McuMirror/CERES/Administratif/GPC New 2[1].docx

MDI

Systems GPC NEW 15/09/13

Fonctions complémentaires à celles de la GPC200

- Paramétrage cartes machines: modalitées à préciser.
- Historique utilisation machines:

. N° /date / heure /mn

. Paiement: billets / pièces avec valeurs et pièces rendues

. Durée stockage : 31 jours ou nombre d’opérations

. voir sortie sur clé USB

- Monnayeur MDB :

. Paramétrage nombre de tubes max 7/8

. paramétrage de la valeur du tube

. réglage niveaux Haut / Bas de chaque tube

. voir alarme si niveaux tubes trop bas

- Lecteur de billets : Gogès, Smiley ou autre en MDB

. voir possibilité de limiter son utilisation : pour simplifier, autorisé ou non suivant machine, par l’exploitant. Au départ toute machine accepte par défaut de précision.

- Lecteur de cartes bancaires. Voir avec Symotronic Ingénico par exemple

. utilisation à réfléchir, peut être comme billets,

- Promotion : voir possibilité de 2 plages par jour affectables par machine Jour/Heure/ mn.
- Cartes privatives : badges de proximité voir avec Symotronic pour ne pas faire double développement avec le matériel existant.
- Langues : prévoir 3 langues simultanées avec choix de la langue désirée par le client
- Possibilité de paiement gratuit par l’exploitant : code, carte…
- Liaison Internet :

. pour l’exploitant, clavier virtuel et affichage identique à la centrale, voir quelques petits plus.

. réception des alarmes évoquée : tubes..

. possibilité de mettre Hors Service une machine.

. possibilité de rendre gratuite une machine pour régler un problème éventuel sur site d’un client.

Ensemble des fonctions existantes dans la notice GPC200 toujours vraies : stockage, cumuls...

Comment prévoit-on sans carte : l’entrée en paramétrage, la lecture des différents cumuls..

Peut être pour ne pas avoir un paramétrage de base trop difficile envisager des niveaux : le basic durée, prix…. Et ensuite CB, Promo…
