McuMirror/CERES/Docs/latex/union____attribute____.tex

\hypertarget{union____attribute____}{}\section{\+\_\+\+\_\+attribute\+\_\+\+\_\+ Union Reference}
\label{union____attribute____}\index{\+\_\+\+\_\+attribute\+\_\+\+\_\+@{\+\_\+\+\_\+attribute\+\_\+\+\_\+}}
\subsection*{Public Member Functions}
\begin{DoxyCompactItemize}
\item 
struct \hyperlink{union____attribute_____a8f8d4ac67446d3661ab1327f89a92c94}{\+\_\+\+\_\+attribute\+\_\+\+\_\+} ((packed))
\end{DoxyCompactItemize}
\subsection*{Public Attributes}
\begin{DoxyCompactItemize}
\item 
\hypertarget{union____attribute_____a7d1a9d5019bf07a82e967a72a4434870}{}B\+Y\+T\+E {\bfseries by\+Buffer\+Operation} \mbox{[}32\mbox{]}\label{union____attribute_____a7d1a9d5019bf07a82e967a72a4434870}

\end{DoxyCompactItemize}

\subsection{Constructor \& Destructor Documentation}
\hypertarget{union____attribute_____a8f8d4ac67446d3661ab1327f89a92c94}{}\index{\+\_\+\+\_\+attribute\+\_\+\+\_\+@{\+\_\+\+\_\+attribute\+\_\+\+\_\+}!\+\_\+\+\_\+attribute\+\_\+\+\_\+@{\+\_\+\+\_\+attribute\+\_\+\+\_\+}}
\index{\+\_\+\+\_\+attribute\+\_\+\+\_\+@{\+\_\+\+\_\+attribute\+\_\+\+\_\+}!\+\_\+\+\_\+attribute\+\_\+\+\_\+@{\+\_\+\+\_\+attribute\+\_\+\+\_\+}}
\subsubsection[{\+\_\+\+\_\+attribute\+\_\+\+\_\+}]{\setlength{\rightskip}{0pt plus 5cm}struct \+\_\+\+\_\+attribute\+\_\+\+\_\+\+::\+\_\+\+\_\+attribute\+\_\+\+\_\+ (
\begin{DoxyParamCaption}
\item[{(packed)}]{}
\end{DoxyParamCaption}
)\hspace{0.3cm}{\ttfamily [inline]}}\label{union____attribute_____a8f8d4ac67446d3661ab1327f89a92c94}
$<$ Date de l\textquotesingle{}opération.

$<$ Heure de l\textquotesingle{}opération.

$<$ Montant de l\textquotesingle{}opération.

$<$ Type d\textquotesingle{}opération effectuée.

$<$ Résultat de l\textquotesingle{}opération.

$<$ Numéro de la machine le cas échéant.

$<$ Numéro de clé le cas échéant. 

The documentation for this union was generated from the following file\+:\begin{DoxyCompactItemize}
\item 
D\+:/\+Projets/\+C\+E\+R\+E\+S/\+S\+W/\+Main\+Board.\+X/parametres.\+h\end{DoxyCompactItemize}
