McuMirror/CERES/Docs/latex/union_a_u_d_i_t_d_a_t_a.tex

\hypertarget{union_a_u_d_i_t_d_a_t_a}{}\section{A\+U\+D\+I\+T\+D\+A\+T\+A Union Reference}
\label{union_a_u_d_i_t_d_a_t_a}\index{A\+U\+D\+I\+T\+D\+A\+T\+A@{A\+U\+D\+I\+T\+D\+A\+T\+A}}
\subsection*{Public Attributes}
\begin{DoxyCompactItemize}
\item 
\hypertarget{union_a_u_d_i_t_d_a_t_a_ab5ab25661d435cecd5e3a6e7414f93d1}{}s\+A\+U\+D\+I\+T\+D\+A\+T\+A {\bfseries data}\label{union_a_u_d_i_t_d_a_t_a_ab5ab25661d435cecd5e3a6e7414f93d1}

\item 
\hypertarget{union_a_u_d_i_t_d_a_t_a_a126a5fb5ddaa78b34c80a7d303919d82}{}B\+Y\+T\+E {\bfseries by\+Audit\+Data} \mbox{[}256\mbox{]}\label{union_a_u_d_i_t_d_a_t_a_a126a5fb5ddaa78b34c80a7d303919d82}

\end{DoxyCompactItemize}

The documentation for this union was generated from the following file\+:\begin{DoxyCompactItemize}
\item 
D\+:/\+Projets/\+C\+E\+R\+E\+S/\+S\+W/\+Main\+Board.\+X/parametres.\+h\end{DoxyCompactItemize}
