McuMirror/CERES/Docs/latex/union_s_m_a_c_h_i_n_e___c_o_n_f_i_g.tex

\hypertarget{union_s_m_a_c_h_i_n_e___c_o_n_f_i_g}{}\section{S\+M\+A\+C\+H\+I\+N\+E\+\_\+\+C\+O\+N\+F\+I\+G Union Reference}
\label{union_s_m_a_c_h_i_n_e___c_o_n_f_i_g}\index{S\+M\+A\+C\+H\+I\+N\+E\+\_\+\+C\+O\+N\+F\+I\+G@{S\+M\+A\+C\+H\+I\+N\+E\+\_\+\+C\+O\+N\+F\+I\+G}}

Structure contenant les paramètres à sauvegarder d\textquotesingle{}une machine.  

{\ttfamily \#include $<$parametres.\+h$>$}

\subsection*{Public Member Functions}
\begin{DoxyCompactItemize}
\item 
struct \hyperlink{union_s_m_a_c_h_i_n_e___c_o_n_f_i_g_a06ac0ca171ccde05f310fd6395bec0f1}{\+\_\+\+\_\+attribute\+\_\+\+\_\+} ((packed))
\end{DoxyCompactItemize}
\subsection*{Public Attributes}
\begin{DoxyCompactItemize}
\item 
\hypertarget{union_s_m_a_c_h_i_n_e___c_o_n_f_i_g_afcd3ebaa7aa3bf1a27064988e553c16c}{}B\+Y\+T\+E {\bfseries s\+Machine\+\_\+config\+\_\+buffer} \mbox{[}64\mbox{]}\label{union_s_m_a_c_h_i_n_e___c_o_n_f_i_g_afcd3ebaa7aa3bf1a27064988e553c16c}

\end{DoxyCompactItemize}

\subsection{Detailed Description}
Structure contenant les paramètres à sauvegarder d\textquotesingle{}une machine. 

\subsection{Member Function Documentation}
\hypertarget{union_s_m_a_c_h_i_n_e___c_o_n_f_i_g_a06ac0ca171ccde05f310fd6395bec0f1}{}\index{S\+M\+A\+C\+H\+I\+N\+E\+\_\+\+C\+O\+N\+F\+I\+G@{S\+M\+A\+C\+H\+I\+N\+E\+\_\+\+C\+O\+N\+F\+I\+G}!\+\_\+\+\_\+attribute\+\_\+\+\_\+@{\+\_\+\+\_\+attribute\+\_\+\+\_\+}}
\index{\+\_\+\+\_\+attribute\+\_\+\+\_\+@{\+\_\+\+\_\+attribute\+\_\+\+\_\+}!S\+M\+A\+C\+H\+I\+N\+E\+\_\+\+C\+O\+N\+F\+I\+G@{S\+M\+A\+C\+H\+I\+N\+E\+\_\+\+C\+O\+N\+F\+I\+G}}
\subsubsection[{\+\_\+\+\_\+attribute\+\_\+\+\_\+}]{\setlength{\rightskip}{0pt plus 5cm}struct S\+M\+A\+C\+H\+I\+N\+E\+\_\+\+C\+O\+N\+F\+I\+G\+::\+\_\+\+\_\+attribute\+\_\+\+\_\+ (
\begin{DoxyParamCaption}
\item[{(packed)}]{}
\end{DoxyParamCaption}
)\hspace{0.3cm}{\ttfamily [inline]}}\label{union_s_m_a_c_h_i_n_e___c_o_n_f_i_g_a06ac0ca171ccde05f310fd6395bec0f1}
$<$ Adresse du satellite qui correspond aussi au numéro de la machine pilotée par ce satellite.

$<$ Prix du service en espèce.

$<$ Prix du service payé avec le système cashless.

$<$ Prix du service en heures creuses.

$<$ prix du service payé avec le système cashless en heure creuse.

$<$ Durée de l\textquotesingle{}impulsion pour activé la machine en ms.

$<$ Durée de la suroccupation en ms.

Temps à afficher pour le client sans décompte.

$<$ Heure de début de sélection autorisé.

$<$ Heure de fin de sélection autorisé.

$<$ Heure de début de l\textquotesingle{}Happy Hour.

$<$ Heure de fin de l\textquotesingle{}Happy Hour.

$<$ Autorise ou non le cumul du temps d\textquotesingle{}activation

Affiche le temps restant. 

The documentation for this union was generated from the following file\+:\begin{DoxyCompactItemize}
\item 
D\+:/\+Projets/\+C\+E\+R\+E\+S/\+S\+W/\+Main\+Board.\+X/parametres.\+h\end{DoxyCompactItemize}
