McuMirror/CERES/Docs/latex/union_u_o_p_e_r_a_t_i_o_n.tex

\hypertarget{union_u_o_p_e_r_a_t_i_o_n}{}\section{U\+O\+P\+E\+R\+A\+T\+I\+O\+N Union Reference}
\label{union_u_o_p_e_r_a_t_i_o_n}\index{U\+O\+P\+E\+R\+A\+T\+I\+O\+N@{U\+O\+P\+E\+R\+A\+T\+I\+O\+N}}

Structure contenant le détail d\textquotesingle{}une opération.  

{\ttfamily \#include $<$parametres.\+h$>$}

\subsection{Detailed Description}
Structure contenant le détail d\textquotesingle{}une opération. 

The documentation for this union was generated from the following file\+:\begin{DoxyCompactItemize}
\item 
D\+:/\+Projets/\+C\+E\+R\+E\+S/\+S\+W/\+Main\+Board.\+X/parametres.\+h\end{DoxyCompactItemize}
