McuMirror/CERES/HW/IO_Board/brochage.png

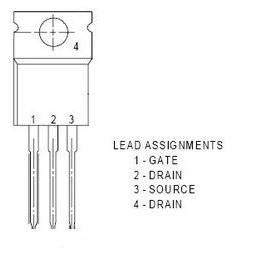
HW/IO_Board/brochage.png
