McuMirror/CERES/HW/IO_Board/V6/ProjectOutputs/IO BOARD CERES V6.xls

Sheet: BOM Report
 |  |  |  |  |  | 51
Bill of Materials |  |  | Bill of Materials For PCB Document [IO BOARD CERES V6.PcbDoc]
Source Data From: |  | IO BOARD CERES V6.PcbDoc
Project: |  | IO BOARD CERES-V6.PrjPcb
Variant: |  | None
Creation Date: | 07/06/2018 | 11:33:46
Print Date: | 2018-06-07 | 13:43:59
Footprint | Comment | LibRef | Designator | Description | Quantity | PA unitaire | Nombre | Total pièce | A commander | Fournisseur | Code fournisseur
C1210 | 150nF | Cap | C1 | Capacitor | 1 | 0.4450 € | 51 | 22.70 € | Y | TME | C1210V154KCRACTU
C0805 | 10uF | Cap 0805 1uF | C2 | Capacitor | 1 | 0.0715 € | 51 | 3.65 € | N
C0805 | 100nF | Cap 0805 100nF | C4, C5, C8, C9 | Capacitor | 4 | 0.0013 € | 204 | 0.27 € | N
KEMET_4 | 10uF | Cap Pol 10uF | C6 | Polarized Capacitor | 1 | 0.0431 € | 51 | 2.20 € | N
KEMET_63 | 100uF | Cap Pol 100uF | C7 | Polarized Capacitor | 1 | 0.0232 € | 51 | 1.18 € | N
C0805 | 1nF | Cap 0805 1nF | C10 | Capacitor | 1 | 0.0040 € | 51 | 0.20 € | N
SMA | BZG03C12 | DZ | D1 |  | 1 | 0.1135 € | 51 | 5.79 € | N
SOT23 | BAT54S | BAT54S | D2, D6, D11 | Schottky Barrier Double Diode | 3 | 0.0128 € | 153 | 1.96 € | N
0603-LEDR | HSMH-C190 | HSMH-C190 | D5, D7, D9, D10 | Surface Mount Chip LED, Red | 4 | 0.0406 € | 204 | 8.28 €
0603-LEDV | HSMG-C190 | HSMG-C190 | D8 | Surface Mount Chip GREEN | 1 | 0.0308 € | 51 | 1.57 €
RELAIG5L | RELAY NAISJS | RELAY NAISJS | K1, K2 | Relais | 2 | 1.4700 € | 102 | 149.94 €
CO7P508-90 | Header 7 | Header 7 | P1 | Header, 7-Pin | 1 | 0.1713 € | 51 | 8.74 € | Y | TME | NTBG-5-KW-7P-G
CO8P508 - 90° | Header 8 | Header 8 | P2 | Header, 8-Pin | 1 | 0.1893 € | 51 | 9.65 € | Y | TME | TBG-5-KW-8P-GN
M20_1X2 | CLR | Header 2 | P5 | Header, 2-Pin | 1 | 0.0645 € | 51 | 3.29 € | Y | FARNELL | 1895211
M20_1X2 | EIA-485 TERMINAISON | Header 2 | P8 | Header, 2-Pin | 1 | 0.0645 € | 51 | 3.29 € | Y | FARNELL | 1895211
RJ45_8-5406721-1 | RJ45 | Header 8 | P10, P11 | Header, 8-Pin | 2 | 0.7700 € | 102 | 78.54 € | Y | TME | 540672-1
SOT23 | 2N7002 | 2N7002 | Q1, Q2 | N-channel Enhancement Mode Field-effect Transistor | 2 | 0.0604 € | 102 | 6.16 € | N
1206 - 2010 | 1.5K 1/2W | Resistor 0805 470 | R1 | Resistor | 1 | 0.0400 € | 51 | 2.04 € | y | TME | HP06-1K55%
R0805 | 1K | Res2, Resistor 0805 1K | R2, R7, R18, R22, R23 | Resistor | 5 | 0.0010 € | 255 | 0.26 €
R0805 | 56K | Resistor 0805 56K | R3, R5, R8, R9, R10, R11, R21 | Resistor | 7 | 0.0100 € | 357 | 3.57 €
R0805 | 220 | Resistor 0805 220 | R12, R13 | Resistor | 2 | 0.0100 € | 102 | 1.02 €
R0805 | 270 | Resistor 0805 1K | R14 | Resistor | 1 | 0.0100 € | 51 | 0.51 €
R0805 | 1M | Resistor 0805 1M | R15, R19 | Resistor | 2 | 0.0100 € | 102 | 1.02 €
R0805 | 56 | Resistor 0805 56 | R16, R17 | Resistor | 2 | 0.0100 € | 102 | 1.02 €
R0805 | 120 | Resistor 0805 120 | R20 | Resistor | 1 | 0.0100 € | 51 | 0.51 €
R1206 | 1M | Resistor 0805 470 | R24 | Resistor | 1 | 0.0400 € | 51 | 2.04 € | Y | TME | HP06-1M5% (https://www.tme.eu/fr/details/hp06-1m5%25/resistances-smd-1206/royal-ohm/hp06w2j0105t5e/)
OPTO-4PIN | HCPL-181 | Optoisolator1 | U1 | 4-Pin Phototransistor Optocoupler | 1 | 0.3000 € | 51 | 15.30 € | Y | TME | HCPL-181-00DE
SOIC8 | ACS712 | ACS712 | U2 | HALL EFFECT CURRENT SENSOR | 1 | 2.7200 € | 51 | 138.72 € | Y | TME | ACS712ELCTR-05B
SO-14 | PIC16F1824 | PIC16(L)F1824 | U3 | 14 Pin Flash Microcontrollers with XLP Technology | 1 | 1.1500 € | 51 | 58.65 € | Y | TME | PIC16F1824-I/SL
SOT223 | LM1117DT-5.0 | LM1117DT-5.0 | U4 | 800mA Low-Dropout Linear Regulator, 3-pin TO-252 | 1 | 0.7800 € | 51 | 39.78 € | Y | TME | LM1117MP-5,0/NOPB
SOIC8 | ADM4851ARZ | MAX485ESA | U5 | Low-Power, Slew-Rate-Limited RS-485/RS-422 Transceiver | 1 | 1.8200 € | 51 | 92.82 € | Y | TME | adm485
PCB |  |  |  |  | 1 | 4.0000 € | 51 | 204.00 €
MO IDEE |  |  |  |  | 1 | 20.0000 € | 51 | 1020.00 €
MO RASOFTWARE |  |  |  |  | 1 | 10.0000 € | 51 | 510.00 €
 |  |  |  |  | 58 |  |  | 2398.66 €
Approved |  | Notes |  |  |  |  |  | 3597.99 €
 |  |  |  |  |  |  |  | 71.96 €

Sheet: Project Information
Project Full Path | D:\Projets\CERES\HW\IO_Board\V6\IO BOARD CERES-V6.PrjPcb
Project Filename | IO BOARD CERES-V6.PrjPcb
Variant Name | None
Data-Source Filename | IO BOARD CERES V6.PcbDoc
Data-Source Full Path | D:\Projets\CERES\HW\IO_Board\V6\IO BOARD CERES V6.PcbDoc
Title | Bill of Materials For PCB Document [IO BOARD CERES V6.PcbDoc]
Total Quantity | 61
Report Time | 11:33:46
Report Date | 07/06/2018
Report Date & Tine | 07/06/2018 11:33:46
Output Name | Bill of Materials
Output Type | BOM_PartType
Output Generator Name | BOM
Output Generator Description | Bill of Materials
