McuMirror/CERES/Docs/TODO.docx

Test backlight

RS485

MDB

USB

INTERNET

SPI

KEYBOARD

AFFICHEUR

Graphique
