McuMirror/CERES/HW/Main Board/MAIN BOARD CERES.pdf

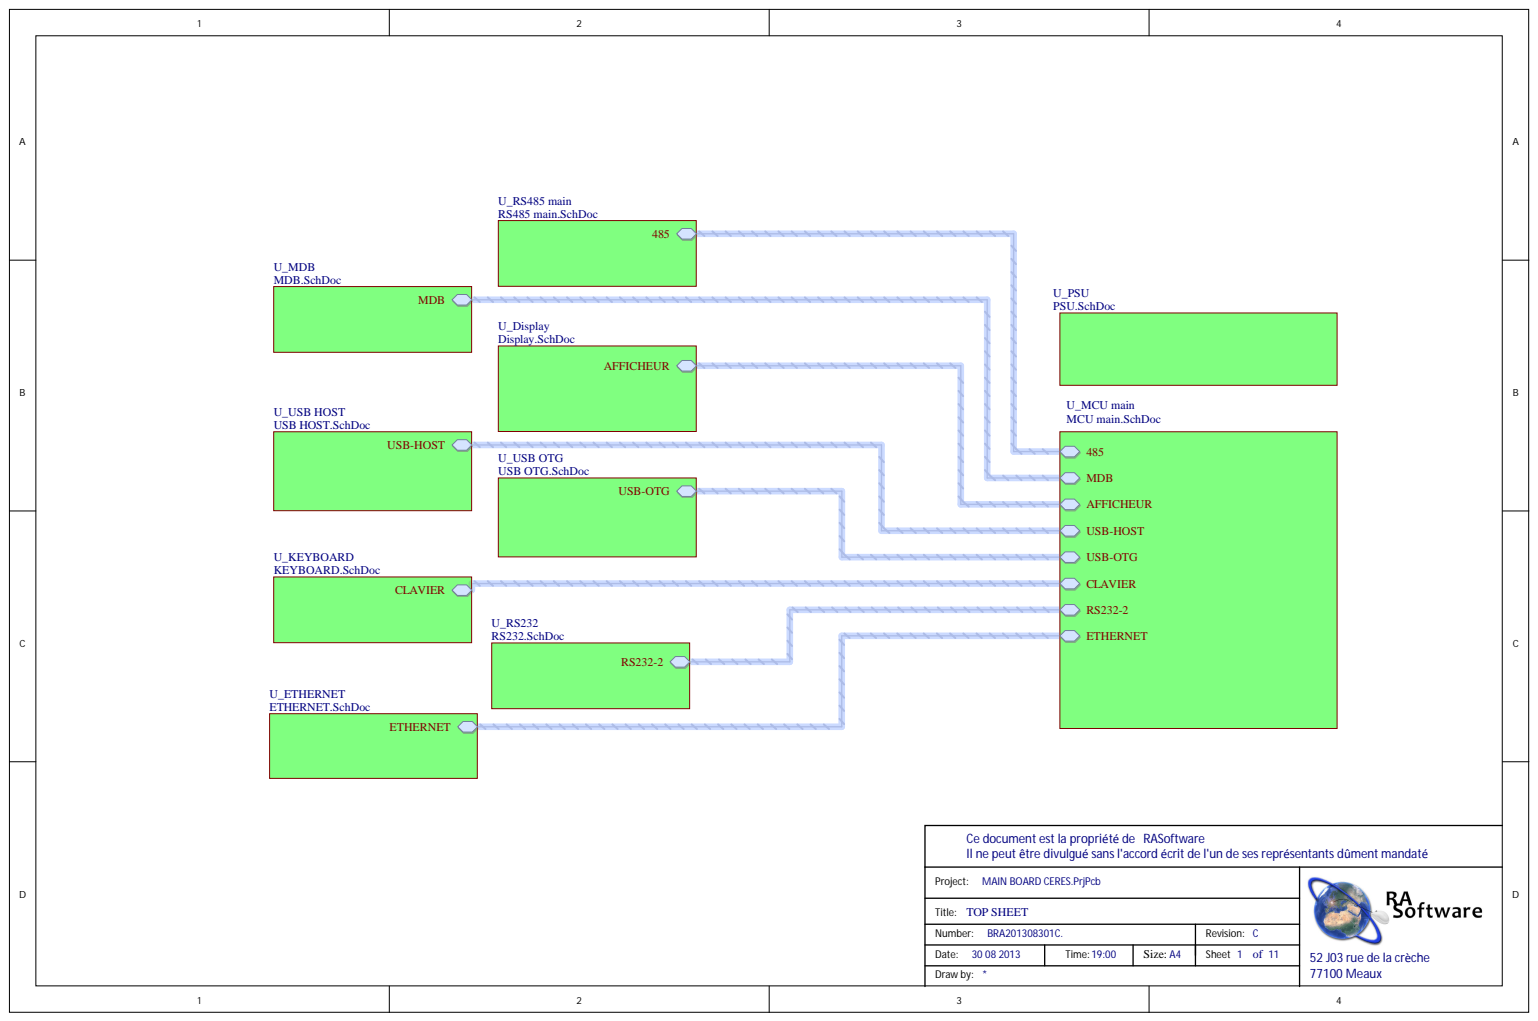
[picture p18: page 1]

Ce document est la propriété de RASoftware
Il ne peut être divulgué sans l'accord écrit de l'un de ses représentants dûment mandaté

Number: BRA201308301C. | Revision: C
Date: 30 08 2013 | Time: 19:00 | Size: A4 | Sheet 1 of 11

52 J03 rue de la crèche
77100 Meaux

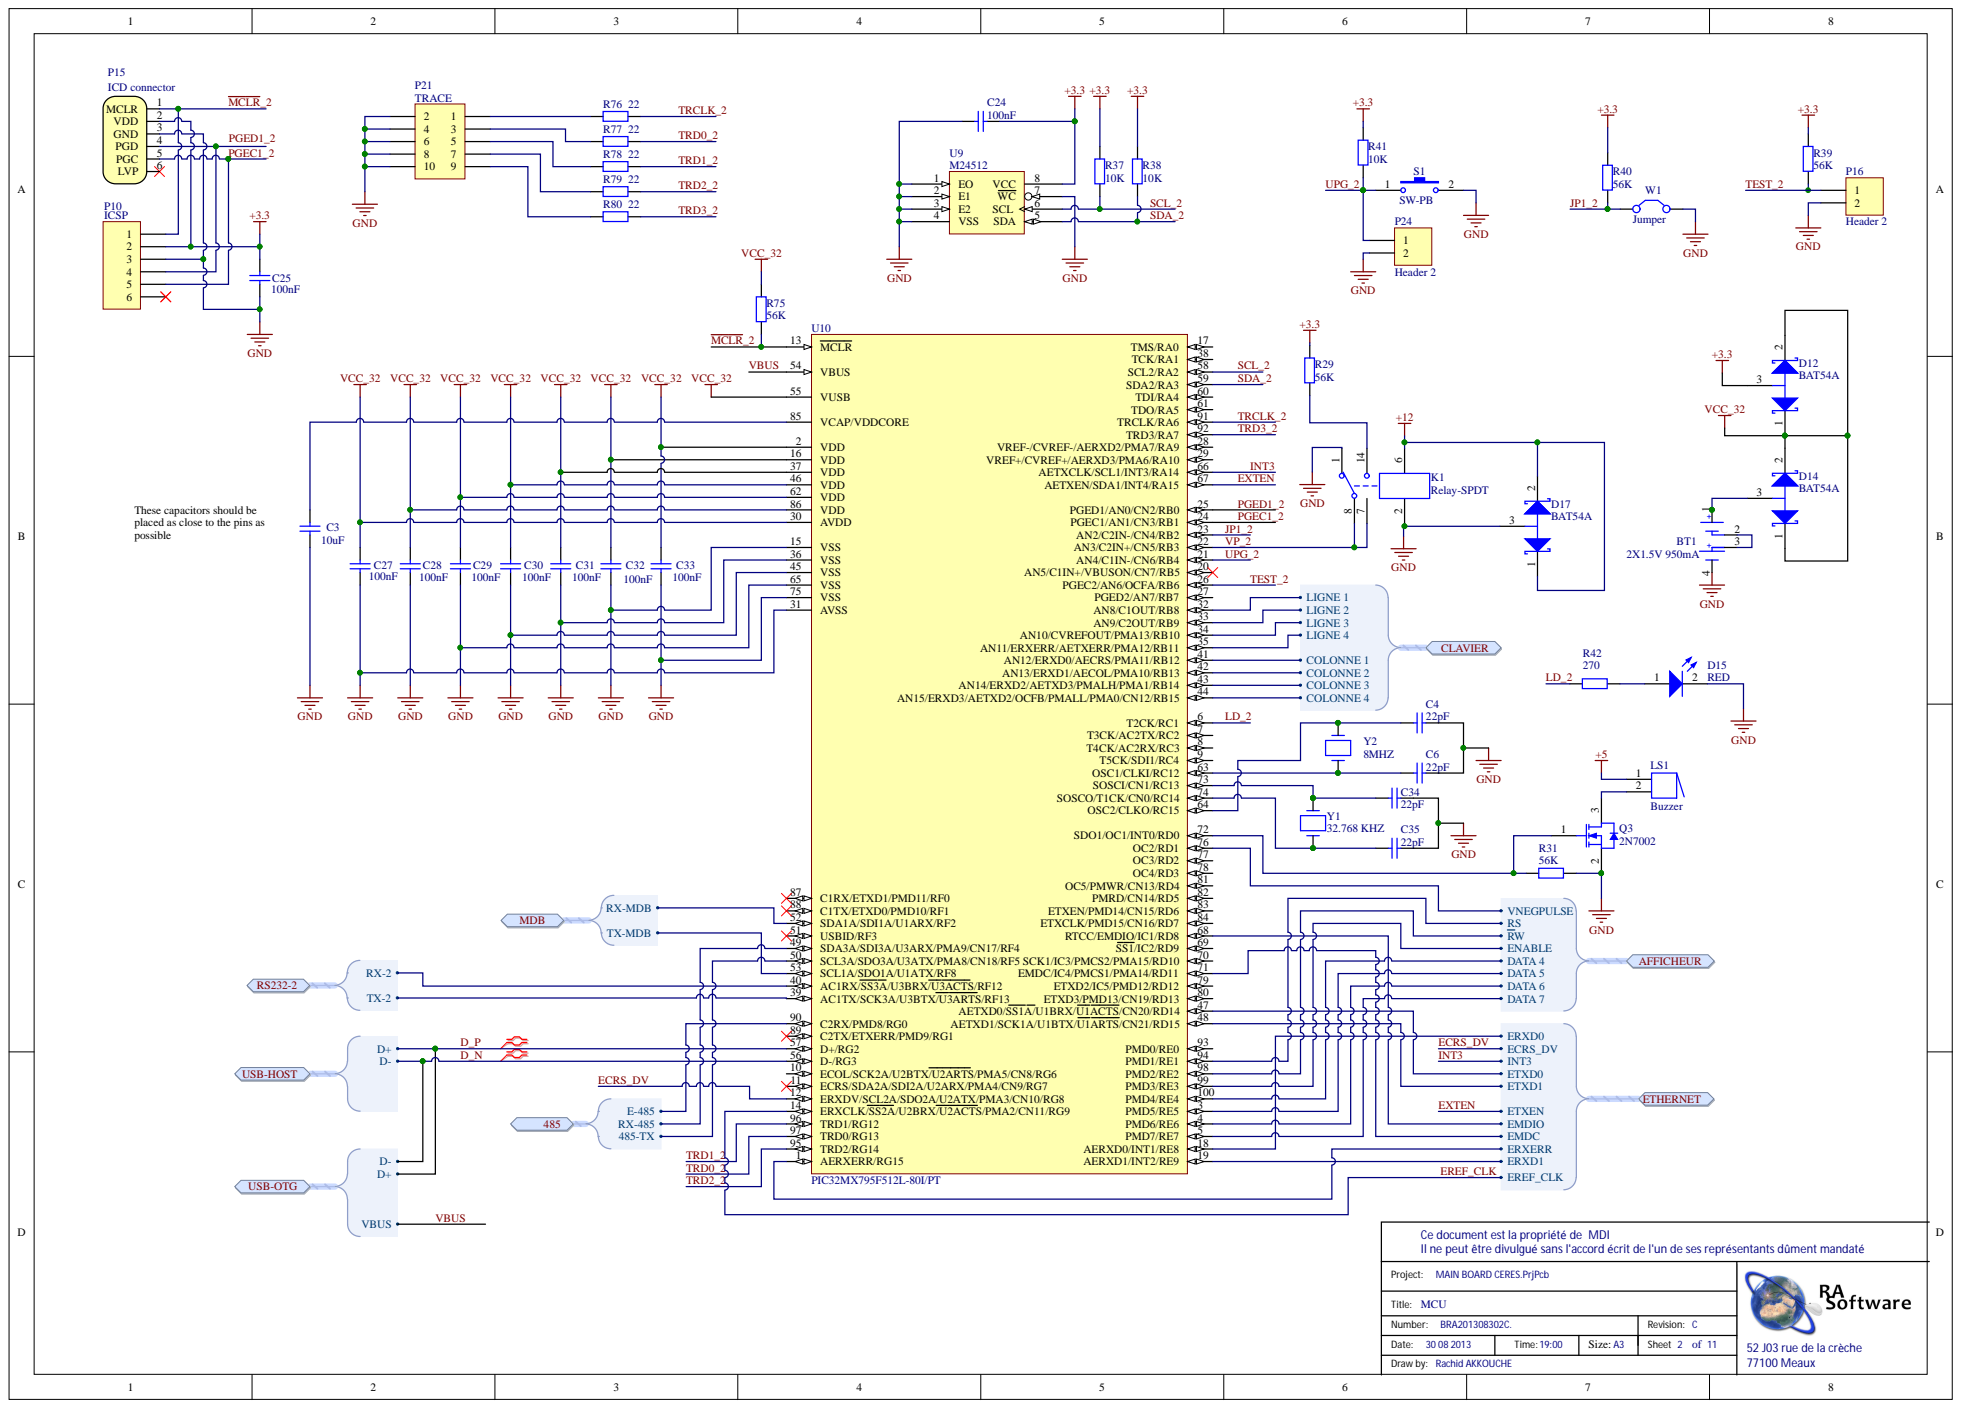
[picture p19: page 2]

VDD 37
VDD 46 | EXTEN

VDD 86 | GND

These capacitors should be
placed as close to the pins as
possible

VSS 15 | | JP1_2

VSS 36 | UPG_2 TEST_2

C33 | VSS 45
100nF | VSS 65

VSS 75
AVSS 31

USBID/RF3 51

SCL3A/SDO3A/U3ATX/PMA8/CN18/RF5 50
SCL1A/SDO1A/U1ATX/RF8 53

AC1TX/SCK3A/U3BTX/U3ARTS/RF13 39

C2TX/ETXERR/PMD9/RG1 89
D+/RG2 57 | | | | | ECRS_DV

D_N | D-/RG3 56 | | | | | INT3

ECRS_DV | | | | ECOL/SCK2A/U2BTX/U2ARTS/PMA5/CN8/RG6 10

ERXDV/SCL2A/SDO2A/U2ATX/PMA3/CN10/RG8 12 | | | | EXTEN

TRD1/RG12 96
TRD0/RG13 97
TRD2/RG14 95

TRD1_2 | AERXERR/RG15 1
TRD0_2 | | EREF_CLK
TRD2_2

Ce document est la propriété de MDI
Il ne peut être divulgué sans l'accord écrit de l'un de ses représentants dûment mandaté

Project: MAIN BOARD CERES.PrjPcb

Number: BRA201308302C. | Revision: C
Date: 30 08 2013 | Time: 19:00 | Size: A3 | Sheet 2 of 11

52 J03 rue de la crèche

Draw by: Rachid AKKOUCHE

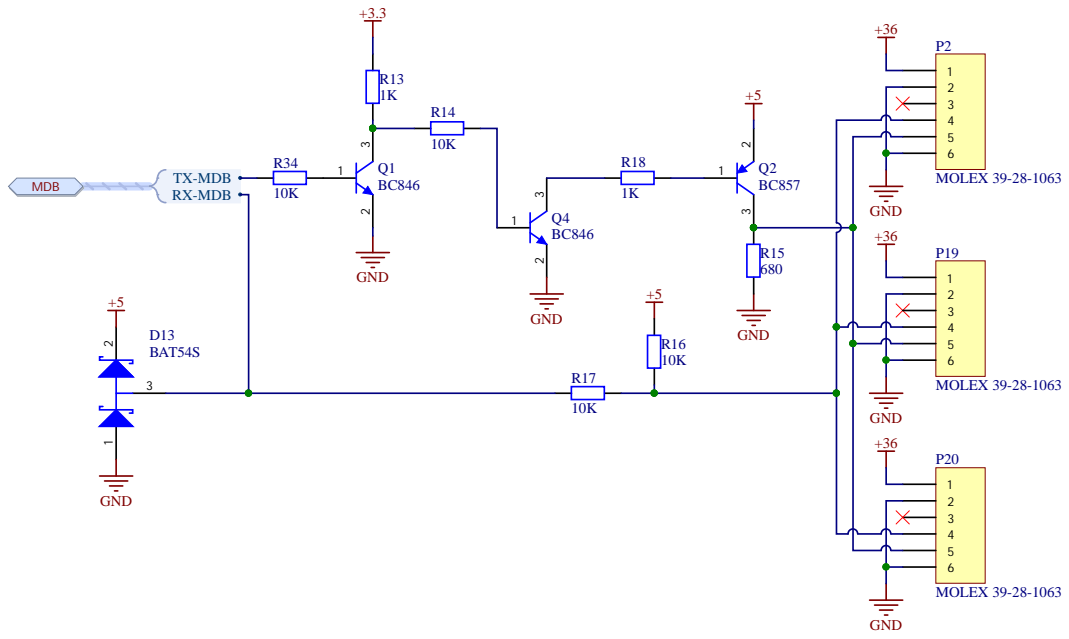
[picture p20: page 3]

Ce document est la propri
Il ne peut

écrit de l'un de ses représen

Number: BRA201308303C. | Revision: C
Date: 30 08 2013 | Time: 19:00 | Size: A4 | Sheet 3 of 11

52 J03 rue de la crèche

Draw by: Rachid AK

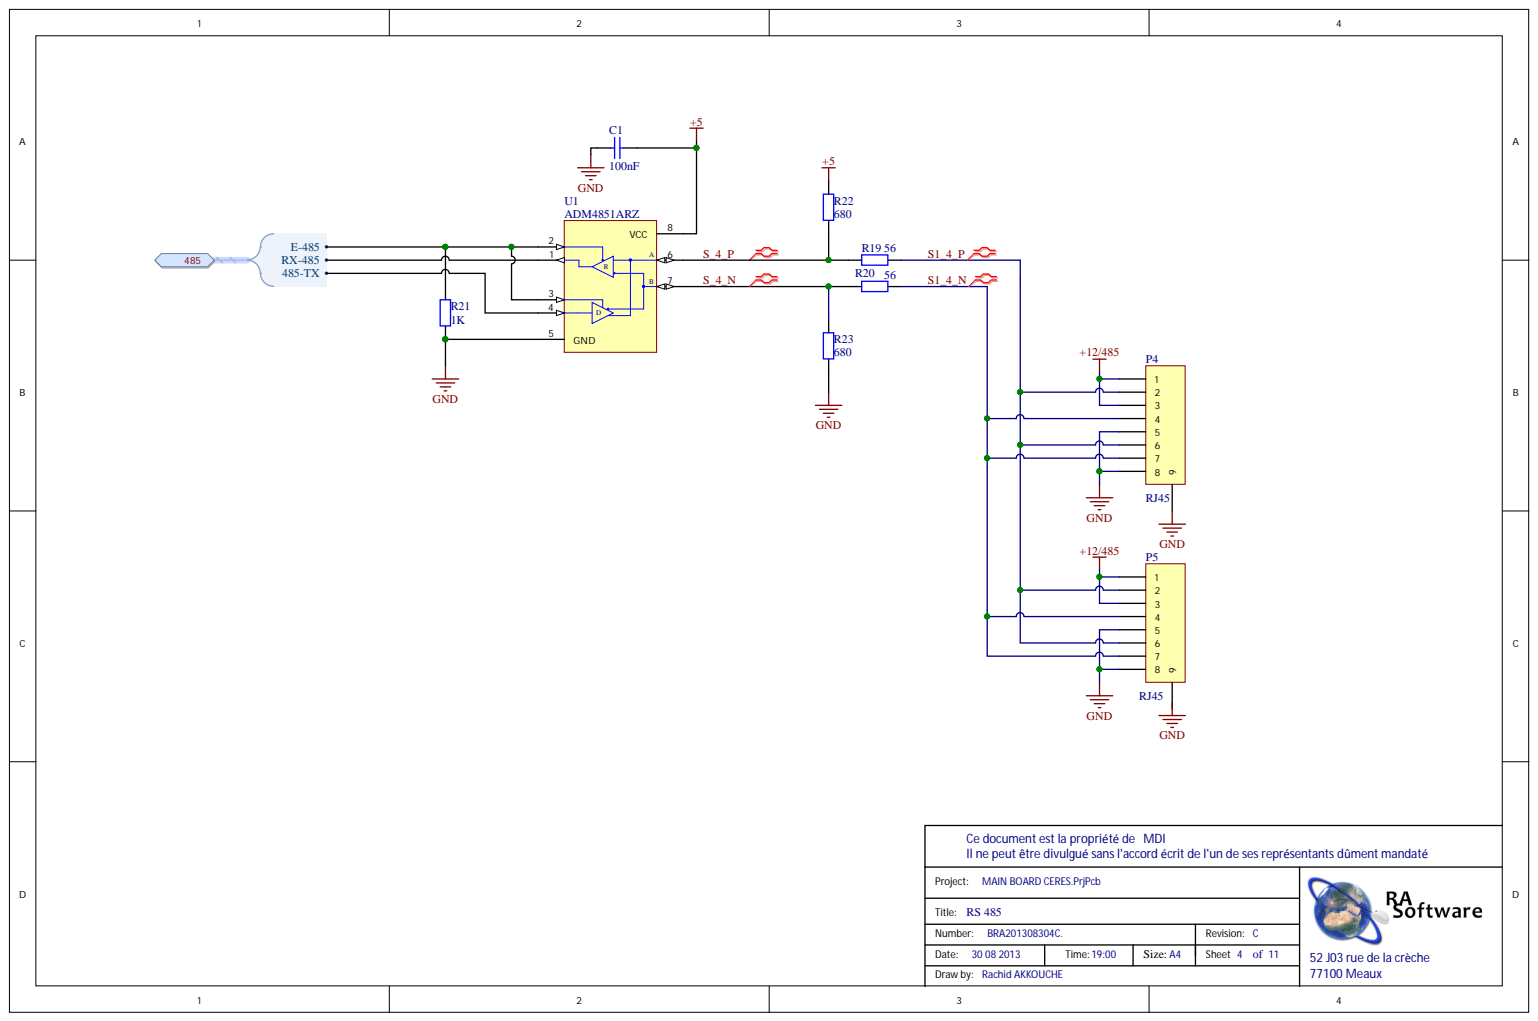
[picture p21: page 4]

Ce document est la propri
Il ne peut

écrit de l'un de ses représen

Number: BRA201308304C. | Revision: C
Date: 30 08 2013 | Time: 19:00 | Size: A4 | Sheet 4 of 11

52 J03 rue de la crèche

Draw by: Rachid AK

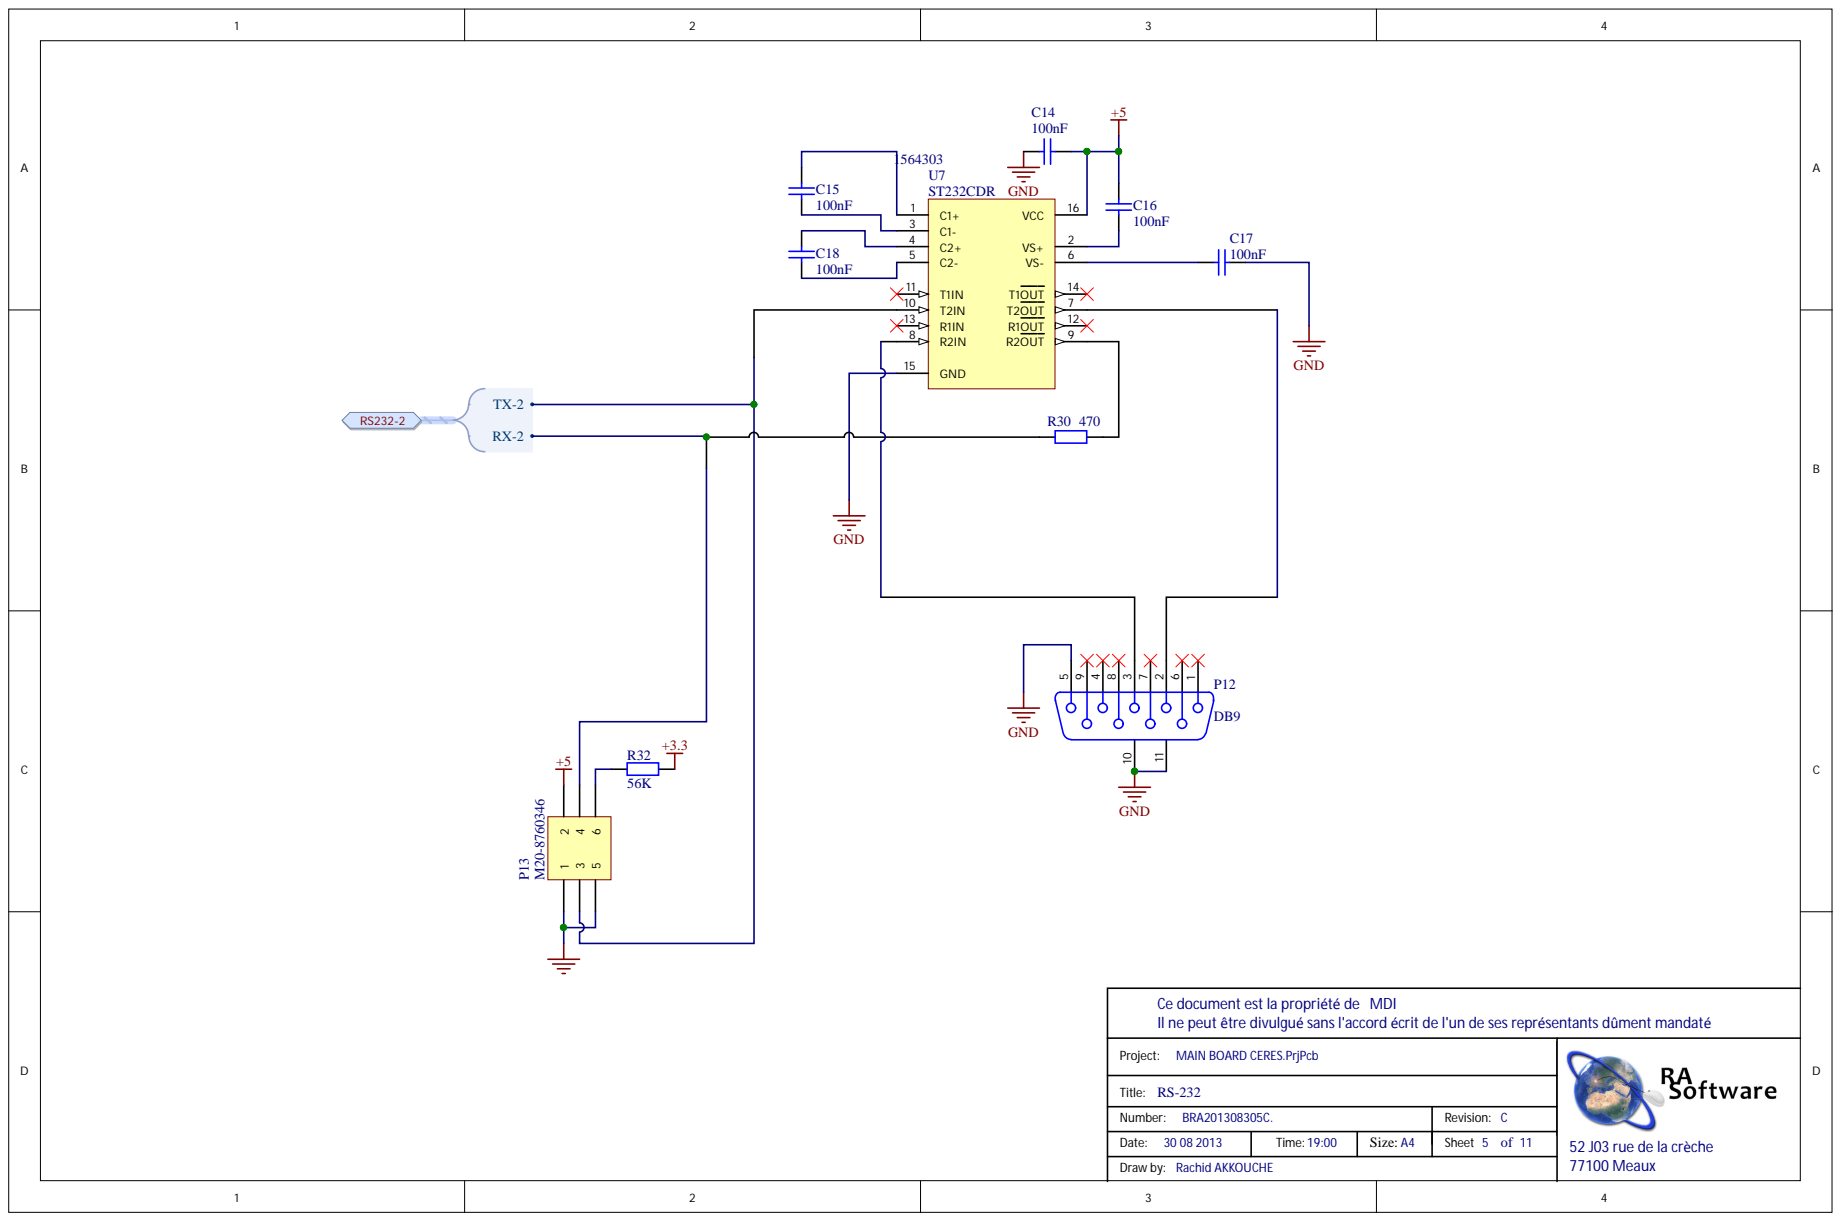
[picture p22: page 5]
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

Number: BRA201308305C. | Revision: C
Date: 30 08 2013 | Time: 19:00 | Size: A4 | Sheet 5 of 11

52 J03 rue de la crèche

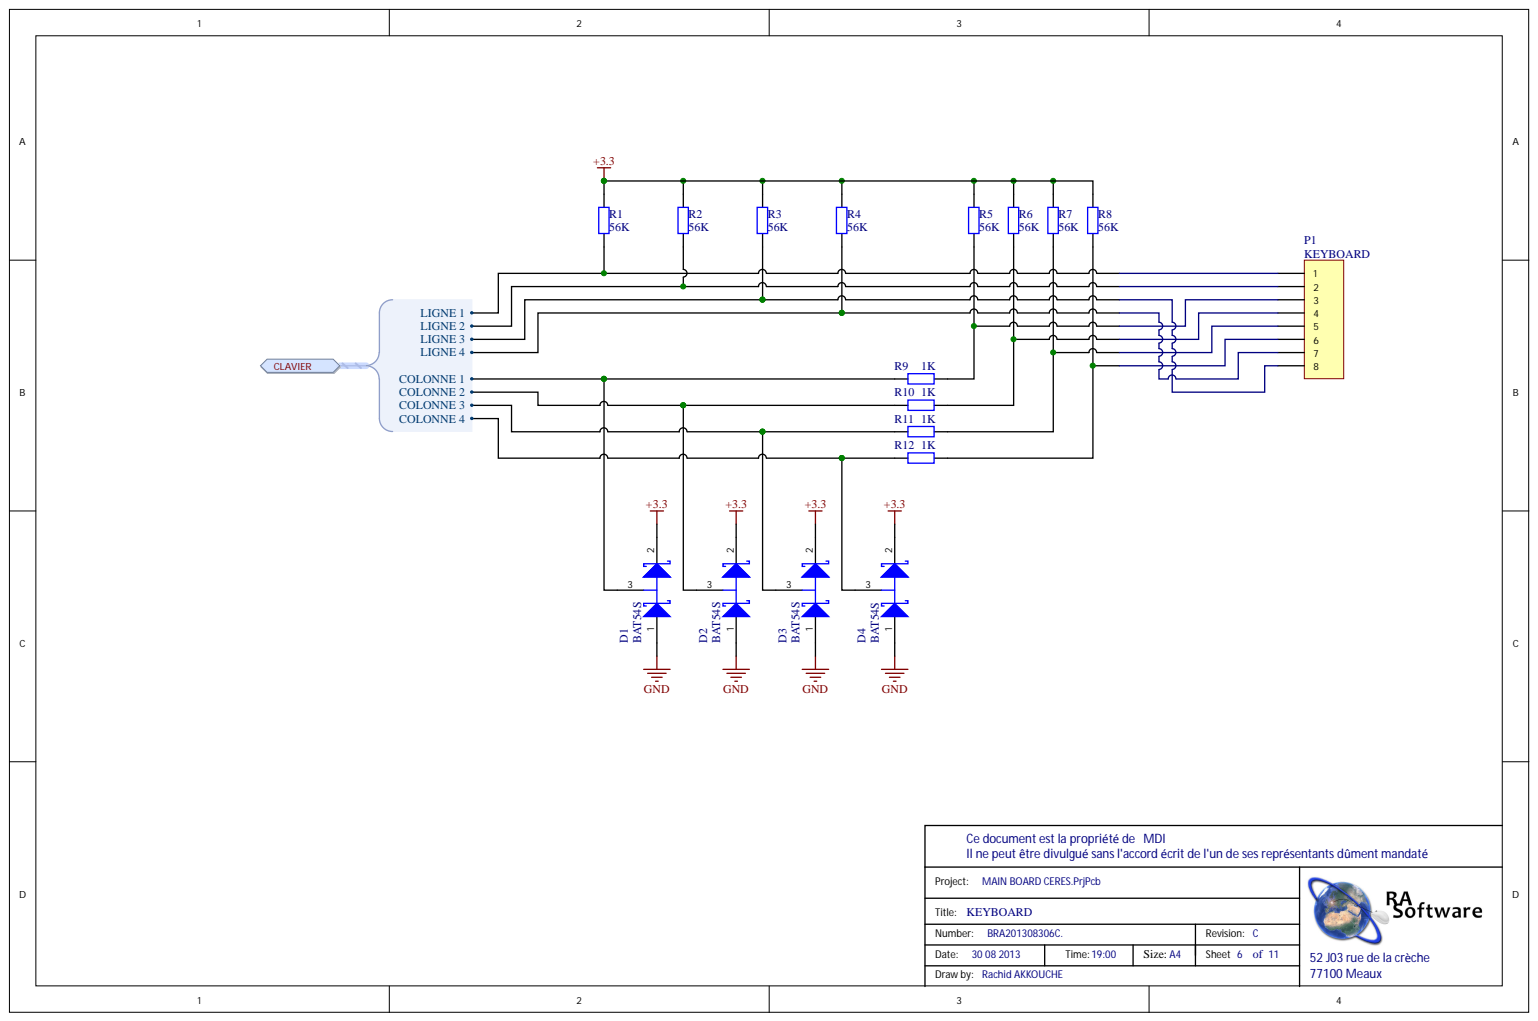
[picture p23: page 6]
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

Number: BRA201308306C. | Revision: C
Date: 30 08 2013 | Time: 19:00 | Size: A4 | Sheet 6 of 11

52 J03 rue de la crèche

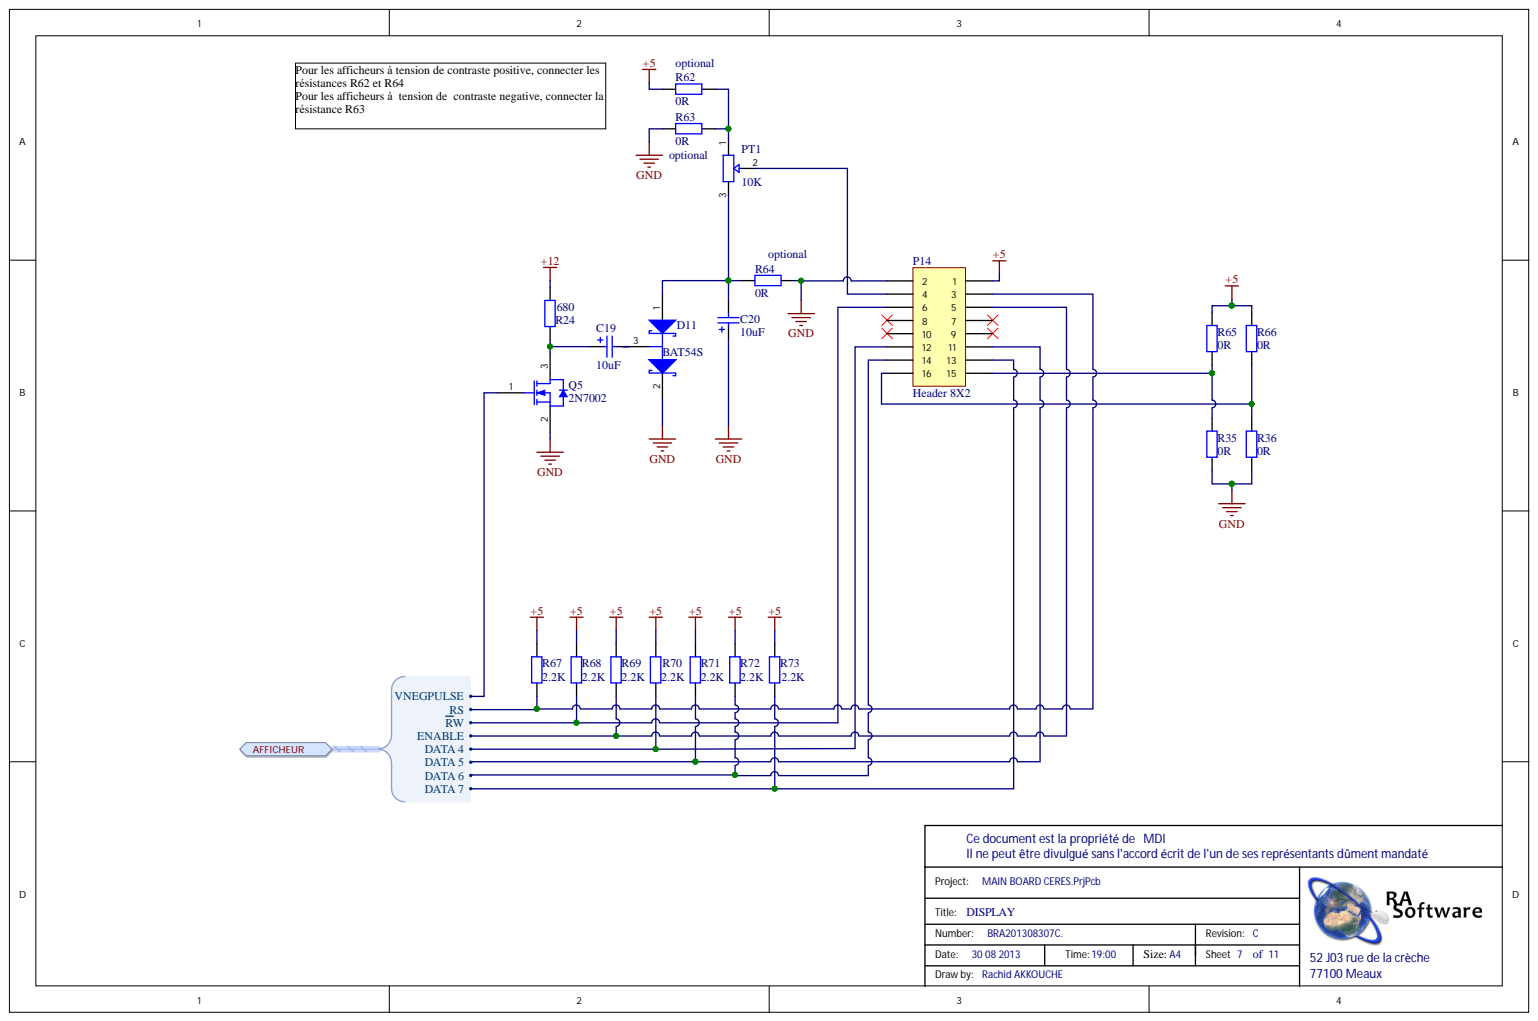
[picture p24: page 7]

Pour les afficheurs à tension de contraste positive, connecter les
résistances R62 et R64
Pour les afficheurs à tension de contraste negative, connecter la
résistance R63

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

Number: BRA201308307C. | Revision: C
Date: 30 08 2013 | Time: 19:00 | Size: A4 | Sheet 7 of 11

52 J03 rue de la crèche

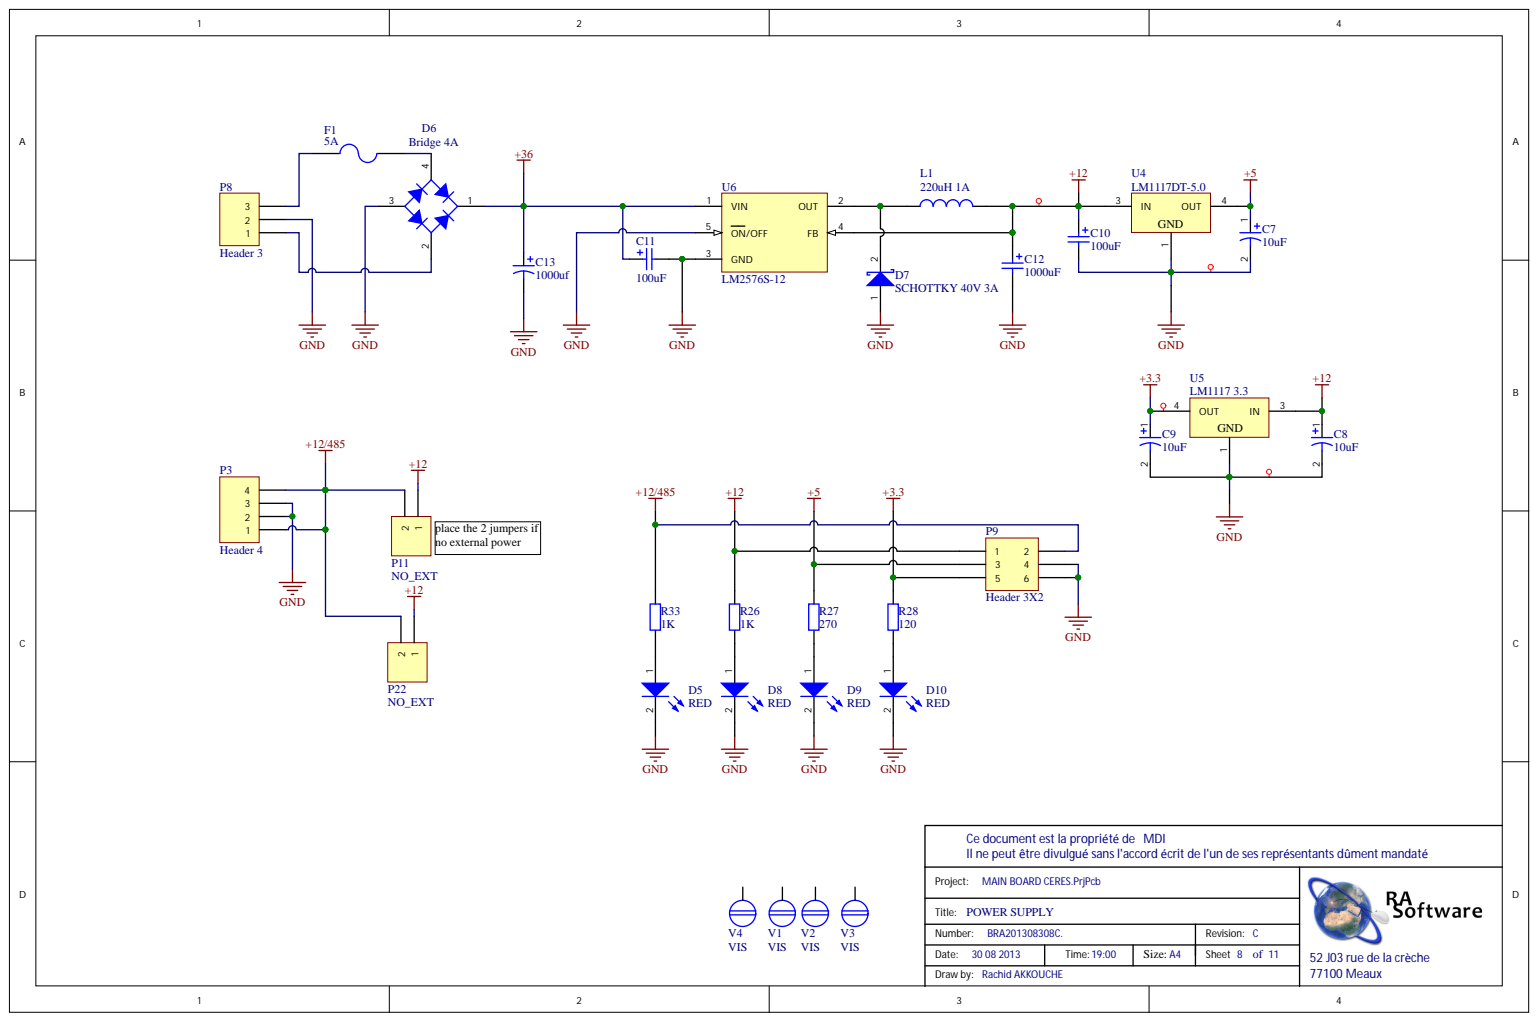
[picture p25: page 8]

place the 2 jumpers if
no external power

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

Number: BRA201308308C. | Revision: C
Date: 30 08 2013 | Time: 19:00 | Size: A4 | Sheet 8 of 11

52 J03 rue de la crèche

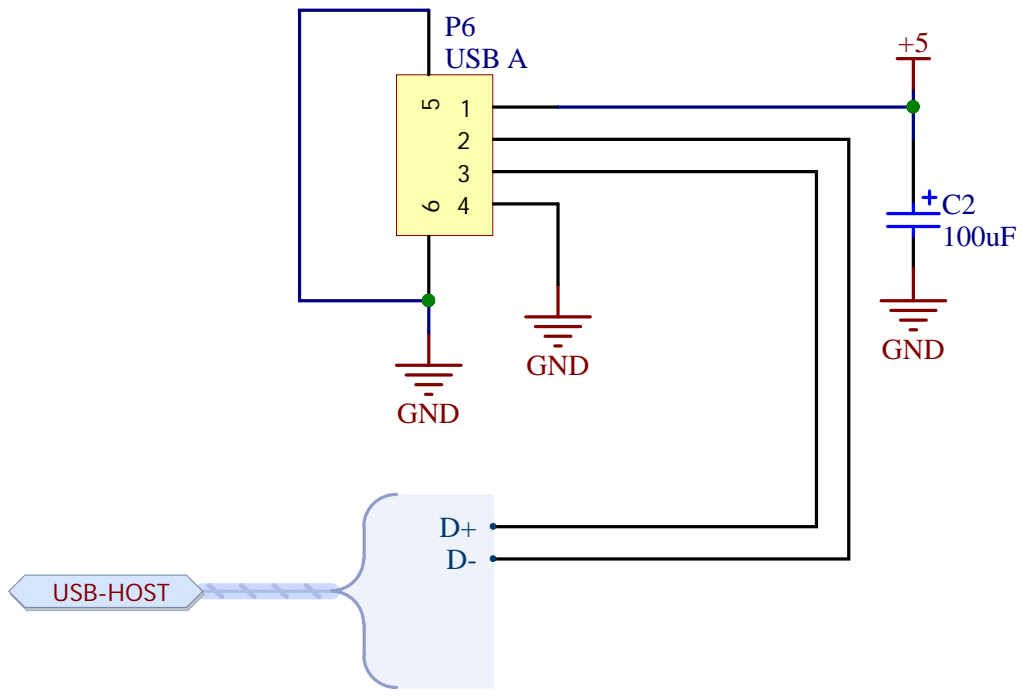
[picture p26: page 9]
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

Number: BRA201308309C. | Revision: C
Date: 30 08 2013 | Time: 19:00 | Size: A4 | Sheet 9 of 11

52 J03 rue de la crèche

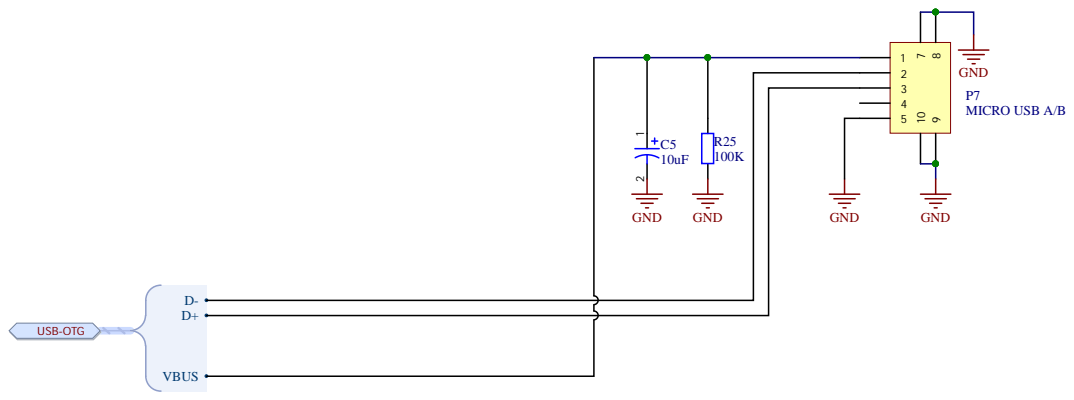
[picture p27: page 10]

Ce document est la propri
Il ne peut

écrit de l'un de ses représen

Number: BRA2013083010C. | Revision: C
Date: 30 08 2013 | Time: 19:30 | Size: A4 | Sheet 10 of 11

52 J03 rue de la crèche

Draw by: Rachid AK

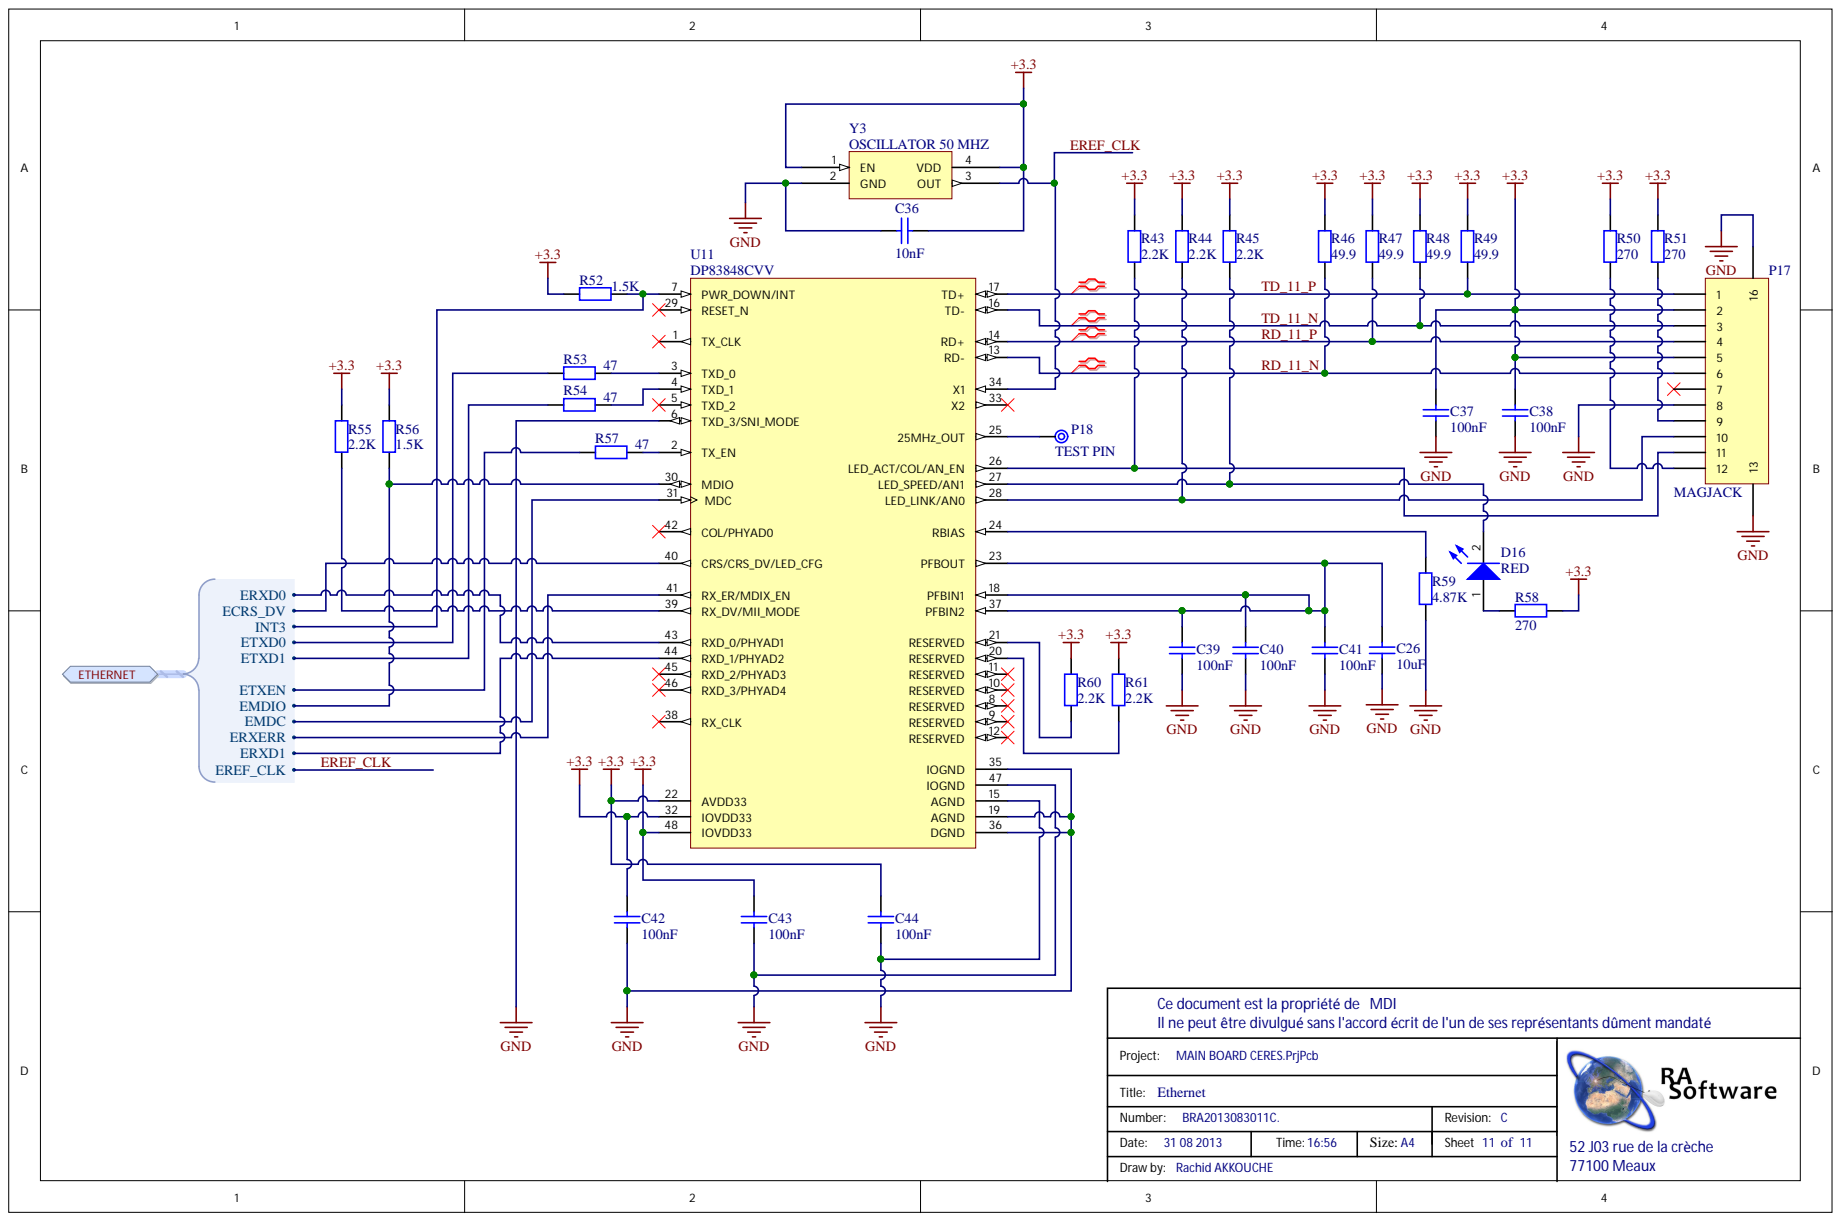
[picture p28: page 11]

TXD_0 3 | | | RD_11_N
TXD_1 4 | P18 TEST PIN
TXD_2 5
TXD_3/SNI_MODE 6

MDIO 30 MDC 31

COL/PHYAD0 42

RX_DV/MII_MODE 39 RX_ER/MDIX_EN 41

RXD_0/PHYAD1 43

IOVDD33 32

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

Number: BRA2013083011C. | Revision: C
Date: 31 08 2013 | Time: 16:56 | Size: A4 | Sheet 11 of 11

52 J03 rue de la crèche

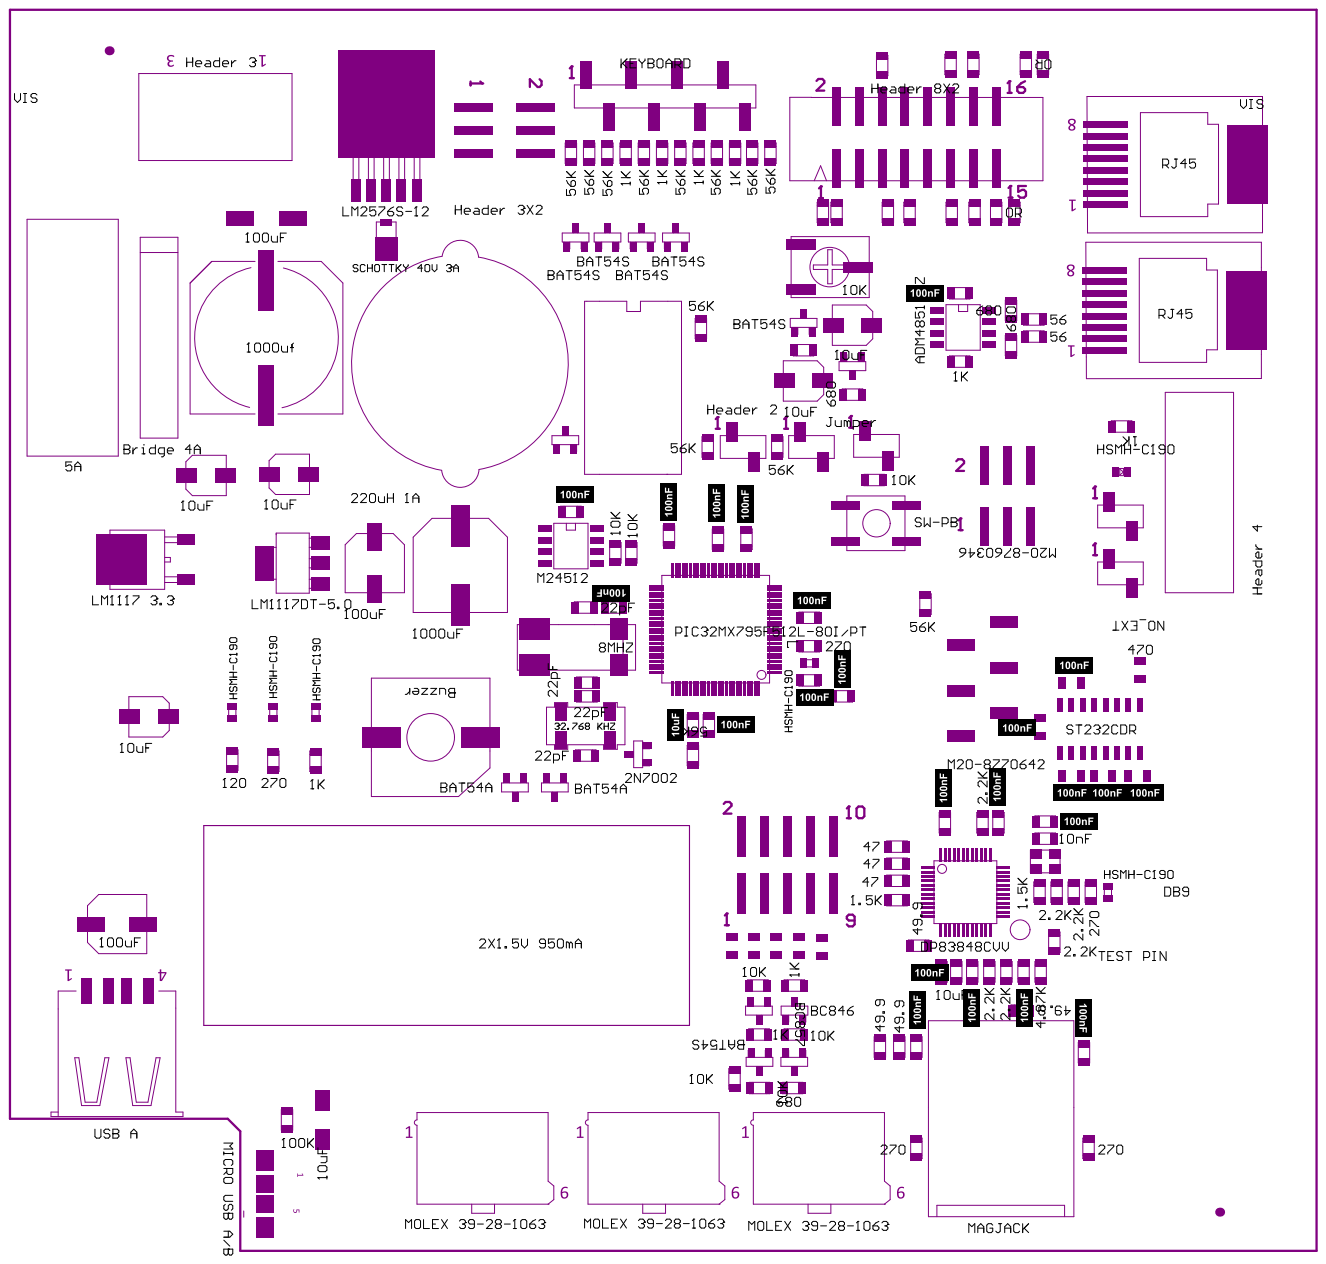
[picture p29: page 12]
