McuMirror/CERES/HW_V1b/Main Board/MAIN BOARD CERES.PDF

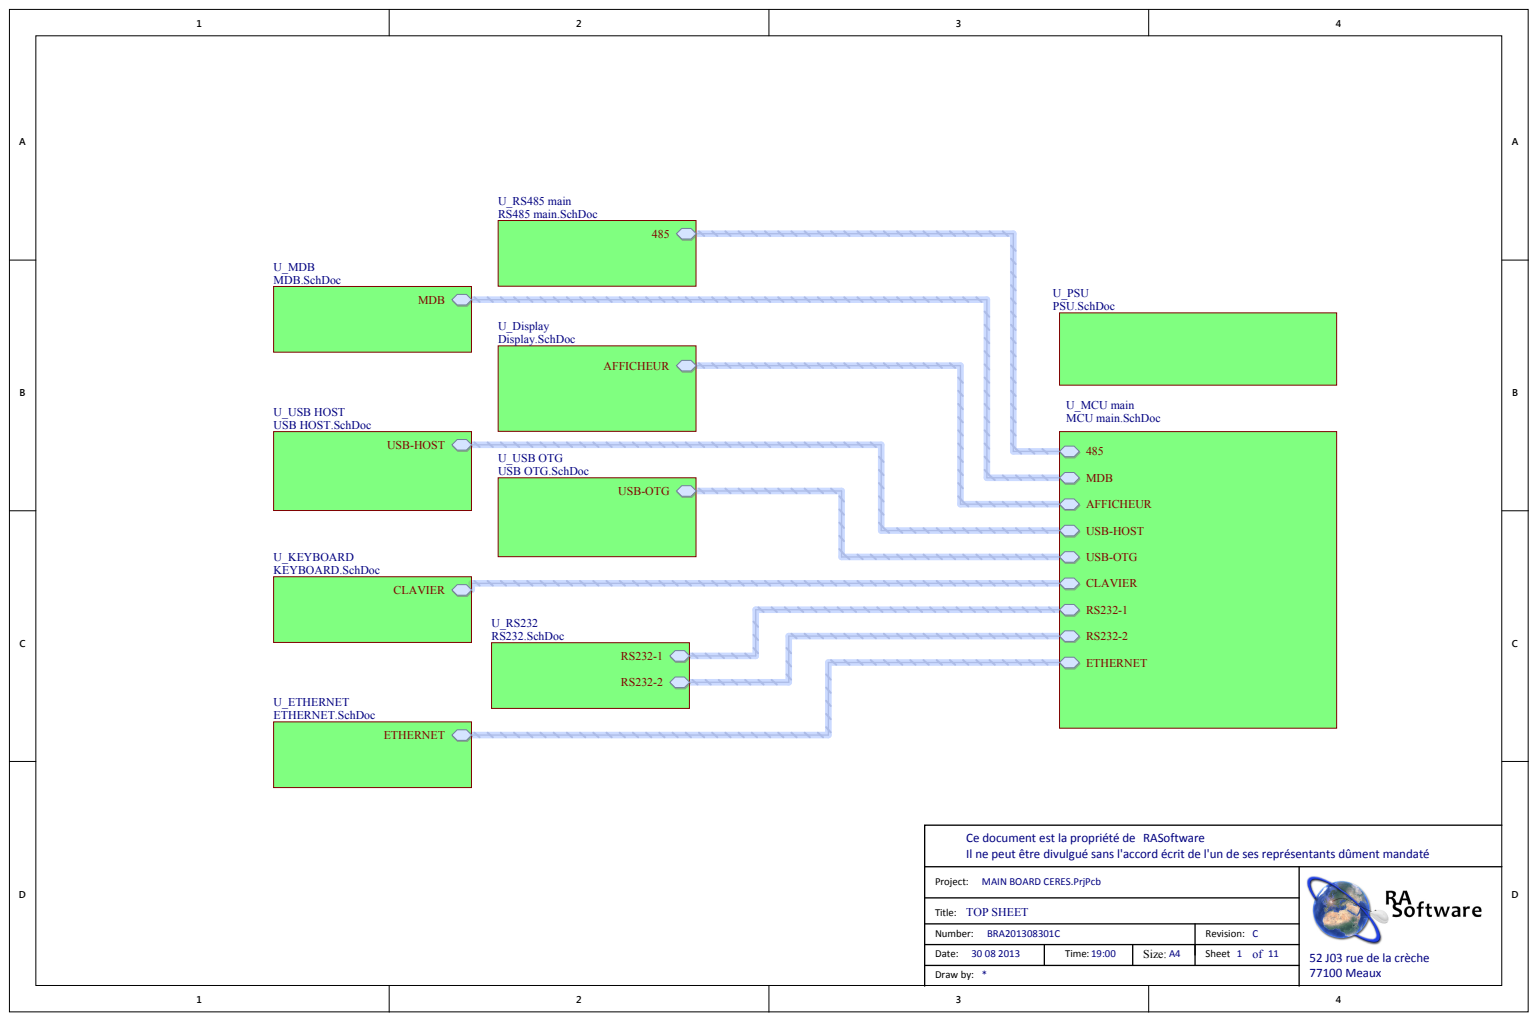
[picture p30: page 1]

Ce document est la propriété de RASoftware
Il ne peut être divulgué sans l'accord écrit de l'un de ses représentants dûment mandaté

Number: BRA201308301C | Revision: C
Date: 30 08 2013 | Time: 19:00 | Size: A4 | Sheet 1 of 11

52 J03 rue de la crèche
77100 Meaux

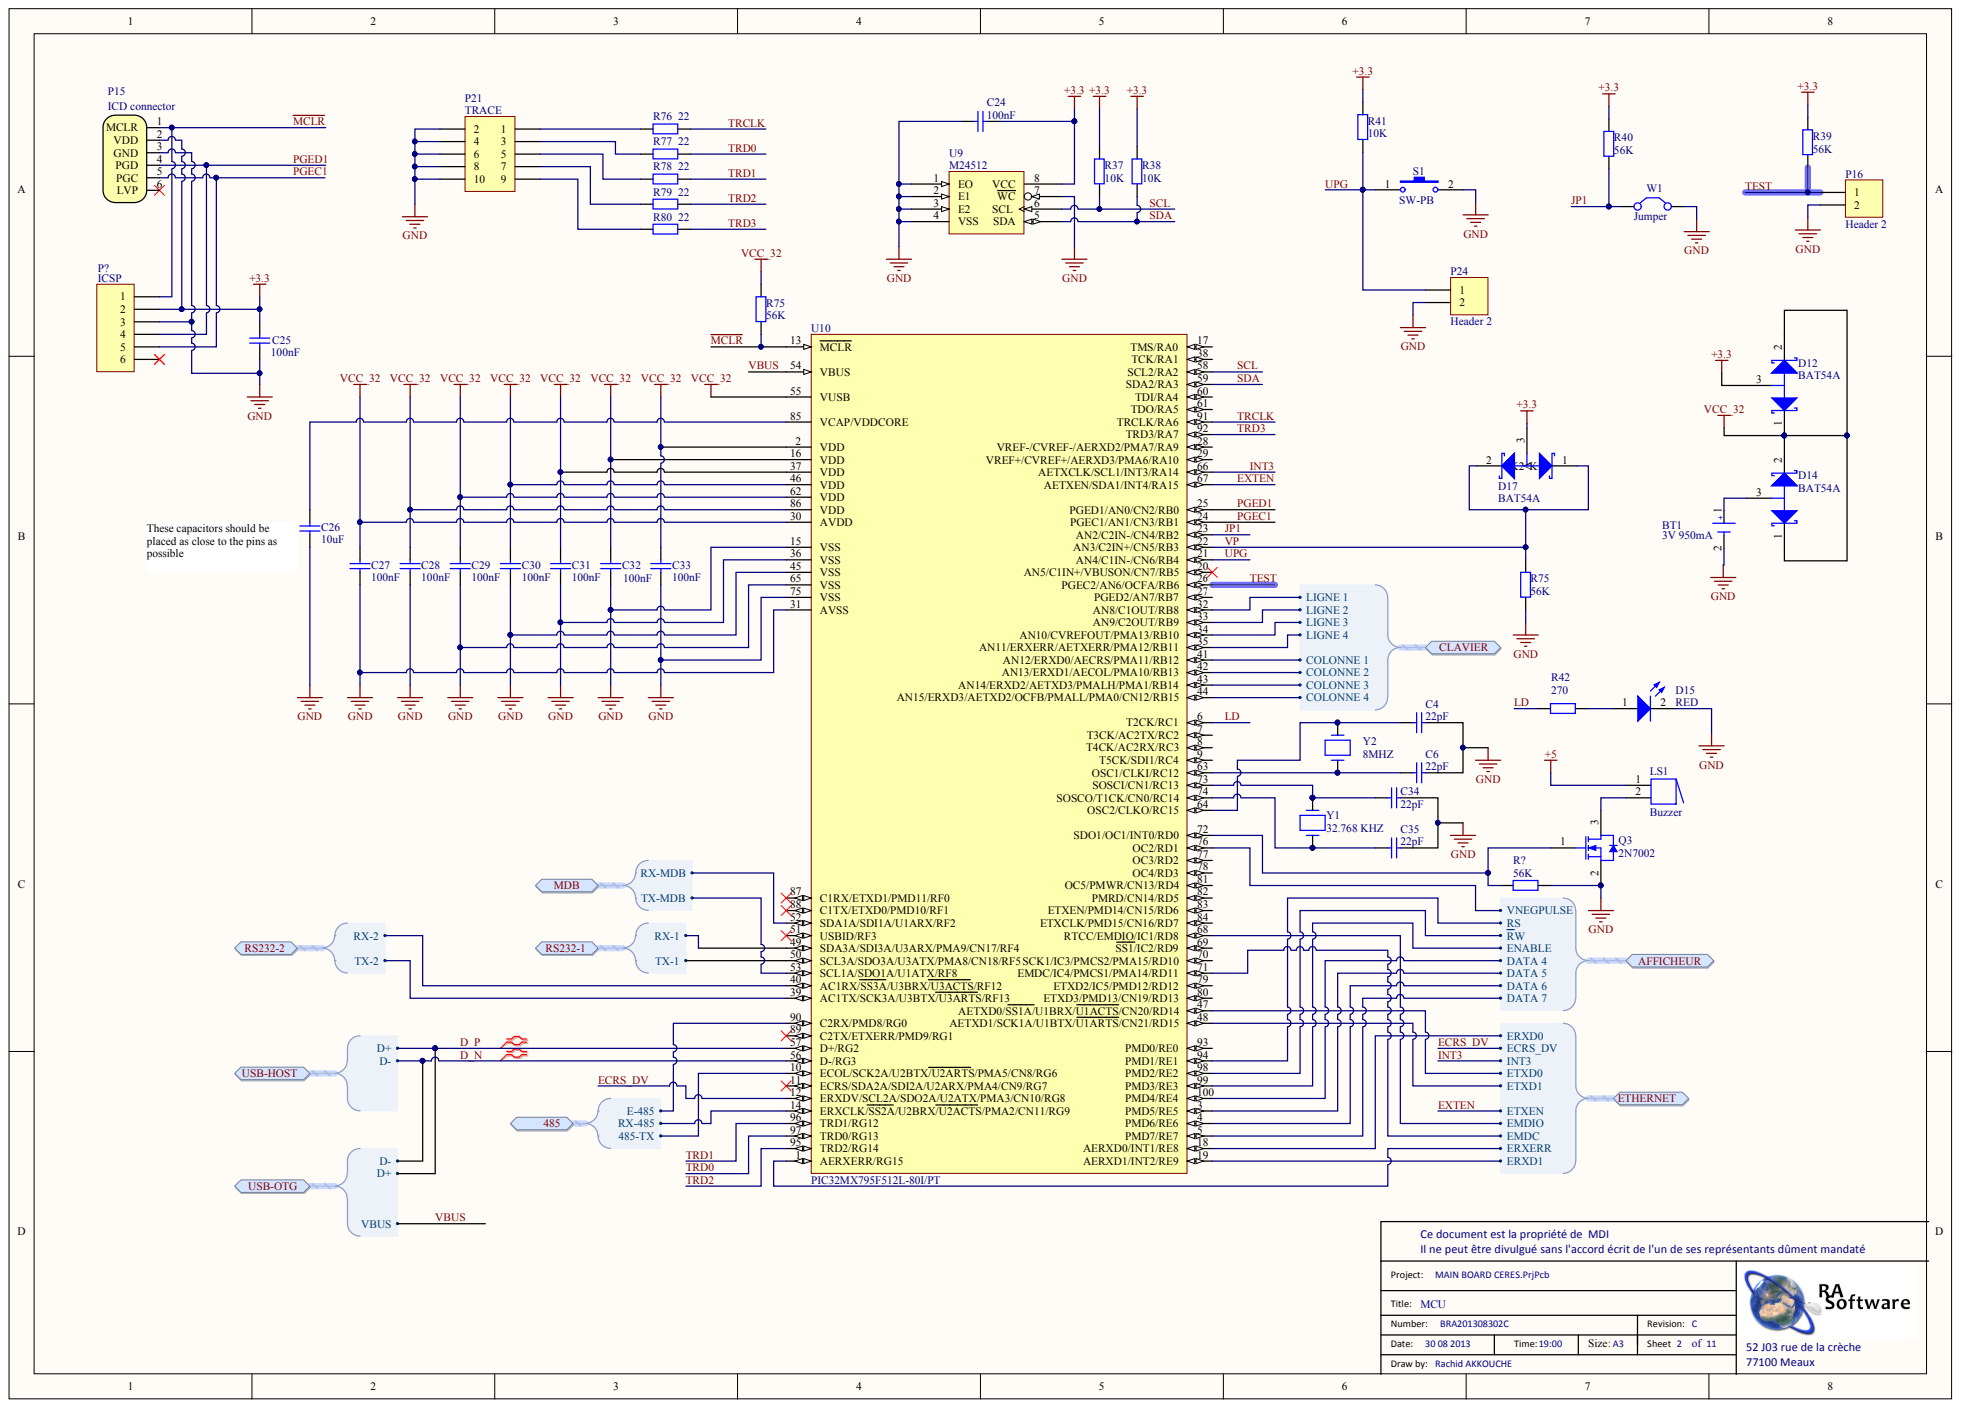
[picture p31: page 2]

D14 BAT54A

These capacitors should be
placed as close to the pins as
pos

VSS 36 | UPG

C33 | VSS 45
100nF | VSS 65

VSS 75

COLONNE 4 LIGNE 1 LIGNE 2 LIGNE 3 LIGNE 4

TX-1 | SDA3A/SDI3A/U3ARX/PMA9/CN17/RF4 49

USBID/RF3 51

SCL1A/SDO1A/U1ATX/RF8 53

D_N | | INT 3

D+/RG2 57 | ECRS_DV

TRD1 TRD0 TRD2 | | AERXERR/RG15 AERXD1/INT2/RE

ent est la propri
être divulgu

écrit de l'un de ses repr

roject: MAIN BOARD CE

Number : B RA201308302C | Revision: C
Date: 30 08 2013 | Time: 19:00 | Size: A3 | Sheet 2 of 11

52 J03 rue de la cr

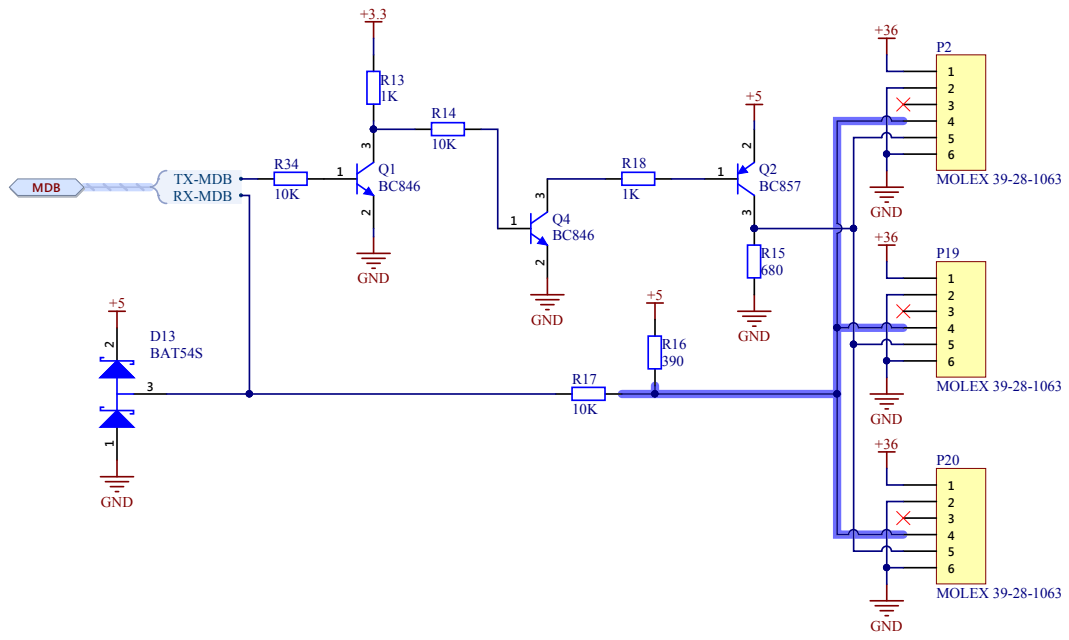
[picture p32: page 3]

Ce document est la propri
Il ne peut

écrit de l'un de ses repr

Number: BRA201308303C | Revision: C
Date: 30 08 2013 | Time: 19:00 | Size: A4 | Sheet 3 of 11

52 J03 rue de la cr

Draw by: Rachid AK

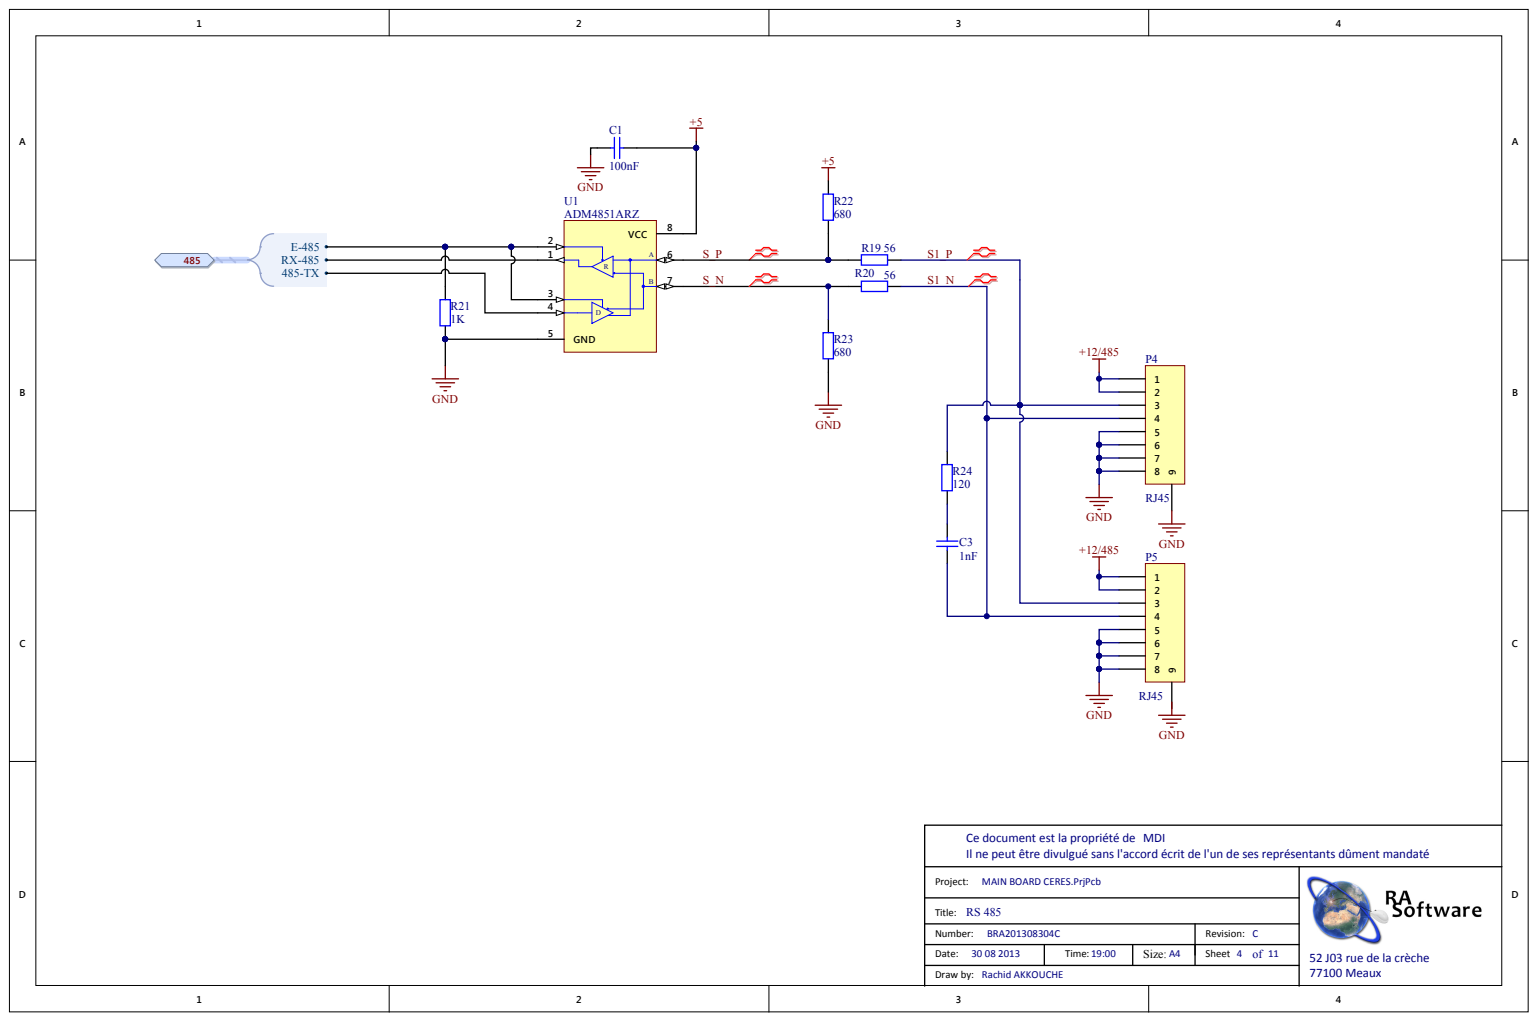
[picture p33: page 4]

Ce document est la propri
Il ne peut

écrit de l'un de ses repr

Number: BRA201308304C | Revision: C
Date: 30 08 2013 | Time: 19:00 | Size: A4 | Sheet 4 of 11

52 J03 rue de la cr

Draw by: Rachid AK

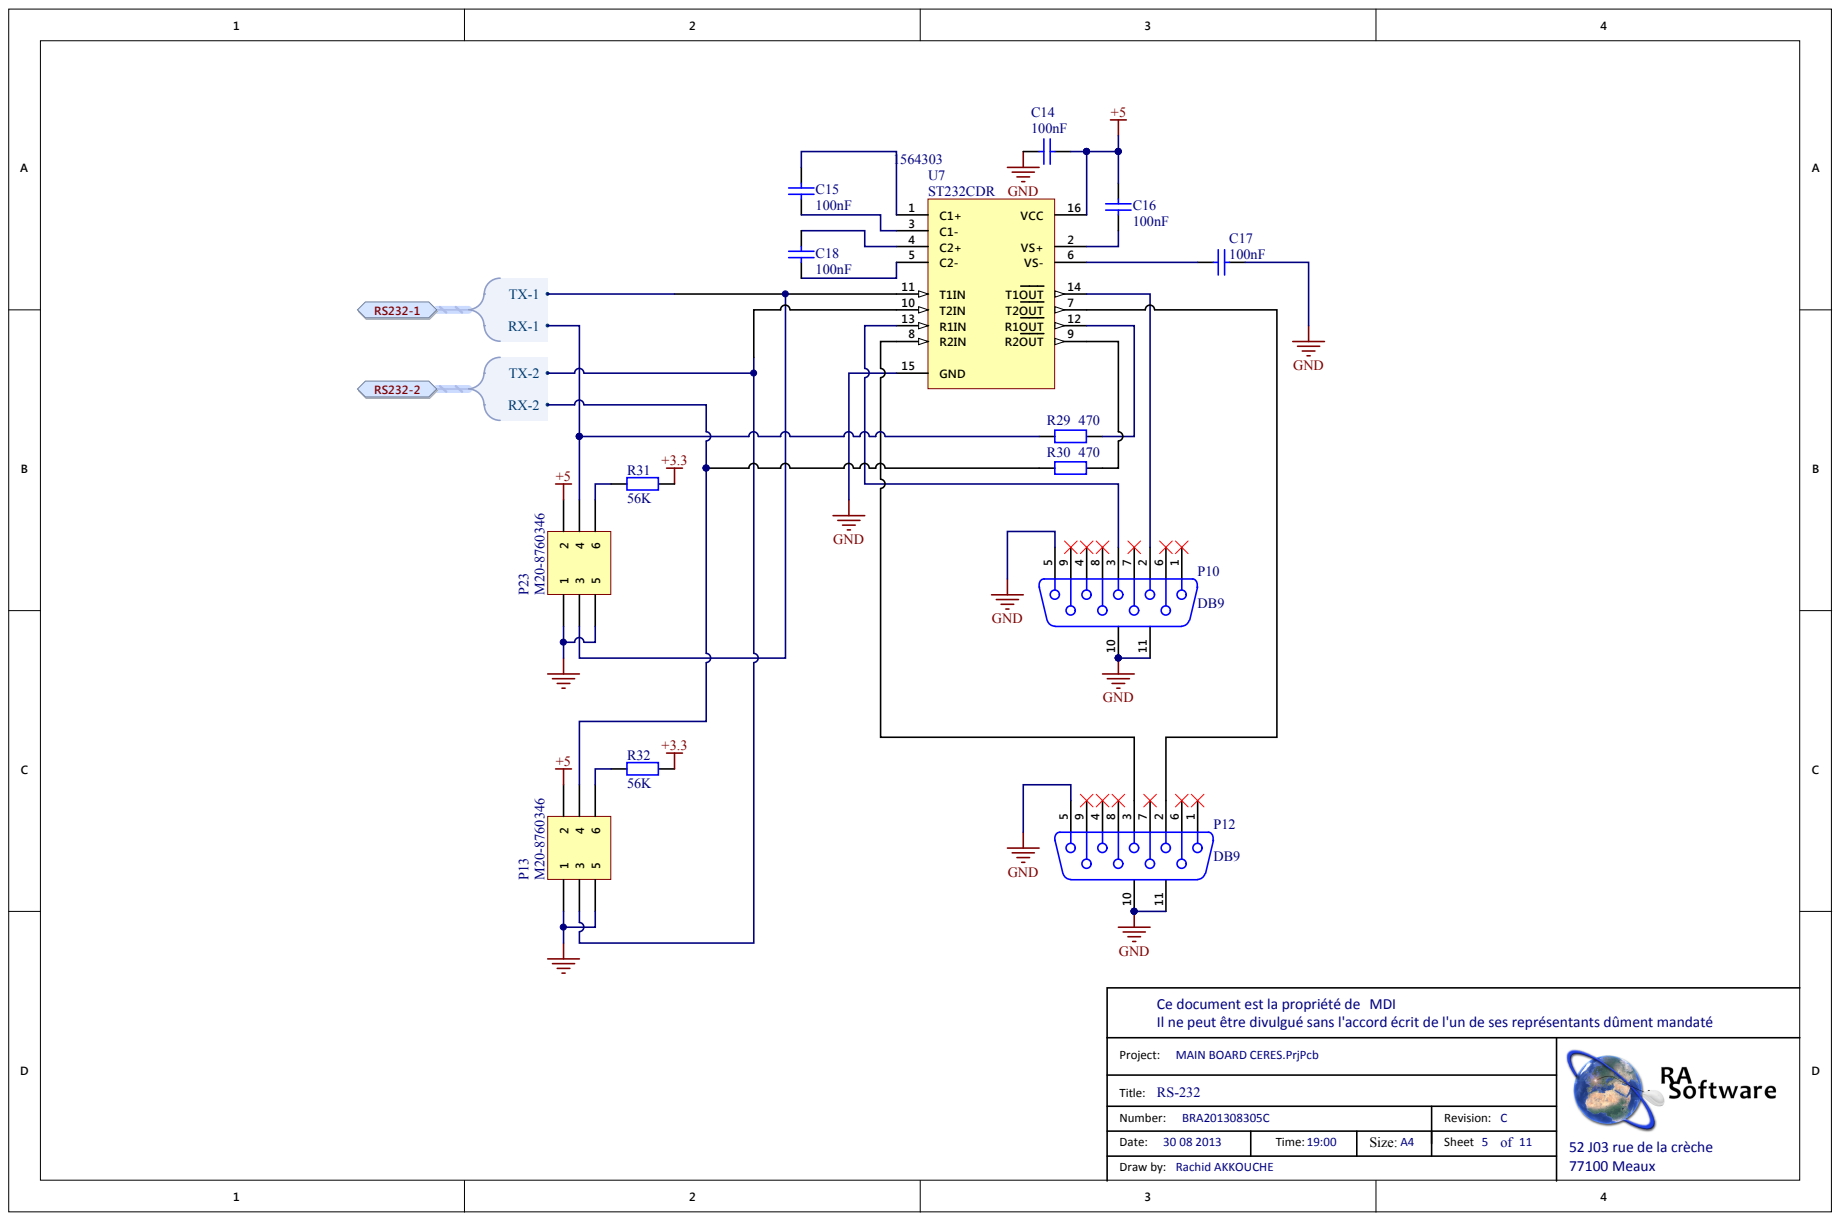
[picture p34: page 5]

1 0 | 7
1 3 | 1 2

Ce document est la propri
Il ne peut

écrit de l'un de ses repr

Number: BRA201308305C | Revision: C
Date: 30 08 2013 | Time: 19:00 | Size: A4 | Sheet 5 of 11

52 J03 rue de la cr

Draw by: Rachid AK

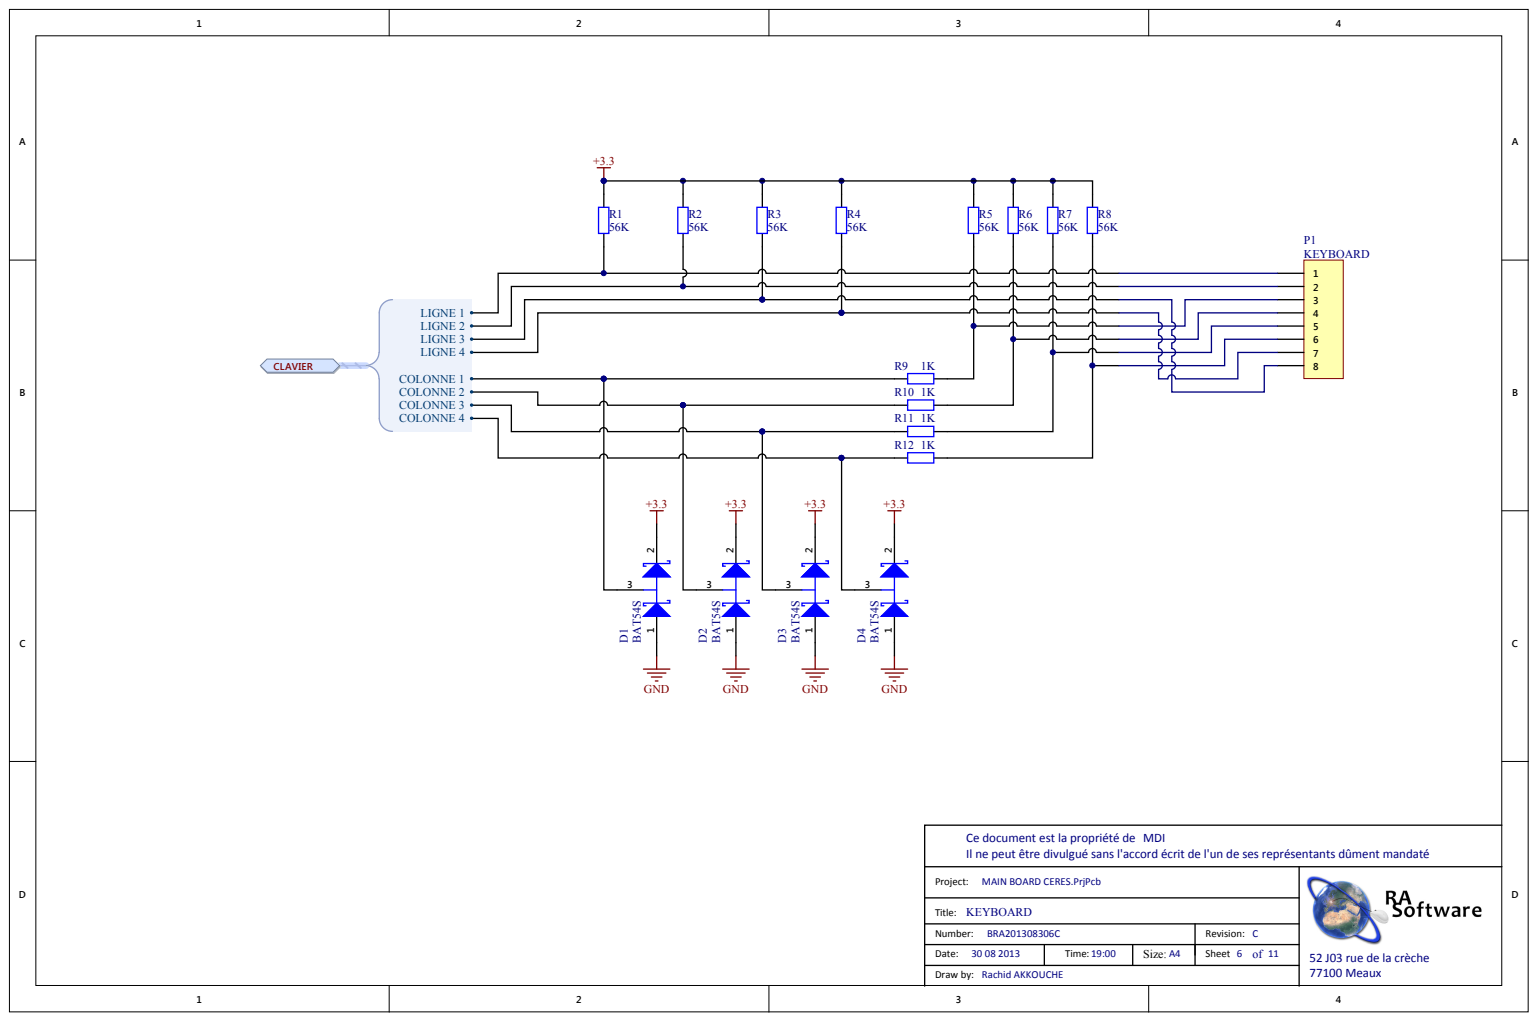
[picture p35: page 6]

Ce document est la propriété de MDI
Il ne peut être divulgué sans l'accord écrit de l'un de ses représentants dûment mandaté

Number: BRA201308306C | Revision: C
Date: 30 08 2013 | Time: 19:00 | Size: A4 | Sheet 6 of 11

52 J03 rue de la crèche

Draw by: Rachid AKKOUCHE

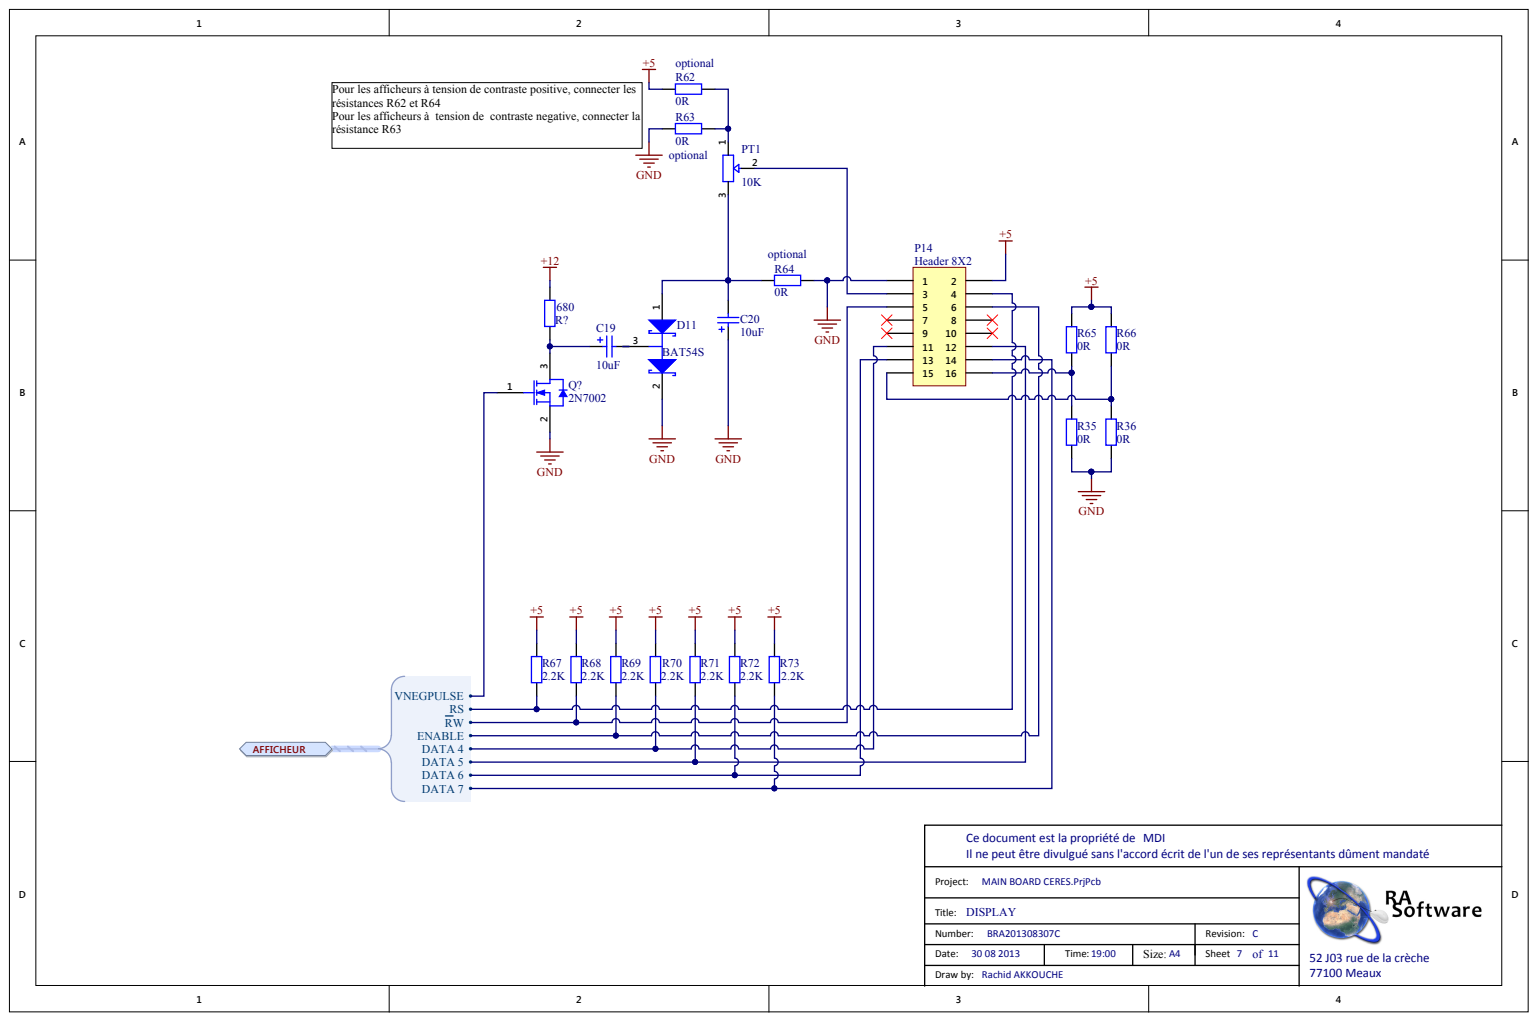
[picture p36: page 7]

Pour les afficheurs à tension de contraste positive, connecter les
résistances R62 et R64
Pour les afficheurs à tension de contraste negative, connecter la
résistance R63

GND

BAT54S | | 13 14

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

Number: BRA201308307C | Revision: C
Date: 30 08 2013 | Time: 19:00 | Size: A4 | Sheet 7 of 11

52 J03 rue de la crèche

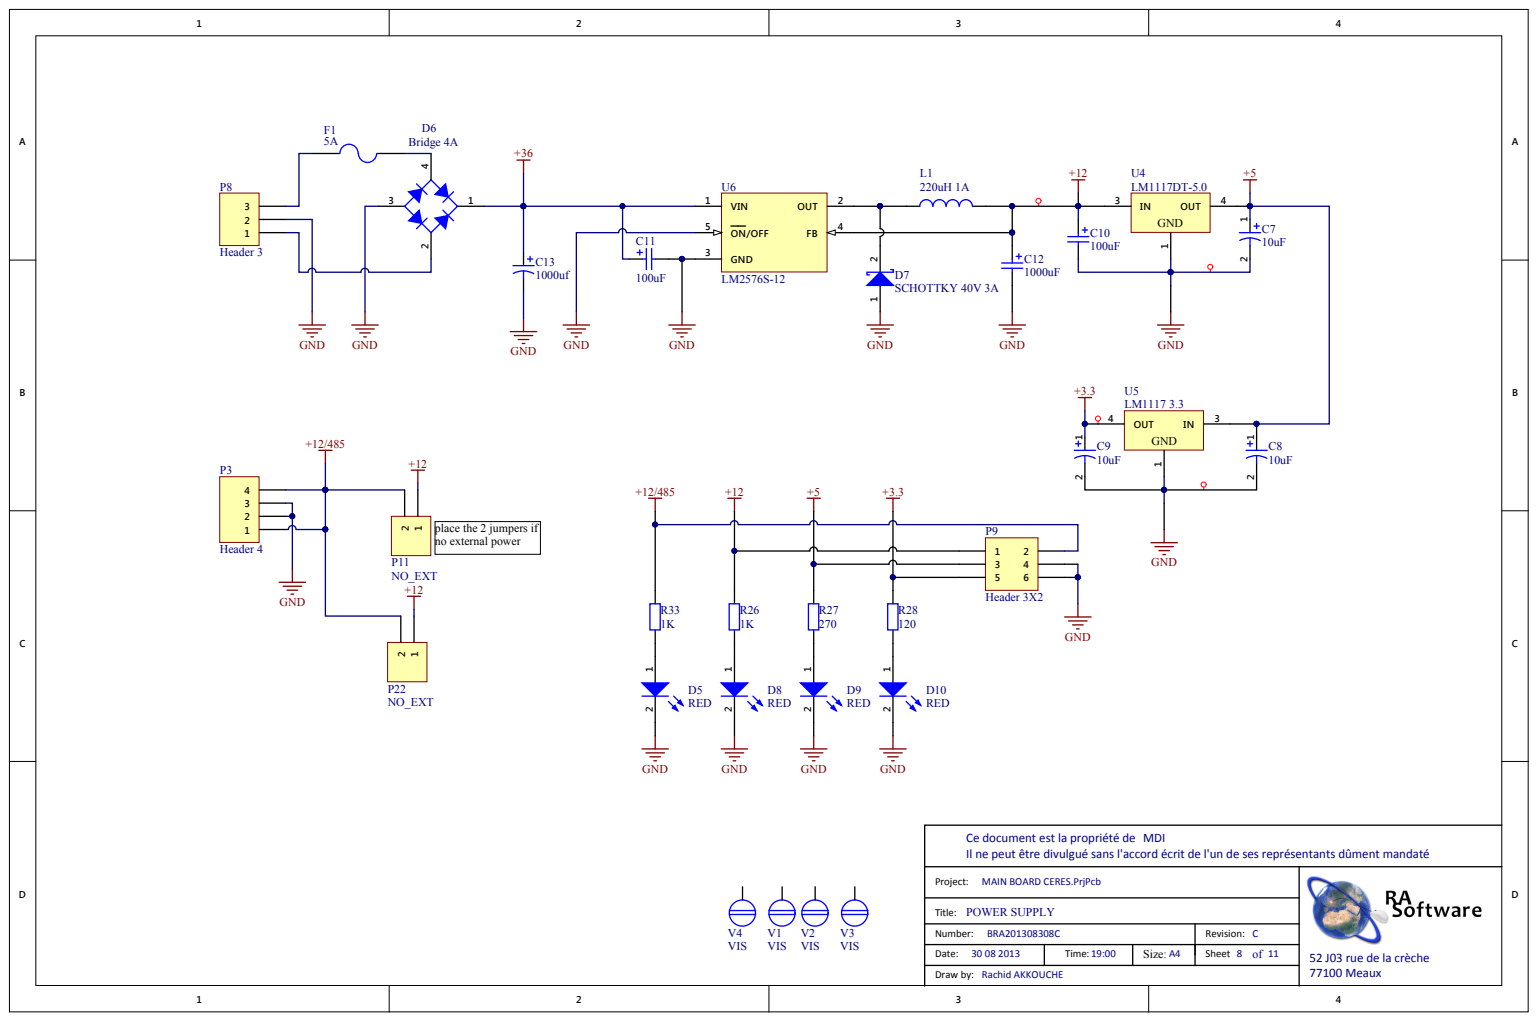
[picture p37: page 8]

place the 2 jumpers if
no external power

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

Number: BRA201308308C | Revision: C
Date: 30 08 2013 | Time: 19:00 | Size: A4 | Sheet 8 of 11

52 J03 rue de la crèche

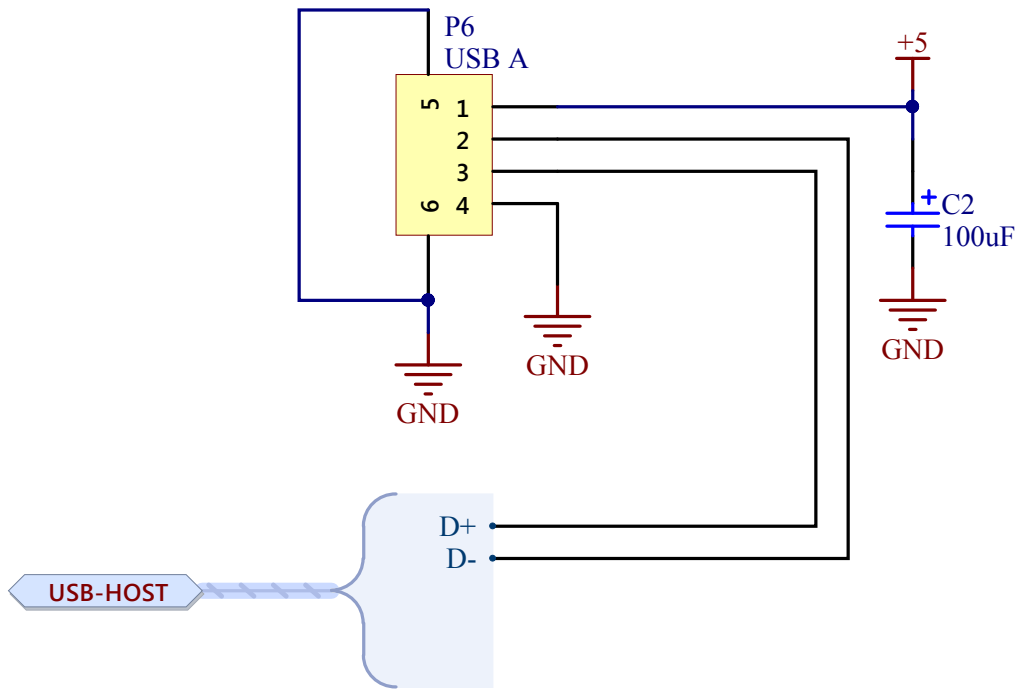
[picture p38: page 9]
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

Number: BRA201308309C | Revision: C
Date: 30 08 2013 | Time: 19:00 | Size: A4 | Sheet 9 of 11

52 J03 rue de la crèche

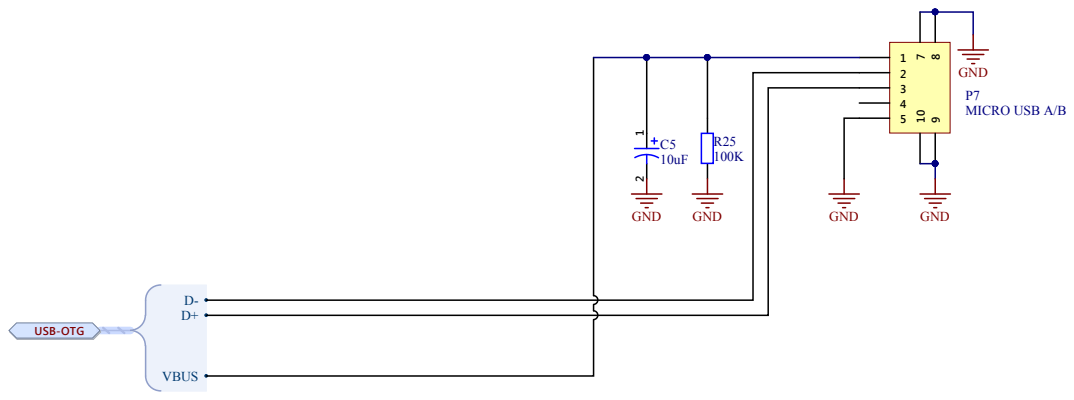
[picture p39: page 10]

Ce document est la propri
Il ne peut

écrit de l'un de ses repr

Number: BRA2013083010C | Revision: C
Date: 30 08 2013 | Time: 19:30 | Size: A4 | Sheet 10 of 11

52 J03 rue de la cr

Draw by: Rachid AK

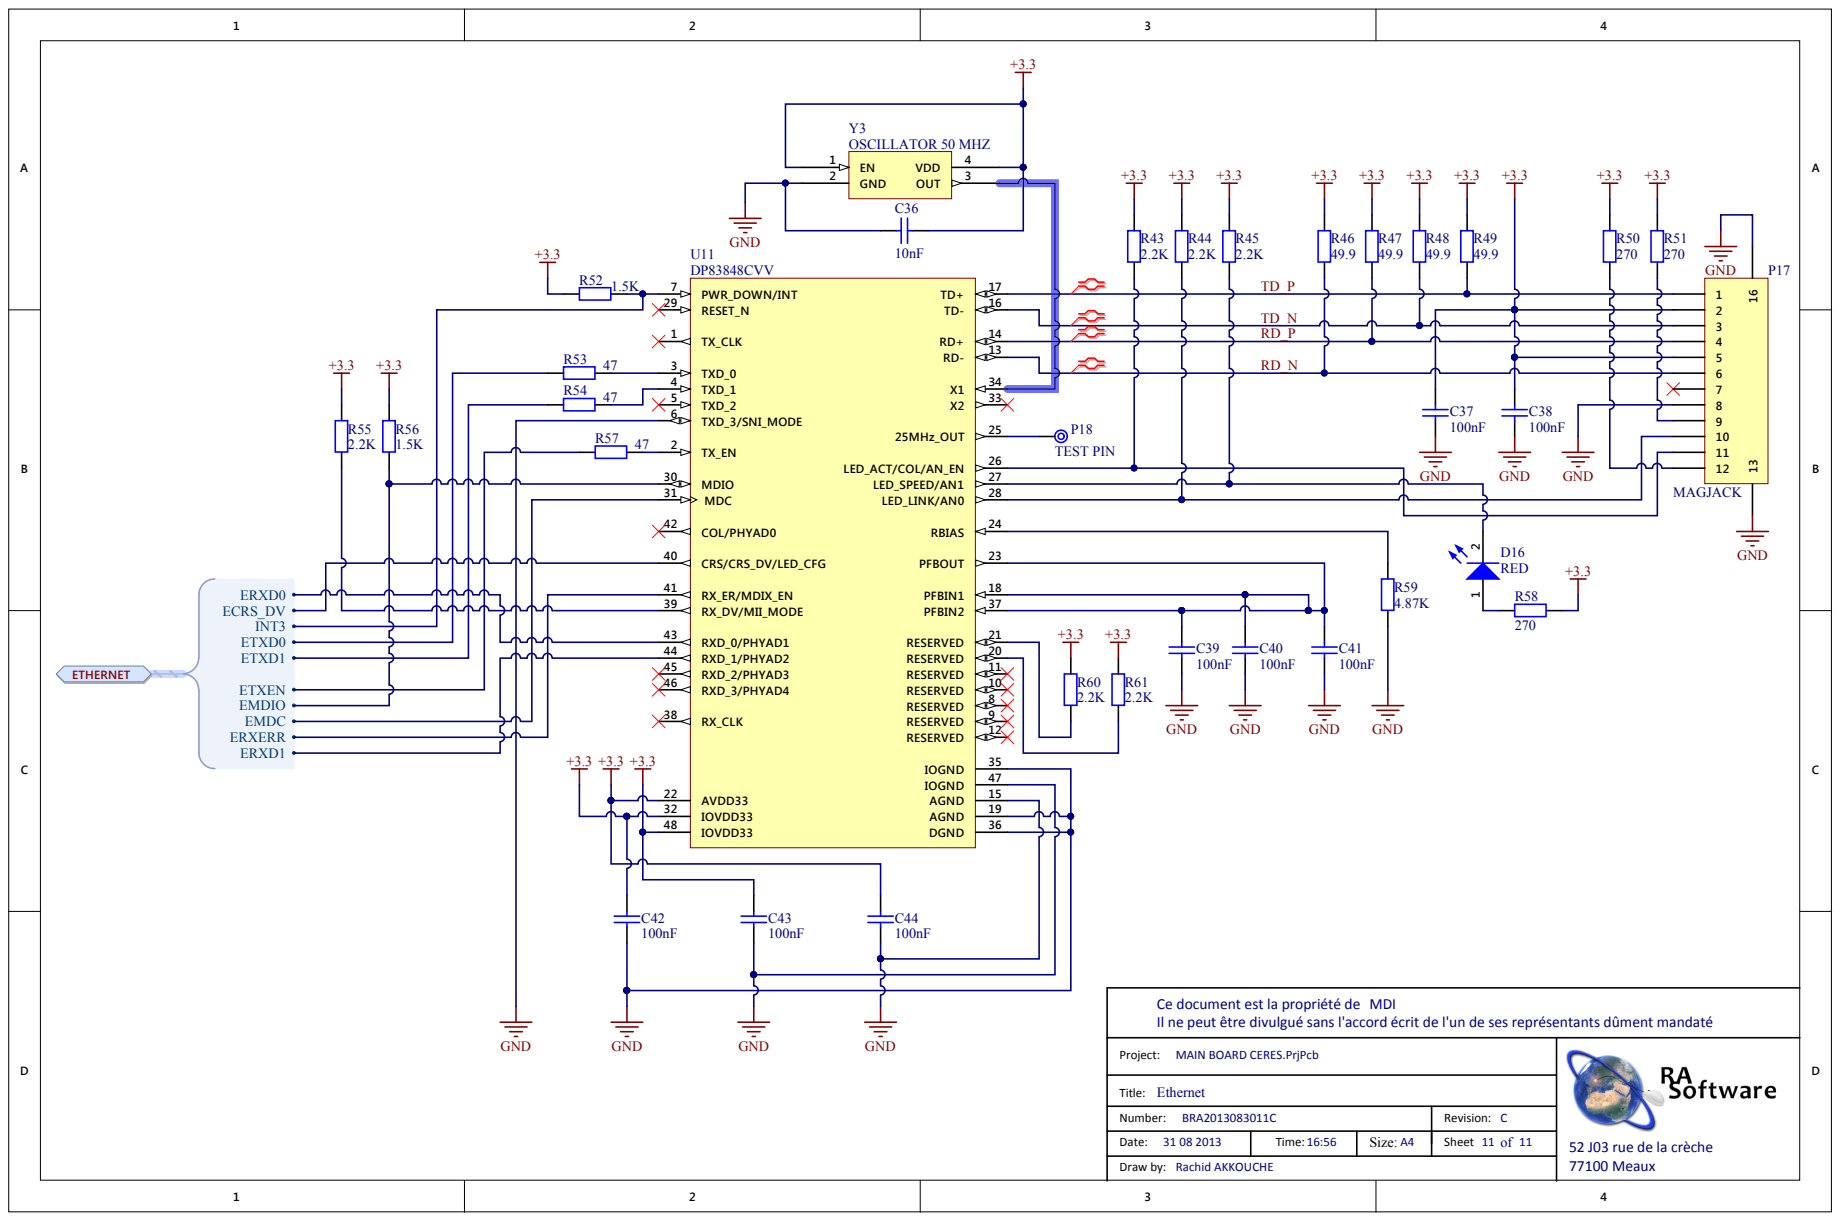
[picture p40: page 11]

TXD_0 3 | | | RD_N
TXD_1 4 | P18 TEST PIN
TXD_2 5
TXD_3/SNI_MODE 6

MDIO 30 MDC 31

COL/PHYAD0 42

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

Number: BRA2013083011C | Revision: C
Date: 31 08 2013 | Time: 16:56 | Size: A4 | Sheet 11 of 11

52 J03 rue de la crèche
