McuMirror/CERES/(list of files, drawings)

Other design files:
HW/IO_Board/Charge.SchDoc
HW/IO_Board/Ex.PrjPCB
HW/IO_Board/IO BOARD CERES V2.PcbDoc
HW/IO_Board/IO BOARD CERES V3.PcbDoc
HW/IO_Board/IO BOARD CERES V4.PcbDoc
HW/IO_Board/IO BOARD CERES V5.PcbDoc
HW/IO_Board/IO BOARD CERES-V2.PrjPcb
HW/IO_Board/IO BOARD CERES-V3.PrjPcb
HW/IO_Board/IO BOARD CERES-V4.PrjPcb
HW/IO_Board/IO BOARD CERES-V5.PrjPcb
HW/IO_Board/IO BOARD CERES.PcbDoc
HW/IO_Board/IO.SchDoc
HW/IO_Board/IOacs712.SchDoc
HW/IO_Board/MCU IO.SchDoc
HW/IO_Board/Old Versions/Charge.SchDoc
HW/IO_Board/Old Versions/Ex.PrjPCB
HW/IO_Board/Old Versions/IO BOARD CERES V2.PcbDoc
HW/IO_Board/Old Versions/IO BOARD CERES V3.PcbDoc
HW/IO_Board/Old Versions/IO BOARD CERES V4.PcbDoc
HW/IO_Board/Old Versions/IO BOARD CERES V5.PcbDoc
HW/IO_Board/Old Versions/IO BOARD CERES-V2.PrjPcb
HW/IO_Board/Old Versions/IO BOARD CERES-V3.PrjPcb
HW/IO_Board/Old Versions/IO BOARD CERES-V4.PrjPcb
HW/IO_Board/Old Versions/IO BOARD CERES-V5.PrjPcb
HW/IO_Board/Old Versions/IO BOARD CERES.PcbDoc
HW/IO_Board/Old Versions/IO.SchDoc
HW/IO_Board/Old Versions/MCU IO.SchDoc
HW/IO_Board/Old Versions/PERMANENT.SchDoc
HW/IO_Board/Old Versions/Pulse.SchDoc
HW/IO_Board/Old Versions/RS485 IO.SchDoc
HW/IO_Board/Old Versions/SATELLITE_2.SchDoc
HW/IO_Board/Old Versions/Sheet1.SchDoc
HW/IO_Board/Old Versions/TEST_BENCH.SchDoc
HW/IO_Board/Old Versions/TEST_BENCH_2.SchDoc
HW/IO_Board/Old Versions/TOPSHEET.SchDoc
HW/IO_Board/Old Versions/WIRE CONVERTER.SchDoc
HW/IO_Board/PERMANENT.SchDoc
HW/IO_Board/Pulse.SchDoc
HW/IO_Board/RS485 IO.SchDoc
HW/IO_Board/SATELLITE_2.SchDoc
HW/IO_Board/Sheet1.SchDoc
HW/IO_Board/TEST_BENCH.SchDoc
HW/IO_Board/TEST_BENCH_2.SchDoc
HW/IO_Board/TOPSHEET.SchDoc
HW/IO_Board/V5/IO BOARD CERES-V5.PrjPcb
HW/IO_Board/V5/IO.schdoc
HW/IO_Board/V5/MCU IO.SchDoc
HW/IO_Board/V5/RS485 IO.SchDoc
HW/IO_Board/V5/TOPSHEET.SchDoc
HW/IO_Board/V6/IO BOARD CERES-V6.PrjPcb
HW/IO_Board/V6/IO.SchDoc
HW/IO_Board/V6/MCU IO.SchDoc
HW/IO_Board/V6/RS485 IO.SchDoc
HW/IO_Board/V6/TOPSHEET.SchDoc
HW/IO_Board/V6A/IO BOARD CERES-V6.PrjPcb
HW/IO_Board/V6A/IO.SchDoc
HW/IO_Board/V6A/MCU IO.SchDoc
HW/IO_Board/V6A/RS485 IO.SchDoc
HW/IO_Board/V6A/TOPSHEET.SchDoc
HW/IO_Board/WIRE CONVERTER.SchDoc
HW/Main Board/Display.SchDoc
HW/Main Board/ETHERNET.SchDoc
HW/Main Board/KEYBOARD.SchDoc
HW/Main Board/LAN8720A.SchDoc
HW/Main Board/MAIN BOARD CERES.PrjPcb
HW/Main Board/MAIN BOARD CERES.SCHLIB
HW/Main Board/MCU main.SchDoc
HW/Main Board/MCU main_2.SchDoc
HW/Main Board/MDB.SchDoc
HW/Main Board/OldETHERNET.SchDoc
HW/Main Board/PHY_DP83848C.SchDoc
HW/Main Board/PHY_LAN8720A.SchDoc
HW/Main Board/PSU.SchDoc
HW/Main Board/PSU_2.SchDoc
HW/Main Board/PSU_D.SchDoc
HW/Main Board/RS232.SchDoc
HW/Main Board/RS485 main.SchDoc
HW/Main Board/Sheet1.SchDoc
HW/Main Board/TOPSHEET.SchDoc
HW/Main Board/USB HOST.SchDoc
HW/Main Board/USB OTG.SchDoc
HW/Main Board/USB.SchDoc
HW_V1b/IO_Board/IO BOARD CERES V2.PcbDoc
HW_V1b/IO_Board/IO BOARD CERES-V2.PrjPcb
HW_V1b/IO_Board/IO BOARD CERES-V3.PrjPcb
HW_V1b/IO_Board/IO BOARD CERES.PcbDoc
HW_V1b/IO_Board/IO.SchDoc
HW_V1b/IO_Board/MCU IO.SchDoc
HW_V1b/IO_Board/PERMANENT.SchDoc
HW_V1b/IO_Board/Pulse.SchDoc
HW_V1b/IO_Board/RS485 IO.SchDoc
HW_V1b/IO_Board/Sheet1.SchDoc
HW_V1b/IO_Board/TOPSHEET.SchDoc
HW_V1b/Main Board/Display.SchDoc
HW_V1b/Main Board/ETHERNET.SchDoc
HW_V1b/Main Board/KEYBOARD.SchDoc
HW_V1b/Main Board/MAIN BOARD CERES.PrjPcb
HW_V1b/Main Board/MAIN BOARD CERES.SCHLIB
HW_V1b/Main Board/MCU main.SchDoc
HW_V1b/Main Board/MDB.SchDoc
HW_V1b/Main Board/PSU.SchDoc
HW_V1b/Main Board/RS232.SchDoc
HW_V1b/Main Board/RS485 main.SchDoc
HW_V1b/Main Board/TOPSHEET.SchDoc
HW_V1b/Main Board/USB HOST.SchDoc
HW_V1b/Main Board/USB OTG.SchDoc
HW_V1b/Main Board/USB.SchDoc
