McuMirror/CERES/SW/MainBoard.X/main.c

/**
 * \file main.c
 * \author Rachid AKKOUCHE
 * \date 30 Novembre 2013, 12:07
 */

#include "main.h"

/*Gestion des interruptions****************************************************/

void __ISR(_CHANGE_NOTICE_VECTOR/*, IPL7AUTO*/) ISRChangeNotice_Handler(void)
{
    if(!PORTReadBits(VP) || !PORTReadBits(W1))
    {
        DelayMs(350);
        isToBeOFF = TRUE;
    }
    else
    {
        SoftReset();
    }
    mCNClearIntFlag();
}

/******************************************************************************/

void __ISR(_RTCC_VECTOR/*, ipl3AUTO*/) ISRRtcc(void)
{
    BaseType_t xHigherPriorityTaskWoken = pdFALSE;
    INTClearFlag(INT_RTCC);
    xSemaphoreGiveFromISR(semaphoreDST, &xHigherPriorityTaskWoken);
}
/******************************************************************************/

/*Routines locales ************************************************************/

/*********************************************************************
 * Function:        void InitAppConfig(void)
 *
 * PreCondition:    MPFSInit() is already called.
 *
 * Input:           None
 *
 * Output:          Write/Read non-volatile config variables.
 *
 * Side Effects:    None
 *
 * Overview:        None
 *
 * Note:            None
 ********************************************************************/
// MAC Address Serialization using a MPLAB PM3 Programmer and
// Serialized Quick Turn Programming (SQTP).
// The advantage of using SQTP for programming the MAC Address is it
// allows you to auto-increment the MAC address without recompiling
// the code for each unit.  To use SQTP, the MAC address must be fixed
// at a specific location in program memory.  Uncomment these two pragmas
// that locate the MAC address at 0x1FFF0.  Syntax below is for MPLAB C
// Compiler for PIC18 MCUs. Syntax will vary for other compilers.
//#pragma romdata MACROM=0x1FFF0
static ROM BYTE SerializedMACAddress[6] = {MY_DEFAULT_MAC_BYTE1, MY_DEFAULT_MAC_BYTE2,
                                           MY_DEFAULT_MAC_BYTE3, MY_DEFAULT_MAC_BYTE4,
                                           MY_DEFAULT_MAC_BYTE5, MY_DEFAULT_MAC_BYTE6};
//#pragma romdata

static void InitAppConfig(void)
{
#if defined(EEPROM_CS_TRIS) || defined(SPIFLASH_CS_TRIS)
    unsigned char vNeedToSaveDefaults = 0;
#endif
    while(TRUE)
    {
        // Start out zeroing all AppConfig bytes to ensure all fields are
        // deterministic for checksum generation
        memset((void*)&AppConfig, 0x00, sizeof(AppConfig));

        AppConfig.Flags.bIsDHCPEnabled = TRUE;
        AppConfig.Flags.bInConfigMode = TRUE;
        memcpypgm2ram((void*)&AppConfig.MyMACAddr, (ROM void*)SerializedMACAddress, sizeof(AppConfig.MyMACAddr));

        AppConfig.MyIPAddr.Val = MY_DEFAULT_IP_ADDR_BYTE1 | MY_DEFAULT_IP_ADDR_BYTE2 << 8ul | MY_DEFAULT_IP_ADDR_BYTE3 << 16ul | MY_DEFAULT_IP_ADDR_BYTE4 << 24ul;
        AppConfig.DefaultIPAddr.Val = AppConfig.MyIPAddr.Val;
        AppConfig.MyMask.Val = MY_DEFAULT_MASK_BYTE1 | MY_DEFAULT_MASK_BYTE2 << 8ul | MY_DEFAULT_MASK_BYTE3 << 16ul | MY_DEFAULT_MASK_BYTE4 << 24ul;
        AppConfig.DefaultMask.Val = AppConfig.MyMask.Val;
        AppConfig.MyGateway.Val = MY_DEFAULT_GATE_BYTE1 | MY_DEFAULT_GATE_BYTE2 << 8ul | MY_DEFAULT_GATE_BYTE3 << 16ul | MY_DEFAULT_GATE_BYTE4 << 24ul;
        AppConfig.PrimaryDNSServer.Val = MY_DEFAULT_PRIMARY_DNS_BYTE1 | MY_DEFAULT_PRIMARY_DNS_BYTE2 << 8ul | MY_DEFAULT_PRIMARY_DNS_BYTE3 << 16ul | MY_DEFAULT_PRIMARY_DNS_BYTE4 << 24ul;
        AppConfig.SecondaryDNSServer.Val = MY_DEFAULT_SECONDARY_DNS_BYTE1 | MY_DEFAULT_SECONDARY_DNS_BYTE2 << 8ul | MY_DEFAULT_SECONDARY_DNS_BYTE3 << 16ul | MY_DEFAULT_SECONDARY_DNS_BYTE4 << 24ul;

        // Load the default NetBIOS Host Name
        memcpypgm2ram(AppConfig.NetBIOSName, (ROM void*)MY_DEFAULT_HOST_NAME, 16);
        FormatNetBIOSName(AppConfig.NetBIOSName);

        // Compute the checksum of the AppConfig defaults as loaded from ROM
        wOriginalAppConfigChecksum = CalcIPChecksum((BYTE*) & AppConfig, sizeof(AppConfig));
        break;
    }
}

/******************************************************************************/

/*Programme principal *********************************************************/

int main(void)
{
    BYTE byIndex;

    /*Desactive le port JTAG*/
    mJTAGPortEnable(DEBUG_JTAGPORT_OFF);
    /*Configure le pic en  fonction de la fréquence*/
    SYSTEMConfigPerformance(configCPU_CLOCK_HZ);
    /*Active le systéme en mode interruption multiple*/
    INTEnableSystemMultiVectoredInt();

    /*Debut programme principal*/
    DisableWDT();
    InitI2CE2promL(I2C2, configPERIPHERAL_CLOCK_HZ);
    vInitialization();

    //Effacement de l'eeprom si nécessaire.
    if(!PORTReadBits(ResetEEprom))
    {
        //Reset l'eeprom
        vEraseEEprom();
    }

    //--------------
    //TODO A supprimer dans la version release.
    //  - Test du delay
    //    PORTSetBits(IOPORT_B, BIT_2);
    //    Delay10us(10);
    //    PORTSetPinsDigitalOut(IOPORT_B, BIT_2);
    //    while(TRUE)
    //    {
    //        PORTToggleBits(IOPORT_B, BIT_2);
    //        DelayMs(50);
    //    }

    vGetParametersAudits();
    /**************************************************************************/

    if(
       //Version 1.2.6
       xTaskCreate(vTaskBeatingHearth, "WTD", STACKHEARTBEATING, NULL, 3, hHeartBeating) &&
       //-----------------
       xTaskCreate(vTaskCheckDST, "DST", STACKDST, NULL, 1, hDST) &&
       xTaskCreate(vTaskPollMDB, "MDBCL", STACKMDB, NULL, 3, hMDB) &&
       xTaskCreate(vTaskCheckKeyBoard, "KEYBOARD", STACKKBD, NULL, 3, hKeyBoard) &&
       xTaskCreate(vTaskTreatKey, "KEYHIT", STACKTREATKEY, NULL, 3, hTreatKey) &&
       xTaskCreate(vTaskCheckUSB, "USB HOST", STACKUSB, NULL, 2, hUSB) &&
       xTaskCreate(vTaskDisplayTime, "DSP_TIME", STACKDSPTIME, NULL, 2, hTimeDisplay) &&
       xTaskCreate(vTaskFlipDisplay, "FLIP", STACKFLIP, NULL, 3, hFlip) &&
       xTaskCreate(vTaskTest, "TEST", STACKTEST, NULL, 1, hTest) &&
       xTaskCreate(vTaskDoChange, "CHANGE", STACKCHANGE, NULL, 3, hChange))
    {
        semaphoreDST = xSemaphoreCreateBinary();
        semaphoreTest = xSemaphoreCreateBinary();
        semaphoreChange = xSemaphoreCreateBinary();
        semaphoreMDB = xSemaphoreCreateMutex();
        queueKeyHit = xQueueCreate(1, sizeof(BYTE));

#ifdef __L_DEBUG
        vQueueAddToRegistry(semaphoreMDB, "SEMDB");
        vQueueAddToRegistry(semaphoreTest, "SETST");
        vQueueAddToRegistry(queueKeyHit, "QKEY");
#endif
        hTimerTOKBD = xTimerCreate("KEY_TO", (centralParameters.byKBDTO + 1) * SECONDE, pdFALSE,
                                   NULL, vTOKBD);
        hTimerTOOverpay = xTimerCreate("OVERPAY", (centralParameters.byOverPayTO + 1) * SECONDE,
                                       pdFALSE, NULL, vTOOverPay);
        hTimerTOCumul = xTimerCreate("CUMUL", (centralParameters.byCumulTO + 1) * SECONDE,
                                     pdFALSE, NULL, vTOCumul);
        hTimerKBDRepeat = xTimerCreate("RPT_KBD", lRepeatKBD + 1, pdFALSE, NULL, vTimerRepeat);
        hTimerFlip = xTimerCreate("FLIP", PREDELAYFLIP, pdFALSE, NULL, vTimerFlip);
        hTimerTOBuzzer = xTimerCreate("BUZZER", TOBUZZER, pdFALSE, NULL, vTOBuzzer);

        for(byIndex = 0; byIndex < MAXMACHINES; byIndex++)
        {
            ClrWdt();
            modules[byIndex].timerActivationMachine = xTimerCreate("PULSE", modules[byIndex].config.lPulseInMS,
                                                                   pdFALSE, &byIndex, vTimerMachineEndPulse);
#ifndef __L_DEBUG
            if((modules[byIndex].config.byNumero > 9) && (modules[byIndex].config.byNumero < 99) &&
               (wGetSatelliteFWVersion(modules[byIndex].config.byNumero) < 120))
            {
                boModifyMachineRelayState(modules[byIndex].config.byNumero, RELAY_OFF);
            }
#endif
        }

        IEC1bits.AD1IE = FALSE;
        IEC1CLR = 0X0002;

        xSemaphoreGive(semaphoreMDB);
        vSetHisto(0, 0, INITIALISATION, 0, SUCCESSFUL);
#ifndef __L_DEBUG
        EnableWDT();
#endif
        vTaskStartScheduler();
        for(;;);
    }
    return 0;
}

/******************************************************************************/

/*********************************************************************
 * Function:        void DisplayLine(BYTE *byData)
 *
 * PreCondition:    None
 *
 * Input:           byData pointeur sur la ligne à afficher
 *
 * Output:          None
 *
 * Side Effects:    None
 *
 * Overview:        None
 *
 * Note:            None
 ********************************************************************/
void DisplayLine(BYTE *byData)
{
    BYTE byIndex = 0;
    do
    {
        while(LCD_IsBusy());
        PORTSetBits(LCD_RS);
        LCDSetValue(byData[byIndex]);
    }while(byData[++byIndex]);
}
/******************************************************************************/

/*********************************************************************
 * Function:        void vInitalization(void)
 *
 * PreCondition:    None
 *
 * Input:           None
 *
 * Output:          None
 *
 * Side Effects:    None
 *
 * Overview:        None
 *
 * Note:            None
 ********************************************************************/
void vInitialization(void)
{
    wEcran = SCREENBEGINMAINTENANCE;
    lRepeatKBD = REPEATDELAYKBDBYDEFAULT;
    boFlip = boCancel = isFileCreditPresent = isTOCumul =
        boChangeAutorized = isTO_KBDEnable = boDisplayRemaining = isTO_KBDEnable =
        boToEscrow = boDisplayRemaining = boFromHTTP = isChangeInProgress =
        isToBeOFF = isFillingInProgress = FALSE;
    memset(byBuffer, 0, sizeof(byBuffer));
    memset(byCreditFileName, 0, sizeof(byCreditFileName));
    wTORequest = byPosNum = lOldAmountUSBDispo = lAmountToPay =
        lOldAmountInCashDispo = lAmountUSBDispo = lAmountInCashDispo = wPrice = 0;
    byDecimalPos = DECIMALPOSBYDEFAULT;
    byBillNumber = byIndexSelectedMachine = 0XFF;
    wCurrencyDivider = 100;
    memset(kbdButton, 0XFF, sizeof(kbdButton));

    vInit_IO();

    setbuf(stdout, NULL);
    LCDInit(2);
    //Affiche l'écran de présentation. Le scheduler n'est pas encore arrivé
    sprintf(byBuffer, "%s %s", byTexte[MDIVERSION], Version);

    DisplayLine(byBuffer);
    while(LCD_IsBusy());
    LCDSetValue(LCD_SET_DDRAM_ADDR | 0x40);
    sprintf(byBuffer, "%s *%02X%02X%02X%02X%02X%02X*", byTexte[CENTRALE],
            0XFC, EMAC1SA2 / 256, EMAC1SA1 % 256, EMAC1SA1 / 256,
            EMAC1SA0 % 256, EMAC1SA0 / 256);
    DisplayLine(byBuffer);


    InitRS485(RS485, configPERIPHERAL_CLOCK_HZ, 9600, UART_DATA_SIZE_8_BITS,
              UART_PARITY_NONE, UART_STOP_BITS_1, IOPORT_G, BIT_0);
    OpenUART(RS232_2, configPERIPHERAL_CLOCK_HZ, 9600, UART_DATA_SIZE_8_BITS,
             UART_PARITY_NONE, UART_STOP_BITS_1);
    InitMDB(MDBPORT);
    lAmountCL = lAmountBV = lAmountCG = lAmountInCashDispo = 0;
    //Annule toutes les authorisations.
    boLocalAccountantEnable = isHttpAccountantEnable = FALSE;
    RtccInit();
    while(RtccGetClkStat() != RTCC_CLK_ON);
    RtccGetTimeDate(&Now, &Today);

    //0.9.2a 2014 10 14 17:21
    //Vérification de la cohérence de la date.
    if(((Today.mday & 0x0F) > 9) || (((Today.mday >> 4) & 0xF) > 3) ||
       ((Today.mon & 0x0F) > 9) || (((Today.mon >> 4) & 0xF) > 1) ||
       ((Today.year & 0x0F) > 9) || (((Today.year >> 4) & 0xF) > 9) || (Today.wday > 6) ||
       ((Now.sec & 0x0F) > 9) || (((Now.sec >> 9) & 0xF) > 5) ||
       ((Now.min & 0x0F) > 9) || (((Now.min >> 4) & 0xF) > 5) ||
       ((Now.hour & 0x0F) > 9) || (((Now.hour >> 4) & 0xF) > 2))
    {
        Today.l = 0x15010100;
        Now.l = 0x00000100;
        RtccSetTimeDate(Now.l, Today.l);
    }
    /**********************/
    while(!RtccGetAlarmEnable())
    {
        RtccAlarmEnable();
    }
    RTCALRMbits.AMASK = 0b1001;
    INTSetVectorPriority(INT_RTCC_VECTOR, INT_PRIORITY_LEVEL_3); //Set the RTCC priority in the INT controller
    INTSetVectorSubPriority(INT_RTCC_VECTOR, INT_SUB_PRIORITY_LEVEL_1); //Set the RTCC sub-priority in the INT controller
    INTClearFlag(INT_RTCC);
    INTEnable(INT_RTCC, INT_ENABLED); //Enable the RTCC event interrupts in the INT controller.

    srand((Now.l = RtccGetTime()));

}
/******************************************************************************/

/*********************************************************************
 * Function:        void vInit_IO(void)
 *
 * PreCondition:    None
 *
 * Input:           None
 *
 * Output:          None
 *
 * Side Effects:    None
 *
 * Overview:        None
 *
 * Note:            None
 ********************************************************************/
void vInit_IO(void)
{
    AD1CON1CLR = 0XFFFFFFF;
    AD1PCFGSET = 0XFFFFFFF;

    CM1CONbits.ON = FALSE;
    CM2CONbits.ON = FALSE;

    //Led
    PORTSetPinsDigitalOut(RED);
    LEDON(RED);

    //Bouton de test
    PORTSetBits(ONBOARDBUTTON);
    PORTSetBits(W1);
    PORTSetBits(VP);
    PORTSetPinsDigitalIn(ONBOARDBUTTON);
    PORTSetPinsDigitalIn(W1);
    PORTSetPinsDigitalIn(VP);

    //Jumper d'initialisation de l'eeprom.
    PORTSetBits(ResetEEprom);
    PORTSetPinsDigitalIn(ResetEEprom);

    vEnableCN();

    //Buzzer
    PORTSetPinsDigitalOut(BUZZER);
    PORTClearBits(BUZZER);

    //Clavier
    PORTSetBits(ROWPORT, LIGNES | COLONNES); //Positionne le port du clavier à l'etat haut.
    PORTSetPinsDigitalIn(COLUMNPORT, COLONNES); //Positionne les colonnes en entrées.
    PORTSetPinsDigitalOut(ROWPORT, LIGNES); //Positionne les lignes en sorties.

    //Reset du port MDB
    PORTSetPinsDigitalOut(MDBLINE);
    PORTClearBits(MDBLINE);
    DelayMs(500);
}
/******************************************************************************/

/*********************************************************************
 * Function:        void vScreenHistorique(const BYTE byKeyHit)
 *
 * PreCondition:    None
 *
 * Input:           None
 *
 * Output:          None
 *
 * Side Effects:    None
 *
 * Overview:        None
 *
 * Note:            None
 ********************************************************************/
void vScreenHistorique(const BYTE byKeyHit)
{
    UOPERATION histoData;
    memset(byBuffer, 0, sizeof(byBuffer));
    //Si c'est la touche étoile, retour à l'ecran de maintenance.
    if(byKeyHit == STAR)
    {
        wEcran = SCREENMAINMAINTENANCE;
    }
    else
    {
        if(sender == MAINMAINTENANCE)
        {
            //Récupèration de l'adresse actuelle de l'historique
            wE2OperationPosRead = wE2OperationPos;
            sender = HISTORIQUEMENU;
        }
        else
        {
            switch(byKeyHit)
            {
                case KEYFORWARD:
                {
                    wE2OperationPosRead -= sizeof(UOPERATION);
                    if(wE2OperationPosRead < ADDRESS_HISTO)
                    {
                        wE2OperationPosRead = (0xFFFF - sizeof(histoData) + 1);
                        I2CE2promLReadBuffer(wE2OperationPosRead, &histoData, sizeof(UOPERATION));
                        if((histoData.Operation & 0XFF) == NONEOP)
                        {
                            wE2OperationPosRead = wE2OperationPos;
                        }
                    }
                }
                    break;
                case KEYNEXT:
                {
                    wE2OperationPosRead += sizeof(UOPERATION);
                    if(wE2OperationPosRead > wE2OperationPos)
                    {
                        wE2OperationPosRead = ADDRESS_HISTO;
                    }
                }
                    break;
                default:
                {
                    break;
                }
            }
        }
        I2CE2promLReadBuffer(wE2OperationPosRead, &histoData, sizeof(UOPERATION));
        sprintf(byBuffer, "%02X-%02X-%02X %02X:%02X:%02X %s", histoData.date.mday,
                histoData.date.mon, histoData.date.year, histoData.time.hour,
                histoData.time.min, histoData.time.sec, byTexte[UNKNOW_OP + histoData.Operation]);
        switch(histoData.Operation)
        {
            case LANCEMENT:
            {
                sprintf(&byBuffer[strlen(byBuffer)], " %u  %.*f\7", histoData.byMachine, byDecimalPos, (double)histoData.lAmount / wCurrencyDivider);
            }
                break;
            case INCG:
            case INBV:
            case OUCG:
            case OVERPAYOP:
            case FILLINGOP:
            {
                sprintf(&byBuffer[strlen(byBuffer)], " %.*f\7", byDecimalPos, (double)histoData.lAmount / wCurrencyDivider);
            }
                break;
            case PAYCASHLESS:
            case REVALUECASHLESS:
            case KEYPRESENT:
            case USBPAY:
            {
                sprintf(&byBuffer[strlen(byBuffer)], " %u  %.*f\7", histoData.lKeyNumber, byDecimalPos, (double)histoData.lAmount / wCurrencyDivider);
            }
                break;
            case USBKEYINSERTED:
            {
                if(histoData.lAmount)
                {
                    sprintf(&byBuffer[strlen(byBuffer)], " %u  %.*f\7", histoData.lKeyNumber, byDecimalPos, (double)histoData.lAmount / wCurrencyDivider);
                }
            }
                break;
            default:
            {
                break;
            }
        }
    }
    //Le buffer sera passé en paramètre à la fonction vMenuMaintenance.
    ptrParameterMenu = byBuffer;
}
/******************************************************************************/

/*********************************************************************
 * Function:        void vConfirmSatelliteRemove(const BYTE byKey)
 *
 * PreCondition:    None
 *
 * Input:           None
 *
 * Output:          None
 *
 * Side Effects:    None
 *
 * Overview:        None
 *
 * Note:            None
 ********************************************************************/
void vConfirmSatelliteRemove(const BYTE byKey)
{
    switch(byKey)
    {
        case STAR:
        {
            wEcran = SCREENSATELLITE;
            break;
        }
        case SHARP:
        {
            if(sender == REMOVESATELLITE)
            {
                LCDClear();
                memset(bySatBuffer, 0, sizeof(bySatBuffer));
                if(!boModifyMachineNumber(modules[byIndexSelectedMachine].config.byNumero, 0XFF))
                {
                    vDisplayLCD("%s %u %s", byTexte[SATELLITE],
                                modules[byIndexSelectedMachine].config.byNumero, byTexte[NONEXISTENT]);
                    DelayMs(centralParameters.lDelayDisplay);
                    LCDGotoXY(1, 2);
                }
                vDisplayLCD(byTexte[REMOVED], modules[byIndexSelectedMachine].config.byNumero);
                memset(&modules[byIndexSelectedMachine], 0XFF, sizeof(SMACHINE_CONFIG));
                I2CE2promLWriteBuffer(ADDRESS_MACHINES_PARAMETERS + (byIndexSelectedMachine * sizeof(SMACHINE_CONFIG)),
                                      &modules[byIndexSelectedMachine], sizeof(SMACHINE_CONFIG));
                wEcran = SCREENSATELLITE;
                ptrParameterMenu = NULL;
                boReturnMaintenance = TRUE;
                byPosNum = 0;
                DelayMs(centralParameters.lDelayDisplay);
            }
            else
            {
                wEcran = SCREENSATELLITEAUTO;
            }
            break;
        }
        default:
        {
            break;
        }
    }
}
/******************************************************************************/

/*********************************************************************
 * Function:        void vTaskCheckKeyBoard(void *pvParameter)
 *
 * PreCondition:    None
 *
 * Input:           None
 *
 * Output:          None
 *
 * Side Effects:    None
 *
 * Overview:        None
 *
 * Note:            None
 ********************************************************************/
void vTaskCheckKeyBoard(void *pvParameter)
{
    BYTE byKey = 0;
    //DelayMs(1000);
    vResetSelectMachine();
    TickType_t LastWakeTime = xTaskGetTickCount();
    for(;;)
    {
        if(isToBeOFF)
        {
            vSleepMCU();
        }

        if((byKey = byGetKey()) && !((byKey == 11) && !byPosNum && (UsageMode == MODEUSER) && isKBDEnable))
        {
            xQueueSendToBack(queueKeyHit, &byKey, 0);
        }
        if(!PORTReadBits(ONBOARDBUTTON))
        {
            DelayMs(30);
            if(!PORTReadBits(ONBOARDBUTTON))
            {
                while(!PORTReadBits(ONBOARDBUTTON));
                if(UsageMode != MODEUSER)
                {
                    //vReset();
                    vReturnFromTest();
                }
                else
                {
                    vSetHisto(0, 0, TEST_START, 0, SUCCESSFUL);
                    isAuditEnable = isConfigEnable = isHistoEnable = isRAZEnable = isRefillingEnable = TRUE;
                    xSemaphoreGive(semaphoreTest);
                }
            }
            isTO_KBDEnable = TRUE;
            xTimerStart(hTimerTOKBD, 10);
        }
        vTaskDelayUntil(&LastWakeTime, DELAY_CHK_KBD);
    }
}
/******************************************************************************/

/*********************************************************************
 * Function:        void vTaskTreatKey(void *pvParameter)
 *
 * PreCondition:    None
 *
 * Input:           None
 *
 * Output:          None
 *
 * Side Effects:    None
 *
 * Overview:        None
 *
 * Note:            None
 ********************************************************************/
void vTaskTreatKey(void *pvParameter)
{
    BYTE byKeyHit;

    for(;;)
    {
        xQueueReceive(queueKeyHit, &byKeyHit, portMAX_DELAY);
        vStartBuzzer(centralParameters.boBuzzer, TOBUZZER);
        isTO_KBDEnable = TRUE;
        isTOCumul = FALSE;
        xTimerStart(hTimerTOKBD, 1000);
        xTimerStop(hTimerTOCumul, 1000);
        if(byKeyHit == 11)
        {
            byKeyHit = 0;
        }
        if(UsageMode == MODEMAINTENANCE)
            // <editor-fold defaultstate="collapsed" desc="MODEMAINTENANCE">
        {
            switch(wEcran)
            {
                case SCREENBEGINMAINTENANCE:
                {
                    switch(byKeyHit)
                    {
                        case STAR:
                        {
                            //vReset();
                            vReturnFromTest();
                            break;
                        }
                        case SHARP:
                        {
                            //wEcran = SCREENMAINMAINTENANCE;
                            wEcran = SCREENREQUESTPW;
                            dwValue = 0;
                            boReturnMaintenance = TRUE;
                            ptrParameterMenu = &dwValue;
                            break;
                        }
                        default:
                        {
                            break;
                        }
                    }
                    break;
                }
                case SCREENMAINMAINTENANCE:
                {
                    vScreenMainMaintenance(byKeyHit);
                    break;
                }
                case SCREENCONFIGURATION:
                {
                    vScreenConfiguration(byKeyHit);
                    break;
                }
                case SCREENPERIPHERIQUE:
                {
                    vConfigDevices(byKeyHit);
                    break;
                }
                case SCREENBILLVALIDATOR:
                case SCREENCHANGEGIVER:
                {
                    vScreenCashDevice(byKeyHit);
                    break;
                }
                case SCREENCASHLESS:
                {
                    vScreenCashLess(byKeyHit);
                    break;
                }
                case SCREENSATELLITE:
                {
                    vScreenSatellite(byKeyHit);
                    break;
                }
                case SCREENNOMODULE:
                {
                    wEcran = SCREENSATELLITE;
                    boReturnMaintenance = TRUE;
                    ptrParameterMenu = NULL;
                    break;
                }
                case SCREENDATETIME:
                {
                    vScreenDateTime(byKeyHit);
                    break;
                }
                case SCREENMODIFNUMMACHINE:
                {
                    sender = MODIFMACHINES;
                    vSelectMachine(byKeyHit);
                    break;
                }
                case SCREENNUMMACHINE:
                {
                    sender = MANUALMACHINE;
                    vSelectMachine(byKeyHit);
                    break;
                }
                case SCREENREFMACHINE:
                {
                    sender = REFMACHINE;
                    vSelectMachine(byKeyHit);
                    break;
                }
                case SCREENSATELLITEREMOVE:
                {
                    sender = REMOVESATELLITE;
                    vSelectMachine(byKeyHit);
                    break;
                }
                case SCREENPRICECASH:
                case SCREENPRICECASHLESS:
                case SCREENPRICECASH_HH:
                case SCREENPRICECASHLESS_HH:
                case SCREENEXACTCHANGE:
                {
                    vSetPrice(byKeyHit);
                    break;
                }
                case SCREENPULSE:
                case SCREENOVERBUSY:
                case SCREENTO_KBD:
                case SCREENTOCUMUL:
                case SCREENTO_OVERPAY:
                case SCREENMESSAGEDELAY:
                case SCREENTIMETODSP:
                case SCREENBUSYLEVEL:
                case SCREENPWLOCALTECH:
                case SCREENPWLOCALCOMPTA:
                case SCREENPWHTTPTECH:
                case SCREENPWHTTPCOMPTA:
                case SCREENREQUESTPW:
                {
                    vSetDelay(byKeyHit);
                    break;
                }
                case SCREENBEGIN:
                case SCREENEND:
                case SCREENBEGINHH:
                case SCREENENDHH:
                {
                    vSetTime(byKeyHit);
                    break;
                }
                case SCREENDSPTIMEREMAINING:
                {
                    vScreenDspTimeRemaining(byKeyHit);
                    break;
                }
                case SCREENCUMUL:
                {
                    vScreenCumul(byKeyHit);
                    break;
                }
                case SCREENPOWER:
                {
                    vScreenPower(byKeyHit);
                    break;
                }
                case SCREENBILLACCEPTED:
                {
                    vScreenBillAccepted(byKeyHit);
                    break;
                }
                case SCREENSATELLITEREMOVECONFIRM:
                {
                    vConfirmSatelliteRemove(byKeyHit);
                    break;
                }
                case SCREENBUZZER:
                {
                    switch(byKeyHit)
                    {
                        case STAR:
                        {
                            wEcran = SCREENCONFIGURATION;
                            break;
                        }
                        case KEYNO:
                        case KEYYES:
                        {
                            vDisplayEnableChoice(byTexte[SOUND], (centralParameters.boBuzzer = (BOOL)byKeyHit));
                            DelayMs(centralParameters.lDelayDisplay);
                        }
                            /* fall through */
                        case SHARP:
                        {
                            wEcran = SCREENESCROW;
                            break;
                        }
                        default:
                        {
                            break;
                        }
                    }
                    break;
                }
                case SCREENESCROW:
                {
                    switch(byKeyHit)
                    {
                        case STAR:
                        {
                            wEcran = SCREENBUZZER;
                            break;
                        }
                        case KEYNO:
                        case KEYYES:
                        {
                            vDisplayEnableChoice(byTexte[ESCROWBILL], (centralParameters.boEscrow = (BOOL)byKeyHit));
                            DelayMs(centralParameters.lDelayDisplay);
                        }
                            /* fall through */
                        case SHARP:
                        {
                            wEcran = SCREENEXACTCHANGE;
                            dwValue = wPrice = centralParameters.wAmountExactChange;
                            ptrParameterMenu = &dwValue;
                            boReturnMaintenance = TRUE;
                            byPosNum = 0;
                            break;
                        }
                        default:
                        {
                            break;
                        }
                    }
                    break;
                }
                case SCREENAUDIT:
                {
                    switch(byKeyHit)
                    {
                        case STAR:
                        {
                            wEcran = SCREENMAINMAINTENANCE;
                            break;
                        }
                        case KEYTEMPORAIRE:
                        case KEYPERMANENT:
                        {
                            eAudit = byKeyHit;
                            wEcran++;
                            dwValue = (eAudit == TEMPORARY) ? auditData.data.dwVendCash : auditDataPermanent.data.dwVendCash;
                            ptrParameterMenu = &dwValue;
                            boReturnMaintenance = TRUE;
                            break;
                        }
                        default:
                        {
                            break;
                        }
                    }
                    break;
                }
                case SCREENVENDCASH:
                case SCREENVENDCASHLESS:
                case SCREENREVALUECAHSLESS:
                case SCREENOVERPAY:
                case SCREENAUDITREFILLING:
                case SCREENVENDUSB:
                {
                    switch(byKeyHit)
                    {
                        case STAR:
                        {
                            switch(wEcran)
                            {
                                case SCREENVENDCASHLESS:
                                {
                                    dwValue = (eAudit == TEMPORARY) ? auditData.data.dwVendCash : auditDataPermanent.data.dwVendCash;
                                    break;
                                }
                                case SCREENREVALUECAHSLESS:
                                {
                                    dwValue = (eAudit == TEMPORARY) ? auditData.data.dwVendCL : auditDataPermanent.data.dwVendCL;
                                    break;
                                }
                                case SCREENOVERPAY:
                                {
                                    dwValue = (eAudit == TEMPORARY) ? auditData.data.dwRefilling : auditDataPermanent.data.dwRevalueCL;
                                    break;
                                }
                                case SCREENAUDITREFILLING:
                                {
                                    dwValue = (eAudit == TEMPORARY) ? auditData.data.dwVendUSB : auditDataPermanent.data.dwOverPay;
                                    break;
                                }
                                case SCREENVENDUSB:
                                {
                                    dwValue = (eAudit == TEMPORARY) ? auditData.data.dwRevalueCL : auditDataPermanent.data.dwRefilling;
                                    break;
                                }
                                default:
                                {
                                    break;
                                }
                            }
                            wEcran--;
                            break;
                        }
                        case SHARP:
                        {
                            switch(wEcran)
                            {
                                case SCREENVENDCASH:
                                {
                                    dwValue = (eAudit == TEMPORARY) ? auditData.data.dwVendCL : auditDataPermanent.data.dwVendCL;
                                    break;
                                }
                                case SCREENVENDCASHLESS:
                                {
                                    dwValue = (eAudit == TEMPORARY) ? auditData.data.dwRevalueCL : auditDataPermanent.data.dwRevalueCL;
                                    break;
                                }
                                case SCREENREVALUECAHSLESS:
                                {
                                    dwValue = (eAudit == TEMPORARY) ? auditData.data.dwOverPay : auditDataPermanent.data.dwOverPay;
                                    break;
                                }
                                case SCREENOVERPAY:
                                {
                                    dwValue = (eAudit == TEMPORARY) ? auditData.data.dwRefilling : auditDataPermanent.data.dwRefilling;
                                    break;
                                }
                                case SCREENAUDITREFILLING:
                                {
                                    dwValue = (eAudit == TEMPORARY) ? auditData.data.dwVendUSB : auditDataPermanent.data.dwVendUSB;
                                    break;
                                }
                                case SCREENVENDUSB:
                                {
                                    byIndexSelectedMachine = 0X0;
                                    dwValue = 0;
                                    break;
                                }
                                default:
                                {
                                    break;
                                }
                            }
                            wEcran++;
                            ptrParameterMenu = &dwValue;
                            boReturnMaintenance = TRUE;
                            break;
                        }
                        default:
                        {
                            break;
                        }
                    }
                    break;
                }
                case SCREENMACHINES:
                {
                    switch(byKeyHit)
                    {
                        case STAR:
                        {
                            while((--byIndexSelectedMachine < MAXMACHINES) && (modules[byIndexSelectedMachine].config.byNumero > 100));
                            if(byIndexSelectedMachine >= MAXMACHINES)
                            {
                                wEcran--;
                                dwValue = (eAudit == TEMPORARY) ? auditData.data.dwOverPay : auditDataPermanent.data.dwOverPay;
                            }
                            break;
                        }
                        case SHARP:
                        {
                            byIndexSelectedMachine++;
                            break;
                        }
                        default:
                        {
                            break;
                        }
                    }
                    boReturnMaintenance = TRUE;
                    break;
                }
                case SCREENINCG:
                case SCREENOUTCG:
                case SCREENINBV:
                {
                    switch(byKeyHit)
                    {
                        case STAR:
                        {
                            if(byCashPos)
                            {
                                byCashPos--;
                            }
                            else
                            {
                                wEcran--;
                                //Récupère l'index de la dernière machine.
                                byIndexSelectedMachine = MAXMACHINES;
                                while((--byIndexSelectedMachine < MAXMACHINES) && modules[byIndexSelectedMachine].config.byNumero > 99);
                                //Récupère l'index du dernier canal utile du rendeur.
                                byCashPos = MAXCASHCHANNELS;
                                while(--byCashPos && ((changeGiverConfig.byCoinValue[byCashPos] == 0XFF) ||
                                                      (changeGiverConfig.byCoinValue[byCashPos] == 0x00)));
                                if(byIndexSelectedMachine == 0XFF)
                                {
                                    wEcran--;
                                    dwValue = (eAudit == TEMPORARY) ? auditData.data.dwOverPay : auditDataPermanent.data.dwOverPay;
                                }
                            }
                            break;
                        }
                        case SHARP:
                        {
                            ((wEcran == SCREENINBV) && (eAudit == PERMANENT) && byCashPos >= MAXNUMBERCHANNELSBV) ?
                                wEcran = SCREENMAINMAINTENANCE :
                                byCashPos < MAXCASHCHANNELS ? byCashPos++ : wEcran++;
                            break;
                        }
                        default:
                        {
                            break;
                        }
                    }
                    boReturnMaintenance = TRUE;
                    break;
                }
                case SCREENRAZAUDIT:
                {
                    switch(byKeyHit)
                    {
                        case SHARP:
                        {
                            boRAZAudit();
                        }
                            /* fall trough */
                        case STAR:
                        {
                            wEcran = SCREENAUDIT;
                            break;
                        }
                        default:
                        {
                            break;
                        }
                    }
                    break;
                }
                case SCREENHISTORIQUE:
                {
                    vScreenHistorique(byKeyHit);
                    break;
                }
                case SCREENFILLING:
                {
                    if(byKeyHit == STAR)
                    {
                        //Sauvegarde des audits.
                        auditData.data.dwRefilling += lAmountCG;
                        auditDataPermanent.data.dwRefilling += lAmountCG;
                        I2CE2promLWriteBuffer(ADDRESS_DWREFILLING, &auditData.data.dwRefilling, sizeof(auditData.data.dwRefilling));
                        I2CE2promLWriteBuffer(ADDRESS_DWREFILLING_PERMANENT, &auditDataPermanent.data.dwRefilling, sizeof(auditDataPermanent.data.dwRefilling));
                        //Sauvegarde de l'historique.
                        vSetHisto(0, 0, FILLINGOP, lAmountCG, SUCCESSFUL);
                        isFillingInProgress = FALSE;
                        //Provoquera le retour à l'écran du menu principal.
                        wEcran = SCREENMAINMAINTENANCE;
                        boEnableChanger(FALSE, &centralParameters.coinType);
                        DelayMs(10);
                    }
                    break;
                }
                default:
                {
                    break;
                }
            }
        }// </editor-fold>
        else
        {
            vSelectMachine(byKeyHit);
        }
        byKeyHit = 0;
        if(boReturnMaintenance)
        {
            vMaintenanceMenu(ptrParameterMenu);
        }
    }
}
/******************************************************************************/

/*********************************************************************
 * Function:        void vTaskPollMDB(void *pvParameter)
 *
 * PreCondition:    None
 *
 * Input:           None
 *
 * Output:          None
 *
 * Side Effects:    None
 *
 * Overview:        None
 *
 * Note:            None
 ********************************************************************/

void vTaskPollMDB(void *pvParameter)
{
    DWORD wAmountSubstract = 0;
    BYTE byMDBCLBuffer[32] = {0};
    BYTE byMDBBVBuffer[32] = {0};
    BYTE byIndex = 0, byLen = 0;
    byBeforeRetryBV = byBeforeRetryCG = byBeforeRetryCL = 0;
    boVendRequested = FALSE;
#ifndef __L_DEBUG
    DelayMs(1000);
#endif
    vEnableCashDevice(FALSE, 0XFF);
    TickType_t LastWakeTime = xTaskGetTickCount();
    for(;;)
    {

        xSemaphoreTake(semaphoreMDB, 15000);
                if(!boCashLessReseted)
                {
                    if(!byBeforeRetryCL--)
                    {
                        DelayMs(500);
                        byBeforeRetryCL = MDBRETRY + 2; //ajoute 2 pour provoquer 1 décalage.
                        boCashLessReseted = boMDBReset(centralParameters.byCLAddress);
                    }
                }
                else
                {
                    if((byLen = byMDBPoll(centralParameters.byCLAddress, byMDBCLBuffer)) > 1)
                    {
                        byIndex = 0;
                        while(byIndex < (byLen - 1))
                        {
                            switch(byMDBCLBuffer[byIndex])
                            {
                                case RSP_JUST_RESET: //00 Si le cashless un reset vient d'être effectuée,
                                {
                                    byIndex++;
                                    boCashLessReseted = boMDBSetupCLConfig(centralParameters.byCLAddress,
                                                                           &vmcConfig); //Configuration de la VMC
        
                                    break;
                                }
                                case RSP_READER_CONFIG_DATA: //01 Réponse à la configuration de la VMC
                                {
                                    byIndex += 8;
                                    memmove(&readerConfig, &byMDBCLBuffer[1], sizeof(READERConfig)); //Récupération de la configuration du cashless.
                                    wCurrencyDivider = wDecimalDivider(byDecimalPos = readerConfig.deviceConfig.byDecimalPlace);
                                    boCashLessReseted = FALSE;
                                    wmcMaxMinPrices.wMax = 0XFFFF;
                                    wmcMaxMinPrices.wMin = 0X0000;
                                    if(boMDBSetupMaxMinPrice(centralParameters.byCLAddress, &wmcMaxMinPrices))
                                    {
                                        boCashLessReseted = boMDBCLEnable(centralParameters.byCLAddress); //Fixe les prix maximum et minimum et active le lecteur.
                                    }
                                    break;
                                }
                                case RSP_DISPLAY_REQUEST: //02 Demande d'affichage. Non traité par ce software
                                {
                                    byIndex += (byLen - 1);
                                    break;
                                }
                                case RSP_BEGIN_SESSION: //03 Début d'une transaction, une sélection peut-être effectuée.
                                {
                                    byIndex += 10;
                                    boKeyPresent = TRUE; //Indique que la clé est présent sur le support.
                                    boChangeAutorized = FALSE;
                                    boRevalueRequested = FALSE;
                                    lAmountCL = byMDBCLBuffer[1] * 256 + byMDBCLBuffer[2]; //Calcul du montant de la clé sur le support
                                    dwMediaID = byMDBCLBuffer[3] * 0x1000000 +
                                        byMDBCLBuffer[4] * 0x10000 +
                                        byMDBCLBuffer[5] * 0x100 +
                                        byMDBCLBuffer[6]; //Calcul de l'identifiant unique de la clé
                                    boCashLessReseted = boMDBLimitRevalueRequest(centralParameters.byCLAddress); //Demande la limite de rechargement.
                                    //Le reste des opérations s'effectue lors de la réponse à la requête de limit.
                                    break;
                                }
                                case RSP_SESSION_CANCEL_REQUEST: //04 Demande de fin de transaction
                                {
                                    byIndex++;
                                    lAmountCL = 0;
                                    boKeyPresent = FALSE;
                                    boCashLessReseted = boMDBSessionComplete(centralParameters.byCLAddress);
                                    break;
                                }
                                case RSP_VEND_APPROVED: //05 Vente acceptée
                                {
                                    byIndex += 3;
                                    wAmountSubstract = byMDBCLBuffer[1]*256 + byMDBCLBuffer[2];
                                    lAmountToDisplay = (lAmountCL -= wAmountSubstract);
                                    if(boMDBVendSuccess(centralParameters.byCLAddress))
                                    {
                                        DelayMs(centralParameters.lDelayDisplay);
                                        vLaunchMachine(byNumMachine);
                                        auditData.data.dwVendCL += wAmountSubstract;
                                        auditDataPermanent.data.dwVendCL += wAmountSubstract;
                                        I2CE2promLWriteBuffer(ADDRESS_DWCASHLESSVEND, &auditData.data.dwVendCL, sizeof(auditData.data.dwVendCL));
                                        I2CE2promLWriteBuffer(ADDRESS_DWCASHLESSVEND_PERMANENT,
                                                              &auditDataPermanent.data.dwVendCL,
                                                              sizeof(auditDataPermanent.data.dwVendCL));
                                        //Enregistrement de la vente effectuée avec la clé dans l'historique.
                                        vSetHisto(dwMediaID, 0, PAYCASHLESS, wAmountSubstract, SUCCESSFUL);
                                        if((byIndexSelectedMachine >= MAXMACHINES))// || !modules[byIndexSelectedMachine].config.boCumulEnable)
                                        {
                                            vResetSelectMachine();
                                        }
                                    }
                                    boVendRequested = FALSE;
                                    break;
                                }
                                case RSP_VEND_DENIED: //06 Vente refusée
                                {
                                    byIndex++;
                                    LCDClear();
                                    vDisplayLCD("%s", byTexte[SALEFAILURE]);
                                    vSetHisto(dwMediaID, 0, PAYCASHLESS, 0, FAIL);
                                    DelayMs(centralParameters.lDelayDisplay);
                                    vResetSelectMachine();
                                    boVendRequested = FALSE;
                                    break;
                                }
                                case RSP_END_SESSION://07 Fin de transaction
                                {
                                    byIndex++;
                                    boKeyPresent = FALSE;
                                    vEnableCashDevice(FALSE, 0XFF);
                                    lAmountCL = 0;
                                    wKeyAmountMax = 0;
                                    vResetSelectMachine();
                                    break;
                                }
                                case RSP_CANCELLED: //08 Vente annulée
                                {
                                    byIndex++;
                                    break;
                                }
                                case RSP_PERIPHERAL_ID: //09 Identification du périphérique
                                {
                                    byIndex += sizeof(PeripheralID);
                                    memmove(&peripheralID, byMDBCLBuffer, sizeof(PeripheralID));
                                    break;
                                }
                                case RSP_MALFUNCTION_ERROR: //10 Disfonctionnement
                                {
                                    byIndex += 2;
                                    boCashLessReseted = FALSE;
                                    break;
                                }
                                case RSP_CMD_OUT_OF_SEQUENCE: //11
                                {
                                    byIndex += 2;
                                    boCashLessReseted = FALSE;
                                    break;
                                }
                                case RSP_BUSY: //12 lecteur occupé
                                {
                                    break;
                                }
                                case RSP_REVALUE_APPROVED: //13 Rechargement accepté
                                {
                                    byIndex++;
                                    boRevalueRequested = FALSE;
                                    byLCDAddressCounter = getLCDAddress();
                                    vDisplayAmount(lAmountToDisplay = (lAmountCL += lAmountInCashDispo), byTexte[INKEY], TRUE);
                                    auditData.data.dwRevalueCL += lAmountInCashDispo;
                                    I2CE2promLWriteBuffer(ADDRESS_DWCASHLESSREVALUE, &auditData.data.dwRevalueCL, sizeof(auditData.data.dwRevalueCL));
                                    auditDataPermanent.data.dwRevalueCL += lAmountInCashDispo;
                                    I2CE2promLWriteBuffer(ADDRESS_DWCASHLESSREVALUE_PERMANENT,
                                                          &auditDataPermanent.data.dwRevalueCL,
                                                          sizeof(auditDataPermanent.data.dwRevalueCL));
                                    //Enregistrement du rechargement de la clé dans l'historique.
                                    vSetHisto(dwMediaID, 0, REVALUECASHLESS, lAmountToDisplay, SUCCESSFUL);
                                    lAmountInCashDispo = lAmountCG = lAmountBV = 0;
                                    //Respositonnenment du curseur.
                                    setLCDAddressCounter(byLCDAddressCounter);
                                    LCD_CURSOR_ON();
                                    break;
                                }
                                case RSP_REVALUE_DENIED://14 Rechargement refusé
                                {
                                    byIndex++;
                                    boRevalueRequested = FALSE;
                                    vSetHisto(dwMediaID, 0, REVALUECASHLESS, lAmountInCashDispo, FAIL);
                                    break;
                                }
                                case RSP_REVALUE_LIMIT_AMOUNT://15 Recharge maximum
                                {
                                    byIndex += 3;
                                    wKeyAmountMax = byMDBCLBuffer[1] * 256 + byMDBCLBuffer[2]; //Calcul du montant maximal pouvant être enregistré dans la clé.
                                    vSetHisto(dwMediaID, 0, KEYPRESENT, lAmountCL, SUCCESSFUL);
                                    boMediaCLFull = vIsMediaFull();
                                    if(byNumMachine < 10)
                                    {
                                        vResetSelectMachine();
                                    }
                                    break;
                                }
                                default:
                                {
                                    byIndex++;
                                    break;
                                }
                            }
                        }
                        //REV 1.2.3
                        byIndex = 0;
                    }
                    boCashLessReseted = ((byLen > 0) && (byLen < 32));
                }
        
        DelayMs(10);
        if(!boChangerReseted)
        {
            if(!byBeforeRetryCG--)
            {
                byBeforeRetryCG = MDBRETRY;
                boChangerReseted = boMDBReset(CGADDRESS);
            }
        }
        else
        {
            if((byLen = byMDBPoll(CGADDRESS, byMDBCGBuffer)))
            {
                for(byIndex = 0; byIndex < byLen - 1; byIndex++)
                {
                    if(byMDBCGBuffer[byIndex] & 0b01000000)
                    {
                        if(!(byMDBCGBuffer[byIndex] & 0b00100000))
                        {
                            lAmountCG += changeGiverConfig.byCoinValue[byMDBCGBuffer[byIndex] & 0x0F] *
                                changeGiverConfig.deviceConfig.byScaleFactor;
                            //Vérifie si le mode remplissage est en cours.
                            if(wEcran == SCREENFILLING)
                            {
                                //Récupère l'index du canal de la pièce acceptée.
                                byCashPos = byMDBCGBuffer[byIndex] & 0x0F;
                                //Et le transfert comme paramètre au menu de remplissage.
                                vMaintenanceMenu(&byCashPos);
                            }
                            else
                            {
                                lAmountInCashDispo += changeGiverConfig.byCoinValue[byMDBCGBuffer[byIndex] & 0x0F] *
                                    changeGiverConfig.deviceConfig.byScaleFactor;
                                boFlip = FALSE;
                                if(!boKeyPresent)
                                {
                                    LCDClearLine(2);
                                }
                            }
                            ++auditData.data.wNumberChannelCGIn[byMDBCGBuffer[byIndex] & 0x0F];
                            I2CE2promLWriteBuffer(ADDRESS_WNUMBERCHANNELGCIN + (sizeof(WORD) * (byMDBCGBuffer[byIndex] & 0x0F)),
                                                  &auditData.data.wNumberChannelCGIn[byMDBCGBuffer[byIndex] & 0x0F], sizeof(WORD));
                            ++auditDataPermanent.data.wNumberChannelCGIn[byMDBCGBuffer[byIndex] & 0x0F];
                            I2CE2promLWriteBuffer(ADDRESS_WNUMBERCHANNELGCIN_PERMANENT + (sizeof(WORD) * (byMDBCGBuffer[byIndex] & 0x0F)),
                                                  &auditDataPermanent.data.wNumberChannelCGIn[byMDBCGBuffer[byIndex] & 0x0F],
                                                  sizeof(WORD));
                            //Enregistrement de la pièce enregistrée dans l'historique.
                            vSetHisto(0, 0, INCG, changeGiverConfig.byCoinValue[byMDBCGBuffer[byIndex] & 0x0F] *
                                      changeGiverConfig.deviceConfig.byScaleFactor, SUCCESSFUL);
                            boChangeAutorized = TRUE;
                        }
                        else
                        {
                            vSetHisto(0, 0, REFUSED, changeGiverConfig.byCoinValue[byMDBCGBuffer[byIndex] & 0x0F] *
                                      changeGiverConfig.deviceConfig.byScaleFactor, FAIL);
                        }
                        byIndex++;
                    }
                    else
                    {
                        switch(byMDBCGBuffer[byIndex])
                        {
                            case ESCROW_REQUEST:
                            {
                                boToEscrow = TRUE;
                                break;
                            }
                            case CHANGERPAYOUTBUS:
                            {
                                break;
                            }
                            case CHANGERNOCREDIT:
                            {
                                break;
                            }
                            case CHANGETUBESENSORHS:
                            {
                                break;
                            }
                            case CHANGERDOUBLECOINS:
                            {
                                break;
                            }
                            case CHANGERUNPLUGGED:
                            {
                                break;
                            }
                            case CHANGERTUBEJAM:
                            {
                                break;
                            }
                            case CHANGERROMERROR:
                            {
                                break;
                            }
                            case CHANGERROUTEERROR:
                            {
                                break;
                            }
                            case CHANGERBUSY:
                            {
                                break;
                            }
                            case JUST_RESET_CG:
                            {
                                boChangerReseted = FALSE;
                                if(boMDBSetupConfig(CGADDRESS, &changeGiverConfig, sizeof(ChangeGiverConfig)))
                                {
                                    if(changeGiverConfig.deviceConfig.byLevel > 2)
                                    {
                                        memset(&changerId, 0, sizeof(changerId));
                                        boChangerReseted = boGetMDBChangerID(&changerId) && boEnableFeature();
                                    }
                                    if(boGetMDBTubeStatus(&tubeStatus))
                                    {
                                        boChangerReseted = boEnableChanger(FALSE, &centralParameters.coinType);
                                        wCurrencyDivider = wDecimalDivider(byDecimalPos = changeGiverConfig.deviceConfig.byDecimalPlace);
                                    }
                                }
                                break;
                            }
                            case COINJAM:
                            {
                                break;
                            }
                            case COINREMOVAL:
                            {
                                break;
                            }
                            default:
                            {
                                break;
                            }
                        }
                    }
                }
                //Rev 1.2.3
                byIndex = 0;
            }
            boChangerReseted = ((byLen > 0) && (byLen < 32));
        }

        DelayMs(10);
        if(!boBillValidatorReseted)
        {
            if(!byBeforeRetryBV--)
            {
                byBeforeRetryBV = MDBRETRY + 1; //Ajout 1 pour provoquer un décalage
                boBillValidatorReseted = boMDBReset(BVADDRESS);
            }
        }
        else
        {
            if((byLen = byMDBPoll(BVADDRESS, byMDBBVBuffer)))
            {
                for(byIndex = 0; byIndex < byLen - 1; byIndex++)
                {
                    if(byMDBBVBuffer[byIndex] & 0b10000000)
                    {
                        if(!(byMDBBVBuffer[byIndex] & 0b01100000))
                        {
                            isTO_KBDEnable = TRUE;
                            xTimerStart(hTimerTOKBD, 10);
                            byBillNumber = byMDBBVBuffer[byIndex] & 0X0F;
                            lAmountBV += billValidatorConfig.byBillValue[byBillNumber] *
                                billValidatorConfig.wScaleFactor;
                            lAmountInCashDispo += billValidatorConfig.byBillValue[byBillNumber] *
                                billValidatorConfig.wScaleFactor;
                            boFlip = FALSE;
                            LCDClear();
                            ++auditData.data.wNumberChannelBV[byBillNumber];
                            I2CE2promLWriteBuffer(ADDRESS_WNUMBERCHANNELBV + (sizeof(WORD) * byBillNumber),
                                                  &auditData.data.wNumberChannelBV[byBillNumber], sizeof(WORD));
                            ++auditDataPermanent.data.wNumberChannelBV[byBillNumber];
                            I2CE2promLWriteBuffer(ADDRESS_WNUMBERCHANNELBV_PERMANENT + (sizeof(WORD) * byBillNumber),
                                                  &auditDataPermanent.data.wNumberChannelBV[byBillNumber], sizeof(WORD));
                            //Enregitrement du billet inséré dans l'historique.
                            vSetHisto(0, 0, INBV, billValidatorConfig.byBillValue[byBillNumber] *
                                      billValidatorConfig.wScaleFactor, SUCCESSFUL);
                            if(!centralParameters.boEscrow)
                            {
                                byBillNumber = 0XFF;
                            }
                            boChangeAutorized = TRUE;
                        }
                        byIndex++;
                    }
                    else
                    {
                        switch(byMDBBVBuffer[byIndex])
                        {
                            case JUST_RESET_BV:
                            {
                                if((boBillValidatorReseted = boMDBSetupConfig(BVADDRESS, &billValidatorConfig,
                                                                              sizeof(BillValidatorConfig))))
                                {
                                    billValidatorConfig.wScaleFactor = WORD_SWAP(billValidatorConfig.wScaleFactor);
                                    wCurrencyDivider = wDecimalDivider(byDecimalPos = billValidatorConfig.byDecimalPlace);
                                    boBillValidatorReseted = boGetMDBStackerStatus(byStacker);
                                }
                                break;
                            }
                            default:
                            {
                                break;
                            }
                        }
                    }
                }
                byIndex = 0;
            }
            boBillValidatorReseted = ((byLen > 0) && (byLen < 32));
        }
        DelayMs(10);
        xSemaphoreGive(semaphoreMDB);
        if(boToEscrow)
        {
            vEscrowRequested();
        }
        if(!byIndex) //Avant de tester le montant s'assure que toute la longueur du message retourner par un périphérique est traiter.
        {
            vCheckCashAmount();
        }
        vTaskDelayUntil(&LastWakeTime, MDBPOLLINMS);
    }
}
/******************************************************************************/

/*********************************************************************
 * Function:        void vTaskBeatingHeath(void *pvParameter)
 *
 * PreCondition:    None
 *
 * Input:           None
 *
 * Output:          None
 *
 * Side Effects:    None
 *
 * Overview:        None
 *
 * Note:            None
 ********************************************************************/
void vTaskBeatingHearth(void *pvParameter)
{
    TickType_t LastWakeTime = xTaskGetTickCount();
    for(;;)
    {
        ClearWDT();
        if(UsageMode == MODEUSER)
        {
            LEDTOGGLE(RED);
        }
        vTaskDelayUntil(&LastWakeTime, PULSE_RTOS);
    }
}
/******************************************************************************/

/*********************************************************************
 * Function:        void vTaskCheckUSB(void *pvParameter)
 *
 * PreCondition:    None
 *
 * Input:           None
 *
 * Output:          None
 *
 * Side Effects:    None
 *
 * Overview:        None
 *
 * Note:            None
 ********************************************************************/
void vTaskCheckUSB(void *pvParameter)
{
    TickInit();
    MPFSInit();
    InitAppConfig();
    StackInit();
    portTickType xLastWakeTime = xTaskGetTickCount();
    for(;;)
    {
        USBTasks();
        vProcessUSB();
        StackTask();
        StackApplications();
        vTaskDelayUntil(&xLastWakeTime, CHECKUSB);
    }
}
/******************************************************************************/

/*********************************************************************
 * Function:        void vTaskDisplayTime(void *pvParameter)
 *
 * PreCondition:    None
 *
 * Input:           None
 *
 * Output:          None
 *
 * Side Effects:    None
 *
 * Overview:        None
 *
 * Note:            None
 ********************************************************************/
void vTaskDisplayTime(void *pvParameter)
{
    TickType_t LastWakeTime = xTaskGetTickCount();
    for(;;)
    {
        if(boDisplayTime)
        {
            Now.l = RtccGetTime();
            if((byIndexSelectedMachine < MAXMACHINES) && modules[byIndexSelectedMachine].config.boDisplayedTimeRemaining &&
               modules[byIndexSelectedMachine].config.boCumulEnable)
            {
                if((lTimeRemaining = (modules[byIndexSelectedMachine].lEndActivation - lConvertTimetoMS(&Now))) < 0)
                {
                    lTimeRemaining = 0;
                }
                LCDGotoXY(30, 1);
                lTimeRemaining ? vDisplayTimeInfo(lTimeRemaining) : vDisplayLCD("%s", "   ");
            }
            else
            {

                LCDGotoXY(36, 1);
                vDisplayLCD("%02X%c%02X", Now.hour, (Now.sec % 2) ? ':' : ' ', Now.min);
                //                LCD_CURSOR_ON();
            }
            setLCDAddressCounter(byLCDAddressCounter);
        }
        vTaskDelayUntil(&LastWakeTime, DISPLAYTIMEDELAY);
    }
}
/******************************************************************************/

/*********************************************************************
 * Function:        void vTaskFlipDisplay(void *pvParameter)
 *
 * PreCondition:    None
 *
 * Input:           None
 *
 * Output:          None
 *
 * Side Effects:    None
 *
 * Overview:        None
 *
 * Note:            None
 ********************************************************************/
void vTaskFlipDisplay(void *pvParameter)
{
    BYTE byIndex;
    BYTE byX, byY;
    TickType_t LastWakeTime = xTaskGetTickCount();
    for(;;)
    {
        if(boFlip)
        {
            vTaskSuspendAll();
            LastWakeTime = xTaskGetTickCount();
            for(byIndex = 0; byIndex < LCDNUMCHAR; byIndex++)
            {
                setLCDAddressCounter(byIndex);
                byX = getLCDC();
                setLCDAddressCounter(byIndex + 0x40);
                byY = getLCDC();
                if(byX != byY)
                {
                    setLCDAddressCounter(byIndex);
                    vDisplayLCD("%c", byY);
                    setLCDAddressCounter(byIndex + 0x40);
                    vDisplayLCD("%c", byX);
                }
            }
            xTaskResumeAll();
        }
        vTaskDelayUntil(&LastWakeTime, DELAY_FLIP);
    }
}
/******************************************************************************/

/*********************************************************************
 * Function:        void vTaskChange(void *pvParameter)
 *
 * PreCondition:    None
 *
 * Input:           None
 *
 * Output:          None
 *
 * Side Effects:    None
 *
 * Overview:        None
 *
 * Note:            None
 ********************************************************************/
void vTaskDoChange(void *pvParameter)
{
    //    TickType_t LastWakeTime = xTaskGetTickCount();
    //    long lInitialAmount, lAmount;
    //    BYTE byIndex;
    //    BYTE byToBeDispensed;
    //    BYTE byLenAnswer;
    //
    //    BOOL boDispensed;
    //    for(;;)
    //    {
    //        xSemaphoreTake(semaphoreChange, portMAX_DELAY);
    //        xSemaphoreTake(semaphoreMDB, 5000);
    //        LCD_CURSOR_OFF(); //Pas de curseur.
    //        //Obtient le nombre d'unité de base en fonction du scale factor du changer.
    //        //Sauvegarde le nombre d'unité de base pour vérifier si le nombre d'unité de base distribué estt égale au nombre à distribuer.
    //        //        lInitialAmount = lAmount = lAmountInCashDispo / (boChangerReseted ? changeGiverConfig.deviceConfig.byScaleFactor : 1);
    //        lAmount = 0;
    //        if(boChangeAutorized && lAmountInCashDispo && boGetMDBTubeStatus(&tubeStatus)) //Vérifie si il y a un montant à distribuer.
    //        {
    //            boDispensed = TRUE;
    //            boChangeAutorized = FALSE;
    //            isChangeInProgress = TRUE;
    //            //Traitement pour un rendeur de niveau MDB 2
    //
    //            //Efface la ligne 1.
    //            LCDClearLine(1);
    //            //Affiche rendu en cours.
    //            vDisplayLCD("%s", byTexte[RETURN]);
    //            //Envoie la commande de distribution d'un nombre d'unité de base en mode MDB 3.
    //
    //            byIndex = MAXNUMBERCHANNELSCG;
    //            while(lAmountInCashDispo && --byIndex)
    //            {
    //                do
    //                {
    //                    if(changeGiverConfig.byCoinValue[byIndex] && (changeGiverConfig.byCoinValue[byIndex] < 255) &&
    //                       tubeStatus.byLevel[byIndex])
    //                    {
    //                        if((byToBeDispensed = (lAmountInCashDispo / changeGiverConfig.byCoinValue[byIndex])))
    //                        {
    //                            if(byToBeDispensed > 15)
    //                            {
    //                                byToBeDispensed = 15;
    //                            }
    //                            if(byToBeDispensed > tubeStatus.byLevel[byIndex])
    //                            {
    //                                byToBeDispensed = tubeStatus.byLevel[byIndex];
    //                            }
    //                            if(byToBeDispensed && (boDispenseMDBChanger(byIndex, byToBeDispensed)))
    //                            {
    //                                tubeStatus.byLevel[byIndex] -= byToBeDispensed;
    //                                lAmount += (byToBeDispensed * changeGiverConfig.byCoinValue[byIndex]);
    //                                lAmountInCashDispo -= (byToBeDispensed * changeGiverConfig.byCoinValue[byIndex]);
    //                                auditData.data.wNumberChannelCGOut[byIndex] += byToBeDispensed;
    //                                auditDataPermanent.data.wNumberChannelCGOut[byIndex] += byToBeDispensed;
    //                                I2CE2promLWriteBuffer(ADDRESS_WNUMBERCHANNELGCOUT + (sizeof(WORD) * byIndex),
    //                                                      &auditData.data.wNumberChannelCGOut[byIndex],
    //                                                      sizeof(WORD));
    //                                I2CE2promLWriteBuffer(ADDRESS_WNUMBERCHANNELGCOUT_PERMANENT + (sizeof(WORD) * byIndex),
    //                                                      &auditDataPermanent.data.wNumberChannelCGOut[byIndex],
    //                                                      sizeof(WORD));
    //                            }
    //                            if(lAmount)
    //                            {
    //                                LCDClear();
    //                                vDisplayAmount(lAmount, byTexte[RETURNED], TRUE);
    //                            }
    //                        }
    //                    }
    //                    else
    //                    {
    //                        byToBeDispensed = 0;
    //                    }
    //                }while(byToBeDispensed = 0);
    //            }
    //            if(lAmount)
    //            {
    //                do
    //                {
    //                    memset(&byMDBCGBuffer, 0xFF, sizeof(byMDBCGBuffer));
    //                    DelayMs(100);
    //                }while(!byMDBPoll(CGADDRESS, byMDBCGBuffer) ||
    //                       (byMDBCGBuffer[0] == CHANGERPAYOUTBUS));
    //            }
    //        }
    //        vDisplayAmount(lAmount, byTexte[RETURNED], TRUE);
    //        vSetHisto(0, 0, OUCG, lAmount, lAmountInCashDispo ? FAIL : SUCCESSFUL);
    //        //DelayMs(centralParameters.lDelayDisplay);
    //
    //        if(lAmountInCashDispo)
    //        {
    //            xTimerStart(hTimerTOOverpay, 1000);
    //        }
    //        isChangeInProgress = FALSE;
    //        xSemaphoreGive(semaphoreMDB);
    //        if(boFromHTTP)
    //        {
    //
    //            boChangeAutorized = FALSE;
    //            boFromHTTP = FALSE;
    //            DelayMs(centralParameters.lDelayDisplay);
    //            vResetSelectMachine();
    //        }
    //        //    vTaskDelayUntil(&LastWakeTime, DELAYCHECKCHANGE);
    //    }

    //TickType_t LastWakeTime = xTaskGetTickCount();
    long lInitialAmount, lAmount;
    BYTE byIndex, byToBeDispensed;
    BOOL boDispensed;
    for(;;)
    {
        xSemaphoreTake(semaphoreChange, portMAX_DELAY);
        xSemaphoreTake(semaphoreMDB, 1000);
        LCD_CURSOR_OFF(); //Pas de curseur.
        //Obtient le nombre d'unité de base en fonction du scale factor du changer.
        //Sauvegarde le nombre d'unité de base pour vérifier si le nombre d'unité de base distribué estt égale au nombre à distribuer.
        lInitialAmount = lAmount = lAmountInCashDispo / (boChangerReseted ? changeGiverConfig.deviceConfig.byScaleFactor : 1);

        if(boChangeAutorized && lAmount) //Vérifie si il y a un montant à distribuer.
        {
            boDispensed = TRUE;
            boChangeAutorized = FALSE;
            isChangeInProgress = TRUE;
            //Traitement pour un rendeur de niveau MDB 2
            if(changeGiverConfig.deviceConfig.byLevel > 2)
            {
                //Efface la ligne 1.
                LCDClearLine(1);
                //Affiche rendu en cours.
                vDisplayLCD("%s", byTexte[RETURN]);
                //Envoie la commande de distribution d'un nombre d'unité de base en mode MDB 3.

                while(lAmount && boDispensed)
                {
                    byToBeDispensed = (lAmount > 250) ? 250 : lAmount;
                    boDispensed = FALSE;
                    if(boAlternatePayout(byToBeDispensed))
                    {
                        //Création d'un tableau qui contiendra le nombre de pièces de chaque type distribué.
                        do
                        {
                            //S'asure que les autres opérations MDB sont terminées.
                            DelayMs(MDBPOLLINMS);
                            ClearWDT();
                        }while(!boPayoutStatus(byCoinsBuffer));

                        for(byIndex = 0; byIndex < MAXNUMBERCHANNELSCG; byIndex++)
                        {
                            if((changeGiverConfig.byCoinValue[byIndex] < 0xFF) && byCoinsBuffer[byIndex])
                            {
                                auditData.data.wNumberChannelCGOut[byIndex] += byCoinsBuffer[byIndex];
                                I2CE2promLWriteBuffer(ADDRESS_WNUMBERCHANNELGCOUT + (sizeof(WORD) * byIndex),
                                                      &auditData.data.wNumberChannelCGOut[byIndex],
                                                      sizeof(WORD));
                                auditDataPermanent.data.wNumberChannelCGOut[byIndex] += byCoinsBuffer[byIndex];
                                I2CE2promLWriteBuffer(ADDRESS_WNUMBERCHANNELGCOUT_PERMANENT + (sizeof(WORD) * byIndex),
                                                      &auditDataPermanent.data.wNumberChannelCGOut[byIndex],
                                                      sizeof(WORD));
                                lAmount -= (byCoinsBuffer[byIndex] * changeGiverConfig.byCoinValue[byIndex]);
                                if((byCoinsBuffer[byIndex] * changeGiverConfig.byCoinValue[byIndex]) > 0)
                                {
                                    boDispensed = TRUE;
                                }
                            }
                        }
                    }
                   // DelayMs(500);
                }
            }
            if(lAmountInCashDispo)
            {
                lAmountInCashDispo -= (lInitialAmount - lAmount) * changeGiverConfig.deviceConfig.byScaleFactor;
            }
            //Par sécurité.
            if(lAmountInCashDispo < 0)
            {
                lAmountInCashDispo = 0;
            }
            vDisplayAmount(lInitialAmount - lAmount, byTexte[RETURNED], TRUE);
            vSetHisto(0, 0, OUCG, lInitialAmount - lAmount, lAmountInCashDispo ? FAIL : SUCCESSFUL);
            //DelayMs(centralParameters.lDelayDisplay);
        }
        if(lAmountInCashDispo)
        {
            xTimerStart(hTimerTOOverpay, 1000);
        }
        xSemaphoreGive(semaphoreMDB);
        isChangeInProgress = FALSE;
        if(boFromHTTP)
        {
            boChangeAutorized = FALSE;
            boFromHTTP = FALSE;
            DelayMs(centralParameters.lDelayDisplay);
            vResetSelectMachine();
        }
        //        vTaskDelayUntil(&LastWakeTime, DELAYCHECKCHANGE);    
    }
}
/******************************************************************************/

/*********************************************************************
 * Function:        void vTaskTest(void *pvParameter)
 *
 * PreCondition:    None
 *
 * Input:           None
 *
 * Output:          None
 *
 * Side Effects:    None
 *
 * Overview:        None
 *
 * Note:            None
 ********************************************************************/
void vTaskTest(void *pvParameter)
{
    for(;;)
    {
        xSemaphoreTake(semaphoreTest, portMAX_DELAY);
        boDisplayTime = FALSE;
        boFlip = FALSE;
        LEDON(RED);
        LCD_CURSOR_OFF();
        DelayMs(200);
        LCDClear();
        vDisplayLCD("%s: ", byTexte[TEST_START_OP]);
        sprintf(byBuffer, "%s %s", byTexte[EXIT], byTexte[CONTINUE]);
        vDisplayLCD("%20s", byBuffer);
        UsageMode = MODEMAINTENANCE;
    }
}
/******************************************************************************/

/*********************************************************************
 * Function:        void vTaskCheckDST(void *pvParameter)
 *
 * PreCondition:    None
 *
 * Input:           None
 *
 * Output:          None
 *
 * Side Effects:    None
 *
 * Overview:        None
 *
 * Note:            None
 ********************************************************************/
void vTaskCheckDST(void *pvParameter)
{
    rtccDate date;
    for(;;)
    {
        xSemaphoreTake(semaphoreDST, portMAX_DELAY);
        Today.l = RtccGetDate();
        Now.l = RtccGetTime();
        if(Today.mon == 0x10)
        {
            Now.hour--;
            date = getDSTDate(((Today.year >> 4) * 10) + (Today.year & 0X0F) + 2001, SUMMER);
        }
        else
        {

            Now.hour++;
            date = getDSTDate(((Today.year >> 4) * 10) + (Today.year & 0X0F) + 2001, WINTER);
        }
        RtccSetTime(Now.l);
        RtccSetAlarmTimeDate(0x02000000, date.l);
    }
}
/******************************************************************************/

/*********************************************************************
 * Function:        void vDisplayAmount(DWORD dwAmount, const char *byText, const BOOL boDelay)
 *
 * PreCondition:    None
 *
 * Input:           None
 *
 * Output:          None
 *
 * Side Effects:    None
 *
 * Overview:        None
 *
 * Note:            None
 ********************************************************************/
void vDisplayAmount(DWORD dwAmount, const char *byText, const BOOL boDelay)
{
    boFlip = FALSE;
    boDisplayTime = FALSE;
    LCD_CURSOR_OFF();

    sprintf(byBuffer, "%s %.*f\7", byText, byDecimalPos, (double)dwAmount / wCurrencyDivider);
    vTaskSuspendAll();
    ((lAmountInCashDispo || boKeyPresent || thumbDriveAttached) && (byNumMachine < 10) &&
     (strcmp(byText, byTexte[RETURNED]) != 0)) ? LCDGotoXY(23, 1) : LCDClearLine(1);
    vDisplayLCD("%*s", boKeyPresent || thumbDriveAttached ? -17 : -20, byBuffer);
    if(strcmp(byText, byTexte[RETURNED]) && !boKeyPresent && !thumbDriveAttached &&
       !lAmountInCashDispo && !modules[byIndexSelectedMachine].config.boCumulEnable &&
       !modules[byIndexSelectedMachine].config.boDisplayedTimeRemaining &&
       !modules[byIndexSelectedMachine].config.lTimeToDisplay)
    {
        boDisplayTime = FALSE;
        LCDGotoXY(22, 1);
        vDisplayLCD("%19s", byTexte[CANCEL]);
    }
    if(boKeyPresent)
    {
        LCDClearLine(2);
        boMediaCLFull ? vWarning(byTexte[MAXI]) : vDisplayLCD("%s%9lu", byTexte[MEDIA_ID], dwMediaID); //Affiche l'identiant de la clé.
    }
    xTaskResumeAll();
    if(!boKeyPresent && !modules[byIndexSelectedMachine].config.lTimeToDisplay && boDelay)
    {

        DelayMs(centralParameters.lDelayDisplay);
    }
}
/******************************************************************************/

/*********************************************************************
 * Function:        void vTimerMachineEndPulse(const TimerHandle_t pxTimer)
 *
 * PreCondition:    None
 *
 * Input:           None
 *
 * Output:          None
 *
 * Side Effects:    None
 *
 * Overview:        None
 *
 * Note:            None
 ********************************************************************/
void vTimerMachineEndPulse(const TimerHandle_t pxTimer)
{
    BYTE byIndex;
    BYTE byLoop = 3;
    for(byIndex = 0; byIndex < MAXMACHINES; byIndex++)
    {
        if(modules[byIndex].timerActivationMachine == pxTimer)
        {
            modules[byIndex].lEndActivation = 0;
            do
            {
                boModifyMachineRelayState(modules[byIndex].config.byNumero, RELAY_OFF);
                DelayMs(10);
            }while(--byLoop && (getMachineRelayState(modules[byIndex].config.byNumero) == RELAY_ON));
            vSetHisto(0, modules[byIndex].config.byNumero, PULSE_END, 0, SUCCESSFUL);
            break;
        }
    }
}

/******************************************************************************/

void vMaintenanceMenu(void *vParameter)
{
    rtccTime time;
    BYTE byIndex;
    LCDClear();
    LCD_CURSOR_OFF();

    boFlip = FALSE;
    xTimerStop(hTimerFlip, 1000);
    switch(wEcran)
    {
        case SCREENSATELLITEREMOVECONFIRM:
        {
            vDisplayLCD("%s", byTexte[CONFIRM]);
            LCDGotoXY(20, 1);
            vDisplayLCD("%s %s", byTexte[NO], byTexte[YES]);
            break;
        }
        case SCREENMAINMAINTENANCE:
        {
            vDisplayLCD("%-20s%-20s", isConfigEnable ? byTexte[CONFIGURATION] : "", isAuditEnable && boLocalAccountantEnable ? byTexte[AUDIT] : "");
            LCDGotoXY(1, 2);
            vDisplayLCD("%s %s%s %s", isHistoEnable ? byTexte[HISTORIQUE] : "", isRefillingEnable ? "(4)" : "", isRefillingEnable ? byTexte[FILLING] : "", byTexte[EXIT]);
            break;
        }
        case SCREENCONFIGURATION:
        {
            vDisplayLCD("%s %s", byTexte[PARAMETERS], byTexte[DEVICES]);
            LCDGotoXY(1, 2);
            vDisplayLCD("%s %s %s", byTexte[SATELLITE], byTexte[DATETIME], byTexte[EXIT]);
            break;
        }
        case SCREENPERIPHERIQUE:
        {
            byCashPos = 0;
            vDisplayLCD("%-20s%-20s%-20s%-20s", boChangerReseted ? byTexte[CHANGEGIVER] : "",
                        boBillValidatorReseted ? byTexte[BILLVALIDATOR] : "",
                        byTexte[CASHLESS], byTexte[EXIT]);
            break;
        }
        case SCREENCHANGEGIVER:
        {
            vDisplayCashEnable(*(BYTE*)vParameter, (BOOL)(centralParameters.coinType.wCoinEnable & (1 << *(BYTE*)vParameter)));
            break;
        }
        case SCREENBILLVALIDATOR:
        {
            vDisplayCashEnable(*(BYTE*)vParameter, (BOOL)(centralParameters.billType.wBillEnable & (1 << *(BYTE*)vParameter)));
            break;
        }
        case SCREENCASHLESS:
        {
            vDisplayLCD("(%u)%s%X%c  ", 1, byTexte[ADDRESSMDB], CASHLESS1,
                        centralParameters.byCLAddress == CASHLESS1 ? 127 : 32);
            vDisplayLCD("(%u)%s%X%c", 2, byTexte[ADDRESSMDB], CASHLESS2,
                        centralParameters.byCLAddress == CASHLESS2 ? 127 : 32);
            LCDGotoXY(1, 2);
            vDisplayLCD("%-20s", byTexte[EXIT]);
            break;
        }
        case SCREENSATELLITE:
        {
            vDisplayLCD("%-20s%-20s", byTexte[NEWMACHINEMANUAL], byTexte[MODIFICATIONMACHINE]);
            LCDGotoXY(1, 2);
            vDisplayLCD("%s %s %s", byTexte[REMOVEMACHINE], byTexte[RETRAITAUTO],
                        byTexte[EXIT]);
            break;
        }
        case SCREENDATETIME:
        {
            RtccGetTimeDate(&Now, &Today);
            byPosNum = 0;
            vDisplayLCD("%s %02X:%02X:%02X %s %02X-%02X-%u%02X", byTexte[HEURE],
                        Now.hour, Now.min, Now.sec, byTexte[DATE], Today.mday,
                        Today.mon, 20, Today.year);
            LCDGotoXY(strlen(byTexte[HEURE]) + 2, 1);
            break;
        }
        case SCREENSATELLITEAUTO:
        {
            BYTE byNumResetMachine = 0XFF;
            LCDClear();
            vDisplayLCD("%s", byTexte[SEARCH]);
            for(byIndexSelectedMachine = 0; byIndexSelectedMachine < MAXMACHINES; byIndexSelectedMachine++)
            {
                if(modules[byIndexSelectedMachine].config.byNumero != byNumResetMachine)
                {
                    if(boSimplePoll(modules[byIndexSelectedMachine].config.byNumero))
                    {
                        LCDClearLine(1);
                        if(!boModifyMachineNumber(modules[byIndexSelectedMachine].config.byNumero, byNumResetMachine))
                        {
                            vDisplayLCD("%s %u %s", byTexte[SATELLITE],
                                        modules[byIndexSelectedMachine].config.byNumero, byTexte[MACHINEMISSING]);
                            DelayMs(centralParameters.lDelayDisplay);
                        }
                        vDisplayLCD(byTexte[REMOVED], modules[byIndexSelectedMachine].config.byNumero);
                        DelayMs(centralParameters.lDelayDisplay);
                    }
                    LCDClearLine(1);
                    vDisplayLCD("%s", byTexte[SEARCH]);
                }
                memset(&modules[byIndexSelectedMachine], 0XFF, sizeof(SMACHINE_CONFIG));
                I2CE2promLWriteBuffer(ADDRESS_MACHINES_PARAMETERS + (byIndexSelectedMachine * sizeof(SMACHINE_CONFIG)),
                                      &modules[byIndexSelectedMachine], sizeof(SMACHINE_CONFIG));
            }
            LCDClear();
            for(byIndex = 99; byIndex > 9; byIndex--)
            {
                //Contrôle tous les satellites possibles et confirme la reinitialisation
                LCDGotoXY(1, 1);
                vDisplayLCD("%s %s %u", byTexte[CHECK], byTexte[SATELLITE2], byIndex);
                if(boModifyMachineNumber(byIndex, byNumResetMachine))
                {
                    LCDGotoXY(1, 2);
                    vDisplayLCD(byTexte[MACHINEREMOVED], byIndex);
                }
                isTO_KBDEnable = TRUE;
                xTimerStart(hTimerTOKBD, 10);
            }
            wEcran = SCREENSATELLITE;
            vScreenLeave();
            break;
        }
        case SCREENREFMACHINE:
        {
            vDisplayLCD("%40s", byTexte[PASS]);
            LCDHome();
            vDisplayLCD("%s ", byTexte[REFERENCE]);
            byPosNum = 0;
            break;
        }
        case SCREENSATELLITEREMOVE:
        case SCREENSATELLITEMANUAL:
        case SCREENSATELLTIEMODIF:
        {
            vDisplayLCD("%s ", byTexte[NUMERO]);
            if(wEcran == SCREENSATELLITEMANUAL)
            {
                LCDClear();
                vDisplayLCD("%s", byTexte[SEARCH]);
                if(boSimplePoll(0XFF))
                {
                    byNumMachine = 9; //Initialise la recherche de la première machine libre.
                    do
                    {
                        byIndexSelectedMachine = byMachineExist(++byNumMachine);
                    }while((byIndexSelectedMachine < MAXMACHINES) && (byNumMachine < 100));
                    LCDClear();
                    if(byNumMachine == 100)
                    {
                        vDisplayLCD("%s", byTexte[TOOMANYMACHINE]);
                        wEcran = SCREENSATELLITE;
                    }
                    else
                    {
                        vDisplayLCD("%s ", byTexte[NUMERO]);
                        byLCDAddressCounter = getLCDAddress();
                        vDisplayLCD("%u", byNumMachine);
                        setLCDAddressCounter(byLCDAddressCounter);
                    }
                }
                else
                {
                    wEcran = SCREENNOMODULE;
                    vScreenLeave();
                }
            }
            if(wEcran != SCREENSATELLITEREMOVE && wEcran != SCREENNOMODULE)
            {
                wEcran = (wEcran == SCREENSATELLITEMANUAL) ? SCREENNUMMACHINE : SCREENMODIFNUMMACHINE;
            }
            byPosNum = 0;
            break;
        }
        case SCREENPRICECASHLESS:
        case SCREENPRICECASH:
        case SCREENPRICECASH_HH:
        case SCREENPRICECASHLESS_HH:
        case SCREENEXACTCHANGE:
        {
            byPosNum = 0;
            switch(wEcran)
            {
                case SCREENPRICECASH:
                {
                    vDisplayLCD("%s ", byTexte[PRICECASH]);
                    break;
                }
                case SCREENPRICECASHLESS:
                {
                    vDisplayLCD("%s ", byTexte[PRICECASHLESS]);
                    break;
                }
                case SCREENPRICECASH_HH:
                {
                    vDisplayLCD("%s ", byTexte[PRICECASH_HH]);
                    break;
                }
                case SCREENPRICECASHLESS_HH:
                {
                    vDisplayLCD("%s ", byTexte[PRICECASHLESS_HH]);
                    break;
                }
                case SCREENEXACTCHANGE:
                {
                    vDisplayLCD("%s ", byTexte[EXACTCHANGEAMOUNT]);
                    break;
                }
                default:
                {
                    break;
                }
            }
            byLCDAddressCounter = getLCDAddress();
            vDisplayLCD("%05.*f\7", byDecimalPos, (double)*(WORD*)vParameter / wCurrencyDivider);
            setLCDAddressCounter(byLCDAddressCounter);
            break;
        }
        case SCREENREQUESTPW:
        case SCREENPULSE:
        case SCREENOVERBUSY:
        case SCREENTO_KBD:
        case SCREENTOCUMUL:
        case SCREENTO_OVERPAY:
        case SCREENMESSAGEDELAY:
        case SCREENTIMETODSP:
        case SCREENBUSYLEVEL:
        case SCREENPWLOCALTECH:
        case SCREENPWLOCALCOMPTA:
        case SCREENPWHTTPTECH:
        case SCREENPWHTTPCOMPTA:
        {
            byPosNum = 0;
            switch(wEcran)
            {
                case SCREENPWLOCALTECH:
                {
                    vDisplayLCD("%s", byTexte[PWLOCALTECH]);
                    break;
                }
                case SCREENPWLOCALCOMPTA:
                {
                    vDisplayLCD("%s", byTexte[PWLOCALCOMPTA]);
                    break;
                }
                case SCREENPWHTTPTECH:
                {
                    vDisplayLCD("%s", byTexte[PWHTTPTECH]);
                    break;
                }
                case SCREENPWHTTPCOMPTA:
                {
                    vDisplayLCD("%s", byTexte[PWHTPPCOMPTA]);
                    break;
                }
                case SCREENPULSE:
                {
                    vDisplayLCD("%s ", byTexte[PULSEDELAY]);
                    break;
                }
                case SCREENOVERBUSY:
                {
                    vDisplayLCD("%s ", byTexte[OVERBUSY]);
                    break;
                }
                case SCREENTO_KBD:
                {
                    vDisplayLCD("%s %s ", byTexte[KBDTO], byTexte[INSECONDES]);
                    break;
                }
                case SCREENTOCUMUL:
                {
                    vDisplayLCD("%s %s ", byTexte[CUMULTO], byTexte[INSECONDES]);
                    break;
                }
                case SCREENTO_OVERPAY:
                {
                    vDisplayLCD("%s %s ", byTexte[OVERPAYTO], byTexte[INSECONDES]);
                    break;
                }
                case SCREENMESSAGEDELAY:
                {
                    vDisplayLCD("%s ", byTexte[MESSAGETO]);
                    break;
                }
                case SCREENTIMETODSP:
                {
                    vDisplayLCD("%s ", byTexte[TIMETODISPLAY]);
                    break;
                }
                case SCREENBUSYLEVEL:
                {
                    vDisplayLCD("%s", byTexte[BUSYSENSIBILITY]);
                    break;
                }
                case SCREENREQUESTPW:
                {
                    vDisplayLCD(("%s", byTexte[REQUESTPW]));
                    break;
                }
                default:
                {
                    break;
                }
            }
            byLCDAddressCounter = getLCDAddress();
            vDisplayLCD("%-10lu", *(DWORD*)vParameter);
            setLCDAddressCounter(byLCDAddressCounter);
            break;
        }
        case SCREENBEGIN:
        case SCREENEND:
        case SCREENBEGINHH:
        case SCREENENDHH:
        {
            byPosNum = 0;
            time = *(rtccTime*)vParameter;
            switch(wEcran)
            {
                case SCREENBEGIN:
                {
                    vDisplayLCD("%s ", byTexte[TIMESTART]);
                    break;
                }
                case SCREENEND:
                {
                    vDisplayLCD("%s ", byTexte[TIMEEND]);
                    break;
                }
                case SCREENBEGINHH:
                {
                    vDisplayLCD("%s ", byTexte[HHSTART]);
                    break;
                }
                case SCREENENDHH:
                {
                    vDisplayLCD("%s ", byTexte[HHEND]);
                    break;
                }
                default:
                {
                    break;
                }
            }
            byHour = time.hour;
            byMin = time.min;
            byLCDAddressCounter = getLCDAddress();
            vDisplayLCD("%02Xh%02X", byHour, byMin);
            setLCDAddressCounter(byLCDAddressCounter);
            byPosNum = 0;
            break;
        }
        case SCREENDSPTIMEREMAINING:
        case SCREENCUMUL:
        case SCREENPOWER:
        case SCREENBILLACCEPTED:
        {
            switch(wEcran)
            {
                case SCREENDSPTIMEREMAINING:
                {
                    vDisplayLCD("%s%8s%c", byTexte[DSPTIMEREMAINING], byTexte[DISABLE], !*(BYTE*)vParameter ? 127 : 32);
                    break;
                }
                case SCREENCUMUL:
                {
                    vDisplayLCD("%s%8s%c", byTexte[CUMUL], byTexte[DISABLE], !*(BYTE*)vParameter ? 127 : 32);
                    break;
                }
                case SCREENPOWER:
                {
                    vDisplayLCD("%s%8s%c", byTexte[MAINPOWER], byTexte[DISABLE], !*(BYTE*)vParameter ? 127 : 32);
                    break;
                }
                case SCREENBILLACCEPTED:
                {
                    vDisplayLCD("%s%8s%c", byTexte[BILLACCEPTED], byTexte[DISABLE], !*(BYTE*)vParameter ? 127 : 32);
                    break;
                }
                default:
                {
                    break;
                }
            }
            vDisplayLCD("%8s%c", byTexte[ENABLE], *(BYTE*)vParameter ? 127 : 32);
            LCDGotoXY(1, 2);
            vDisplayLCD("(*)%-17s(#)%-17s", byTexte[BACK], byTexte[(wEcran == SCREENPOWER) ? SAVE : NEXT]);
            break;
        }
        case SCREENBUZZER:
        {
            vDisplayEnableChoice(byTexte[SOUND], centralParameters.boBuzzer);
            break;
        }
        case SCREENESCROW:
        {
            vDisplayEnableChoice(byTexte[ESCROWBILL], centralParameters.boEscrow);
            break;
        }
        case SCREENAUDIT:
        {
            vDisplayLCD("%-20s%-20s", byTexte[TEMPORARYTEXT], byTexte[PERMANENTTEXT]);
            LCDGotoXY(1, 2);
            vDisplayLCD("%s", byTexte[EXIT]);
            break;
        }
        case SCREENVENDCASH:
        case SCREENVENDCASHLESS:
        case SCREENREVALUECAHSLESS:
        case SCREENOVERPAY:
        case SCREENAUDITREFILLING:
        case SCREENVENDUSB:
        {
            vDisplayLCD("%c - ", eAudit == PERMANENT ? 'P' : 'T');
            switch(wEcran)
            {
                case SCREENVENDCASH:
                {
                    byIndex = CASHTEXT;
                    break;
                }
                case SCREENVENDCASHLESS:
                {
                    byIndex = CASHLESSTEXT;
                    break;
                }
                case SCREENREVALUECAHSLESS:
                {
                    byIndex = REVALUECASHLESSTEXT;
                    break;
                }
                case SCREENOVERPAY:
                {
                    byIndex = OVERPAYTEXTE;
                    break;
                }
                case SCREENAUDITREFILLING:
                {
                    byIndex = FILLING;
                    break;
                }
                case SCREENVENDUSB:
                {
                    byIndex = VENDUSBTEXT;
                    break;
                }
                default:
                {
                    break;
                }
            }
            vDisplayLCD("%s: %.*f\7", byTexte[byIndex], byDecimalPos, (double)(*(DWORD*)vParameter) / wCurrencyDivider);
            LCDGotoXY(1, 2);
            vDisplayLCD("(*)%-17s(#)%-17s", byTexte[BACK], byTexte[NEXT]);
            break;
        }
        case SCREENMACHINES:
        case SCREENINCG:
        case SCREENOUTCG:
        case SCREENINBV:
        {
            if((byIndexSelectedMachine > MAXMACHINES) && (wEcran == SCREENMACHINES))
            {
                wEcran = SCREENAUDITREFILLING;
                byIndexSelectedMachine = 0;
                xQueueSendToBack(queueKeyHit, &byIndex, 0);
            }
            else
            {
                vDisplayLCD("%c - ", eAudit == PERMANENT ? 'P' : 'T');
                switch(wEcran)
                {
                    case SCREENMACHINES:
                    {
                        while((byIndexSelectedMachine < MAXMACHINES) && (modules[byIndexSelectedMachine].config.byNumero > 100))
                        {
                            byIndexSelectedMachine++;
                        }
                        if(byIndexSelectedMachine < MAXMACHINES)
                        {
                            vDisplayLCD("%s %u: %u", byTexte[SERVICE], modules[byIndexSelectedMachine].config.byNumero,
                                        (eAudit == TEMPORARY) ? auditData.data.wNumberServices[byIndexSelectedMachine] :
                                        auditDataPermanent.data.wNumberServices[byIndexSelectedMachine]);
                        }
                        break;
                    }
                    case SCREENINCG:
                    case SCREENOUTCG:
                    {
                        while((byCashPos < MAXNUMBERCHANNELSCG) && ((changeGiverConfig.byCoinValue[byCashPos] == 0XFF) ||
                                                                    (changeGiverConfig.byCoinValue[byCashPos] == 0X00)))
                        {
                            byCashPos++;
                        }
                        if(byCashPos < MAXNUMBERCHANNELSCG)
                        {
                            if(wEcran == SCREENINCG)
                            {
                                vDisplayLCD(byTexte[COININ], byDecimalPos,
                                            (double)(changeGiverConfig.byCoinValue[byCashPos] * changeGiverConfig.deviceConfig.byScaleFactor) /
                                            wCurrencyDivider, (eAudit == TEMPORARY) ? auditData.data.wNumberChannelCGIn[byCashPos] :
                                            auditDataPermanent.data.wNumberChannelCGIn[byCashPos]);
                            }
                            else
                            {
                                vDisplayLCD(byTexte[COINOUT], byDecimalPos,
                                            (double)(changeGiverConfig.byCoinValue[byCashPos] * changeGiverConfig.deviceConfig.byScaleFactor) /
                                            wCurrencyDivider, (eAudit == TEMPORARY) ? auditData.data.wNumberChannelCGOut[byCashPos] :
                                            auditDataPermanent.data.wNumberChannelCGOut[byCashPos]);
                            }
                        }
                        break;
                    }
                    case SCREENINBV:
                    {
                        while((byCashPos < MAXNUMBERCHANNELSBV) && ((billValidatorConfig.byBillValue[byCashPos] == 0XFF) ||
                                                                    (billValidatorConfig.byBillValue[byCashPos] == 0X00)))
                        {
                            byCashPos++;
                        }
                        if(byCashPos < MAXNUMBERCHANNELSBV)
                        {
                            vDisplayLCD(byTexte[BILLIN], byDecimalPos,
                                        (double)(billValidatorConfig.byBillValue[byCashPos] * billValidatorConfig.wScaleFactor) /
                                        wCurrencyDivider, (eAudit == TEMPORARY) ? auditData.data.wNumberChannelBV[byCashPos] :
                                        auditDataPermanent.data.wNumberChannelBV[byCashPos]);
                        }
                        break;
                    }
                    case SCREENCUMUL:
                    {
                        vDisplayLCD("%s%8s%c", byTexte[(wEcran == SCREENBILLACCEPTED) ? CUMUL : DSPTIMEREMAINING], byTexte[DISABLE], !*(BYTE*)vParameter ? 127 : 32);
                        vDisplayLCD("%8s%c", byTexte[ENABLE], *(BYTE*)vParameter ? 127 : 32);
                        LCDGotoXY(1, 2);
                        vDisplayLCD("(*)%-17s(#)%-17s", byTexte[BACK], byTexte[NEXT]);
                        break;
                    }

                    default:
                    {
                        break;
                    }
                }
            }
            if((byCashPos < MAXCASHCHANNELS) && (byIndexSelectedMachine < MAXMACHINES))
            {
                LCDGotoXY(1, 2);
                vDisplayLCD("(*)%-17s(#)%-17s", byTexte[BACK], byTexte[NEXT]);
            }
            else
            {
                byCashPos = 0;
                byIndexSelectedMachine = 0;
                ((!isRAZEnable || (eAudit == PERMANENT)) && (wEcran == SCREENINBV)) ? wEcran = SCREENAUDIT : wEcran++;
                byIndex = 0XFF;
                xQueueSendToBack(queueKeyHit, &byIndex, 0);
            }
            break;
        }
        case SCREENRAZAUDIT:
        {
            vDisplayLCD("%s %s %s", byTexte[RAZAUDIT], byTexte[NO], byTexte[YES]);
            break;
        }
        case SCREENHISTORIQUE:
        {
            vDisplayLCD("%s", (BYTE*)vParameter);
            LCDGotoXY(1, 2);
            vDisplayLCD("(0)%s  (1)%s  %s", byTexte[BACK], byTexte[NEXT], byTexte[EXIT]);
            byIndex = 0XFF; //Empêche le délai pour l'affichage;
            break;
        }
        case SCREENFILLING:
        {
            xTimerStart(hTimerTOKBD, 1000);
            isFillingInProgress = TRUE;
            if(*(BYTE*)vParameter == 0XFF)
            {
                lAmountCG = 0;
                boEnableChanger(TRUE, &centralParameters.coinType);
                DelayMs(10);
            }
            vDisplayLCD("%s %.*f\7 %s %.*f\7", byTexte[COIN], byDecimalPos, *(BYTE*)vParameter > 0X0F ? 0 :
                        (double)(changeGiverConfig.byCoinValue[*(BYTE*)vParameter] * changeGiverConfig.deviceConfig.byScaleFactor) / wCurrencyDivider,
                        byTexte[TOTAL], byDecimalPos, (double)lAmountCG / wCurrencyDivider);
            LCDGotoXY(1, 2);
            vDisplayLCD("%s %s", byTexte[INSERTCOIN], byTexte[EXIT]);
            break;
        }

    }

    LCD_CURSOR_SET(wEcran == SCREENDATETIME ||
                   wEcran == SCREENPRICECASH ||
                   wEcran == SCREENPRICECASHLESS ||
                   wEcran == SCREENPRICECASH_HH ||
                   wEcran == SCREENNUMMACHINE ||
                   wEcran == SCREENPRICECASHLESS_HH ||
                   wEcran == SCREENEXACTCHANGE ||
                   wEcran == SCREENPULSE ||
                   wEcran == SCREENOVERBUSY ||
                   wEcran == SCREENTO_KBD ||
                   wEcran == SCREENTOCUMUL ||
                   wEcran == SCREENTO_OVERPAY ||
                   wEcran == SCREENMESSAGEDELAY ||
                   wEcran == SCREENBEGIN ||
                   wEcran == SCREENEND ||
                   wEcran == SCREENBEGINHH ||
                   wEcran == SCREENENDHH ||
                   wEcran == SCREENMODIFNUMMACHINE ||
                   wEcran == SCREENSATELLITEREMOVE ||
                   wEcran == SCREENREFMACHINE ||
                   wEcran == SCREENTIMETODSP ||
                   wEcran == SCREENBUSYLEVEL ||
                   wEcran == SCREENPWLOCALTECH ||
                   wEcran == SCREENPWLOCALCOMPTA ||
                   wEcran == SCREENPWHTTPTECH ||
                   wEcran == SCREENPWHTTPCOMPTA ||
                   wEcran == SCREENREQUESTPW);

    if(!(wEcran == SCREENSATELLITEREMOVE ||
         wEcran == SCREENDATETIME ||
         wEcran == SCREENSATELLITEAUTO ||
         wEcran == SCREENNUMMACHINE ||
         wEcran == SCREENMODIFNUMMACHINE ||
         wEcran == SCREENREFMACHINE ||
         wEcran == SCREENPRICECASHLESS ||
         wEcran == SCREENPRICECASH_HH ||
         wEcran == SCREENPRICECASHLESS_HH ||
         wEcran == SCREENEXACTCHANGE ||
         wEcran == SCREENPULSE ||
         wEcran == SCREENDSPTIMEREMAINING ||
         wEcran == SCREENOVERBUSY ||
         wEcran == SCREENTO_KBD ||
         wEcran == SCREENTOCUMUL ||
         wEcran == SCREENTO_OVERPAY ||
         wEcran == SCREENMESSAGEDELAY ||
         wEcran == SCREENBEGIN ||
         wEcran == SCREENEND ||
         wEcran == SCREENBEGINHH ||
         wEcran == SCREENENDHH ||
         wEcran == SCREENSATELLITEREMOVECONFIRM ||
         wEcran == SCREENRAZAUDIT ||
         wEcran == SCREENPRICECASH ||
         wEcran == SCREENTIMETODSP ||
         wEcran == SCREENBUSYLEVEL ||
         wEcran == SCREENPWLOCALTECH ||
         wEcran == SCREENPWLOCALCOMPTA ||
         wEcran == SCREENPWHTTPTECH ||
         wEcran == SCREENPWHTTPCOMPTA ||
         wEcran == SCREENREQUESTPW))
    {

        xTimerStart(hTimerFlip, 1000);
    }
}

/******************************************************************************/

void vDisplayEnableChoice(const char *byTexteToDisplay, const BOOL boEnable)
{

    LCDClear();
    vDisplayLCD("%s %s%c %s%c", byTexteToDisplay, byTexte[DISABLE], boEnable ? 32 : 127, byTexte[ENABLE], boEnable ? 127 : 32);
    LCDGotoXY(1, 2);
    vDisplayLCD("(*)%-17s(#)%-17s", byTexte[BACK], byTexte[NEXT]);
}

/******************************************************************************/

void vReset(void)
{
    SoftReset();
    EnableWDT();
    INTDisableInterrupts();

    while(TRUE);
}

/******************************************************************************/

void vGetParametersAudits(void)
{
    BYTE byIndex;

    I2CE2promLReadBuffer(ADDRESS_CENTRAL_PARAMETERS, &centralParameters, sizeof(centralParameters));

    if(centralParameters.byTemoin != 0X55)
    {
        centralParameters.byTemoin = 0X55;
        memset(&auditData, 0X00, sizeof(AUDITDATA));
        memset(&auditDataPermanent, 0x00, sizeof(AUDITDATA));
        if(I2CE2promLWriteBuffer(ADDRESS_DEBUT_AUDIT, &auditData, 128))
        {
            I2CE2promLWriteBuffer(ADDRESS_DEBUT_AUDIT + 128, &auditData.byAuditData[128], 128);
        }
        if(I2CE2promLWriteBuffer(ADDRESS_DEBUT_AUDIT_PERMANENT, &auditDataPermanent, 128))
        {
            I2CE2promLWriteBuffer(ADDRESS_DEBUT_AUDIT_PERMANENT + 128, &auditDataPermanent.byAuditData[128], 128);
        }

        centralParameters.boBuzzer = TRUE;
        centralParameters.boEscrow = FALSE;
        centralParameters.byCLAddress = 0X10;
        memset(&centralParameters.coinType, 0XFF, sizeof(centralParameters.coinType));
        memset(&centralParameters.billType, 0XFF, sizeof(centralParameters.billType));
        centralParameters.byKBDTO = KBDTOBYDEFAUT;
        centralParameters.byOverPayTO = OVERPAYTODEFAUT;
        centralParameters.byCumulTO = DEFAULTTOCUMUL;
        centralParameters.lDelayDisplay = DELAYDISPLAYDEFAULT;
        centralParameters.wAmountExactChange = DEFAUTAMOUNTEXACTCHANGE;
        centralParameters.passWords.localTechnician = 16383;
        centralParameters.passWords.localAccountant = 32767;
        centralParameters.passWords.httpTechnician = 16383;
        centralParameters.passWords.httpAccountant = 32767;
        I2CE2promLWriteBuffer(ADDRESS_CENTRAL_PARAMETERS, &centralParameters, sizeof(centralParameters));
        I2CE2promLReadBuffer(ADDRESS_CENTRAL_PARAMETERS, &centralParameters, sizeof(centralParameters));
    }
    if(centralParameters.byCumulTO == 0)
    {
        centralParameters.byCumulTO = DEFAULTTOCUMUL;
        I2CE2promLWriteBuffer(ADDRESS_CENTRAL_PARAMETERS, &centralParameters, sizeof(centralParameters));
    }
    //I2CE2promLReadBuffer(ADDRESS_DWCASHLESSVEND, &auditData.data.dwVendCL, 4);
    if(I2CE2promLReadBuffer(ADDRESS_DEBUT_AUDIT, auditData.byAuditData, 128))
    {
        I2CE2promLReadBuffer(ADDRESS_DEBUT_AUDIT + 128, &auditData.byAuditData[128], 128);
    }
    if(I2CE2promLReadBuffer(ADDRESS_DEBUT_AUDIT_PERMANENT, auditDataPermanent.byAuditData, 128))
    {
        I2CE2promLReadBuffer(ADDRESS_DEBUT_AUDIT_PERMANENT + 128, &auditDataPermanent.byAuditData[128], 128);
    }
    I2CE2promLReadBuffer(ADDRESS_HISTOEE_POINTER, &wE2OperationPos, sizeof(wE2OperationPos));
    for(byIndex = 0; byIndex < MAXMACHINES; byIndex++)
    {

        ClrWdt();
        I2CE2promLReadBuffer(ADDRESS_MACHINES_PARAMETERS + (byIndex * sizeof(SMACHINE_CONFIG)),
                             &modules[byIndex].config, sizeof(SMACHINE_CONFIG));
    }
}

/******************************************************************************/

void vTOCumul(TimerHandle_t pxTimer)
{

    isTOCumul = FALSE;
    vTOReached();
}

/******************************************************************************/

void vTOKBD(TimerHandle_t pxTimer)
{
    isTO_KBDEnable = FALSE;
    if(UsageMode == MODEMAINTENANCE)
    {

        vReturnFromTest();
    }
    vTOReached();
}

/******************************************************************************/

void vTOReached(void)
{
    if(!isTO_KBDEnable && !isTOCumul) //Vérifie qu'un autre timer n'est pas en cours.
    {
        xSemaphoreTake(semaphoreMDB, 5000);
        vEnableCashDevice(FALSE, 0XFF);
        xSemaphoreGive(semaphoreMDB);
        byIndexSelectedMachine = 0XFF;
        byNumMachine = 0;
        vResetSelectMachine();
    }
}

/******************************************************************************/

void vTimerFlip(TimerHandle_t pxTimer)
{

    boFlip = TRUE;
}

/******************************************************************************/

void vTOBuzzer()
{

    BUZZER_OFF();
}

/******************************************************************************/

/*********************************************************************
 * Function:        BYTE byCheckMachine(const BYTE byNumber)
 *
 * PreCondition:    None
 *
 * Input:           byNumber Numéro de la machine à vérifier.
 *
 * Output:          None
 *
 * Return:	    0 si la machine est disponible, sinon l'index du message à
 *		    afficher sur l'état du module.
 *
 * Side Effects:    None
 *
 * Overview:        Lit l'heure actuelle de la centrale
 *		    Vérifie si un satellite a le numéro de machine passé en
 *		    paramètre et si l'heure de sélection est autorisée.
 *		    Si non le résultat du test sera 0XFF et le numéro
 *		    du message retourné sera le résultat du test.
 *		    Si le résultat du test précédent est 0, on continue.
 *		    On habilite les système de paiement.
 *		    On accorde un délai à l'affichage du numéro de machine.
 *		    Et ensuite on affiche le prix demandé.
 *		    Le cas écheant on affiche le temps à cumuler.
 *
 * Note:            None
 ********************************************************************/
BYTE byCheckMachine(const BYTE byNumber)
{
    BYTE byResult = 0;
    Now.l = RtccGetTime();
    byResult = isMachineAvailable(&Now, byNumber);

    if(!byResult)
    {
        xSemaphoreTake(semaphoreMDB, 5000);
        vEnableCashDevice(TRUE, byIndexSelectedMachine);
        xSemaphoreGive(semaphoreMDB);
        if(sender != USER)
        {
            DelayMs(centralParameters.lDelayDisplay);
        }
        sprintf(byBuffer, "%s %u: ", byTexte[NUMMACHINE], byNumber); //, boKeyPresent ? byTexte[AMOUNT] : "");
        vDisplayAmount((lAmountToPay = lGetAmountToPay(byNumber)), byBuffer, TRUE);

        if(modules[byIndexSelectedMachine].config.boDisplayedTimeRemaining)
        {
            vDisplayLCD("%c", '+');
            vDisplayTimeInfo(modules[byIndexSelectedMachine].config.lPulseInMS);
            boDisplayTime = modules[byIndexSelectedMachine].config.boDisplayedTimeRemaining &&
                modules[byIndexSelectedMachine].config.boCumulEnable;
        }
        else
        {
            if(modules[byIndexSelectedMachine].config.lTimeToDisplay)
            {
                LCDGotoXY(25, 1);
                vDisplayTimeInfo(modules[byIndexSelectedMachine].config.lTimeToDisplay * 1000);
            }
        }
        lOldAmountInCashDispo = LONG_MAX;
    }
    else
    {

        byNumMachine = 0;
    }
    return byResult;
}

/******************************************************************************/

void vSetHisto(const DWORD dwNumMedia, const BYTE byNumMachine, const EHISTOOP histoOperation,
               const WORD wAmount, const ERESULT result)
{
    UOPERATION histoData;
    histoData.Operation = histoOperation & 0XFF;
    histoData.lKeyNumber = dwNumMedia;
    histoData.date.l = RtccGetDate();
    histoData.time.l = RtccGetTime();
    histoData.byMachine = byNumMachine;
    histoData.lAmount = wAmount;
    histoData.result = result & 0xFF;
    //Definit la nouvelle adresse à partir de laquelle va commencer le nouvel enregistrement.
    wE2OperationPos += sizeof(UOPERATION);
    //Vérifie que la capacité de l'eeprom n'est pas dépassée, si c'est le cas
    //effectue la rotation en fixant l'adresse au début de la sauvegarde de l'historique.
    if(wE2OperationPos < ADDRESS_HISTO)
    {

        wE2OperationPos = ADDRESS_HISTO;
    }
    //Enregistre l'opération dans l'historique.
    I2CE2promLWriteBuffer(ADDRESS_HISTOEE_POINTER, &wE2OperationPos, sizeof(wE2OperationPos));
    //Enregistre l'adresse actuelle de l'historique dans l'eeprom en cas d'extinction de la centrale.
    I2CE2promLWriteBuffer(wE2OperationPos, &histoData, sizeof(UOPERATION));
}

/******************************************************************************/

void vResetSelectMachine(void)
{
    byPosNum = 0;
    isKBDEnable = TRUE;
    DelayMs(100);
    if(isFillingInProgress && (lAmountCG > 0))
    {
        isFillingInProgress = FALSE;
        vSetHisto(0, 0, FILLINGOP, lAmountCG, SUCCESSFUL);
    };
    if(!isChangeInProgress)
    {
        byNumMachine = 0;
        isTO_KBDEnable = FALSE;
        byIndexSelectedMachine = 0xFF;
        lAmountToPay = 0;
        xTimerStop(hTimerTOKBD, 1000);
        xTimerStop(hTimerFlip, 1000);
        //DelayMs(50);
        LCDClear();
        vDisplayLCD("%s ", byTexte[SELECTION_MACHINE]);
        byLCDAddressCounter = getLCDAddress();
        if(boKeyPresent || isFileCreditPresent)
        {
            vDisplayAmount(boKeyPresent ? lAmountCL : lAmountUSBDispo, byTexte[boKeyPresent ? INKEY : CREDITINUSB], TRUE);
        }
        else
        {
            if(lAmountInCashDispo)
            {
                boDisplayTime = FALSE;
                if(centralParameters.byOverPayTO)
                {
                    xTimerStart(hTimerTOOverpay, 1000);
                    vDisplayAmount(lAmountInCashDispo, byTexte[DISPO], TRUE);
                }
                else
                {

                    vTOOverPay(NULL);
                }
            }
        }
        setLCDAddressCounter(byLCDAddressCounter);
        LCD_CURSOR_SET(!boFromHTTP);
        boCancel = boFlip = FALSE;
        boDisplayTime = (!boKeyPresent && !thumbDriveAttached && !lAmountInCashDispo);
    }
    //DisableWDT();
}

/******************************************************************************/
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
