McuMirror/CERES/SW/MainBoard.X/main.h

/**
 * \file main.h
 * \author Rachid AKKOUCHE
 */

/*Change history
 *  Rev 0.9.0a      2014 04 23
 *                  Première release fonctionnelle.
 *  Rev 0.9.1a      2014 09 22
 *                  USB
 *  Rev 0.9.2a      2014 09 25
 *                  1 - Affichage du numéro de machine à l'affichage du prix.
 *                  2 - Correction du bug concernant le blocage au cours de l'achat avec clé.
 *                  3 - Correction d'un bug d'affichage lors du retour d'une machine indisponible en présence d'une clé.
 *                  4 - Correction textes
 *                  5 - Le délai pour le trop perçu est forcé au minimum à 1 seconde pour éviter une division  par 0.
 *                  6 - Modification de l'audit en fichier.
 *                  7 - Modification du système USB pour gérer plusieurs centrales sur une clé.
 *                  8 - Amélioration de l'historique et création de l'audit en fichier.
 *                  9 - Rendu entre chaque sélection pour les machines cumulables.
 *                  10 - Vérification de la cohérence de la date.
 * Rev 0.9.3a       2014 12 05
 *                  1 - Modification de la présentation du temps sur pour le cumul et l'affichage du temps restant.
 * Rev 0.9.4a       2014 12 10
 *                  1 - Modification sur le temps de retour en mode.
 *                  2 - Modification du retour en mode utilisateur pour diminuer le temps de retour.
 *                  3 - Modification de l'historique. (Pour internet)
 *                  4 - Reset des machines en routes à la mise en route de la centrale.
 * Rev 0.9.5a       2014 12 14
 *                  1 - Correction du bug sur le retour de test.
 * Rev 0.9.6a       2014 12 15
 *                  1 - Modification de l'affichage lors du cumul des pièces.
 *                  2 - Correction du rendu lors du cumul.
 * Rev 0.9.7a       2014 12 16
 *                  1 - Suppression du curseur lors de la sélection par internet.
 *                  2 - Correction des valeurs par défaut pour les nouvelles machines.
 *                  3 - Suppression  du basculement d'écran lors de l'affichage "Sélection machine" au retour de test.
 *                  4 - Correction des valeurs par défaut des nouvelles machines.
 *                  5 - Correction Flip sortie de test.
 *                  6 - Correction du rendu pour les rendeurs MARS
 *                  7 - Modification de l'interruption du time out des réceptions séries dans le fichiers UARTLIB
 *                  8 - Ajout de l'affichage du temps accordé sur les machines sans cumul.
 * Rev 0.9.8a       2014 12 21
 *                  1 - Remise en place du buzzer.
 *                  2 - Modification des timing d'affichage.
 * Rev 0.9.9a       2015 03 20
 *                  1 - Modification internet
 * Rev 1.0.0b       2015 04 01
 *                  Première version complète beta release
 * Rev 1.0.1b       2015 04 12
 *                  Retrait du cumul sur les achats par clés et télé-activation. Usage impossible.
 * Rev 1.0.2RC      Version release candidate
 *                  2015 04 27
 *                  Modification de la gestion de l'afficheur.
 *                  Ajout de la fonction rendu par internet.
 * Rev 1.0.3RC      2015 05 17
 *                  Correction bug affichage trop perçu.
 *                  Correction bug modification du T.O. du trop perçu par internet.
 * Rev 1.0.4RC      2015 06 20
 *                  Correction d'un bug sur le rendu supérieur à 2,55 Euro
 *                  Correction d'un bug sur la saisie des montants sur les pages internet
 *                  Correction d'une régression sur le TO du clavier.
 * Rev 1.1.0RC      2015 06 10
 *                  Correction de l'overflow des timers.
 *                  Nouvelle extension des timers
 *                  Gestion de la détection de la consommation par ADC
 *                  Pilotage d'un relais d'alimentation principale de l'alimentation. Ce relais peut être utilisée à
 *                  d'autre fin.
 *                  Gestion de la détection de vide de produit.
 *                  Détail du motif d'indisponibilité du satellite.
 *                  Correction d'un bug sur le timing d'activation des machines par ethernet.
 * Rev 1.1.1RC      2015 06 23
 *                  Extension du tas du display flip.
 * Rev 1.1.2        2015 07 05
 *                  Correction du problème de watchdog
 * Rev 1.1.3        2015 08 21
 *                  Correction sur le délai du délai de cumul qui est fixé à 30 secondes si égale à 0.
 *                  Les timers freertos ne peuvent plus être fixé à zéro.
 * Rev 1.2.0        2015 08 22
 *                  Augmentation du TO du watchdog.
 *                  Mise en place des passwords pour accéder aux paramétrages et audits par la centrale.
 *                  Mise en place des passwords pour accéder aux paramétrages et audits par internet.
 *                  Suppression des canaux non utilisés dans l'audit par internet.
 *                  Extension du nombre de ligne du tableau de l'historique sur internet.
 *                  Mise en place d'un paramètre permettant l'utilisation ou non des billets pour chaque machine.  
 *                  Correction de l'enregistrement de l'historique à l'activation de la machine.
 *                  Correction du texte de fin activation.                
 * Rev 1.2.1        2015 10 10
 *                  Modification texte dans l'affichage de l'historique internet.
 * Rev 1.2.2        2015 10 14
 *                  Modification des fusibles du watchdog dans le programme principale et dans le  bootloader.
 * Rev 1.2.3        2015 10 25
 *                  Correction d'un bug sur la validation des moyens de paiement lors de l'initialisation des satellites.
 *                  Correction d'un bug sur le poll MDB
 * Rev 1.2.4        2015 10 28
 *                  Augmentation de la taille du tas des tâches.
 *                  Désactivation de EnableWDT.
 *                  Augmentation du délai de time out pour les fonctions JavaScript.(javascripts.js)
 * Rev 1.2.5        2015 10 29
 *                  Modification des délais internet.                  
 *                  Suppression des paramétres par défaut dans les appels newAjaxCommand.
 *                  Suppression des setTimeOut pour les commandes Ajax.
 *                  Correction d'un bug sur la liste des machines dans le paramétrage par internet.
 * Rev 1.2.6        2015 11 05
 *                  Correction d'un bug de saisie des nombres sans les paramètres.
 *                  Affichage de nombre négatif sur le rendu dans l'historique internet.
 *                  Modification de la priorité du battement de la led.
 *                  Synchronisation de la fonction newAjaxCommand de l'historique sur internet pour éviter les décalages.
 *                  Sur l'historique les entrées avec un mot de passe erroné sont indiquées.
 *                  Modification des priorités des tâches pour éviter les problèmes de trop perçu.
 * Rev 1.2.7        2015 11 11
 *                  Modification de la synchronisation des requêtes Ajax pour les historiques et pour l'usage des machines.
 *                  Temps minimum d'overbusy fixé à 100ms
 *                  Rendu du montant introduit en cas de non activation de la machine.
 *                  Correction de l'affichage après le time out du trop perçu.
 *                  Correction de l'affichage sur la saisie des machines en présence de trop perçu.
 *                  Correction d'un bug sur les time out en seconde lors de la modification des paramètres de la centrale par internet.
 * Rev 1.2.8        2015 11 25
 *                  Correction d'une régression qui double l'enregistrement dans l'historique de l'activation des machines.
 *                  Ajout du motif de la non-sélection dans l'historique sur internet.
 *                  Ajout du motif de la non-activation dans l'historique sur internet.
 *                  Ajout de fonctions pour vérification de l'activation des machines.
 * Rev 1.2.9        2015 12 07
 *                  Icone sur les urls.
 *                  Initialisation de la longueur de la saisie de la machine à chaque initialisation de la selection.
 *                  4 essais pour la réponse d'un module.
 *                  Modification du traitement du cumul. 
 *                  Modification de l'affichage des horaires sur les paramètres machines dû à un bug de chrome mobile.      
 * Rev 1.2.10       2015 12 20
 *                  Ajustement du tarif par internet.       
 *                  Ajout du montant à payer de la selection dans l'historique.
 *                  Supression message time out newCommandAjax.
 *                  Correction regression sur les historiques internet.
 *                  Enregistrement du remplissage en cas d'interruption de Time out
 * Rev 1.2.11       2015 12 21
 *                  Modification de l'enregistrement du fichier historique.
 *                  Correction du bug de remplissage.
 * Rev 1.2.11b      2016 01 02
 *                  Inversion des paramètres par défaut du TO cumul et TO keyboard.
 * Rev 1.2.11c      2016 02 22
 *                  Changement du timing de démarrage et du delai entre les phases de rendu.
 * Rev 1.2.12       2016 03 03
 *                  Correction du bug sur la saisie des numéros de machines.
 *                  Ajout du texte concernant l'absence du secteur sur le satellite
 *                  dans les historiques.
 * Rev 1.2.13       2016 03 13
 *                  Modification du mode de distribution, plus rapide et moins de pièces.
 *                  Correction de l'annulation
 *                  Suppression des portMax_delay
 * Rev 1.2.14       2016 04 08
 *                  Remise en place de la distribution lente.
 */
/*****************************************************************************/

#ifndef MAIN_H
#define	MAIN_H

#ifdef __L_DEBUG
static const char Version[] = "Rev 1.2.15";
#else
static const char Version[] = "Rev 1.2.15";
#endif

#define Rev114

#include <plib.h>
#include <stddef.h>
#include <GenericTypeDefs.h>
#include <limits.h>
//#include "FreeRTOSConfig.h"
#include <FreeRtos.h>
#include <task.h>
#include <queue.h>
#include <semphr.h>
#include "RAdefine.h"
#include "MDB.h"
#include "mdb_bv.h"
#include "mdb_cg.h"
#include "commun.h"
#include "mdb_cl.h"
#include "textes.h"
#include "parametres.h"
#include "lcd4u.h"
#include "I2CE2PROML.h"
#include "UARTLib.h"
#include "HexKeyboard.h"
#include "satellites.h"
#include "datetime.h"
#include "USB/usb.h"
#include "USB/usb_host_msd.h"
#include "USB/usb_host_msd_scsi.h"
#include "MDD File System/FSIO.h"
#include "TCPIP Stack/TCPIP.h"
#include "TCPIP Stack/Delay.h"
#include "global.h"
#include "code.h"
#include "exception.h"
#include "password.h"

/******************************************************************************/

//#ifdef __L_DEBUG

// PIC32MX795F512L Configuration Bit Settings

// DEVCFG3
// USERID = No Setting
#pragma config FSRSSEL = PRIORITY_7     // SRS Select (SRS Priority 7)
#pragma config FMIIEN = OFF             // Ethernet RMII/MII Enable (MII Enabled)
#pragma config FETHIO = OFF             // Ethernet I/O Pin Select (Default Ethernet I/O)
#pragma config FCANIO = OFF             // CAN I/O Pin Select (Default CAN I/O)
#pragma config FUSBIDIO = ON            // USB USID Selection (Controlled by the USB Module)
#pragma config FVBUSONIO = ON           // USB VBUS ON Selection (Controlled by USB Module)

// DEVCFG2
#pragma config FPLLIDIV = DIV_2         // PLL Input Divider (2x Divider)
#pragma config FPLLMUL = MUL_20         // PLL Multiplier (20x Multiplier)
#pragma config UPLLIDIV = DIV_2         // USB PLL Input Divider (1x Divider)
#pragma config UPLLEN = ON              // USB PLL Enable (Enabled)
#pragma config FPLLODIV = DIV_1         // System PLL Output Clock Divider (PLL Divide by 1)

// DEVCFG1
#pragma config FNOSC = PRIPLL           // Oscillator Selection Bits (Primary Osc w/PLL (XT+,HS+,EC+PLL))
#pragma config FSOSCEN = ON             // Secondary Oscillator Enable (Enabled)
#pragma config IESO = ON                // Internal/External Switch Over (Enabled)
#pragma config POSCMOD = XT             // Primary Oscillator Configuration (HS osc mode)
#pragma config OSCIOFNC = OFF           // CLKO Output Signal Active on the OSCO Pin (Enabled)
#pragma config FPBDIV = DIV_1           // Peripheral Clock Divisor (Pb_Clk is Sys_Clk/1)
#pragma config FCKSM = CSECME           // Clock Switching and Monitor Selection (Clock Switch Enable, FSCM Enabled)
#pragma config WDTPS = PS262144          // Watchdog Timer Postscaler (1:1)

//Version 1.2.2
#pragma config FWDTEN = ON             // Watchdog Timer Disable (WDT Disabled (SWDTEN Bit Controls))
//-------------

// DEVCFG0
#pragma config DEBUG = OFF              // Background Debugger Enable (Debugger is disabled)
#pragma config ICESEL = ICS_PGx1        // ICE/ICD Comm Channel Select (ICE EMUC2/EMUD2 pins shared with PGC2/PGD2)
#pragma config PWP = OFF                // Program Flash Write Protect (Disable)
#pragma config BWP = OFF                // Boot Flash Write Protect bit (Protection Disabled)
#pragma config CP = OFF                 // Code Protect (Protection Disabled)

/******************************************************************************/

//#endif

/*Define***********************************************************************/

/**
 * \def DELAYRESET
 * \brief delai pour la prise en compte du clavier et MDB
 */
#define DELAYRESET 500

/**
 * \def POLLRS485
 * \brief Intervalle entre le début de chaque vérification d'un satellite
 */
#define POLLRS485 (150 * MILLISEC)

/**
 * \def PULSE_RTOS
 * \brief Intervalle entre chaque inversion de la led.
 * Ce battement indique le fonctionnement du RTOS en mode utilisateur.
 */
#define PULSE_RTOS (1000 * MILLISEC)

/**
 * \def DELAY_CHK_KBD
 * \brief délai entre chaque vérification du clavier
 */
#define DELAY_CHK_KBD (10 * MILLISEC)

/**
 * \def DISPLAYTIMEDELAY
 * \brief Delai entre chaque rafraichissement de l'heure affichée.
 */
#define DISPLAYTIMEDELAY (500 * MILLISEC)

/**
 * \def PREDELAYFLIP
 * \brief Délai avant que le flip ne soit opérationnel.
 */
#define PREDELAYFLIP (1000 * MILLISEC)

/**
 * \def TOBUZZER
 * \brief Délai de buzzer
 */
#define TOBUZZER (250 * MILLISEC)

/**
 * \def CHECKUSB
 * \brief Delai entre chaque vérification d'une présence de clé USB.
 */
#define CHECKUSB (100 * MILLISEC)

/**
 * \def BUZZER
 * \brief Port du buzzer
 */
#define BUZZER IOPORT_D, BIT_0

/**
 * \def ONBOARDBUTTON
 * \brief port du bouton sur la carte mère.
 */
#define ONBOARDBUTTON IOPORT_B, BIT_4

/**
 * \def VP
 * \brief IO utilisé pour la vérification de la présence de tension.
 */
#define VP IOPORT_B, BIT_3

/**
 * \def ResetEEprom
 * \brief IO utilisé pour la remise à zéro des données dans l'eeprom.
 */
#define ResetEEprom IOPORT_B, BIT_6

/**
 * \def W1
 * \brief IO general purpose.
 */
#define W1 IOPORT_B, BIT_2

/**
 * \def RED
 * \brief port de la led rouge.
 */
#define RED IOPORT_C, BIT_1

/**
 * \def DEFAULTDELAYBUSY
 * \brief Delay d'occupation par défaut.
 */
#define DEFAULTDELAYBUSY 6000ul

/**
 * \def DELAYOVERBUSYDEFAULT
 * \brief Temps par défaut de la suroccupation d'un satellite.
 */
#define DELAYOVERBUSYDEFAULT 90000

/**
 * \def MDBLINE
 * \brief Port utilisé par la transmission MDB
 */
#define MDBLINE IOPORT_F, BIT_8 | BIT_2

/**
 * \def RS232_2
 * \brief port série 2
 */
#define RS232_2 UART5

/**
 * \def RS485
 * \brief port 485
 */
#define RS485 UART2

/**
 * \def MDBPORT
 * \brief port série MDB
 */
#define MDBPORT UART1

/**
 * \def LEDON(COLOR)
 *\brief Allume la led dont la couleur est définie en paramètre.
 */
#define LEDON(COLOR) PORTSetBits(COLOR)

/**
 * \def LEDOFF(COLOR)
 *\brief Eteint la led dont la couleur est définie en paramètre.
 */
#define LEDOFF(COLOR) PORTClearBits(COLOR)

/**
 * \def LEDTOGGLE(COLOR)
 *\brief Inverse l'état de la led dont la couleur est définie en paramètre.
 */
#define LEDTOGGLE(COLOR) PORTToggleBits(COLOR)

/**
 * \def BUZZER_ON()
 * \brief Active le buzzer.
 */
#define BUZZER_ON() PORTSetBits(BUZZER)

/**
 * \def BUZZER_OFF()
 * \brief Desactive le buzzer.
 */
#define BUZZER_OFF() PORTClearBits(BUZZER)

/**
 * \def BUZZER_SOUND(x)
 * \brief Active ou desactive le buzzer en fonction de\b x
 */
#define BUZZER_SOUND(x) (x ? BUZZER_ON() : BUZZER_OFF())

/**
 * \def DECIMALPOS
 * \brief Position de la décimale dans un nombre flottant.
 */
#define DECIMALPOSBYDEFAULT 2

/**
 * \def KEYNAME
 * \brief Nom de volume de la clé USB
 * si le nom de volume de la clé est différent, celle-ci ne sera pas reconnue.
 */
#define KEYNAME "MDI"

/**
 * \def AUDITFILENAME
 * \brief Nom du fichier permettant ou non l'accès aux audits.
 */
#define AUDITFILENAME "AE"

/**
 * \def PARAMETREFILENAME
 * \brief Nom du fichier contenant l'autorisation d'entrée dans le menu audit.
 */
#define PARAMETREFILENAME "PA"

/**
 * \def RAZFILENAME
 * \brief Nom du fichier contenant l'autorisation d'entrée dans le menu audit.
 */
#define RAZFILENAME "RZ"

/**
 * \def REFILLINGFILENAME
 * \brief Nom du fichier contenant l'autorisation d'entrée dans le menu audit.
 */
#define REFILLINGFILENAME "RF"

/**
 * \def HISTOFILENAME
 * \brief Nom du fichier contenant l'autorisation d'entrée dans le menu audit.
 */
#define HISTOFILENAME "HE"

/**
 * \def REINICODEFILENAME
 * \brief Prefixe du nom du fichier contenant l'autorisation d'entrée dans le menu audit.
 */
#define REINICODEFILENAME "IN"

/**
 * \def CREDITFILENAME
 * \brief Prefixe du nom du fichier contenant les crédits de la clé USB.
 */
#define CREDITFILENAME "CR"

/**
 * \def SAVEAUDITENABLEFILENAME
 * \brief nom du fichier contenant l'autorisation d'effectuer une sauvegarde du fichier des audits.
 */
#define SAVEAUDITENABLEFILENAME "AF"

/**
 * \def SAVEHISTOENABLEFILENAME
 * \brief nom du fichier contenant l'autorisation d'effectuer une sauvegarde du fichier des audits.
 */
#define SAVEHISTOENABLEFILENAME "HF"

#define STACKHEARTBEATING 255
#define STACKDST 255
#define STACKMDB 2048
#define STACKKBD 2048
#define STACKTREATKEY 2048
#define STACKUSB 1024
#define STACKDSPTIME 512
#define STACKFLIP 2048
#define STACKTEST 511
#define STACKCHANGE 2048

/**Enumération*****************************************************************/

/**
 * \enum ESENDER
 * \brief Enumeration des origines de l'utilisation d'une requête.
 */
typedef enum
{
    USER, /*!< La requête est effectuée en mode user.*/
    MANUALMACHINE, /*!< La requête est effectuée en parametrage manuel d'une nouvelle machine.*/
    MODIFMACHINES, /*!< La requête est effectuée en modification d'une machine.*/
    REFMACHINE, /*! La requête est effectuée pour obtenir la machine de référente.*/
    REMOVESATELLITE, /*! La requête est effectuée pour supprimer une machine.*/
    REMOVEALLSATTELITE, /*!< La requête est effectuée pour supprimer toutes les machines.*/
    MAINMAINTENANCE, /*!< La requête est effectuée à partir du menu principal de maintenance.*/
    HISTORIQUEMENU, /*!<* La requête est effectuée à partir du menu historique.*/
} ESENDER;

/**
 * \enum EMODE
 * \brief Mode de fonctionnement du système.
 */
typedef enum
{
    MODEUSER,
    MODEMAINTENANCE
} EMODE;

/**
 * \typedef EAUDIT
 * \brief enumeration des types d'audit.
 */
typedef enum
{
    TEMPORARY,
    PERMANENT,
} EAUDIT;

/**
 * \brief Device state on the USB
 */
typedef enum
{
    INITIALIZE,
    DETACH_STATE,
    APPLICATION_ERROR,
    APPLICATION_RUNNING,
} PROCESSIOSTATE;

/**Structure*******************************************************************/

/**Variables*******************************************************************/

/**
 * \var UsageMode
 * \brief Indique si le système est en mode utilisateur ou en mode maintenance.
 */
static EMODE UsageMode = MODEUSER;

/**
 * \var semaphoreDST
 * \brief Informe le système que l'heure doit être modifié.
 */
SemaphoreHandle_t semaphoreDST;

/**
 * \var semaphoreTest
 * \brief Indique la demande d'entrée en mode test.
 */
SemaphoreHandle_t semaphoreTest;

/**
 * \var queueKeyHit
 * \brief Queue contenant le numéro de la touche utilisée.
 */
QueueHandle_t queueKeyHit;

/**
 * \var boKeyPresent
 * \brief Indique la présence d'une clé.
 */
BOOL boKeyPresent;

/**
 * \var byCashPos
 * \brief Position du canal à visualiser dans les menus de maintenance
 */
BYTE byCashPos;

/**
 * \var lAmountToPay
 * \brief Montant à payer
 */
long lAmountToPay;

/**
 * \var lAmountToDisplay
 * \brief Montant à afficher.
 */
long lAmountToDisplay;

/**
 * \var lOldAmountInCashDispo
 * \brief Montant disponible précédent.
 * Utilisé par différence pour détecter l'insertion de cash
 */
long lOldAmountInCashDispo;

/**
 * \var lAmountUSBDispo
 * \brief Montant disponible dans la clé USB.
 */
long lAmountUSBDispo;

/**
 * \var lOldAmountUSBDispo
 * \brief Sauvegarde du montant disponible dans la clé USB.
 */
long lOldAmountUSBDispo;

long lTimeRemaining;
/**
 * \var byPosNum
 * \brief Position du caractère dans la chaîne saisie.
 */
BYTE byPosNum;

/**
 * \var boDisplayTime
 * \brief Autorise l'affichage de l'heure.
 */
BOOL boDisplayTime;

/**
 * \var boFlip;
 * \brief Autorise l'échange entre la ligne 1 et la ligne 2;
 */
BOOL boFlip;

/**
 * \var byBuffer
 * \brief buffer intermédiaire pour l'affichage.
 */
char byBuffer[64];

/**
 * \var byCreditFileName
 * \brief buffer contenant le nom du fichier de crédit.
 */
char byCreditFileName[13];

/**
 * \var boCancel
 * \brief Indique que la transaction a été annulé
 */
BOOL boCancel;

/**
 * \var eAudit
 * \brief Indique le type d'audit en cours.
 */
EAUDIT eAudit;

/**
 * \fn wPrice
 * \brief Prix intérmédaire dans les saisies de prix.
 */
WORD wPrice;

/**
 * \var dwValue
 * \brief Variable temporaire contenant la valeur en cours de saisie.
 */
DWORD dwValue;

/**
 * \var byUnite
 * \brief Variable contenant le nombre d'unités d'un nombre.
 */
BYTE byUnite;

/**
 * \var byDizaine
 * \brief Variable contenant le nombre de dizaines d'un nombre.
 */
BYTE byDizaine;

/**
 * \var byCentaine
 * \brief Variable contenant le nombre de centaines d'un nombre.
 */
BYTE byCentaine;

/**
 * \var byMillier
 * \brief Variable contenant le nombre de milliers d'un nombre.
 */
BYTE byMillier;

/**
 * \var byDixMille
 * \brief Variable contenant le contenu du rang des dix milles.
 */
BYTE byDixMille;

/**
 * \var byCentMille
 * \brief Variable contenant le contenu du rang des cent mille.
 */
BYTE byCentMille;

/**
 * \var byMillion
 * \brief Variable contenant le contenu du rang des millions
 */
BYTE byMillion;

/**
 * \var byDixMillion
 * \brief Variable contenant le contenu du rang des dix millions.
 */
BYTE byDixMillion;

/**
 * \var byCentMillion
 * \brief Variable contenant le contenu du rang des cent millions.
 */
BYTE byCentMillion;

/**
 * \var byMilliard
 * \brief Variable contenant le contenu du rang des milliards
 */
BYTE byMilliard;

/**
 * \var boReturnMaintenance
 * \brief Indique si le programme doit afficher le menu de maintenance en cours.
 */
BOOL boReturnMaintenance;

/**
 * \var ptrParameterMenu
 * \brief pointeur sur le paramètre à passer à l'écran de maintenance.
 * Valeur, heure, délai...
 */
void *ptrParameterMenu;

/**
 * \var byHour
 * \brief Variable intermédaire stockant l'heure en cours de saisie.
 */
BYTE byHour;

/**
 * \var byMin
 * \brief Variable intermédiaire stockant les minute en cours de saisie.
 */
BYTE byMin;

/**
 * \var sender
 * \brief Variable permettant de connaître l'origine de la demande de selection d'une machine
 */
ESENDER sender;

/**
 * \var Today
 * \brief Variable contenant une date.
 */
rtccDate Today;

/**
 * \var boMediaCLFull
 * \brief Indique que la clé cashless présente est ne peut plus être rechargée.
 */
BOOL boMediaCLFull;

/**
 * \var boRevalueRequested
 * \brief Indique qu'une demande de recharge de la clé a été faite.
 */
BOOL boRevalueRequested;

/**
 * \var byBeforeRetryCL
 * \brief Nombre de boucle avant de réessayer d'initialiser le lecteur cashless
 */
BYTE byBeforeRetryCL;

/**
 * \var byBeforeRetryCG
 * \brief Nombre de boucle avant de réessayer d'initialiser le rendeur
 */
BYTE byBeforeRetryCG;

/**
 * \var byBeforeRetryBV
 * \brief Nombre de boucle avant de réessayer d'initialiser le lecteur de billet
 */
BYTE byBeforeRetryBV;

/**
 * \var boDisplayRemaining
 * \brief Indique si le prochain affichage du montant dispo sera le restant.
 */
BOOL boDisplayRemaining;

/**
 * \var isTO_KBDEnable
 * \brief Flag indiquant que le timer du clavier est actif
 */
BOOL isTO_KBDEnable;

/**
 * \var isTOCumul
 * \brief Flag indiquant que le timer du cumul est actif
 */
BOOL isTOCumul;

/**
 * \var isToBeOFF
 * \brief Flag indiquant que la CPU doit passer en mode SLEEP.
 */
BOOL isToBeOFF;

/**
 * \var byBillNumber
 * \brief Numéro du canal du dernier billet introduit.
 */
BYTE byBillNumber;

/**
 * \var boToEscrow
 * \brief Indique que la fonction vEscrowRequested doit être effectuée.
 */
BOOL boToEscrow;

/**
 * \var thumbDriveAttached
 * \brief Boolean indiquant si une clé usb est connectée.
 */
BOOL thumbDriveAttached;

/**
 * \var searchRec
 * \brief Structure qui contiendra les paramètres du fichier recherché.
 */
SearchRec searchRec;

/**
 * \var creditFile
 * \brief Pointeur sur la structure du fichier de crédits.
 */
FSFILE *creditFile;

/*
 * \var ProcessIOState
 * \brief Variable contenant le statut du périphérique USB.
 */
PROCESSIOSTATE ProcessIOState;

/**
 * \var isAuditEnable
 * \brief Variable indiquant que l'audit est autorisé.
 */
BOOL isAuditEnable;

/**
 * \var isConfigEnable
 * \brief Variable indiquant que le paramétrage de la centrale est autorisé
 */
BOOL isConfigEnable;

/**
 * \var isHistoEnable
 * \brief Variable indiquant que la lecture de l'historique est autorisé.
 */
BOOL isHistoEnable;

/**
 * \var isRAZEnable
 * \brief Variable indiquant que la remise à zéro des audits est autorisé.
 */
BOOL isRAZEnable;

/**
 * \var isRefillingEnable
 * \brief Variable indiquant que le refilling est autorisé.
 */
BOOL isRefillingEnable;

/**
 * \var isFileCreditPresent
 * \brief Indique qu'une clé USB est présente qu'elle contient un fichier de crédit.
 */
BOOL isFileCreditPresent;

/**
 * \var isChangeInProgress
 * \brief Indique si le rendeur effectue une opération de change.
 */
BOOL isChangeInProgress;

/**
 * \var isFillingInProgress
 * \brief Indique si le remplissage du rendeur est en cours.
 */
BOOL isFillingInProgress;

/**
 * \var hTimerTOBuzzer
 * \brief Timer du buzzer.
 */
TimerHandle_t hTimerTOBuzzer;

BOOL isKBDEnable;

BYTE byMDBCGBuffer[32] = {0};

/**
 * \var AppConfig
 * http
 * \brief Declare AppConfig structure and some other supporting stack variables
 */
APP_CONFIG AppConfig;

static unsigned short wOriginalAppConfigChecksum; /*!< Checksum of the ROM defaults for AppConfig*/



/*--------------------*/

TaskHandle_t hHeartBeating;
TaskHandle_t hDST;
TaskHandle_t hMDB;
TaskHandle_t hKeyBoard;
TaskHandle_t hTreatKey;
TaskHandle_t hUSB;
TaskHandle_t hTimeDisplay;
TaskHandle_t hFlip;
TaskHandle_t hTest;
TaskHandle_t hChange;

BYTE byCheckStack[20];

/**Prototypes******************************************************************/

BOOL boTest(BYTE byTest);

/**
 * \fn vInitialization
 * \brief Configure les périphériques du microcontroleur.
 * \details Positionne le port et éteint la led, prépare l'interruption pour le
 * bouton sur la carte positonne le port et éteint le buzzer et positionne les
 * entrées sorties du clavier.
 */
void vInitialization(void);

/**
 * \fn vInit_IO
 * \brief Initialisaiton des entrées sorties.
 */
void vInit_IO(void);

/**
 * \fn vTaskBeatingHearth
 * \brief Fait clignoter la led pour indiquer le fonctionnement de FreeRTOS.
 * @param pvParameter Paramètre obligatoire pour toutes les tâches de FreeRTOS.
 */
void vTaskBeatingHearth(void *pvParameter);

/**
 * \fn vTaskCheckKeyBoard
 * \brief Gestion des touches activées ou du bouton de test activé.
 * @param pvParameter Paramètre obligatoire pour toutes les tâches de FreeRTOS.
 */
void vTaskCheckKeyBoard(void *pvParameter);

/**
 * \fn vTaskTreatKey
 * \brief Traitement des touche du clavier.
 * @param pvParameter Paramètre obligatoire pour FREERTOS. Non utilisé dans cette fonction
 */
void vTaskTreatKey(void *pvParameter);

/**
 * \fn vScreenHistorique
 * \brief Affiche les écrans historiques.
 * \param[in] byKey Touche activé.
 */
void vScreenHistorique(const BYTE byKeyHit);

/**
 * \fn vConfirmSatelliteRemove
 * \brief Traite la touche du clavier dans l'écran de confirmation du retrait de tous les satellites.
 * \param[in] byKey Touche activé.
 */
void vConfirmSatelliteRemove(const BYTE byKey);

/**
 * \fn vTaskPollMDB
 * \brief Polling MDB
 * @param pvParameter Paramètre obligatoire pour FREERTOS. Non utilisé dans cette fonction
 */
void vTaskPollMDB(void *pvParameter);

/**
 * \fn vTaskDisplayTime
 * \brief Affiche l'heure du système;
 * @param pvParameter Paramètre obligatoire pour FREERTOS. Non utilisé dans cette fonction.
 */
void vTaskDisplayTime(void *pvParameter);

/**
 * \fn vTaskTest
 * \brief Entre en mode maintenance
 * @param pvParameter Paramètre obligatoire pour FREERTOS. Non utilisé dans cette fonction.
 */
void vTaskTest(void *pvParameter);

/**
 * \fn vTaskCheckDST
 * \brief Vérifie si l'heure d'été ou d'hiver doit être ajuster et effectue l'ajiustement le cas écheant.
 * @param pvParameter Paramètre obligatoire pour FREERTOS. Non utilisé dans cette fonction.
 */
void vTaskCheckDST(void *pvParameter);

/**
 * \fn vTaskFlipDisplay
 * \brief Echange la ligne 1 et la ligne 2 de l'afficheur.
 * @param pvParameter Paramètre obligatoire pour FREERTOS. Non utilisé dans cette fonction.
 */
void vTaskFlipDisplay(void *pvParameter);

/**
 * \fn vTaskDoChange
 * \brief Vérifie si une demande de rendu a été demandée et l'effectue si nécessaire.
 * @param pvParameter Paramètre obligatoire pour FREERTOS. Non utilisé dans cette fonction.
 */
void vTaskDoChange(void *pvParameter);

/**
 * \fn vDisplayAmount
 * \brief Affiche un montant et le texte adjacent.
 * \param[in] dwAmount Montant à afficcher.
 * \param[in] byTexte Texte précédant le montant.
 * \param[in] boDelay Indique si le montant doit rester afficher quelques instants
 */
void vDisplayAmount(DWORD dwAmount, const char *byText, const BOOL boDelay);

/**
 * \fn vTimerMachineEndCycle
 * \brief Desactive le temps d'occupation piloté.
 * \param[in] pxTimer Handle du timer d'occupation du module concerné.
 */
void vTimerMachineEndCycle(const TimerHandle_t pxTimer);

/**
 * \fn vTimerMachineEndPulse
 * \brief Fin de l'impulsion du module
 * \param[in] pxTimer Handle du timer d'impulsion du module concerné.
 */
void vTimerMachineEndPulse(const TimerHandle_t pxTimer);

/**
 * \fn vMaintenanceMenu
 * \brief Cette méthode affiche les écrans des menus en maintenance.
 * @param[in] vParameter Le paramètre transmis à l'écran le cas échéant.
 */
void vMaintenanceMenu(void *vParameter);

/**
 * \fn vDisplayEnableChoice
 * \param[in] byTexteToDisplay Texte à afficher
 * \param[in] boEnable Permet l'affichage du flag d'activation ou de desactivation.
 */
void vDisplayEnableChoice(const char *byTexteToDisplay, const BOOL boEnable);

/**
 * \fn vReset
 * \brief Effectue un soft reset.
 */
void vReset(void);

/**
 * \fn vGetParametersAudits
 * \brief Lecture des paramètres du site.
 */
void vGetParametersAudits(void);

/**
 * \fn byCheckMachine
 * \brief Vérifie si le module existe et si il est disponible
 * \param[in] byNumber Numéro de la machine à vérifier.
 * \return 0 si la machine est disponible, sinon l'index du message sur l'état du module.
 */
BYTE byCheckMachine(const BYTE byNumber);

/**
 * \fn vSetHisto
 * \brief Enregistre l'opération dans l'historique.
 * \param[in] dwNumMedia Numéro de la clé utilisé le cas échéant.
 * \param[in] byNumMachine Numéro de la machine le cas échéant.
 * \param[in] operation Type d'opéation.
 * \param[in] wAmount Montant utilisé pour l'opération.
 * \param[in] result Resultat de l'opération.
 */
void vSetHisto(const DWORD dwNumMedia, const BYTE byNumMachine, const EHISTOOP operation,
        const WORD wAmount, const ERESULT result);

/**
 * \fn vResetSelectMachine
 * \brief Positionne la machine en attende d'une descision de l'utilisateur.
 */
void vResetSelectMachine(void);

/**
 * \fn boMakeChange
 * \brief Effectue le rendu du montant indiqué.
 * \param[in] lAmount Montant à rendre.
 * \return TRUE si le montant rendu est égale au montant à rendre et si le montant à rendre est supérieur à 0.
 */
BOOL boMakeChange(long lAmount);

/**
 * \fn isExactChange
 * \brief Compare le montant contenu dans le rendeur et le montant minimum. Affiche le message d'appoint si nécessaire
 * \param[in] lAmountToCheck Montant à comparer
 */
BOOL isExactChange(const long lAmountToCheck);

/**
 * \fn isMachineAvailable
 * \brief Vérifie si la machine est disponible.
 * \param[in] time heure de la vérification.
 * \paran[in] byNumMachine Numéro du satellite à vérifier.
 * \return l'index du texte à afficher si la machine n'est pas disponible, 0XFF si aucun message n'est affiché, 0 si la machine est dipsonible.
 */
BYTE isMachineAvailable(rtccTime * time, const BYTE byNumMachine);

/**
 * \fn vLaunchMachine
 * \brief Effectue les opérations correspondant au numéro de machine.
 * \param[in] byNumSatellite Numéro de la machine à activer.
 */
void vLaunchMachine(const BYTE byNumSatellite);

/**
 * \fn vCheckCashAmount
 * \brief Vérifie le montant disponible en cash et effectue les opérations appropriées.
 */
void vCheckCashAmount(void);

/**
 * \fn vTOKBD
 * \brief Traite le time out du clavier.
 * En mode maintenance, ce time out provoque un reset.
 * En mode utilisateur, il retourne à la sélection d'une machine.
 * \param[in] xTimer paramètre nécessaire pour FreeRTOS.
 */
void vTOKBD(TimerHandle_t pxTimer);

/**
 * \fn vTOReached
 * \brief Effectue le contrôle et les opérations liées au TO du clavier ou du cumul.
 */
void vTOReached(void);

/**
 * \fn vTimerFlip
 * \Fonction autorisant le flip des lignes d'écran.
 */
void vTimerFlip(TimerHandle_t pxTimer);

/**
 * \fn vTOBuzzer
 * \brief Arrête le buzzer
 */
void vTOBuzzer();

/**
 * \fn vGetDigitNumber
 * \brief Decompose un nombre;
 * @param[in] dwNumber Le nombre à décomposer
 * @param[out] byBillion Octet qui contiendra le nombre de milliards
 * @param[out] byHundredMillion Octet qui contiendra le nombre de centaines de million.
 * @param[out] byTenMillion Octer qui contiendra le nombre de dizaines de million.
 * @param[out] byMillion Octet qui contiendra le nombre d'unités des millions.
 * @param[out] byHundredThousand Octet qui contiendra le nombre de centaines de milliers.
 * @param[out] byTenThousand Octer qui contiendra le nombre de dizaines de milliers.
 * @param[out] byThousand Octet qui contiendra le nombre des milliers.
 * @param[out] byHundred Octet qui contiendra le nombre de centaines.
 * @param[out] byDecade Octer qui contiendra le nombre de dizaines.
 * @param[out] byUnit Octet qui contiendra le nombre d'unités.
 */
void vGetDigitNumber(DWORD dwNumber,
        BYTE *byBillion, BYTE *byHundredMillion, BYTE *byTenMillion,
        BYTE *byMillion, BYTE *byHundredThousand, BYTE *byTenThousand,
        BYTE *byThousand, BYTE *byHundred, BYTE *byDecade, BYTE *byUnit);

/**
 * \fn vDisplayCashEnable
 * \brief Affiche la validation d'une denomination d'un moyen de paiement.
 * @param byIndex Index dans la liste des de'nominations
 * @param boEnable Indique si la denomination est activée ou non.
 */
void vDisplayCashEnable(BYTE byIndex, BOOL boEnable);

/**
 * \fn byGetCharUnderCursor
 * \brief Renvoie le code ascii du caractère sous le curseur.
 * @return Code ascii du caractère sous le curseur.
 */
BYTE byGetCharUnderCursor(void);

/**
 * \brief Affiche un message sur la ligne 3 de l'afficheur
 * @param byMessage Buffer du message à afficher.
 */
void vWarning(char *byMessage);

/**
 * \fn InitRS485
 * \brief Initialisation de la communication 485
 * \param[in] UART Port de communication
 * \param[in] dwSYS_FREQ Fréquence du système nécessaire pour le calcul BRG
 * \param[in] dwBAUDRATE Vitesse de transmission
 * \param[in] dataSize Nombre de bit par octet transmis
 * \param[in] parity Parité
 * \param[in] stop_bits Nombre de bit de stop
 * \param[in] DirectionPort Port utilisé pour l'IO de direction
 * \param[in] dwDirectionBit IO utilisé pour la direction.
 */
void InitRS485(const UART_MODULE UART, const DWORD dwSYS_FREQ,
        const DWORD dwBAUDRATE, const UART_LINE_CONTROL_MODE dataSize,
        const UART_LINE_CONTROL_MODE parity,
        const UART_LINE_CONTROL_MODE stop_bits, const IoPortId DirectionPort,
        DWORD dwDirectionBit);

/**
 * \brief Interroge les satellites
 * @param pvParameter Pointeur vers un éventuel paramètre (réclamé par Freertos)
 */
void vPollSatellite(void *pvParameter);

/**
 * \fn vIsMediaFull
 * \brief Vérifie si la clé est rechargeable.
 * \return TRUE si la clé est pleine.
 */
BOOL vIsMediaFull(void);

/**
 * \fn vSetDateTime
 * \brief Enregistre la date et l'heure.
 * \param[in] date Date à enregistrer au format rtcc.
 * \param[in] time Heure à enregistrer au format rtcc.
 */
void vSetDateTime(const rtccDate date, const rtccTime time);

/**
 * \fn vConfigDevices
 * \brief Traite la touche utilisée dans le menu des périphériques.
 * \param[in] byKey Numéro de la touche utilisée.
 */
void vConfigDevices(BYTE byKey);

/**
 * \fn vScreenMainMaintenance
 * \brief Traite la touche utilisée dans le menu principale de maintenance.
 * \param[in] byKey Numéro de la touche utilisée.
 */
void vScreenMainMaintenance(const BYTE byKey);

/**
 * \fn vSubParameters
 * \brief Traite la touche utilisée dans le menu configuration.
 * \param[in] byKey Numéro de la touche utilisée.
 */
void vSubParameters(BYTE byKey);

/**
 * \fn vScreenCashDevice
 * \brief Traite la touche utilisé dans l'écran de paramètrage du changeur.
 * @param[in] byKey Numéro de la touche utilisée.
 */
void vScreenCashDevice(BYTE byKey);

/**
 * \fn vScreenCashLess
 * \brief Traite la touche utilisée dans l'écran de choix de l'adresse cashless.
 * @param[in] byKey Numéro de la touche utilisée.
 */
void vScreenCashLess(BYTE byKey);

/**
 * \fn vScreenSatellite
 * \brief Traite la touche utilisée dans l'écran de choix programmation d'un satellite.
 * @param[in] byKey Numéro de la touche utilisée.
 */
void vScreenSatellite(BYTE byKey);

/**
 * \fn vScreenDateTime
 * \brief Traite la touche utilisée dans l'écran de réglage de l'horloge.
 * @param[in] byKey Numéro de la touche utilisée.
 */
void vScreenDateTime(BYTE byKey);

/**
 * \fn vScreenConfiguration
 * \brief Traite la touche utilisée dans l'écran de choix du périphérique à paramètrer.
 * @param[in] byKey Numéro de la touche utilisée.
 */
void vScreenConfiguration(BYTE byKey);

/**
 * \fn void vScreenDspTimeRemaining(BYTE byKey);
 * \brief Traite la touche utilisée dans l'écran de choix de l'affichage du temps restant
 * et enregistre les paramètres de la machine le cas échéant.
 * @param byKey Numéro de la touche utilisée.
 */
void vScreenDspTimeRemaining(BYTE byKey);

/**
 * \fn void vScreenCumul(BYTE byKey);
 * \brief Traite la touche utilisée dans l'écran de choix du cumul autorisé
 * et enregistre les paramètres de la machine le cas échéant.
 * @param byKey Numéro de la touche utilisée.
 */
void vScreenCumul(BYTE byKey);

/**
 * \fn vScreenBillAccepted
 * \brief Ecran d'autorisation de l'utilisation des billets pour payer le service
 * @param byKey Numéro de la touche utilisée.
 */
void vScreenBillAccepted(BYTE byKey);

/**
 * fn vScreenPower
 * \brief Ecran de selection de l'alimentation de la machine.
 * @param byKey Touche utilisée sur le clavier.
 */
void vScreenPower(BYTE byKey);

/**
 * \fn vSelectMachine
 * \brief Traite la touche utilisée lors de la saisie du numéro de machine
 * @param[in] byKey Touche utilisée sur le clavier.
 */
void vSelectMachine(BYTE byKeyHit);

/**
 * \fn vSelectMachineError
 * \brief Envoie un message d'erreur et active le buzzer lors d'une erreur de sélection de machine.
 * @param byMessage Message à ecrire sur l'afficheur.
 */
void vSelectMachineError(char *byMessage);

/**
 * \fn vSetPrice
 * \brief Effectuement le traitement de la touche utilisée lors de la saisie d'un prix.
 * @param[in] byKey Touche utilisée sur le clavier.
 */
void vSetPrice(BYTE byKey);

/**
 * \fn vSetDelay
 * \brief Effectuement le traitement de la touche utilisée lors de la saisie d'un délai.
 * @param[in] byKey Touche utilisée sur le clavier.
 */
void vSetDelay(BYTE byKey);

/**
 * \fn vSetTime
 * \brief Effectue le traitement de la touche utilisée lors de la saisie d'un horaire.
 * @param[in] byKey Touche utilisée sur le clavier.
 */
void vSetTime(BYTE byKey);

/**
 * \fn byMachineExist
 * \brief Recherche l'index dont le numéro est passé en paramètre.
 * @param[in] byMachine Numéro de la machine dont on recherche l'index.
 * @return L'index dans la liste des machines si le numéro de machine existe sinon MAXMACHINE.
 */
BYTE byMachineExist(const BYTE byMachine);

/**
 * \fn lGetAmountToPay
 * \brief Renvoi le montant à payer en fonction du moyen et de l'heure.
 * \param[in] byNumMachine Numéro de la machine pour laquelle on recherche le prix.
 * \return le montant à payer.
 */
long lGetAmountToPay(const BYTE byNumMachine);

/**
 * \fn vScreenLeave
 * \brief Affiche une message indiquant l'absence d'un module libre.
 */
void vScreenLeave(void);

/**
 * \fn lConvertTimetoMS
 * \brief Convertit une structure rtccTime en milliseconde.
 * \param[in] time Structure à convertir.
 * \return un long contenant l'horaire en millisecondes.
 */
long lConvertTimetoMS(const rtccTime *time);

/**
 * \fn convertLongToTime
 * \brief Convertit un long contenant un temps en milliseconde en une structure rtccTime.
 * \param[in] lMilliSeconde l'horaire en milliseconde.
 */
rtccTime convertLongToTime(long lMilliSeconde);

/**
 * \fn vSleepMCU
 * \brief Positionne le système en mode basse consomation.
 */
void vSleepMCU(void);

/**
 * \fn vEraseEEprom
 * \brief Efface le contenu de l'eeprom.
 * Les quatre derniers octets ne seront pas effacés.
 */
void vEraseEEprom(void);

/**
 * \fn vEnableCashDevice
 * \brief Active ou non les périphériques espèces.
 * \param[in] boEnable Booléen indiquant si les périphériques doivent être activés ou non
 * \param [in] byIndex index de la machine en cours.
 */
void vEnableCashDevice(const BOOL boEnable, const BYTE byIndexMachine);

/**
 * \fn vTOOverPay
 * \brief Remet à zéro le trop perçu et l'enregistre.
 * \param[in] xTimer paramètre nécessaire pour FreeRTOS.
 */
void vTOOverPay(TimerHandle_t pxTimer);

/**
 * \fn vTOCumul
 * \brief Inhibe les moyens de paiement après le délai de timer out.
 * \param[in] xTimer paramètre nécessaire pour FreeRTOS.
 */
void vTOCumul(TimerHandle_t pxTimer);

/**
 * \fn void vEscrowRequested
 * \brief Effectue le rendu des espèces insérées.
 */
void vEscrowRequested(void);

/**
 * \fn vDisplayTimeInfo
 * \brief Affiche le temps théorique affectée à une machine.
 * \param[in] Temps en milliseconde à convertir et afficher.
 */
void vDisplayTimeInfo(DWORD dwTimeInMS);

/**
 * \fn boRouteBill
 * \brief Positionne le billet actuellement en escrow.
 * \param[in] escrowDirection IN  pour encaisser le billet, OUT pour le retourner.
 */
BOOL boRouteBill(const ESCROWDIR escrowDirection);

/**
 * \fn vCheckUSB
 * \brief Vérifie si un périphérique USB est connecté.
 */
void vTaskCheckUSB(void *pvParameter/*!< Pointeur vers un éventuel paramètre. (réclamé par Freertos)*/);

/**
 * \fn vProcessUSB
 * \brief Vérification de l'activité du port USB host.
 */
void vProcessUSB(void);

/**
 * \fn vSaveAudit
 * \brief Enregistrement du fichier des audits.
 */
void vSaveAudit(void);

/**
 * \fn vSaveHisto
 * \brief Enregistre le fichier historique
 */
void vSaveHisto(void);

/**
 * \fn lGetUSBAmountOrEnable
 * \brief Lit montant contenu ou l'autorisation dans la fichier.
 * \Dans le cas d'une autorisation l'activation correspond à une valeur de 0XAA dans le byte de poids fort.
 * \param[in] fileName Nom du fichier qui contient l'information.
 * \param[in] wEEAddress Addresse dans l'eeprom de la date et l'heure du dernier accès.
 */
long lGetUSBAmountOrEnable(char *fileName, const WORD wEEAddress);

/**
 * \fn vSetUSBAmountOrEnable
 * \brief Ecrit montant contenu dans la clé.
 * Insère le code correspondant à la nouvelle heure.
 * \param[in] fileName Nom du fichier qui contient l'information.
 * \param[in] wEEAddress Addresse dans l'eeprom de la date et l'heure du dernier accès.
 * \param[in] lAmount Montant ou validation
 * \return TRUE si l'opération s'est effectuée correctement.
 */
BOOL vSetUSBAmountOrEnable(char *fileName, const WORD wEEAddress, const long lAmount);

/**
 * \fn boCheckSN
 * \brief Lit dans le fichier et vérifie le numéro de la centrale.
 */
BOOL boCheckSN(void);

/**
 * \fn boCodeCheck
 * \brief Lit et vérifie le code
 * \param[in] WeeAddress Adresse dans l'eeprom contenant la date et l'heure du dernier accès.
 */
BOOL boCodeCheck(const WORD wEEAddress);

/**
 * \fn vEnableCN
 * \brief Valide les interruption des notification de changement d'état.
 */
void vEnableCN(void);

/**
 * \fn boRAZAudit
 * \brief Remet à zéro les audits.
 * @return True si les audits sont effacés.
 */
BOOL boRAZAudit();

/**
 * \fn void vSetRndGap(void);
 * \brief Crée un nombre aléatoire de byte dans le fichier.
 * Crée aussi le code du numéro de série.
 */
void vSetRndGap(void);

/**
 * \fn vReturnFromTest
 * \brief Retourne en mode utilisateur
 */
void vReturnFromTest(void);

/**
 * \fn vStartBuzzer
 * \brief Active le buzzer
 * @param boActivel
 * @param iBuzzerLen
 */
void vStartBuzzer(BOOL boActivel, int iBuzzerLen);

/******************************************************************************/

/**
 * \fn getLCDAddress
 * \brief Récupère l'addresse actuelle du controleur d'afficheur.
 * @return Renvoi l'adresse actuelle du contrôleur.
 */
BYTE getLCDAddress(void);

/**
 * \fn vRecordMachineData
 * \brief Enregistre les données d'une machine dans l'eeprom.
 */
void vRecordMachineData();

#ifdef __L_DEBUG

/**
 * \brief Fonction appelée en cas d'echec d'allocation dans FreeRTOS.
 * \details vApplicationMallocFailedHook() will only be called if
 * configUSE_MALLOC_FAILED_HOOK is set to 1 in FreeRTOSConfig.h.  It is a hook
 * function that will get called if a call to pvPortMalloc() fails.
 * pvPortMalloc() is called internally by the kernel whenever a task, queue,
 * timer or semaphore is created.  It is also called by various parts of the
 * demo application.  If heap_1.c or heap_2.c are used, then the size of the
 * heap available to pvPortMalloc() is defined by configTOTAL_HEAP_SIZE in
 * FreeRTOSConfig.h, and the xPortGetFreeHeapSize() API function can be used
 * to query the size of free heap space that remains (although it does not
 * provide information on how the remaining heap might be fragmented).
 */
void vApplicationMallocFailedHook(void);


/******************************************************************************/
/**
 * \brief Fonction appelée en cas de pile insuffisante lors de la création d'une tâche.
 * \detail Run time task stack overflow checking is performed if
    configCHECK_FOR_STACK_OVERFLOW is defined to 1 or 2.  This hook function is
    called if a task stack overflow is detected.  Note the system/interrupt
    stack is not checked.
 * @param pxTask Handle de la tâche.
 * @param pcTaskName Nom de la tache
 */
void vApplicationStackOverflowHook(TaskHandle_t pxTask, signed char *pcTaskName);
#endif

#endif	/* MAIN_H */
