McuMirror/CERES/SW/MainBoard_v_1_3_4.X/main.c

/** ****************************************************************************
 * \file main.c
 * \brief Software de gestion de la carte CERES.
 * \details
 * \date 2013.11.30
 * \author Rachid AKKOUCHE
 *******************************************************************************/

/** ****************************************************************************
 * \mainpage DOCUMENTATION SOFTWARE
 * 
 *  <b>RASoftware</b> <BR>
 *	2 rue Georges MELIES <BR>
 *   78390 BOIS D'ARCY <BR>
 *	+33 651 60 40 47 <BR>
 *	<a href = "http://www.rasoftware.fr">http://www.rasoftware.fr </a> <BR><BR>
 *<CENTER>Copyright<b>© RASoftware</b>2013 - 2017</CENTER>  <BR>
 * 
 *  
 * The information contained here-in is the property of RASoftware and is not 
 * to be disclosed or used without the prior written permission of RASoftware. 
 * This	copyright extends to all media in which this information may be 
 * preserved including magnetic storage, computer print-out or visual 		
 * display.                                                                  
 ******************************************************************************/

#include "main.h"

/*Gestion des interruptions****************************************************/

static void __ISR(_CHANGE_NOTICE_VECTOR/*, IPL7AUTO*/) ISRChangeNotice_Handler(void)
{
    if(!PORTReadBits(VP) || !PORTReadBits(W1))
    {
        DelayMs(350);
        isToBeOFF = TRUE;
    }
    else
    {
        SoftReset();
    }
    mCNClearIntFlag();
}

/******************************************************************************/

static void __ISR(_RTCC_VECTOR/*, ipl3AUTO*/) ISRRtcc(void)
{
    BaseType_t xHigherPriorityTaskWoken = pdFALSE;
    INTClearFlag(INT_RTCC);
    xSemaphoreGiveFromISR(semaphoreDST, &xHigherPriorityTaskWoken);
}
/******************************************************************************/

/*Routines locales ************************************************************/

/*********************************************************************
 * Function:        void InitAppConfig(void)
 *
 * PreCondition:    MPFSInit() is already called.
 *
 * Input:           None
 *
 * Output:          Write/Read non-volatile config variables.
 *
 * Side Effects:    None
 *
 * Overview:        None
 *
 * Note:            None
 ********************************************************************/
// MAC Address Serialization using a MPLAB PM3 Programmer and
// Serialized Quick Turn Programming (SQTP).
// The advantage of using SQTP for programming the MAC Address is it
// allows you to auto-increment the MAC address without recompiling
// the code for each unit.  To use SQTP, the MAC address must be fixed
// at a specific location in program memory.  Uncomment these two pragmas
// that locate the MAC address at 0x1FFF0.  Syntax below is for MPLAB C
// Compiler for PIC18 MCUs. Syntax will vary for other compilers.
//#pragma romdata MACROM=0x1FFF0
static ROM BYTE SerializedMACAddress[6] = {MY_DEFAULT_MAC_BYTE1, MY_DEFAULT_MAC_BYTE2,
                                           MY_DEFAULT_MAC_BYTE3, MY_DEFAULT_MAC_BYTE4,
                                           MY_DEFAULT_MAC_BYTE5, MY_DEFAULT_MAC_BYTE6};
//#pragma romdata

static void InitAppConfig(void)
{
#if defined(EEPROM_CS_TRIS) || defined(SPIFLASH_CS_TRIS)
    unsigned char vNeedToSaveDefaults = 0;
#endif
    while(TRUE)
    {
        // Start out zeroing all AppConfig bytes to ensure all fields are
        // deterministic for checksum generation
        memset((void*)&AppConfig, 0x00, sizeof (AppConfig));

        AppConfig.Flags.bIsDHCPEnabled = TRUE;
        AppConfig.Flags.bInConfigMode = TRUE;
        memcpypgm2ram((void*)&AppConfig.MyMACAddr, (ROM void*)SerializedMACAddress, sizeof (AppConfig.MyMACAddr));

        AppConfig.MyIPAddr.Val = MY_DEFAULT_IP_ADDR_BYTE1 | MY_DEFAULT_IP_ADDR_BYTE2 << 8ul | MY_DEFAULT_IP_ADDR_BYTE3 << 16ul | MY_DEFAULT_IP_ADDR_BYTE4 << 24ul;
        AppConfig.DefaultIPAddr.Val = AppConfig.MyIPAddr.Val;
        AppConfig.MyMask.Val = MY_DEFAULT_MASK_BYTE1 | MY_DEFAULT_MASK_BYTE2 << 8ul | MY_DEFAULT_MASK_BYTE3 << 16ul | MY_DEFAULT_MASK_BYTE4 << 24ul;
        AppConfig.DefaultMask.Val = AppConfig.MyMask.Val;
        AppConfig.MyGateway.Val = MY_DEFAULT_GATE_BYTE1 | MY_DEFAULT_GATE_BYTE2 << 8ul | MY_DEFAULT_GATE_BYTE3 << 16ul | MY_DEFAULT_GATE_BYTE4 << 24ul;
        AppConfig.PrimaryDNSServer.Val = MY_DEFAULT_PRIMARY_DNS_BYTE1 | MY_DEFAULT_PRIMARY_DNS_BYTE2 << 8ul | MY_DEFAULT_PRIMARY_DNS_BYTE3 << 16ul | MY_DEFAULT_PRIMARY_DNS_BYTE4 << 24ul;
        AppConfig.SecondaryDNSServer.Val = MY_DEFAULT_SECONDARY_DNS_BYTE1 | MY_DEFAULT_SECONDARY_DNS_BYTE2 << 8ul | MY_DEFAULT_SECONDARY_DNS_BYTE3 << 16ul | MY_DEFAULT_SECONDARY_DNS_BYTE4 << 24ul;

        // Load the default NetBIOS Host Name
        memcpypgm2ram(AppConfig.NetBIOSName, (ROM void*)MY_DEFAULT_HOST_NAME, 16);
        FormatNetBIOSName(AppConfig.NetBIOSName);

        // Compute the checksum of the AppConfig defaults as loaded from ROM
        wOriginalAppConfigChecksum = CalcIPChecksum((BYTE*) & AppConfig, sizeof (AppConfig));
        break;
    }
}

/******************************************************************************/

/*********************************************************************
 * Function:        void DisplayLine(BYTE *byData)
 *
 * PreCondition:    None
 *
 * Input:           byData pointeur sur la ligne à afficher
 *
 * Output:          None
 *
 * Side Effects:    None
 *
 * Overview:        None
 *
 * Note:            None
 ********************************************************************/
static void DisplayLine(BYTE *byData)
{
    BYTE byIndex = 0;
    do
    {
        while(LCD_IsBusy());
        PORTSetBits(LCD_RS);
        LCDSetValue(byData[byIndex]);
    }while(byData[++byIndex]);
}

/******************************************************************************/

static void vEnableCN(void)
{
    //Interruption sur le changement de niveau d'une entrée.

    mCNClearIntFlag();
    mCNOpen(CN_ON | CN_IDLE_CON, CN5_ENABLE | CN4_ENABLE, CN5_PULLUP_ENABLE | CN4_PULLUP_ENABLE);
    ConfigIntCN(CHANGE_INT_ON | CHANGE_INT_PRI_1);
    EnableCN5;
    EnableCN4;
}

/******************************************************************************/

/*******
/*********************************************************************
 * Function:        void vInit_IO(void)
 *
 * PreCondition:    None
 *
 * Input:           None
 *
 * Output:          None
 *
 * Side Effects:    None
 *
 * Overview:        None
 *
 * Note:            None
 ********************************************************************/
static void vInit_IO(void)
{
    AD1CON1CLR = 0XFFFFFFF;
    AD1PCFGSET = 0XFFFFFFF;

    CM1CONbits.ON = FALSE;
    CM2CONbits.ON = FALSE;

    //Led
    PORTSetPinsDigitalOut(RED);
    LEDON(RED);

    //Bouton de test
    PORTSetBits(ONBOARDBUTTON);
    PORTSetBits(W1);
    PORTSetBits(VP);
    PORTSetPinsDigitalIn(ONBOARDBUTTON);
    PORTSetPinsDigitalIn(W1);
    PORTSetPinsDigitalIn(VP);

    //Jumper d'initialisation de l'eeprom.
    PORTSetBits(ResetEEprom);
    PORTSetPinsDigitalIn(ResetEEprom);

    vEnableCN();

    //Buzzer
    PORTSetPinsDigitalOut(BUZZER);
    PORTClearBits(BUZZER);

    //Clavier
    PORTSetBits(ROWPORT, LIGNES | COLONNES); //Positionne le port du clavier à l'etat haut.
    PORTSetPinsDigitalIn(COLUMNPORT, COLONNES); //Positionne les colonnes en entrées.
    PORTSetPinsDigitalOut(ROWPORT, LIGNES); //Positionne les lignes en sorties.

    //Reset du port MDB
    PORTSetPinsDigitalOut(MDBLINE);
    PORTClearBits(MDBLINE);
    DelayMs(500);
}

/******************************************************************************/

/*********************************************************************
 * Function:        void vInitalization(void)
 *
 * PreCondition:    None
 *
 * Input:           None
 *
 * Output:          None
 *
 * Side Effects:    None
 *
 * Overview:        None
 *
 * Note:            None
 ********************************************************************/
static void vInitialization(void)
{
    ClearWDT();
    wEcran = SCREENBEGINMAINTENANCE;
    lRepeatKBD = REPEATDELAYKBDBYDEFAULT;
    isFlip = isCancel = isFileCreditPresent = isTOCumul =
        isChangeAutorized = isTO_KBDEnable = isDisplayRemaining = isTO_KBDEnable =
        isToEscrow = isDisplayRemaining = isFromHTTP = isChangeInProgress =
        isToBeOFF = isFillingInProgress = FALSE;
    memset(byBuffer, 0, sizeof (byBuffer));
    memset(byCreditFileName, 0, sizeof (byCreditFileName));
    wTORequest = byPosNum = lOldAmountUSBDispo = lAmountToPay =
        lOldAmountInCashDispo = lAmountUSBDispo = lAmountInCashDispo = wPrice = 0;
    byDecimalPos = DECIMALPOSBYDEFAULT;
    byBillNumber = byIndexSelectedMachine = 0XFF;
    wCurrencyDivider = 100;
    memset(kbdButton, 0XFF, sizeof (kbdButton));

    vInit_IO();

    setbuf(stdout, NULL);
    LCDInit(2);
    //Affiche l'écran de présentation. Le scheduler n'est pas encore arrivé
    snprintf(byBuffer, 40, "%s %s", byTexte[MDIVERSION], Version);

    DisplayLine(byBuffer);
    while(LCD_IsBusy());
    LCDSetValue(LCD_SET_DDRAM_ADDR | 0x40);
    snprintf(byBuffer, 40, "%s *%02X%02X%02X%02X%02X%02X*", byTexte[CENTRALE],
             0XFC, EMAC1SA2 / 256, EMAC1SA1 % 256, EMAC1SA1 / 256,
             EMAC1SA0 % 256, EMAC1SA0 / 256);
    DisplayLine(byBuffer);


    InitRS485(RS485, configPERIPHERAL_CLOCK_HZ, 9600, UART_DATA_SIZE_8_BITS,
              UART_PARITY_NONE, UART_STOP_BITS_1, IOPORT_G, BIT_0);
    OpenUART(RS232_2, configPERIPHERAL_CLOCK_HZ, 9600, UART_DATA_SIZE_8_BITS,
             UART_PARITY_NONE, UART_STOP_BITS_1);
    InitMDB(MDBPORT);
    lAmountCL = lAmountBV = lAmountCG = lAmountInCashDispo = 0;
    //Annule toutes les authorisations.
    isLocalAccountantEnable = isHttpAccountantEnable = FALSE;
    RtccInit();
    while(RtccGetClkStat() != RTCC_CLK_ON);
    RtccGetTimeDate(&Now, &Today);

    //0.9.2a 2014 10 14 17:21
    //Vérification de la cohérence de la date.
    if(((Today.mday & 0x0F) > 9) || (((Today.mday >> 4) & 0xF) > 3) ||
       ((Today.mon & 0x0F) > 9) || (((Today.mon >> 4) & 0xF) > 1) ||
       ((Today.year & 0x0F) > 9) || (((Today.year >> 4) & 0xF) > 9) || (Today.wday > 6) ||
       ((Now.sec & 0x0F) > 9) || (((Now.sec >> 9) & 0xF) > 5) ||
       ((Now.min & 0x0F) > 9) || (((Now.min >> 4) & 0xF) > 5) ||
       ((Now.hour & 0x0F) > 9) || (((Now.hour >> 4) & 0xF) > 2))
    {
        Today.l = 0x15010100;
        Now.l = 0x00000100;
        RtccSetTimeDate(Now.l, Today.l);
    }
    /**********************/
    while(!RtccGetAlarmEnable())
    {
        RtccAlarmEnable();
    }
    RTCALRMbits.AMASK = 0b1001;
    INTSetVectorPriority(INT_RTCC_VECTOR, INT_PRIORITY_LEVEL_3); //Set the RTCC priority in the INT controller
    INTSetVectorSubPriority(INT_RTCC_VECTOR, INT_SUB_PRIORITY_LEVEL_1); //Set the RTCC sub-priority in the INT controller
    INTClearFlag(INT_RTCC);
    INTEnable(INT_RTCC, INT_ENABLED); //Enable the RTCC event interrupts in the INT controller.

    srand((Now.l = RtccGetTime()));

}

/******************************************************************************/

/*********************************************************************
 * Function:        void vScreenHistorique(const BYTE byKeyHit)
 *
 * PreCondition:    None
 *
 * Input:           None
 *
 * Output:          None
 *
 * Side Effects:    None
 *
 * Overview:        None
 *
 * Note:            None
 ********************************************************************/
static void vScreenHistorique(const BYTE byKeyHit)
{
    UOPERATION histoData;
    memset(byBuffer, 0, sizeof (byBuffer));
    //Si c'est la touche étoile, retour à l'ecran de maintenance.
    if(byKeyHit == STAR)
    {
        wEcran = SCREENMAINMAINTENANCE;
    }
    else
    {
        if(sender == MAINMAINTENANCE)
        {
            //Récupèration de l'adresse actuelle de l'historique
            wE2OperationPosRead = wE2OperationPos;
            sender = HISTORIQUEMENU;
        }
        else
        {
            switch(byKeyHit)
            {
                case KEYFORWARD:
                {
                    wE2OperationPosRead -= sizeof (UOPERATION);
                    if(wE2OperationPosRead < ADDRESS_HISTO)
                    {
                        wE2OperationPosRead = (0xFFFF - sizeof (histoData) + 1);
                        I2CE2promLReadBuffer(wE2OperationPosRead, &histoData, sizeof (UOPERATION));
                        if((histoData.Operation & 0XFF) == NONEOP)
                        {
                            wE2OperationPosRead = wE2OperationPos;
                        }
                    }
                }
                    break;
                case KEYNEXT:
                {
                    wE2OperationPosRead += sizeof (UOPERATION);
                    if(wE2OperationPosRead > wE2OperationPos)
                    {
                        wE2OperationPosRead = ADDRESS_HISTO;
                    }
                }
                    break;
                default:
                {
                    break;
                }
            }
        }
        I2CE2promLReadBuffer(wE2OperationPosRead, &histoData, sizeof (UOPERATION));
        snprintf(byBuffer, 32, "%02X-%02X-%02X %02X:%02X:%02X %s", histoData.date.mday,
                 histoData.date.mon, histoData.date.year, histoData.time.hour,
                 histoData.time.min, histoData.time.sec, byTexte[UNKNOW_OP + histoData.Operation]);
        switch(histoData.Operation)
        {
            case LANCEMENT:
            {
                snprintf(&byBuffer[strlen(byBuffer)], 32, " %u  %.*f\7", histoData.byMachine, byDecimalPos, (double)histoData.lAmount / wCurrencyDivider);
            }
                break;
            case INCG:
            case INBV:
            case OUCG:
            case OVERPAYOP:
            case FILLINGOP:
            {
                snprintf(&byBuffer[strlen(byBuffer)], 32, " %.*f\7", byDecimalPos, (double)histoData.lAmount / wCurrencyDivider);
            }
                break;
            case PAYCASHLESS:
            case REVALUECASHLESS:
            case KEYPRESENT:
            case USBPAY:
            {
                snprintf(&byBuffer[strlen(byBuffer)], 32, " %u  %.*f\7", histoData.lKeyNumber, byDecimalPos, (double)histoData.lAmount / wCurrencyDivider);
            }
                break;
            case USBKEYINSERTED:
            {
                if(histoData.lAmount)
                {
                    snprintf(&byBuffer[strlen(byBuffer)], 32, " %u  %.*f\7", histoData.lKeyNumber, byDecimalPos, (double)histoData.lAmount / wCurrencyDivider);
                }
            }
                break;
            default:
            {
                break;
            }
        }
    }
    //Le buffer sera passé en paramètre à la fonction vMenuMaintenance.
    ptrParameterMenu = byBuffer;
}

/******************************************************************************/

/*********************************************************************
 * Function:        void vConfirmSatelliteRemove(const BYTE byKey)
 *
 * PreCondition:    None
 *
 * Input:           None
 *
 * Output:          None
 *
 * Side Effects:    None
 *
 * Overview:        None
 *
 * Note:            None
 ********************************************************************/
static void vConfirmSatelliteRemove(const BYTE byKey)
{
    switch(byKey)
    {
        case STAR:
        {
            wEcran = SCREENSATELLITE;
            break;
        }
        case SHARP:
        {
            if(sender == REMOVESATELLITE)
            {
                LCDClear();
                memset(bySatBuffer, 0, sizeof (bySatBuffer));
                if(!isModifyMachineNumber(modules[byIndexSelectedMachine].config.byNumero, 0XFF))
                {
                    vDisplayLCD("%s %u %s", byTexte[SATELLITE],
                                modules[byIndexSelectedMachine].config.byNumero, byTexte[NONEXISTENT]);
                    DelayMs(centralParameters.lDelayDisplay);
                    LCDGotoXY(1, 2);
                }
                vDisplayLCD(byTexte[REMOVED], modules[byIndexSelectedMachine].config.byNumero);
                memset(&modules[byIndexSelectedMachine], 0XFF, sizeof (SMACHINE_CONFIG));
                I2CE2promLWriteBuffer(ADDRESS_MACHINES_PARAMETERS + (byIndexSelectedMachine * sizeof (SMACHINE_CONFIG)),
                                      &modules[byIndexSelectedMachine], sizeof (SMACHINE_CONFIG));
                wEcran = SCREENSATELLITE;
                ptrParameterMenu = NULL;
                isReturnMaintenance = TRUE;
                byPosNum = 0;
                DelayMs(centralParameters.lDelayDisplay);
            }
            else
            {
                wEcran = SCREENSATELLITEAUTO;
            }
            break;
        }
        default:
        {
            break;
        }
    }
}

/******************************************************************************/

static void vSetHisto(const DWORD dwNumMedia, const BYTE byNumMachine, const EHISTOOP histoOperation,
                      const WORD wAmount, const ERESULT result)
{
    UOPERATION histoData;
    histoData.Operation = histoOperation & 0XFF;
    histoData.lKeyNumber = dwNumMedia;
    histoData.date.l = RtccGetDate();
    histoData.time.l = RtccGetTime();
    histoData.byMachine = byNumMachine;
    histoData.lAmount = wAmount;
    histoData.result = result & 0xFF;
    //Definit la nouvelle adresse à partir de laquelle va commencer le nouvel enregistrement.
    wE2OperationPos += sizeof (UOPERATION);
    //Vérifie que la capacité de l'eeprom n'est pas dépassée, si c'est le cas
    //effectue la rotation en fixant l'adresse au début de la sauvegarde de l'historique.
    if(wE2OperationPos < ADDRESS_HISTO)
    {

        wE2OperationPos = ADDRESS_HISTO;
    }
    //Enregistre l'opération dans l'historique.
    I2CE2promLWriteBuffer(ADDRESS_HISTOEE_POINTER, &wE2OperationPos, sizeof (wE2OperationPos));
    //Enregistre l'adresse actuelle de l'historique dans l'eeprom en cas d'extinction de la centrale.
    I2CE2promLWriteBuffer(wE2OperationPos, &histoData, sizeof (UOPERATION));
}

/******************************************************************************/

void vWarning(char * byMessage)
{

    LCDClearLine(2);
    vDisplayLCD("%-20s", byMessage);
    xTimerStart(hTimerFlip, 1000);
}

/******************************************************************************/

static void vReset(void)
{
    SoftReset();
    EnableWDT();
    INTDisableInterrupts();

    while(TRUE);
}

/******************************************************************************/

/*********************************************************************
 * Function:        void vDisplayAmount(DWORD dwAmount, const char *byText, const BOOL isDelay)
 *
 * PreCondition:    None
 *
 * Input:           None
 *
 * Output:          None
 *
 * Side Effects:    None
 *
 * Overview:        None
 *
 * Note:            None
 ********************************************************************/
static void vDisplayAmount(DWORD dwAmount, const char *byText, const BOOL isDelay)
{
    isFlip = FALSE;
    isDisplayTime = FALSE;
    LCD_CURSOR_OFF();

    snprintf(byBuffer, 40, "%s %.*f\7", byText, byDecimalPos, (double)dwAmount / wCurrencyDivider);
    //   vTaskSuspendAll();
    ((lAmountInCashDispo || isKeyPresent || isThumbDriveAttached) && (byNumMachine < 10) &&
     (strcmp(byText, byTexte[RETURNED]) != 0)) ? LCDGotoXY(23, 1) : LCDClearLine(1);
    vDisplayLCD("%*s", isKeyPresent || isThumbDriveAttached ? -17 : -20, byBuffer);
    if(strcmp(byText, byTexte[RETURNED]) && !isKeyPresent && !isThumbDriveAttached &&
       !lAmountInCashDispo && !modules[byIndexSelectedMachine].config.isCumulEnable &&
       !modules[byIndexSelectedMachine].config.isDisplayedTimeRemaining &&
       !modules[byIndexSelectedMachine].config.lTimeToDisplay)
    {
        isDisplayTime = FALSE;
        LCDGotoXY(22, 1);
        vDisplayLCD("%19s", byTexte[CANCEL]);
    }
    if(isKeyPresent)
    {
        LCDClearLine(2);
        isMediaCLFull ? vWarning(byTexte[MAXI]) : vDisplayLCD("%s%9lu", byTexte[MEDIA_ID], dwMediaID); //Affiche l'identiant de la clé.
    }
    //xTaskResumeAll();
    if(!isKeyPresent && !modules[byIndexSelectedMachine].config.lTimeToDisplay && isDelay)
    {
        DelayMs(centralParameters.lDelayDisplay);
    }
}

/******************************************************************************/

static void vTOOverPayTreat(void)
{
    auditData.data.dwOverPay += lAmountInCashDispo;
    auditDataPermanent.data.dwOverPay += lAmountInCashDispo;
    I2CE2promLWriteBuffer(ADDRESS_DWOVERPAY, &auditData.data.dwOverPay, sizeof (auditData.data.dwOverPay));
    I2CE2promLWriteBuffer(ADDRESS_DWOVERPAY_PERMANENT, &auditDataPermanent.data.dwOverPay, sizeof (auditDataPermanent.data.dwOverPay));
    if(lAmountInCashDispo)
    {

        vSetHisto(0, 0, OVERPAYOP, lAmountInCashDispo, SUCCESSFUL);
    }
    lAmountInCashDispo = 0;
}

/******************************************************************************/

/*********************************************************************
 * Function:        BYTE getLCDAddress(void)
 *
 * PreCondition:    None
 *
 * Input:           None
 *
 * Output:          L'adresse actuelle dans le controleur d'afficheur
 *
 * Side Effects:    None
 *
 * Overview:        None
 *
 * Note:            Renvoi l'adresse actuelle du controleur d'afficheur
 *									Effectue une vérification sur le bit d'occupation.
 ********************************************************************/
static BYTE getLCDAddress(void)
{

    while(LCD_IsBusy());
    return getLCDAddressCounter();
}

/******************************************************************************/

static void vResetSelectMachine(void)
{
    byPosNum = 0;
    isKBDEnable = TRUE;
    DelayMs(100);
    if(isFillingInProgress && (lAmountCG > 0))
    {
        isFillingInProgress = FALSE;
        vSetHisto(0, 0, FILLINGOP, lAmountCG, SUCCESSFUL);
    };
    if(!isChangeInProgress)
    {
        byNumMachine = 0;
        isTO_KBDEnable = FALSE;
        byIndexSelectedMachine = 0xFF;
        lAmountToPay = 0;
        xTimerStop(hTimerTOKBD, 1000);
        xTimerStop(hTimerFlip, 1000);
        LCDClear();
        vDisplayLCD("%s ", byTexte[SELECTION_MACHINE]);
        byLCDAddressCounter = getLCDAddress();
        if(isKeyPresent || isFileCreditPresent)
        {
            vDisplayAmount(isKeyPresent ? lAmountCL : lAmountUSBDispo, byTexte[isKeyPresent ? INKEY : CREDITINUSB], TRUE);
        }
        else
        {
            if(lAmountInCashDispo)
            {
                isDisplayTime = FALSE;
                if(centralParameters.byOverPayTO)
                {
                    xTimerStart(hTimerTOOverpay, 1000);
                    vDisplayAmount(lAmountInCashDispo, byTexte[DISPO], TRUE);
                }
                else
                {
                    vTOOverPayTreat();
                }
            }
        }
        setLCDAddressCounter(byLCDAddressCounter);
        LCD_CURSOR_SET(!isFromHTTP);
        isCancel = isFlip = FALSE;
        isDisplayTime = (!isKeyPresent && !isThumbDriveAttached && !lAmountInCashDispo);
    }
    //DisableWDT();
}

/******************************************************************************/

/******************************************************************************/

static void vTOOverPay(TimerHandle_t pxTimer)
{
    vResetSelectMachine();
}

/******************************************************************************/

static void vSleepMCU(void)
{

    ClearWDT();
    DisableWDT();

    U1MODECLR = 0XFFFF;
    U2MODECLR = 0XFFFF;
    U3MODECLR = 0XFFFF;
    U4MODECLR = 0XFFFF;
    U5MODECLR = 0XFFFF;
    U6MODECLR = 0XFFFF;

    AD1CON1CLR = 0XFFFF;
    AD1CON2CLR = 0XFFFF;
    AD1CON3CLR = 0XFFFF;

    CM1CONCLR = 0XFFFF;
    CM2CONCLR = 0XFFFF;

    CVRCONCLR = 0XFFFF;

    mPMPClose();
    PMCONCLR = 0XFFFF;

    CloseCapture1();
    CloseCapture2();
    CloseCapture3();
    CloseCapture4();
    CloseCapture5();
    IC1CONCLR = 0XFFFF;
    IC2CONCLR = 0XFFFF;
    IC3CONCLR = 0XFFFF;
    IC4CONCLR = 0XFFFF;
    IC5CONCLR = 0XFFFF;

    CloseOC1();
    CloseOC2();
    CloseOC3();
    CloseOC4();
    CloseOC5();
    OC1CONCLR = 0XFFFF;
    OC2CONCLR = 0XFFFF;
    OC3CONCLR = 0XFFFF;
    OC4CONCLR = 0XFFFF;
    OC5CONCLR = 0XFFFF;

    SpiChnClose(SPI_CHANNEL1);
    SpiChnClose(SPI_CHANNEL2);
    SpiChnClose(SPI_CHANNEL3);
    SpiChnClose(SPI_CHANNEL4);
    SPI1CONCLR = 0XFFFF;
    SPI2CONCLR = 0XFFFF;
    SPI3CONCLR = 0XFFFF;
    SPI4CONCLR = 0XFFFF;

    I2CEnable(I2C1, FALSE);
    I2CEnable(I2C2, FALSE);
    I2CEnable(I2C3, FALSE);
    I2CEnable(I2C4, FALSE);
    I2CEnable(I2C5, FALSE);
    I2C1CONCLR = 0XFFFF;
    I2C2CONCLR = 0XFFFF;
    I2C3CONCLR = 0XFFFF;
    I2C4CONCLR = 0XFFFF;
    I2C5CONCLR = 0XFFFF;

    RTCCONbits.ON = TRUE;
    RTCCONbits.RTCCLKON = TRUE;

    DMACONCLR = 0XFFFF;

    U1PWRCbits.USBPWR = FALSE; // disable USB power
    U1PWRCbits.USUSPEND = TRUE; // put USB in suspend mode
    //disable entire usb module
    U1CONbits.USBEN = FALSE;

    C1CONCLR = 0XFFF;
    C2CONCLR = 0XFFF;

    // disable the JTAG Port
    DDPCONbits.JTAGEN = FALSE; // disable JTAG port

    ETHCON1CLR = 0XFFFF;
    ETHCON2CLR = 0XFFFF;

    PORTSetBits(IOPORT_A, 0XFFFFFFFF);
    PORTSetBits(IOPORT_B, 0XFFFFFFFF);
    PORTSetBits(IOPORT_C, 0XFFFFFFFF);
    PORTSetBits(IOPORT_D, 0XFFFFFFFF);
    PORTSetBits(IOPORT_E, 0XFFFFFFFF);
    PORTSetBits(IOPORT_F, 0XFFFFFFFF);
    PORTSetBits(IOPORT_G, 0XFFFFFFFF);

    PORTSetPinsDigitalIn(IOPORT_A, 0XFFFFFFFF);
    PORTSetPinsDigitalIn(IOPORT_B, 0XFFFFFFFF);
    PORTSetPinsDigitalIn(IOPORT_C, 0XFFFFFFFF);
    PORTSetPinsDigitalIn(IOPORT_D, 0XFFFFFFFF);
    PORTSetPinsDigitalIn(IOPORT_E, 0XFFFFFFFF);
    PORTSetPinsDigitalIn(IOPORT_F, 0XFFFFFFFF);
    PORTSetPinsDigitalIn(IOPORT_G, 0XFFFFFFFF);

    DisableIntT1;
    DisableIntT2;
    DisableIntT3;
    DisableIntT4;
    DisableIntT5;

    IEC0CLR = 0XFFFF;

    vEnableCN();

    OSCConfig(OSC_SOSC, 0, 0, 0);
    mOSCSetPBDIV(OSC_PB_DIV_1);
    Nop();
    OSCCONSET = 0x10; // Device will enter SLEEP mode
    PowerSaveSleep();
    Nop();
    Nop();
    SoftReset();

    //Redémarrage de la carte
    Nop();
    Nop();
    Nop();
    Nop();

    OSCConfig(OSC_POSC_PLL, OSC_PLL_MULT_20, OSC_PLL_POST_1, 0);
    DelayMs(100);
    vReset();
}

/******************************************************************************/

static void vReturnFromTest(void)
{
    //Supprime les autorisations d'accès au paramètrage.

    isLocalAccountantEnable = FALSE;
    isReturnMaintenance = FALSE;
    UsageMode = MODEUSER;
    wEcran = SCREENBEGINMAINTENANCE;
    sender = USER;
    vSetHisto(0, 0, TEST_LEFT, 0, SUCCESSFUL);
    vResetSelectMachine();
}

/******************************************************************************/

/*********************************************************************
 * Function:        static void vTaskCheckKeyBoard(void *pvParameter)
 *
 * PreCondition:    None
 *
 * Input:           None
 *
 * Output:          None
 *
 * Side Effects:    None
 *
 * Overview:        None
 *
 * Note:            None
 ********************************************************************/
static void vTaskCheckKeyBoard(void *pvParameter)
{
    BYTE byKey = 0;
    vResetSelectMachine();
    TickType_t LastWakeTime = xTaskGetTickCount();
    for(;;)
    {
        isKBDPolled = TRUE;
        if(isToBeOFF)
        {
            vSleepMCU();
        }

        if((byKey = byGetKey()) && !((byKey == 11) && !byPosNum && (UsageMode == MODEUSER) && isKBDEnable))
        {
            xQueueSendToBack(queueKeyHit, &byKey, 0);
        }
        if(!PORTReadBits(ONBOARDBUTTON))
        {
            DelayMs(30);
            if(!PORTReadBits(ONBOARDBUTTON))
            {
                while(!PORTReadBits(ONBOARDBUTTON));
                if(UsageMode != MODEUSER)
                {
                    vReturnFromTest();
                }
                else
                {
                    vSetHisto(0, 0, TEST_START, 0, SUCCESSFUL);
                    isAuditEnable = isConfigEnable = isHistoEnable = isRAZEnable = isRefillingEnable = TRUE;

                    xSemaphoreGive(semaphoreTest);

                }
            }
            isTO_KBDEnable = TRUE;
            xTimerStart(hTimerTOKBD, 10);
        }
        vTaskDelayUntil(&LastWakeTime, DELAY_CHK_KBD);
    }
}

/******************************************************************************/

static void vScreenLeave(void)
{

    BYTE byKey = 0;
    LCDClear();
    vDisplayLCD("%s", byTexte[wEcran == SCREENSATELLITE ? COMPLETED : NOMODULE]);
    ptrParameterMenu = NULL;
    isReturnMaintenance = TRUE;
    byPosNum = 0;
    DelayMs(centralParameters.lDelayDisplay);
    xQueueSendToBack(queueKeyHit, &byKey, 0);
}

/******************************************************************************/

static void vDisplayEnableChoice(const char *byTexteToDisplay, const BOOL isEnable)
{

    LCDClear();
    vDisplayLCD("%s %s%c %s%c", byTexteToDisplay, byTexte[DISABLE], isEnable ? 32 : 127, byTexte[ENABLE], isEnable ? 127 : 32);
    LCDGotoXY(1, 2);
    vDisplayLCD("(*)%-17s(#)%-17s", byTexte[BACK], byTexte[NEXT]);
}

/******************************************************************************/

static void vDisplayCashEnable(BYTE byIndex, BOOL isEnable)
{

    LCDClear();
    vDisplayLCD("%s %6.*f\7%8s%c", byTexte[wEcran == SCREENCHANGEGIVER ? COIN : BILL],
                byDecimalPos, (wEcran == SCREENCHANGEGIVER ?
                               (double)(changeGiverConfig.byCoinValue[byIndex] * changeGiverConfig.deviceConfig.byScaleFactor) :
                               (double)(billValidatorSetup.byBillValue[byIndex] * billValidatorSetup.wScaleFactor)) /
                wCurrencyDivider, byTexte[DISABLE], !isEnable ? 127 : 32);
    vDisplayLCD("%8s%c", byTexte[ENABLE], isEnable ? 127 : 32);
    LCDGotoXY(1, 2);
    vDisplayLCD("%-17s(#)%-17s", byTexte[EXIT], byTexte[NEXT]);
}

/******************************************************************************/

static void vMaintenanceMenu(void *vParameter)
{
    rtccTime time;
    BYTE byIndex;
    LCDClear();
    LCD_CURSOR_OFF();

    isFlip = FALSE;
    xTimerStop(hTimerFlip, 1000);
    switch(wEcran)
    {
        case SCREENSATELLITEREMOVECONFIRM:
        {
            vDisplayLCD("%s", byTexte[CONFIRM]);
            LCDGotoXY(20, 1);
            vDisplayLCD("%s %s", byTexte[NO], byTexte[YES]);
            break;
        }
        case SCREENMAINMAINTENANCE:
        {
            vDisplayLCD("%-20s%-20s", isConfigEnable ? byTexte[CONFIGURATION] : "", isAuditEnable && isLocalAccountantEnable ? byTexte[AUDIT] : "");
            LCDGotoXY(1, 2);
            vDisplayLCD("%s %s%s %s", isHistoEnable ? byTexte[HISTORIQUE] : "", isRefillingEnable ? "(4)" : "", isRefillingEnable ? byTexte[FILLING] : "", byTexte[EXIT]);
            break;
        }
        case SCREENCONFIGURATION:
        {
            vDisplayLCD("%s %s", byTexte[PARAMETERS], byTexte[DEVICES]);
            LCDGotoXY(1, 2);
            vDisplayLCD("%s %s %s", byTexte[SATELLITE], byTexte[DATETIME], byTexte[EXIT]);
            break;
        }
        case SCREENPERIPHERIQUE:
        {
            byCashPos = 0;
            vDisplayLCD("%-20s%-20s%-20s%-20s", isChangerReseted ? byTexte[CHANGEGIVER] : "",
                        isBillValidatorReseted ? byTexte[BILLVALIDATOR] : "",
                        byTexte[CASHLESS], byTexte[EXIT]);
            break;
        }
        case SCREENCHANGEGIVER:
        {
            vDisplayCashEnable(*(BYTE*)vParameter, (BOOL)(centralParameters.coinType.wCoinEnable & (1 << *(BYTE*)vParameter)));
            break;
        }
        case SCREENBILLVALIDATOR:
        {
            vDisplayCashEnable(*(BYTE*)vParameter, (BOOL)(centralParameters.billType.wBillEnable & (1 << *(BYTE*)vParameter)));
            break;
        }
        case SCREENCASHLESS:
        {
            vDisplayLCD("(%u)%s%X%c  ", 1, byTexte[ADDRESSMDB], CASHLESS1,
                        centralParameters.byCLAddress == CASHLESS1 ? 127 : 32);
            vDisplayLCD("(%u)%s%X%c", 2, byTexte[ADDRESSMDB], CASHLESS2,
                        centralParameters.byCLAddress == CASHLESS2 ? 127 : 32);
            LCDGotoXY(1, 2);
            vDisplayLCD("%-20s", byTexte[EXIT]);
            break;
        }
        case SCREENSATELLITE:
        {
            vDisplayLCD("%-20s%-20s", byTexte[NEWMACHINEMANUAL], byTexte[MODIFICATIONMACHINE]);
            LCDGotoXY(1, 2);
            vDisplayLCD("%s %s %s", byTexte[REMOVEMACHINE], byTexte[RETRAITAUTO],
                        byTexte[EXIT]);
            break;
        }
        case SCREENDATETIME:
        {
            RtccGetTimeDate(&Now, &Today);
            byPosNum = 0;
            vDisplayLCD("%s %02X:%02X:%02X %s %02X-%02X-%u%02X", byTexte[HEURE],
                        Now.hour, Now.min, Now.sec, byTexte[DATE], Today.mday,
                        Today.mon, 20, Today.year);
            LCDGotoXY(strlen(byTexte[HEURE]) + 2, 1);
            break;
        }
        case SCREENSATELLITEAUTO:
        {
            BYTE byNumResetMachine = 0XFF;
            LCDClear();
            vDisplayLCD("%s", byTexte[SEARCH]);
            for(byIndexSelectedMachine = 0; byIndexSelectedMachine < MAXMACHINES; byIndexSelectedMachine++)
            {
                if(modules[byIndexSelectedMachine].config.byNumero != byNumResetMachine)
                {
                    if(isSimplePoll(modules[byIndexSelectedMachine].config.byNumero))
                    {
                        LCDClearLine(1);
                        if(!isModifyMachineNumber(modules[byIndexSelectedMachine].config.byNumero, byNumResetMachine))
                        {
                            vDisplayLCD("%s %u %s", byTexte[SATELLITE],
                                        modules[byIndexSelectedMachine].config.byNumero, byTexte[MACHINEMISSING]);
                            DelayMs(centralParameters.lDelayDisplay);
                        }
                        vDisplayLCD(byTexte[REMOVED], modules[byIndexSelectedMachine].config.byNumero);
                        DelayMs(centralParameters.lDelayDisplay);
                    }
                    LCDClearLine(1);
                    vDisplayLCD("%s", byTexte[SEARCH]);
                }
                memset(&modules[byIndexSelectedMachine], 0XFF, sizeof (SMACHINE_CONFIG));
                I2CE2promLWriteBuffer(ADDRESS_MACHINES_PARAMETERS + (byIndexSelectedMachine * sizeof (SMACHINE_CONFIG)),
                                      &modules[byIndexSelectedMachine], sizeof (SMACHINE_CONFIG));
            }
            LCDClear();
            for(byIndex = 99; byIndex > 9; byIndex--)
            {
                ClearWDT();
                //Contrôle tous les satellites possibles et confirme la reinitialisation
                LCDGotoXY(1, 1);
                vDisplayLCD("%s %s %u", byTexte[CHECK], byTexte[SATELLITE2], byIndex);
                if(isModifyMachineNumber(byIndex, byNumResetMachine))
                {
                    LCDGotoXY(1, 2);
                    vDisplayLCD(byTexte[MACHINEREMOVED], byIndex);
                }
                isTO_KBDEnable = TRUE;
                xTimerStart(hTimerTOKBD, 10);
            }
            wEcran = SCREENSATELLITE;
            vScreenLeave();
            break;
        }
        case SCREENREFMACHINE:
        {
            vDisplayLCD("%40s", byTexte[PASS]);
            LCDHome();
            vDisplayLCD("%s ", byTexte[REFERENCE]);
            byPosNum = 0;
            break;
        }
        case SCREENSATELLITEREMOVE:
        case SCREENSATELLITEMANUAL:
        case SCREENSATELLTIEMODIF:
        {
            vDisplayLCD("%s ", byTexte[NUMERO]);
            if(wEcran == SCREENSATELLITEMANUAL)
            {
                LCDClear();
                vDisplayLCD("%s", byTexte[SEARCH]);
                if(isSimplePoll(0XFF))
                {
                    byNumMachine = 9; //Initialise la recherche de la première machine libre.
                    do
                    {
                        byIndexSelectedMachine = byMachineExist(++byNumMachine);
                    }while((byIndexSelectedMachine < MAXMACHINES) && (byNumMachine < 100));
                    LCDClear();
                    if(byNumMachine == 100)
                    {
                        vDisplayLCD("%s", byTexte[TOOMANYMACHINE]);
                        wEcran = SCREENSATELLITE;
                    }
                    else
                    {
                        vDisplayLCD("%s ", byTexte[NUMERO]);
                        byLCDAddressCounter = getLCDAddress();
                        vDisplayLCD("%u", byNumMachine);
                        setLCDAddressCounter(byLCDAddressCounter);
                    }
                }
                else
                {
                    wEcran = SCREENNOMODULE;
                    vScreenLeave();
                }
            }
            if(wEcran != SCREENSATELLITEREMOVE && wEcran != SCREENNOMODULE)
            {
                wEcran = (wEcran == SCREENSATELLITEMANUAL) ? SCREENNUMMACHINE : SCREENMODIFNUMMACHINE;
            }
            byPosNum = 0;
            break;
        }
        case SCREENPRICECASHLESS:
        case SCREENPRICECASH:
        case SCREENPRICECASH_HH:
        case SCREENPRICECASHLESS_HH:
        case SCREENEXACTCHANGE:
        {
            byPosNum = 0;
            switch(wEcran)
            {
                case SCREENPRICECASH:
                {
                    vDisplayLCD("%s ", byTexte[PRICECASH]);
                    break;
                }
                case SCREENPRICECASHLESS:
                {
                    vDisplayLCD("%s ", byTexte[PRICECASHLESS]);
                    break;
                }
                case SCREENPRICECASH_HH:
                {
                    vDisplayLCD("%s ", byTexte[PRICECASH_HH]);
                    break;
                }
                case SCREENPRICECASHLESS_HH:
                {
                    vDisplayLCD("%s ", byTexte[PRICECASHLESS_HH]);
                    break;
                }
                case SCREENEXACTCHANGE:
                {
                    vDisplayLCD("%s ", byTexte[EXACTCHANGEAMOUNT]);
                    break;
                }
                default:
                {
                    break;
                }
            }
            byLCDAddressCounter = getLCDAddress();
            vDisplayLCD("%05.*f\7", byDecimalPos, (double)*(WORD*)vParameter / wCurrencyDivider);
            setLCDAddressCounter(byLCDAddressCounter);
            break;
        }
        case SCREENREQUESTPW:
        case SCREENPULSE:
        case SCREENOVERBUSY:
        case SCREENTO_KBD:
        case SCREENTOCUMUL:
        case SCREENTO_OVERPAY:
        case SCREENMESSAGEDELAY:
        case SCREENTIMETODSP:
        case SCREENBUSYLEVEL:
        case SCREENPWLOCALTECH:
        case SCREENPWLOCALCOMPTA:
        case SCREENPWHTTPTECH:
        case SCREENPWHTTPCOMPTA:
        {
            byPosNum = 0;
            switch(wEcran)
            {
                case SCREENPWLOCALTECH:
                {
                    vDisplayLCD("%s", byTexte[PWLOCALTECH]);
                    break;
                }
                case SCREENPWLOCALCOMPTA:
                {
                    vDisplayLCD("%s", byTexte[PWLOCALCOMPTA]);
                    break;
                }
                case SCREENPWHTTPTECH:
                {
                    vDisplayLCD("%s", byTexte[PWHTTPTECH]);
                    break;
                }
                case SCREENPWHTTPCOMPTA:
                {
                    vDisplayLCD("%s", byTexte[PWHTPPCOMPTA]);
                    break;
                }
                case SCREENPULSE:
                {
                    vDisplayLCD("%s ", byTexte[PULSEDELAY]);
                    break;
                }
                case SCREENOVERBUSY:
                {
                    vDisplayLCD("%s ", byTexte[OVERBUSY]);
                    break;
                }
                case SCREENTO_KBD:
                {
                    vDisplayLCD("%s %s ", byTexte[KBDTO], byTexte[INSECONDES]);
                    break;
                }
                case SCREENTOCUMUL:
                {
                    vDisplayLCD("%s %s ", byTexte[CUMULTO], byTexte[INSECONDES]);
                    break;
                }
                case SCREENTO_OVERPAY:
                {
                    vDisplayLCD("%s %s ", byTexte[OVERPAYTO], byTexte[INSECONDES]);
                    break;
                }
                case SCREENMESSAGEDELAY:
                {
                    vDisplayLCD("%s ", byTexte[MESSAGETO]);
                    break;
                }
                case SCREENTIMETODSP:
                {
                    vDisplayLCD("%s ", byTexte[TIMETODISPLAY]);
                    break;
                }
                case SCREENBUSYLEVEL:
                {
                    vDisplayLCD("%s", byTexte[BUSYSENSIBILITY]);
                    break;
                }
                case SCREENREQUESTPW:
                {
                    vDisplayLCD(("%s", byTexte[REQUESTPW]));
                    break;
                }
                default:
                {
                    break;
                }
            }
            byLCDAddressCounter = getLCDAddress();
            vDisplayLCD("%-10lu", *(DWORD*)vParameter);
            setLCDAddressCounter(byLCDAddressCounter);
            break;
        }
        case SCREENBEGIN:
        case SCREENEND:
        case SCREENBEGINHH:
        case SCREENENDHH:
        {
            byPosNum = 0;
            time = *(rtccTime*)vParameter;
            switch(wEcran)
            {
                case SCREENBEGIN:
                {
                    vDisplayLCD("%s ", byTexte[TIMESTART]);
                    break;
                }
                case SCREENEND:
                {
                    vDisplayLCD("%s ", byTexte[TIMEEND]);
                    break;
                }
                case SCREENBEGINHH:
                {
                    vDisplayLCD("%s ", byTexte[HHSTART]);
                    break;
                }
                case SCREENENDHH:
                {
                    vDisplayLCD("%s ", byTexte[HHEND]);
                    break;
                }
                default:
                {
                    break;
                }
            }
            byHour = time.hour;
            byMin = time.min;
            byLCDAddressCounter = getLCDAddress();
            vDisplayLCD("%02Xh%02X", byHour, byMin);
            setLCDAddressCounter(byLCDAddressCounter);
            byPosNum = 0;
            break;
        }
        case SCREENDSPTIMEREMAINING:
        case SCREENCUMUL:
        case SCREENPOWER:
        case SCREENBILLACCEPTED:
        {
            switch(wEcran)
            {
                case SCREENDSPTIMEREMAINING:
                {
                    vDisplayLCD("%s%8s%c", byTexte[DSPTIMEREMAINING], byTexte[DISABLE], !*(BYTE*)vParameter ? 127 : 32);
                    break;
                }
                case SCREENCUMUL:
                {
                    vDisplayLCD("%s%8s%c", byTexte[CUMUL], byTexte[DISABLE], !*(BYTE*)vParameter ? 127 : 32);
                    break;
                }
                case SCREENPOWER:
                {
                    vDisplayLCD("%s%8s%c", byTexte[MAINPOWER], byTexte[DISABLE], !*(BYTE*)vParameter ? 127 : 32);
                    break;
                }
                case SCREENBILLACCEPTED:
                {
                    vDisplayLCD("%s%8s%c", byTexte[BILLACCEPTED], byTexte[DISABLE], !*(BYTE*)vParameter ? 127 : 32);
                    break;
                }
                default:
                {
                    break;
                }
            }
            vDisplayLCD("%8s%c", byTexte[ENABLE], *(BYTE*)vParameter ? 127 : 32);
            LCDGotoXY(1, 2);
            vDisplayLCD("(*)%-17s(#)%-17s", byTexte[BACK], byTexte[(wEcran == SCREENPOWER) ? SAVE : NEXT]);
            break;
        }
        case SCREENBUZZER:
        {
            vDisplayEnableChoice(byTexte[SOUND], centralParameters.isBuzzer);
            break;
        }
        case SCREENESCROW:
        {
            vDisplayEnableChoice(byTexte[ESCROWBILL], centralParameters.isEscrow);
            break;
        }
        case SCREENAUDIT:
        {
            vDisplayLCD("%-20s%-20s", byTexte[TEMPORARYTEXT], byTexte[PERMANENTTEXT]);
            LCDGotoXY(1, 2);
            vDisplayLCD("%s", byTexte[EXIT]);
            break;
        }
        case SCREENVENDCASH:
        case SCREENVENDCASHLESS:
        case SCREENREVALUECAHSLESS:
        case SCREENOVERPAY:
        case SCREENAUDITREFILLING:
        case SCREENVENDUSB:
        {
            vDisplayLCD("%c - ", eAudit == PERMANENT ? 'P' : 'T');
            switch(wEcran)
            {
                case SCREENVENDCASH:
                {
                    byIndex = CASHTEXT;
                    break;
                }
                case SCREENVENDCASHLESS:
                {
                    byIndex = CASHLESSTEXT;
                    break;
                }
                case SCREENREVALUECAHSLESS:
                {
                    byIndex = REVALUECASHLESSTEXT;
                    break;
                }
                case SCREENOVERPAY:
                {
                    byIndex = OVERPAYTEXTE;
                    break;
                }
                case SCREENAUDITREFILLING:
                {
                    byIndex = FILLING;
                    break;
                }
                case SCREENVENDUSB:
                {
                    byIndex = VENDUSBTEXT;
                    break;
                }
                default:
                {
                    break;
                }
            }
            vDisplayLCD("%s: %.*f\7", byTexte[byIndex], byDecimalPos, (double)(*(DWORD*)vParameter) / wCurrencyDivider);
            LCDGotoXY(1, 2);
            vDisplayLCD("(*)%-17s(#)%-17s", byTexte[BACK], byTexte[NEXT]);
            break;
        }
        case SCREENMACHINES:
        case SCREENINCG:
        case SCREENOUTCG:
        case SCREENINBV:
        {
            if((byIndexSelectedMachine > MAXMACHINES) && (wEcran == SCREENMACHINES))
            {
                wEcran = SCREENAUDITREFILLING;
                byIndexSelectedMachine = 0;
                xQueueSendToBack(queueKeyHit, &byIndex, 0);
            }
            else
            {
                vDisplayLCD("%c - ", eAudit == PERMANENT ? 'P' : 'T');
                switch(wEcran)
                {
                    case SCREENMACHINES:
                    {
                        while((byIndexSelectedMachine < MAXMACHINES) && (modules[byIndexSelectedMachine].config.byNumero > 100))
                        {
                            byIndexSelectedMachine++;
                        }
                        if(byIndexSelectedMachine < MAXMACHINES)
                        {
                            vDisplayLCD("%s %u: %u", byTexte[SERVICE], modules[byIndexSelectedMachine].config.byNumero,
                                        (eAudit == TEMPORARY) ? auditData.data.wNumberServices[byIndexSelectedMachine] :
                                        auditDataPermanent.data.wNumberServices[byIndexSelectedMachine]);
                        }
                        break;
                    }
                    case SCREENINCG:
                    case SCREENOUTCG:
                    {
                        while((byCashPos < MAXNUMBERCHANNELSCG) && ((changeGiverConfig.byCoinValue[byCashPos] == 0XFF) ||
                                                                    (changeGiverConfig.byCoinValue[byCashPos] == 0X00)))
                        {
                            byCashPos++;
                        }
                        if(byCashPos < MAXNUMBERCHANNELSCG)
                        {
                            if(wEcran == SCREENINCG)
                            {
                                vDisplayLCD(byTexte[COININ], byDecimalPos,
                                            (double)(changeGiverConfig.byCoinValue[byCashPos] * changeGiverConfig.deviceConfig.byScaleFactor) /
                                            wCurrencyDivider, (eAudit == TEMPORARY) ? auditData.data.wNumberChannelCGIn[byCashPos] :
                                            auditDataPermanent.data.wNumberChannelCGIn[byCashPos]);
                            }
                            else
                            {
                                vDisplayLCD(byTexte[COINOUT], byDecimalPos,
                                            (double)(changeGiverConfig.byCoinValue[byCashPos] * changeGiverConfig.deviceConfig.byScaleFactor) /
                                            wCurrencyDivider, (eAudit == TEMPORARY) ? auditData.data.wNumberChannelCGOut[byCashPos] :
                                            auditDataPermanent.data.wNumberChannelCGOut[byCashPos]);
                            }
                        }
                        break;
                    }
                    case SCREENINBV:
                    {
                        while((byCashPos < MAXNUMBERCHANNELSBV) && ((billValidatorSetup.byBillValue[byCashPos] == 0XFF) ||
                                                                    (billValidatorSetup.byBillValue[byCashPos] == 0X00)))
                        {
                            byCashPos++;
                        }
                        if(byCashPos < MAXNUMBERCHANNELSBV)
                        {
                            vDisplayLCD(byTexte[BILLIN], byDecimalPos,
                                        (double)(billValidatorSetup.byBillValue[byCashPos] * billValidatorSetup.wScaleFactor) /
                                        wCurrencyDivider, (eAudit == TEMPORARY) ? auditData.data.wNumberChannelBV[byCashPos] :
                                        auditDataPermanent.data.wNumberChannelBV[byCashPos]);
                        }
                        break;
                    }
                    case SCREENCUMUL:
                    {
                        vDisplayLCD("%s%8s%c", byTexte[(wEcran == SCREENBILLACCEPTED) ? CUMUL : DSPTIMEREMAINING], byTexte[DISABLE], !*(BYTE*)vParameter ? 127 : 32);
                        vDisplayLCD("%8s%c", byTexte[ENABLE], *(BYTE*)vParameter ? 127 : 32);
                        LCDGotoXY(1, 2);
                        vDisplayLCD("(*)%-17s(#)%-17s", byTexte[BACK], byTexte[NEXT]);
                        break;
                    }

                    default:
                    {
                        break;
                    }
                }
            }
            if((byCashPos < MAXCASHCHANNELS) && (byIndexSelectedMachine < MAXMACHINES))
            {
                LCDGotoXY(1, 2);
                vDisplayLCD("(*)%-17s(#)%-17s", byTexte[BACK], byTexte[NEXT]);
            }
            else
            {
                byCashPos = 0;
                byIndexSelectedMachine = 0;
                ((!isRAZEnable || (eAudit == PERMANENT)) && (wEcran == SCREENINBV)) ? wEcran = SCREENAUDIT : wEcran++;
                byIndex = 0XFF;
                xQueueSendToBack(queueKeyHit, &byIndex, 0);
            }
            break;
        }
        case SCREENRAZAUDIT:
        {
            vDisplayLCD("%s %s %s", byTexte[RAZAUDIT], byTexte[NO], byTexte[YES]);
            break;
        }
        case SCREENHISTORIQUE:
        {
            vDisplayLCD("%s", (BYTE*)vParameter);
            LCDGotoXY(1, 2);
            vDisplayLCD("(0)%s  (1)%s  %s", byTexte[BACK], byTexte[NEXT], byTexte[EXIT]);
            byIndex = 0XFF; //Empêche le délai pour l'affichage;
            break;
        }
        case SCREENFILLING:
        {
            xTimerStart(hTimerTOKBD, 1000);
            isFillingInProgress = TRUE;
            if(*(BYTE*)vParameter == 0XFF)
            {
                lAmountCG = 0;
                isEnableChanger(TRUE, &centralParameters.coinType);
                DelayMs(10);
            }
            vDisplayLCD("%s %.*f\7 %s %.*f\7", byTexte[COIN], byDecimalPos, *(BYTE*)vParameter > 0X0F ? 0 :
                        (double)(changeGiverConfig.byCoinValue[*(BYTE*)vParameter] * changeGiverConfig.deviceConfig.byScaleFactor) / wCurrencyDivider,
                        byTexte[TOTAL], byDecimalPos, (double)lAmountCG / wCurrencyDivider);
            LCDGotoXY(1, 2);
            vDisplayLCD("%s %s", byTexte[INSERTCOIN], byTexte[EXIT]);
            break;
        }

    }

    LCD_CURSOR_SET(wEcran == SCREENDATETIME ||
                   wEcran == SCREENPRICECASH ||
                   wEcran == SCREENPRICECASHLESS ||
                   wEcran == SCREENPRICECASH_HH ||
                   wEcran == SCREENNUMMACHINE ||
                   wEcran == SCREENPRICECASHLESS_HH ||
                   wEcran == SCREENEXACTCHANGE ||
                   wEcran == SCREENPULSE ||
                   wEcran == SCREENOVERBUSY ||
                   wEcran == SCREENTO_KBD ||
                   wEcran == SCREENTOCUMUL ||
                   wEcran == SCREENTO_OVERPAY ||
                   wEcran == SCREENMESSAGEDELAY ||
                   wEcran == SCREENBEGIN ||
                   wEcran == SCREENEND ||
                   wEcran == SCREENBEGINHH ||
                   wEcran == SCREENENDHH ||
                   wEcran == SCREENMODIFNUMMACHINE ||
                   wEcran == SCREENSATELLITEREMOVE ||
                   wEcran == SCREENREFMACHINE ||
                   wEcran == SCREENTIMETODSP ||
                   wEcran == SCREENBUSYLEVEL ||
                   wEcran == SCREENPWLOCALTECH ||
                   wEcran == SCREENPWLOCALCOMPTA ||
                   wEcran == SCREENPWHTTPTECH ||
                   wEcran == SCREENPWHTTPCOMPTA ||
                   wEcran == SCREENREQUESTPW);

    if(!(wEcran == SCREENSATELLITEREMOVE ||
         wEcran == SCREENDATETIME ||
         wEcran == SCREENSATELLITEAUTO ||
         wEcran == SCREENNUMMACHINE ||
         wEcran == SCREENMODIFNUMMACHINE ||
         wEcran == SCREENREFMACHINE ||
         wEcran == SCREENPRICECASHLESS ||
         wEcran == SCREENPRICECASH_HH ||
         wEcran == SCREENPRICECASHLESS_HH ||
         wEcran == SCREENEXACTCHANGE ||
         wEcran == SCREENPULSE ||
         wEcran == SCREENDSPTIMEREMAINING ||
         wEcran == SCREENOVERBUSY ||
         wEcran == SCREENTO_KBD ||
         wEcran == SCREENTOCUMUL ||
         wEcran == SCREENTO_OVERPAY ||
         wEcran == SCREENMESSAGEDELAY ||
         wEcran == SCREENBEGIN ||
         wEcran == SCREENEND ||
         wEcran == SCREENBEGINHH ||
         wEcran == SCREENENDHH ||
         wEcran == SCREENSATELLITEREMOVECONFIRM ||
         wEcran == SCREENRAZAUDIT ||
         wEcran == SCREENPRICECASH ||
         wEcran == SCREENTIMETODSP ||
         wEcran == SCREENBUSYLEVEL ||
         wEcran == SCREENPWLOCALTECH ||
         wEcran == SCREENPWLOCALCOMPTA ||
         wEcran == SCREENPWHTTPTECH ||
         wEcran == SCREENPWHTTPCOMPTA ||
         wEcran == SCREENREQUESTPW))
    {

        xTimerStart(hTimerFlip, 1000);
    }
}

/******************************************************************************/

static void vConfigDevices(BYTE byKey)
{
    isReturnMaintenance = TRUE;
    ptrParameterMenu = NULL;
    if(byKey == STAR)
    {
        wEcran = SCREENCONFIGURATION;
    }
    else
    {
        wEcran = byKey + SCREENPERIPHERIQUE;
        switch(wEcran)
        {
            case SCREENCHANGEGIVER:
            {
                if(isChangerReseted)
                {
                    centralParameters.coinType.wCoinEnable = WORD_SWAP(centralParameters.coinType.wCoinEnable);
                    ptrParameterMenu = &byCashPos;
                }
                else
                {
                    wEcran = SCREENPERIPHERIQUE;
                }
                break;
            }
            case SCREENBILLVALIDATOR:
            {
                if(isBillValidatorReseted)
                {
                    centralParameters.billType.wBillEnable = WORD_SWAP(centralParameters.billType.wBillEnable);
                    ptrParameterMenu = &byCashPos;
                }
                else
                {
                    wEcran = SCREENPERIPHERIQUE;
                }
                break;
            }
            case SCREENCASHLESS:
            {
                break;
            }
            default:
            {

                wEcran = SCREENPERIPHERIQUE;
                break;
            }
        }
    }
    byCashPos = 0;
}

/******************************************************************************/

static void vScreenMainMaintenance(const BYTE byKey)
{
    isReturnMaintenance = TRUE;
    switch(byKey)
    {
        case STAR:
        {
            vReturnFromTest();
            break;
        }
        case KEYMENUCONFIGURATION:
        {
            if(isConfigEnable)
            {
                wEcran = SCREENCONFIGURATION;
            }
            break;
        }
        case KEYMEBUAUDIT:
        {
            if(isAuditEnable && isLocalAccountantEnable)
            {
                wEcran = SCREENAUDIT;
            }
            break;
        }
        case KEYMENUHISTO:
        {
            if(isHistoEnable)
            {
                sender = MAINMAINTENANCE;
                vScreenHistorique(0xFF);
                wEcran = SCREENHISTORIQUE;
            }
            break;
        }
        case KEYMENUREFILLING:
        {
            if(isRefillingEnable)
            {
                wEcran = SCREENFILLING;
                byCashPos = 0XFF;
                ptrParameterMenu = &byCashPos;
                lAmountCG = 0x00;
            }
            break;
        }
        default:
        {

            break;
        }
    }
}

/******************************************************************************/

static void vScreenCashDevice(BYTE byKey)
{
    switch(byKey)
    {
        case 0:
        case 1:
        {
            if(wEcran == SCREENCHANGEGIVER)
            {
                centralParameters.coinType.wCoinEnable = byKey == 1 ? centralParameters.coinType.wCoinEnable | (1 << byCashPos) : centralParameters.coinType.wCoinEnable & ~(1 << byCashPos);
            }
            else
            {
                centralParameters.billType.wBillEnable = byKey == 1 ? centralParameters.billType.wBillEnable | (1 << byCashPos) : centralParameters.billType.wBillEnable & ~(1 << byCashPos);
            }
            isFlip = FALSE;
            vDisplayCashEnable(byCashPos, (byKey == 1));
            DelayMs(centralParameters.lDelayDisplay);
            break;
        }
        case STAR:
        {
            LCDClear();
            isFlip = FALSE;
            if(wEcran == SCREENCHANGEGIVER)
            {
                if(isChangerReseted)
                {
                    centralParameters.coinType.wCoinEnable = WORD_SWAP(centralParameters.coinType.wCoinEnable);
                    I2CE2promLWriteBuffer(ADDRESS_CENTRAL_PARAMETERS, &centralParameters, sizeof (centralParameters));
                    vDisplayLCD("%s", byTexte[REGISTRED]);
                }
            }
            else
            {
                if(isBillValidatorReseted)
                {
                    centralParameters.billType.wBillEnable = WORD_SWAP(centralParameters.billType.wBillEnable);
                    I2CE2promLWriteBuffer(ADDRESS_CENTRAL_PARAMETERS, &centralParameters, sizeof (centralParameters));
                    vDisplayLCD("%s", byTexte[REGISTRED]);
                }
            }
            DelayMs(centralParameters.lDelayDisplay);
            break;
        }
        default:
        {
            break;
        }
    }
    if((byKey < 2) || (byKey > 9))
    {
        if(wEcran == SCREENCHANGEGIVER)
        {
            do
            {
                if(++byCashPos == MAXCASHCHANNELS)
                {
                    byCashPos = 0;
                }
                if(changeGiverConfig.byCoinValue[byCashPos] == 0xFF ||
                   changeGiverConfig.byCoinValue[byCashPos] == 0x00)
                {
                    centralParameters.coinType.wCoinEnable = centralParameters.coinType.wCoinEnable & ~(1 << byCashPos);
                }
            }while(changeGiverConfig.byCoinValue[byCashPos] == 0xFF ||
                   changeGiverConfig.byCoinValue[byCashPos] == 0x00);
        }
        else
        {
            do
            {
                if(++byCashPos == MAXCASHCHANNELS)
                {
                    byCashPos = 0;
                }
                if(billValidatorSetup.byBillValue[byCashPos] == 0xFF ||
                   billValidatorSetup.byBillValue[byCashPos] == 0x00)
                {
                    centralParameters.billType.wBillEnable = centralParameters.billType.wBillEnable & ~(1 << byCashPos);
                }
            }while(billValidatorSetup.byBillValue[byCashPos] == 0xFF ||
                   billValidatorSetup.byBillValue[byCashPos] == 0x00);
        }
    }
    if(byKey == STAR)
    {

        wEcran = SCREENPERIPHERIQUE;
    }
    ptrParameterMenu = &byCashPos;
    isReturnMaintenance = TRUE;
}

/******************************************************************************/

static void vScreenCashLess(BYTE byKey)
{
    switch(byKey)
    {
        case 1:
        {
            centralParameters.byCLAddress = CASHLESS1;
            break;
        }
        case 2:
        {
            centralParameters.byCLAddress = CASHLESS2;
            break;
        }
        case STAR:
        {
            I2CE2promLWriteBuffer(ADDRESS_CENTRAL_PARAMETERS, &centralParameters, sizeof (centralParameters));
            wEcran = SCREENPERIPHERIQUE;
            LCDClear();
            isFlip = FALSE;
            vDisplayLCD("%s", byTexte[REGISTRED]);
            DelayMs(centralParameters.lDelayDisplay);
            break;
        }
        default:
        {

            break;
        }
    }
    ptrParameterMenu = NULL;
    isReturnMaintenance = TRUE;
}

/******************************************************************************/

static void vScreenSatellite(BYTE byKey)
{
    switch(byKey)
    {
        case STAR:
        {
            wEcran = SCREENCONFIGURATION;
            break;
        }
        case KEYREMOVESATELLITE:
            //        {
            //            sender = REMOVEALLSATTELITE;
            //        }
            /* fall through */
        case KEYSATELLITEMANUAL:
        case KEYSATELLITEMODIF:
        case KEYONESATELLITEREMOVE:
        {
            wEcran = SUBSATELLITE + byKey;
            break;
        }
        default:
        {

            break;
        }
    }
    ptrParameterMenu = NULL;
    isReturnMaintenance = TRUE;
}

/******************************************************************************/

static void vSetDateTime(const rtccDate date, const rtccTime time)
{
    rtccDate DSTdate;
    LCD_CURSOR_OFF();
    LCDClear();
    vDisplayLCD("%s", byTexte[REGISTRED]);
    RtccSetTimeDate(time.l, date.l);
    DSTdate = getDSTDate(((date.year >> 4) * 10) + (date.year & 0X0F) + 2000, SUMMER);
    if(DSTdate.l <= date.l)
    {

        DSTdate = getDSTDate(((date.year >> 4) * 10) + (date.year & 0X0F) + 2000, WINTER);
    }
    DSTdate.wday = RtccWeekDay(((DSTdate.year >> 4) * 10) + (DSTdate.year & 0x0F) + 2000,
                               ((DSTdate.mon >> 4) * 10) + (DSTdate.mon & 0X0F),
                               ((DSTdate.mday >> 4) * 10) + (DSTdate.mday & 0X0F));
    RtccSetAlarmTimeDate(0x02000000, DSTdate.l);
    DelayMs(centralParameters.lDelayDisplay);
    wEcran = SCREENCONFIGURATION;
    vMaintenanceMenu(NULL);
}

/******************************************************************************/

static BYTE byGetCharUnderCursor(void)
{

    BYTE byResult;
    setLCDAddressCounter(getLCDAddress());
    byResult = getLCDC();
    setLCDAddressCounter(getLCDAddress() - 1);
    return byResult;
}

/******************************************************************************/

static void vScreenDateTime(BYTE byKey)
{
    isReturnMaintenance = FALSE;
    switch(byKey)
    {
        case STAR:
            // <editor-fold defaultstate="collapsed" desc="Touche annulation">
        {
            if(!byPosNum)
            {
                LCD_CURSOR_OFF();
                wEcran = SCREENCONFIGURATION;
                isReturnMaintenance = TRUE;
            }
            else
            {
                byPosNum--;
                setLCDAddressCounter(getLCDAddress() - 1 -
                                     (byPosNum % 2) -
                                     (strlen(byTexte[DATE]) + 1) *
                                     ((BYTE)(byPosNum == 5)) -
                                     (2 * (BYTE)(byPosNum == 9)));
            }
            break;
        }
            // </editor-fold>
        case SHARP:
            // <editor-fold defaultstate="collapsed" desc="Touche acceptation">
        {
            if(byPosNum)
            {
                byKey = (byGetCharUnderCursor() & 0X0F);
            }
            else
            {
                byPosNum = 11;
            }
        }
            /* fall through */
            // </editor-fold>
        default:
            // <editor-fold defaultstate="collapsed" desc="Touches numériques">
        {
            switch(byPosNum)
            {
                case 0:
                {
                    if(byKey < 3)
                    {
                        Now.hour = (byKey << 4);
                        vDisplayLCD("%u", byKey);
                        byPosNum++;
                    }
                    break;
                }
                case 1:
                {
                    if((byKey < 4) || ((Now.hour >> 4) < 2))
                    {
                        Now.hour += byKey;
                        vDisplayLCD("%u:", byKey);
                        byPosNum++;
                    }
                    break;
                }
                case 2:
                case 4:
                {
                    if(byKey < 7)
                    {
                        (byPosNum == 2) ? (Now.min = (byKey << 4)) : (Now.sec = (byKey << 4));
                        vDisplayLCD("%u", byKey);
                        byPosNum++;
                    }
                    break;
                }
                case 3:
                case 5:
                {
                    (byPosNum == 3) ? (Now.min += byKey) : (Now.sec += byKey);
                    vDisplayLCD("%u", byKey);
                    (byPosNum == 3) ? vDisplayLCD("%c", ':') :
                        setLCDAddressCounter(strlen(byTexte[HEURE]) + strlen(byTexte[DATE]) + 11);
                    byPosNum++;
                    break;
                }
                case 6:
                {
                    if(byKey < 4)
                    {
                        Today.mday = byKey << 4;
                        vDisplayLCD("%u", byKey);
                        byPosNum++;
                    }
                    break;
                }
                case 7:
                {
                    Today.mday += byKey;
                    vDisplayLCD("%u-", byKey);
                    byPosNum++;
                    break;
                }
                case 8:
                {
                    if(byKey < 2)
                    {
                        Today.mon = byKey << 4;
                        vDisplayLCD("%u", byKey);
                        byPosNum++;
                    }
                    break;
                }
                case 9:
                {
                    if(!Today.mon || byKey < 3)
                    {
                        Today.mon += byKey;
                        vDisplayLCD("%u%s", byKey, "-20");
                        byPosNum++;
                    }
                    break;
                }
                case 10:
                {
                    Today.year = byKey << 4;
                    vDisplayLCD("%u", byKey);
                    byPosNum++;
                    break;
                }
                case 11:
                {
                    if(byKey < 10)
                    {
                        Today.year += byKey;
                        vDisplayLCD("%u", byKey);
                    }
                    vSetDateTime(Today, Now);
                    break;
                }
                default:
                {

                    break;
                }
            }
            break;
        }
            // </editor-fold>
    }
}

/******************************************************************************/

static void vScreenConfiguration(BYTE byKey)
{
    isReturnMaintenance = TRUE;
    switch(byKey)
    {
        case STAR:
        {
            wEcran = SCREENMAINMAINTENANCE;
            break;
        }
        case KEYCENTRALCONFIG:
        {
            wEcran = SCREENBUZZER;
            break;
        }
        case KEYPERIPHERIQUES:
        {
            wEcran = SCREENPERIPHERIQUE;
            break;
        }
        case KEYSATELLITES:
        {
            wEcran = SCREENSATELLITE;
            break;
        }
        case KEYDATETIME:
        {
            wEcran = SCREENDATETIME;
            break;
        }
        default:
        {

            break;
        }
    }
}

/******************************************************************************/

static void vScreenDspTimeRemaining(BYTE byKey)
{
    ptrParameterMenu = NULL;
    switch(byKey)
    {
        case STAR:
        {
            dwValue = modules[byIndexSelectedMachine].config.lPulseInMS < UINT_MAX ? modules[byIndexSelectedMachine].config.lPulseInMS : 0;
            wEcran = SCREENPULSE;
            ptrParameterMenu = &dwValue;
            break;
        }
        case 1:
        case 0:
        {
            modules[byIndexSelectedMachine].config.isDisplayedTimeRemaining = (BOOL)byKey;
        }
            //Pas de break pour effectuer une validation.
        case SHARP:
        {
            dwValue = modules[byIndexSelectedMachine].config.lTimeToDisplay < UINT_MAX ? modules[byIndexSelectedMachine].config.lTimeToDisplay : 0;
            wEcran = SCREENTIMETODSP;
            ptrParameterMenu = &dwValue;
            break;
        }
        default:
        {

            break;
        }
    }
    isReturnMaintenance = TRUE;
}

/******************************************************************************/

static void vScreenCumul(BYTE byKey)
{
    ptrParameterMenu = NULL;
    switch(byKey)
    {
        case STAR:
        {
            dwValue = modules[byIndexSelectedMachine].config.utEndHH.l < UINT_MAX ? modules[byIndexSelectedMachine].config.utEndHH.l : 0;
            wEcran = SCREENENDHH;
            ptrParameterMenu = &dwValue;
            break;
        }
        case 1:
        case 0:
        {
            modules[byIndexSelectedMachine].config.isCumulEnable = (BOOL)byKey;
        } //Pas de break pour effectuer une validation.
        case SHARP:
        {
            LCDClear();
            if(modules[byIndexSelectedMachine].config.isCumulEnable != 1)
            {
                modules[byIndexSelectedMachine].config.isCumulEnable = 0;
            }
            dwValue = modules[byIndexSelectedMachine].config.BusyLevel.wBusyLevel < UINT16_MAX ? modules[byIndexSelectedMachine].config.BusyLevel.wBusyLevel : 1000;
            wEcran = SCREENBUSYLEVEL;
            ptrParameterMenu = &dwValue;
            break;
        }
        default:
        {

            break;
        }
    }
    isReturnMaintenance = TRUE;
}

/******************************************************************************/

static void vScreenBillAccepted(BYTE byKey)
{
    ptrParameterMenu = NULL;
    switch(byKey)
    {
        case STAR:
        {
            dwValue = modules[byIndexSelectedMachine].config.BusyLevel.wBusyLevel < UINT16_MAX ? modules[byIndexSelectedMachine].config.BusyLevel.wBusyLevel : 1000;
            wEcran = SCREENBUSYLEVEL;
            ptrParameterMenu = &dwValue;
            break;
        }
        case 1:
        case 0:
        {
            modules[byIndexSelectedMachine].config.isBillAccepted = (BOOL)byKey;
        } //Pas de break pour effectuer une validation.
        case SHARP:
        {
            LCDClear();
            //Rev 1.2.3 
            if(modules[byIndexSelectedMachine].config.isBillAccepted)
            {
                modules[byIndexSelectedMachine].config.isBillAccepted = 1;
            }
            dwValue = modules[byIndexSelectedMachine].config.isMachinePowered < 2 ? modules[byIndexSelectedMachine].config.isMachinePowered : TRUE;
            wEcran = SCREENPOWER;
            ptrParameterMenu = &dwValue;
            break;
        }
        default:
        {

            break;
        }
    }
    isReturnMaintenance = TRUE;
}

/******************************************************************************/

static void vRecordMachineData()
{
    memset(bySatBuffer, 0, sizeof (bySatBuffer));
    if(isModifyMachineNumber(sender == MODIFMACHINES ? byNumMachine : 0XFF,
                             modules[byIndexSelectedMachine].config.byNumero) &&
       isSetOverBusyDelay(modules[byIndexSelectedMachine].config.byNumero,
                          modules[byIndexSelectedMachine].config.lOverBusy) &&
       isSetSensibility(modules[byIndexSelectedMachine].config.byNumero,
                        modules[byIndexSelectedMachine].config.BusyLevel.wBusyLevel) &&
       isSetMainPowerRelayState(modules[byIndexSelectedMachine].config.byNumero,
                                !(ESTATE)modules[byIndexSelectedMachine].config.isMachinePowered))
    {
        isFlip = FALSE;
        vDisplayLCD(byTexte[MACHINEREGISTERED], modules[byIndexSelectedMachine].config.byNumero);
        if(modules[byIndexSelectedMachine].config.utEndSelect.l == 0)
        {
            modules[byIndexSelectedMachine].config.utEndSelect.l = 0X23595900; //23h59m59s
        }
        I2CE2promLWriteBuffer(ADDRESS_MACHINES_PARAMETERS + (byIndexSelectedMachine * sizeof (SMACHINE_CONFIG)),
                              &modules[byIndexSelectedMachine].config, sizeof (SMACHINE_CONFIG));
        isSetMainPowerRelayState(modules[byIndexSelectedMachine].config.byNumero, !(ESTATE)modules[byIndexSelectedMachine].config.isMachinePowered);
        ;
    }
    else
    {

        vDisplayLCD(" %s", byTexte[FAILEDRECORD]);
        memset(&modules[byIndexSelectedMachine].config, 0X00, sizeof (SMACHINE_CONFIG));
        modules[byIndexSelectedMachine].config.byNumero = 0XFF;
    }
    DelayMs(centralParameters.lDelayDisplay);
    wEcran = SCREENSATELLITE;
}

/******************************************************************************/

static void vScreenPower(BYTE byKey)
{
    ptrParameterMenu = NULL;
    switch(byKey)
    {
        case STAR:
        {
            dwValue = modules[byIndexSelectedMachine].config.isBillAccepted < 2 ? modules[byIndexSelectedMachine].config.isBillAccepted : TRUE;
            wEcran = SCREENBILLACCEPTED;
            ptrParameterMenu = &dwValue;
            break;
        }
        case 1:
        case 0:
        {
            modules[byIndexSelectedMachine].config.isMachinePowered = (BOOL)byKey;
        } //Pas de break pour effectuer une validation.
        case SHARP:
        {
            LCDClear();
            //Rev 1.2.3 
            if(modules[byIndexSelectedMachine].config.isMachinePowered)
            {
                modules[byIndexSelectedMachine].config.isMachinePowered = 1;
            }
            vRecordMachineData();
            break;
        }
        default:
        {

            break;
        }
    }
    isReturnMaintenance = TRUE;
}

/******************************************************************************/

static long lConvertTimetoMS(const rtccTime * time)
{

    return ((time->sec & 0X0F) + ((time->sec >> 4) * 10) +
            ((time->min & 0X0F) * 60) + ((time->min >> 4) * 600)+
            ((time->hour & 0X0F)*3600) + ((time->hour >> 4) * 36000)) * 1000;
}

/******************************************************************************/

static void vDisplayTimeInfo(DWORD dwTimeInMS)
{
    BYTE byHeure, byMinute, bySeconde = 0;
    DWORD dwDisplayTimer = dwTimeInMS / 1000;
    //    WORD wDisplayTime = modules[byIndexSelectedMachine].config.wDisplayedTime;
    byLCDAddressCounter = getLCDAddress();
    byHeure = dwDisplayTimer / 3600;
    dwDisplayTimer %= 3600;
    byMinute = dwDisplayTimer / 60;
    bySeconde = dwDisplayTimer % 60;
    memset(byBuffer, 0, sizeof (byBuffer));

    if(byHeure)
    {
        snprintf(&byBuffer[strlen(byBuffer)], 4, "%uh ", byHeure);
    }
    if(byHeure || byMinute)
    {
        snprintf(&byBuffer[strlen(byBuffer)], 10, byHeure ? "%02um " : "%u' ", byMinute);
    }
    if(bySeconde)
    {

        snprintf(&byBuffer[strlen(byBuffer)], 11, "%u\"", bySeconde);
    }
    vDisplayLCD("%-10s", byBuffer);
}

/******************************************************************************/

static BYTE byMachineAvailable(rtccTime * time, const BYTE byNumMachine)
{
    long lTime = lConvertTimetoMS(time);
    if((byIndexSelectedMachine = byMachineExist(byNumMachine)) >= MAXMACHINES)
    {
        return NONEXISTENT;
    }

    //Vérifie la communication avec le satelleite et la présence secteur.
    if(!isSimplePoll(modules[byIndexSelectedMachine].config.byNumero))
    {
        return MACHINEMISSING;
    }

#ifndef __L_DEBUG
    if(!isMainPresent(modules[byIndexSelectedMachine].config.byNumero))
    {
        return MAINMISSING;
    }
#endif

    //Vérifie la plage horaire.
    if(!(((modules[byIndexSelectedMachine].config.utBeginSelect.l <= modules[byIndexSelectedMachine].config.utEndSelect.l) &&
          (time->l >= modules[byIndexSelectedMachine].config.utBeginSelect.l) && (time->l <= modules[byIndexSelectedMachine].config.utEndSelect.l)) ||
         ((modules[byIndexSelectedMachine].config.utBeginSelect.l > modules[byIndexSelectedMachine].config.utEndSelect.l) &&
          (time->l <= modules[byIndexSelectedMachine].config.utBeginSelect.l) && (time->l >= modules[byIndexSelectedMachine].config.utEndSelect.l))))
    {
        return OVERTIME;
    }

    //Vérifie le niveau de la machine.
    if(getMachineFull(modules[byIndexSelectedMachine].config.byNumero) == EMPTY)
    {
        return TEXTEMPTY;
    }

    //Verifie si le cumul est autorisé. Si le cumul est autorisé les test des
    //délais d'occupation et d'activation ne sont effecutés.
    if(!modules[byIndexSelectedMachine].config.isCumulEnable)
    {
        if(getMachineState(modules[byIndexSelectedMachine].config.byNumero) == MACHINE_BUSY)
        {
            return OCCUPIED;
        }
        //Verifie l'activation et le temps restant.
        if(modules[byIndexSelectedMachine].lEndActivation && lTime < modules[byIndexSelectedMachine].lEndActivation)
        {
            if(modules[byIndexSelectedMachine].config.isDisplayedTimeRemaining)
            {
                LCDClear();
                vDisplayLCD("%s %s ", byTexte[OCCUPIED], byTexte[REMAININGTIME]);
                vDisplayTimeInfo(modules[byIndexSelectedMachine].lEndActivation - lTime);
            }
            else
            {
                //vDisplayLCD("%s", byTexte[MACHINEMISSING]);

                return OCCUPIED;
            }
            //xSemaphoreTake(hSemaphoreMDB, 1000);
            DelayMs(centralParameters.lDelayDisplay);
            //xSemaphoreGive(hSemaphoreMDB);
            return UCHAR_MAX;
        }
    }
    return 0;
}

/******************************************************************************/

static long lGetAmountToPay(const BYTE byNumMachine)
{
    BYTE byIndexSelectedSatellite = byMachineExist(byNumMachine);
    BOOL isHappyHour = ((modules[byIndexSelectedSatellite].config.utBeginHH.l < modules[byIndexSelectedSatellite].config.utEndHH.l) &&
                        (Now.l >= modules[byIndexSelectedSatellite].config.utBeginHH.l) && (Now.l <= modules[byIndexSelectedSatellite].config.utEndHH.l)) ||
        ((modules[byIndexSelectedSatellite].config.utBeginHH.l > modules[byIndexSelectedSatellite].config.utEndHH.l) &&
         (Now.l <= modules[byIndexSelectedSatellite].config.utBeginHH.l) && (Now.l >= modules[byIndexSelectedSatellite].config.utEndHH.l));
    if(isKeyPresent)
    {

        return isHappyHour ? modules[byIndexSelectedSatellite].config.wCashLessPriceHH : modules[byIndexSelectedSatellite].config.wCashLessPrice;
    }
    return isHappyHour ? modules[byIndexSelectedSatellite].config.wCashPriceHH : modules[byIndexSelectedSatellite].config.wCashPrice;
}

/******************************************************************************/

static void vEnableCashDevice(const BOOL isEnable, const BYTE byIndexMachine)
{
    DelayMs(50);
    isEnableChanger(isEnable, &centralParameters.coinType);
    DelayMs(50);
    isEnableBillValidator(isEnable && ((byIndexMachine == 100) || modules[byIndexMachine].config.isBillAccepted),
                          centralParameters.isEscrow && billValidatorSetup.byEscrow,
                          &centralParameters.billType);

}

/******************************************************************************/

/*********************************************************************
 * Function:        BYTE byCheckMachine(const BYTE byNumber)
 *
 * PreCondition:    None
 *
 * Input:           byNumber Numéro de la machine à vérifier.
 *
 * Output:          None
 *
 * Return:	    0 si la machine est disponible, sinon l'index du message à
 *		    afficher sur l'état du module.
 *
 * Side Effects:    None
 *
 * Overview:        Lit l'heure actuelle de la centrale
 *		    Vérifie si un satellite a le numéro de machine passé en
 *		    paramètre et si l'heure de sélection est autorisée.
 *		    Si non le résultat du test sera 0XFF et le numéro
 *		    du message retourné sera le résultat du test.
 *		    Si le résultat du test précédent est 0, on continue.
 *		    On habilite les système de paiement.
 *		    On accorde un délai à l'affichage du numéro de machine.
 *		    Et ensuite on affiche le prix demandé.
 *		    Le cas écheant on affiche le temps à cumuler.
 *
 * Note:            None
 ********************************************************************/
static BYTE byCheckMachine(const BYTE byNumber)
{
    BYTE byResult = SELECTION_MACHINE;
    Now.l = RtccGetTime();
    byResult = byMachineAvailable(&Now, byNumber);

    if(!byResult)
    {
        //xSemaphoreTake(hSemaphoreMDB, 5000);
        vEnableCashDevice(TRUE, byIndexSelectedMachine);
        //xSemaphoreGive(hSemaphoreMDB);
        if(sender != USER)
        {
            DelayMs(centralParameters.lDelayDisplay);
        }
        snprintf(byBuffer, 40, "%s %u: ", byTexte[NUMMACHINE], byNumber); //, isKeyPresent ? byTexte[AMOUNT] : "");
        vDisplayAmount((lAmountToPay = lGetAmountToPay(byNumber)), byBuffer, TRUE);

        if(modules[byIndexSelectedMachine].config.isDisplayedTimeRemaining)
        {
            vDisplayLCD("%c", '+');
            vDisplayTimeInfo(modules[byIndexSelectedMachine].config.lPulseInMS);
            isDisplayTime = modules[byIndexSelectedMachine].config.isDisplayedTimeRemaining &&
                modules[byIndexSelectedMachine].config.isCumulEnable;
        }
        else
        {
            if(modules[byIndexSelectedMachine].config.lTimeToDisplay)
            {
                LCDGotoXY(25, 1);
                vDisplayTimeInfo(modules[byIndexSelectedMachine].config.lTimeToDisplay * 1000);
            }
        }
        lOldAmountInCashDispo = LONG_MAX;
    }
    else
    {

        byNumMachine = 0;
    }
    return byResult;
}

/******************************************************************************/

static BOOL isExactChange(const long lAmountToCheck)
{
    BOOL isExact = TRUE;
    DelayMs(10);
    //xSemaphoreTake(hSemaphoreMDB, 5000);
    if(isGetMDBTubeStatus(&tubeStatus))
    {
        BYTE byIndex;
        long lAmountInTube = 0;
        //xSemaphoreGive(hSemaphoreMDB);
        for(byIndex = 0; byIndex < MAXCASHCHANNELS; byIndex++)
        {
            if(changeGiverConfig.byCoinValue[byIndex] < 0xFF)
            {
                lAmountInTube += changeGiverConfig.byCoinValue[byIndex] * changeGiverConfig.deviceConfig.byScaleFactor * tubeStatus.byLevel[byIndex];
            }
        }
        isExact = ((lAmountInTube <= lAmountToCheck) && isChangerReseted);
    }
    //    else
    //    {
    //
    //        xSemaphoreGive(hSemaphoreMDB);
    //    }
    return isExact;
}

/******************************************************************************/

static void vStartBuzzer(BOOL isActive, int iBuzzerLen)
{
    if(isActive)
    {

        BUZZER_ON();
        xTimerChangePeriod(hTimerTOBuzzer, iBuzzerLen, 1000);
    }
}

/******************************************************************************/

static void vSelectMachineError(char *byMessage)
{

    byIndexSelectedMachine = 0xFF;
    byNumMachine = 0;
    vDisplayLCD("%s", byMessage);
    vStartBuzzer(centralParameters.isBuzzer, TOBUZZER * 6);
    DelayMs(centralParameters.lDelayDisplay);
}

/******************************************************************************/

static void vSelectMachine(BYTE byKeyHit)
{
    BYTE byKey = byKeyHit;
    BYTE byIndex, byBackNumMachine = 0;
    isReturnMaintenance = FALSE;
    ptrParameterMenu = NULL;
    xTimerStart(hTimerTOKBD, 1000);
    switch(byKey)
    {
        case STAR:
            // <editor-fold defaultstate="collapsed" desc="Touche annulation">
        {
            switch(sender)
            {
                case USER:
                {
                    //xSemaphoreTake(hSemaphoreMDB, 5000);
                    vEnableCashDevice(FALSE, 0XFF);
                    //xSemaphoreGive(hSemaphoreMDB);
                    if(byPosNum > 1)
                    {
                        isToEscrow = TRUE;
                    }
                    else
                    {
                        byIndexSelectedMachine = 0xFF;
                        byNumMachine = 0;
                        vResetSelectMachine();
                    }
                    break;
                }
                case REFMACHINE:
                {
                    if(byPosNum)
                    {
                        wEcran = SCREENREFMACHINE;
                    }
                    else
                    {
                        //Recherche du nouveau numéro de machine dans la liste pour l'effacer.
                        if((byIndex = byMachineExist(byNumMachine)) < MAXMACHINES)
                        {
                            modules[byIndex].config.byNumero = 0xFF;
                        }
                        wEcran = SCREENSATELLITEMANUAL;
                    }
                    isReturnMaintenance = TRUE;
                    break;
                }
                case REMOVESATELLITE:
                case MODIFMACHINES:
                case MANUALMACHINE:
                {
                    if(byPosNum)
                    {
                        switch(sender)
                        {
                            case MANUALMACHINE:
                            {
                                wEcran = SCREENSATELLITEMANUAL;
                                break;
                            }
                            case MODIFMACHINES:
                            {
                                wEcran = SCREENSATELLTIEMODIF;
                                break;
                            }
                            case REMOVESATELLITE:
                            {
                                wEcran = SCREENSATELLITEREMOVE;
                                break;
                            }
                            default:
                            {
                                break;
                            }
                        }
                    }
                    else
                    {
                        wEcran = SCREENSATELLITE;
                    }
                    isReturnMaintenance = TRUE;
                    break;
                }
                default:
                {
                    break;
                }
            }
            break;
        }
            // </editor-fold>
        case SHARP:
            // <editor-fold defaultstate="collapsed" desc="Touche acceptation">
        {
            if(sender == REFMACHINE)
            {
                memset(&modules[byIndexSelectedMachine].config.wCashPrice, 0xFF,
                       sizeof (SMACHINE_CONFIG) - 1);
                dwValue = (wPrice = (modules[byIndexSelectedMachine].config.wCashPrice < 10000) ? modules[byIndexSelectedMachine].config.wCashPrice : 400);
                wEcran = SCREENPRICECASH;
                ptrParameterMenu = &dwValue;
                isReturnMaintenance = TRUE;
            }
            if(sender == MANUALMACHINE && byPosNum == 1)
            {
                byKey = byGetCharUnderCursor() & 0X0F;
            }
            break;
        }
        default:
        {
            break;
        }
    }
    //            // </editor-fold>
    if(((byKey < 10) || (byKey == 12 && sender == MANUALMACHINE)) && (byPosNum < 2))
    {
        isDisplayTime = FALSE;
        if(byKey == 12 && sender == MANUALMACHINE && !byPosNum)
        {
            byPosNum = 1;
            byKey = byGetCharUnderCursor() & 0X0F;
        }
        else
        {
            byNumMachine = byPosNum ? byNumMachine + byKey : byKey * 10;
        }
        vDisplayLCD("%u", byKey);
        if(byPosNum++)
        {
            LCD_CURSOR_OFF();
            LCDClear();
            vDisplayLCD("%s %u  ", byTexte[SELECTED], byNumMachine);
            if(sender != USER)
            {
                DelayMs(centralParameters.lDelayDisplay);
            }
            switch(sender)
            {
                case USER:
                {
                    byBackNumMachine = byNumMachine;
                    vSetHisto((byIndex = byCheckMachine(byNumMachine)), byBackNumMachine, SELECTION, lAmountToPay, byIndex > 0 ? FAIL : SUCCESSFUL);
                    if(byIndex)
                    {
                        if(byIndex != 0XFF)
                        {
                            vSelectMachineError(byTexte[byIndex]);
                        }
                        vResetSelectMachine();
                    }
                    else
                    {
                        if(!isKeyPresent && !isThumbDriveAttached)
                        {
                            if(!lAmountInCashDispo && byPosNum && isChangerReseted && isExactChange(centralParameters.wAmountExactChange))
                            {
                                vWarning(byTexte[EXACTCHANGE]);
                            }
                        }
                    }
                    break;
                }
                case MANUALMACHINE:
                {
                    byIndexSelectedMachine = 0;
                    while(modules[byIndexSelectedMachine].config.byNumero != 0XFF && byIndexSelectedMachine++ < MAXMACHINES);
                    if(byIndexSelectedMachine == MAXMACHINES || (byMachineExist(byNumMachine) < MAXMACHINES))
                    {
                        vSelectMachineError(byTexte[byIndexSelectedMachine == MAXMACHINES ? TOOMANYMACHINE : MACHINEEXIST]);
                        wEcran = SCREENSATELLITEMANUAL;
                        isReturnMaintenance = TRUE;
                    }
                    else
                    {
                        modules[byIndexSelectedMachine].config.byNumero = byNumMachine;
                        byPosNum = 0;
                        wEcran = SCREENREFMACHINE;
                        isReturnMaintenance = TRUE;
                    }
                    break;
                }
                case MODIFMACHINES:
                {
                    byIndexSelectedMachine = byMachineExist(byNumMachine);
                    if(byIndexSelectedMachine >= MAXMACHINES)
                    {
                        vDisplayLCD("%s", byTexte[MACHINEMISSING]);
                        DelayMs(centralParameters.lDelayDisplay);
                        wEcran = SCREENSATELLITE; // SCREENSATELLITEMANUAL;
                        isReturnMaintenance = TRUE;
                    }
                    else
                    {
                        dwValue = wPrice = modules[byIndexSelectedMachine].config.wCashPrice;
                        wEcran = SCREENPRICECASH;
                        ptrParameterMenu = &dwValue;
                        isReturnMaintenance = TRUE;
                        byPosNum = 0;
                    }
                    break;
                }
                case REFMACHINE:
                {
                    BYTE byIndexRefMachine;

                    // Copie du numéro de machine choisie comme numéro de machine de référence et recherche de l'index de cette machine
                    byIndexRefMachine = byMachineExist(byNumRefMachine = byNumMachine);
                    if(byIndexRefMachine == byIndexSelectedMachine || byIndexRefMachine == MAXMACHINES)
                    {
                        vSelectMachineError(byTexte[MACHINEMISSING]);
                        isReturnMaintenance = TRUE;
                    }
                    else
                    {
                        memcpy(&modules[byIndexSelectedMachine].config.wCashPrice, &modules[byIndexRefMachine].config.wCashPrice, (sizeof (SMACHINE_CONFIG) - sizeof (BYTE)));
                        dwValue = (wPrice = modules[byIndexSelectedMachine].config.wCashPrice < 10000 ? modules[byIndexSelectedMachine].config.wCashPrice : 9999);
                        wEcran = SCREENPRICECASH;
                        ptrParameterMenu = &dwValue;
                        isReturnMaintenance = TRUE;
                        byPosNum = 0;
                    }
                    break;
                }
                case REMOVESATELLITE:
                {
                    byIndexSelectedMachine = byMachineExist(byNumMachine);
                    if(byIndexSelectedMachine >= MAXMACHINES)
                    {
                        vDisplayLCD("%s", byTexte[MACHINEMISSING]);
                        wEcran = SCREENSATELLITE;
                        DelayMs(centralParameters.lDelayDisplay);
                    }
                    else
                    {
                        wEcran = SCREENSATELLITEREMOVECONFIRM;
                    }
                    ptrParameterMenu = NULL;
                    isReturnMaintenance = TRUE;
                    byPosNum = 0;
                    break;
                }
                default:
                {
                    break;
                }
            }
        }
        else
        {

            byLCDAddressCounter = getLCDAddress();
            LCDGotoXY(23, 1);
            vDisplayLCD("%18s", byTexte[CORRECT]);
            setLCDAddressCounter(byLCDAddressCounter);
        }
        // </editor-fold>
    }
}

/******************************************************************************/

static void vGetDigitNumber(DWORD dwNumber,
                            BYTE *byBillion, BYTE *byHundredMillion, BYTE *byTenMillion,
                            BYTE *byMillions, BYTE *byHundredThousand, BYTE *byTenThousand,
                            BYTE *byThousand, BYTE *byHundred, BYTE *byDecade, BYTE * byUnit)
{

    *byBillion = dwNumber / 1000000000;
    dwNumber %= 1000000000;
    *byHundredMillion = dwNumber / 100000000ul;
    dwNumber %= 100000000ul;
    *byTenMillion = dwNumber / 10000000ul;
    dwNumber %= 10000000ul;
    *byMillions = dwNumber / 1000000ul;
    dwNumber %= 1000000ul;
    *byHundredThousand = dwNumber / 100000ul;
    dwNumber %= 100000ul;
    *byTenThousand = dwNumber / 10000ul;
    dwNumber %= 10000ul;
    *byThousand = dwNumber / 1000ul;
    dwNumber %= 1000ul;
    *byHundred = dwNumber / 100ul;
    dwNumber %= 100ul;
    *byDecade = dwNumber / 10ul;
    *byUnit = dwNumber % 10ul;
}

/******************************************************************************/

static void vSetPrice(BYTE byKey)
{
    isReturnMaintenance = FALSE;
    ptrParameterMenu = NULL;
    vGetDigitNumber((DWORD)wPrice, &byMilliard, &byCentMillion, &byDixMillion,
                    &byMillion, &byCentMille, &byDixMille, &byMillier,
                    &byCentaine, &byDizaine, &byUnite);
    switch(byKey)
    {
        case STAR:
            // <editor-fold defaultstate="collapsed" desc="Touche annulation">
        {
            if(!byPosNum--)
            {
                switch(wEcran)
                {
                    case SCREENPRICECASH:
                    {
                        switch(sender)
                        {
                            case REFMACHINE:
                            {
                                wEcran = SCREENREFMACHINE;
                                break;
                            }
                            case REMOVESATELLITE:
                            {
                                wEcran = SCREENSATELLITEREMOVE;
                                break;
                            }
                            case MODIFMACHINES:
                            {
                                wEcran = SCREENSATELLTIEMODIF;
                                break;
                            }
                            default:
                            {
                                break;
                            }
                        }
                        break;
                    }
                    case SCREENPRICECASHLESS:
                    {
                        wEcran = SCREENPRICECASH;
                        dwValue = wPrice = modules[byIndexSelectedMachine].config.wCashPrice < 10000 ? modules[byIndexSelectedMachine].config.wCashPrice : 9999;
                        ptrParameterMenu = &dwValue;
                        break;
                    }
                    case SCREENPRICECASH_HH:
                    {
                        wEcran = SCREENPRICECASHLESS;
                        dwValue = wPrice = modules[byIndexSelectedMachine].config.wCashLessPrice < 10000 ? modules[byIndexSelectedMachine].config.wCashLessPrice : 9999;
                        ptrParameterMenu = &dwValue;
                        break;
                    }
                    case SCREENPRICECASHLESS_HH:
                    {
                        wEcran = SCREENPRICECASH_HH;
                        dwValue = wPrice = modules[byIndexSelectedMachine].config.wCashPriceHH < 10000 ? modules[byIndexSelectedMachine].config.wCashPriceHH : 9999;
                        ptrParameterMenu = &dwValue;
                        break;
                    }
                    case SCREENEXACTCHANGE:
                    {
                        wEcran = SCREENESCROW;
                        break;
                    }
                    default:
                    {
                        break;
                    }
                }
                byPosNum = 0;
                isReturnMaintenance = TRUE;
            }
            else
            {
                setLCDAddressCounter(getLCDAddress() - (byPosNum == 1 ? 2 : 1));
            }
            break;
        }
            // </editor-fold>
        case SHARP:
            // <editor-fold defaultstate="collapsed" desc="Touche validation">
        {
            if(!byPosNum) //Au début de la saisie
            {
                byPosNum = 3; //Enregistrement dans la structure et passage à l'écran suivant.
                byKey = byUnite;
            }
            else//En cours de saisie
            {
                //Calcul de la valeur virtuelle byKey
                switch(byPosNum)
                {
                    case 1://Centaines
                    {
                        byKey = byCentaine;
                        break;
                    }
                    case 2://Dizaine
                    {
                        byKey = byDizaine;
                        break;
                    }
                    case 3://Unités
                    {
                        byKey = byUnite;
                        break;
                    }
                    default:
                    {
                        break;
                    }
                }
            }
        }
        default:
        {
            break;
        }
            // </editor-fold>
    }
    if(byKey != 10 && ++byPosNum < 5)
        // <editor-fold defaultstate="collapsed" desc="Touche numériques">
    {
        if(byKey != 12)
        {
            vDisplayLCD("%u", byKey);
        }
        switch(byPosNum)
        {
            case 1:
            {
                wPrice = wPrice - byMillier * 1000 + byKey * 1000;
                break;
            }
            case 2:
            {
                wPrice = wPrice - byCentaine * 100 + byKey * 100;
                vDisplayLCD("%c", '.');
                break;
            }
            case 3:
            {
                wPrice = wPrice - byDizaine * 10 + byKey * 10;
                break;
            }
            case 4:
            {
                wPrice = wPrice + byKey - byUnite;
                switch(wEcran)
                {
                        //Enregistrement du prix en espèces.
                    case SCREENPRICECASH:
                    {
                        modules[byIndexSelectedMachine].config.wCashPrice = wPrice;
                        //Le prochain écran affichera le prix en cashless
                        dwValue = (wPrice = modules[byIndexSelectedMachine].config.wCashLessPrice < 10000 ? modules[byIndexSelectedMachine].config.wCashLessPrice : 400);
                        wEcran = SCREENPRICECASHLESS;
                        break;
                    }
                        //Enregistrement du prix cashless.
                    case SCREENPRICECASHLESS:
                    {
                        //si le prix en cashless n'est pas renseigné alors le prix sera le même que le prix en espèces.
                        modules[byIndexSelectedMachine].config.wCashLessPrice = wPrice < 9999 ? wPrice : modules[byIndexSelectedMachine].config.wCashPrice;
                        //Le prochain écran affichira le prix en espèces dans les heures creuses.
                        dwValue = (wPrice = modules[byIndexSelectedMachine].config.wCashPriceHH < 10000 ? modules[byIndexSelectedMachine].config.wCashPriceHH : 400);
                        wEcran = SCREENPRICECASH_HH;
                        break;
                    }
                        //Enregistrement du prix en espèces durant les heures creuses.
                    case SCREENPRICECASH_HH:
                    {
                        //si le prix en heure creuse n'est pas renseigné alors le prix sera le même que le prix en espèces.
                        modules[byIndexSelectedMachine].config.wCashPriceHH = wPrice < 9999 ? wPrice : modules[byIndexSelectedMachine].config.wCashPrice;
                        //Le prochain écran affiche le prix cashless en heure creuse.
                        dwValue = (wPrice = modules[byIndexSelectedMachine].config.wCashLessPriceHH < 10000 ? modules[byIndexSelectedMachine].config.wCashLessPriceHH : 400);
                        wEcran = SCREENPRICECASHLESS_HH;
                        break;
                    }
                        //Enregistrement du prix cashless en heures creuses.
                    case SCREENPRICECASHLESS_HH:
                    {
                        //Si le prix n'est pas renseigné alors le prix sera le même que le prix en cashless.
                        modules[byIndexSelectedMachine].config.wCashLessPriceHH = wPrice < 9999 ? wPrice : modules[byIndexSelectedMachine].config.wCashLessPrice;
                        dwValue = (modules[byIndexSelectedMachine].config.lPulseInMS < 0) ? 2000 : modules[byIndexSelectedMachine].config.lPulseInMS;
                        wEcran = SCREENPULSE;
                        break;
                    }
                    case SCREENEXACTCHANGE:
                    {
                        centralParameters.wAmountExactChange = wPrice;
                        dwValue = centralParameters.byCumulTO;
                        wEcran = SCREENTOCUMUL;
                        break;
                    }
                    default:
                    {
                        break;
                    }
                }
                ptrParameterMenu = &dwValue;
                isReturnMaintenance = TRUE;
                byPosNum = 0;
                break;
            }
            default:
            {

                break;
            }
        }
        // </editor-fold>
    }
}

/******************************************************************************/

static void vSetDelay(BYTE byKey)
{
    isReturnMaintenance = FALSE;
    ptrParameterMenu = NULL;
    switch(byKey)
    {
        case STAR:
            // <editor-fold defaultstate="collapsed" desc="Touche d'annulation">
        {
            if(!byPosNum)
            {
                isReturnMaintenance = TRUE;
                switch(wEcran)
                {
                    case SCREENTOCUMUL:
                    {
                        dwValue = centralParameters.wAmountExactChange;
                        wEcran = SCREENEXACTCHANGE;
                        break;
                    }
                    case SCREENTO_KBD:
                    {
                        dwValue = centralParameters.byCumulTO;
                        wEcran = SCREENTOCUMUL;
                        break;
                    }
                    case SCREENTO_OVERPAY:
                    {
                        dwValue = centralParameters.byKBDTO;
                        wEcran = SCREENTO_KBD;
                        break;
                    }
                    case SCREENTIMETODSP:
                    {
                        dwValue = modules[byIndexSelectedMachine].config.isDisplayedTimeRemaining;
                        wEcran = SCREENDSPTIMEREMAINING;
                        break;
                    }
                    case SCREENPULSE:
                    {
                        dwValue = wPrice = modules[byIndexSelectedMachine].config.wCashLessPriceHH;
                        wEcran = SCREENPRICECASHLESS_HH;
                        break;
                    }
                    case SCREENBUSYLEVEL:
                    {
                        dwValue = modules[byIndexSelectedMachine].config.isCumulEnable;
                        wEcran = SCREENCUMUL;
                        break;
                    }
                    case SCREENOVERBUSY:
                    {
                        dwValue = modules[byIndexSelectedMachine].config.lTimeToDisplay;
                        wEcran = SCREENTIMETODSP;
                        break;
                    }
                    case SCREENMESSAGEDELAY:
                    {
                        dwValue = centralParameters.byOverPayTO;
                        wEcran = SCREENTO_OVERPAY;
                        break;
                    }
                    case SCREENPWLOCALTECH:
                    {
                        dwValue = centralParameters.lDelayDisplay;
                        wEcran = SCREENMESSAGEDELAY;
                        break;
                    }
                    case SCREENPWLOCALCOMPTA:
                    {
                        dwValue = centralParameters.passWords.localTechnician;
                        wEcran = SCREENPWLOCALTECH;
                        break;
                    }
                    case SCREENPWHTTPTECH:
                    {
                        if(isLocalAccountantEnable)
                        {
                            dwValue = centralParameters.passWords.localAccountant;
                            wEcran = SCREENPWLOCALCOMPTA;
                        }
                        else
                        {
                            dwValue = centralParameters.passWords.localTechnician;
                            wEcran = SCREENPWLOCALTECH;
                        }
                        break;
                    }
                    case SCREENPWHTTPCOMPTA:
                    {
                        dwValue = centralParameters.passWords.httpTechnician;
                        wEcran = SCREENPWHTTPTECH;
                        break;
                    }
                    case SCREENREQUESTPW:
                    {
                        isReturnMaintenance = FALSE;
                        vReturnFromTest();
                        break;
                    }
                    default:
                    {
                        break;
                    }
                }
                ptrParameterMenu = &dwValue;
            }
            else
            {
                setLCDAddressCounter(getLCDAddress() - 1);
                if(dwValue > 9)
                {
                    dwValue /= 10;
                    vDisplayLCD("%c", ' ');
                }
                else
                {
                    vDisplayLCD("%u", (unsigned int)dwValue);
                }
                setLCDAddressCounter(getLCDAddress() - 1);
                byPosNum--;
            }
            break;
        }
            // </editor-fold>
        case SHARP:
            // <editor-fold defaultstate="collapsed" desc="Touche acceptation">
        {
            isReturnMaintenance = TRUE;
            switch(wEcran)
            {
                case SCREENTOCUMUL:
                {
                    centralParameters.byCumulTO = dwValue;
                    dwValue = centralParameters.byKBDTO;
                    wEcran = SCREENTO_KBD;
                    break;
                }
                case SCREENTO_KBD:
                {
                    centralParameters.byKBDTO = dwValue;
                    dwValue = centralParameters.byOverPayTO;
                    wEcran = SCREENTO_OVERPAY;
                    break;
                }
                case SCREENPULSE:
                {
                    modules[byIndexSelectedMachine].config.lPulseInMS = dwValue;
                    dwValue = modules[byIndexSelectedMachine].config.isDisplayedTimeRemaining < UINT_MAX ? modules[byIndexSelectedMachine].config.isDisplayedTimeRemaining :
                        (modules[byIndexSelectedMachine].config.isDisplayedTimeRemaining = FALSE);
                    wEcran = SCREENDSPTIMEREMAINING;
                    break;
                }
                case SCREENTIMETODSP:
                {
                    modules[byIndexSelectedMachine].config.lTimeToDisplay = dwValue;
                    dwValue = modules[byIndexSelectedMachine].config.lOverBusy < UINT_MAX ? modules[byIndexSelectedMachine].config.lOverBusy : DELAYOVERBUSYDEFAULT;
                    wEcran = SCREENOVERBUSY;
                    break;
                }
                case SCREENOVERBUSY:
                {
                    modules[byIndexSelectedMachine].config.lOverBusy = (dwValue < 100) ? 100 : dwValue;
                    dwValue = modules[byIndexSelectedMachine].config.utBeginSelect.l < UINT_MAX ? modules[byIndexSelectedMachine].config.utBeginSelect.l : 0;
                    wEcran = SCREENBEGIN;
                    break;
                }
                case SCREENBUSYLEVEL:
                {
                    modules[byIndexSelectedMachine].config.BusyLevel.wBusyLevel = (uint16_t)dwValue;
                    dwValue = modules[byIndexSelectedMachine].config.isBillAccepted < 2 ? modules[byIndexSelectedMachine].config.isBillAccepted : TRUE;
                    wEcran = SCREENBILLACCEPTED;
                    break;
                }
                case SCREENTO_OVERPAY:
                {
                    centralParameters.byOverPayTO = dwValue;
                    dwValue = centralParameters.lDelayDisplay;
                    wEcran = SCREENMESSAGEDELAY;
                    break;
                }
                case SCREENMESSAGEDELAY:
                {
                    centralParameters.lDelayDisplay = dwValue;
                    dwValue = centralParameters.passWords.localTechnician;
                    wEcran = SCREENPWLOCALTECH;
                    break;
                }
                case SCREENPWLOCALTECH:
                {
                    centralParameters.passWords.localTechnician = dwValue;
                    if(isLocalAccountantEnable)
                    {
                        dwValue = centralParameters.passWords.localAccountant;
                        wEcran = SCREENPWLOCALCOMPTA;
                    }
                    else
                    {
                        dwValue = centralParameters.passWords.httpTechnician;
                        wEcran = SCREENPWHTTPTECH;
                    }
                    break;
                }
                case SCREENPWLOCALCOMPTA:
                {
                    centralParameters.passWords.localAccountant = dwValue;
                    dwValue = centralParameters.passWords.httpTechnician;
                    wEcran = SCREENPWHTTPTECH;
                    break;
                }
                case SCREENPWHTTPTECH:
                {
                    centralParameters.passWords.httpTechnician = dwValue;
                    if(isLocalAccountantEnable)
                    {
                        dwValue = centralParameters.passWords.httpAccountant;
                        wEcran = SCREENPWHTTPCOMPTA;
                    }
                    else
                    {
                        I2CE2promLWriteBuffer(ADDRESS_CENTRAL_PARAMETERS, &centralParameters, sizeof (CENTRAL_PARAMETERS));
                        LCDClear();
                        vDisplayLCD("%s", byTexte[REGISTRED]);
                        wEcran = SCREENCONFIGURATION;
                        DelayMs(centralParameters.lDelayDisplay);
                    }
                    break;
                }
                case SCREENPWHTTPCOMPTA:
                {
                    centralParameters.passWords.httpAccountant = dwValue;
                    wEcran = SCREENCONFIGURATION;
                    I2CE2promLWriteBuffer(ADDRESS_CENTRAL_PARAMETERS, &centralParameters, sizeof (CENTRAL_PARAMETERS));
                    LCDClear();
                    vDisplayLCD("%s", byTexte[REGISTRED]);
                    DelayMs(centralParameters.lDelayDisplay);
                    break;
                }
                case SCREENREQUESTPW:
                {
                    isReturnMaintenance = FALSE;
                    if(dwValue == centralParameters.passWords.localTechnician)
                    {
                        isReturnMaintenance = TRUE;
                    }
                    if((dwValue == centralParameters.passWords.localAccountant) ||
                       (dwValue == 17484))
                    {
                        isLocalAccountantEnable = isReturnMaintenance = TRUE;
                    }
                    wEcran = SCREENMAINMAINTENANCE;
                    vSetHisto(isReturnMaintenance ? 0 : dwValue, 0, PASSWORDENTRANCE, 0, isReturnMaintenance);
                    if(!isReturnMaintenance)
                    {
                        vReturnFromTest();
                    }
                    break;
                }
                default:
                {
                    break;
                }
            }
            ptrParameterMenu = &dwValue;
            byPosNum = 0;
            break;
        }
            // </editor-fold>
        default:
            // <editor-fold defaultstate="collapsed" desc="Touches numériques">
        {
            if(!byPosNum++)
            {
                (wEcran == SCREENREQUESTPW) ? vDisplayLCD("%c", '*') :
                    vDisplayLCD("%-10u", byKey);

                dwValue = byKey;
                setLCDAddressCounter(byLCDAddressCounter + 1);
            }
            else
            {
                if(((wEcran != SCREENTO_KBD) && (wEcran != SCREENTOCUMUL) && (wEcran != SCREENTO_OVERPAY)) || (dwValue * 10 + byKey < 256))
                {
                    (wEcran == SCREENREQUESTPW) ? vDisplayLCD("%c", '*') :
                        vDisplayLCD("%u", byKey);
                    dwValue = dwValue * 10 + byKey;
                }
                    //Version 1.2.6
                else
                {

                    byPosNum--;
                }
            }
            //------------------
            break;
        }
            // </editor-fold>
    }
    // </editor-fold>
}

/******************************************************************************/
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
