McuMirror/CERES/SW/MainBoard.X/HardwareProfile.h

// HardwareProfile.h

#ifndef _HARDWAREPROFILE_H_
#define _HARDWAREPROFILE_H_

#include <xc.h>
#include <plib.h>
#include "FreeRTOSConfig.h"

#define USE_USB_INTERFACE
#define self_power          1

// External National PHY configuration
#define	PHY_RMII				// external PHY runs in RMII mode
#define	PHY_CONFIG_ALTERNATE	// alternate configuration used
#define	PHY_ADDRESS			0x1	// the address of the National DP83848 PHY

// Clock frequency values
// These directly influence timed events using the Tick module.  They also are used for UART and SPI baud rate generation.
#define GetSystemClock()		configCPU_CLOCK_HZ			// Hz
#define GetInstructionClock()	configPERIPHERAL_CLOCK_HZ	// Normally GetSystemClock()/4 for PIC18, GetSystemClock()/2 for PIC24/dsPIC, and GetSystemClock()/1 for PIC32.  Might need changing if using Doze modes.
#define GetPeripheralClock()	(GetSystemClock()/1)	// Normally GetSystemClock()/4 for PIC18, GetSystemClock()/2 for PIC24/dsPIC, and GetSystemClock()/1 for PIC32.  Divisor may be different if using a PIC32 since it's configurable.


#endif
