McuMirror/CERES/SW/MainBoardHarmonyMX/firmware/src/system_config/default/system_config.h

/*******************************************************************************
  MPLAB Harmony System Configuration Header

  File Name:
    system_config.h

  Summary:
    Build-time configuration header for the system defined by this MPLAB Harmony
    project.

  Description:
    An MPLAB Project may have multiple configurations.  This file defines the
    build-time options for a single configuration.

  Remarks:
    This configuration header must not define any prototypes or data
    definitions (or include any files that do).  It only provides macro
    definitions for build-time configuration options that are not instantiated
    until used by another MPLAB Harmony module or application.
    
    Created with MPLAB Harmony Version 1.06
*******************************************************************************/

// DOM-IGNORE-BEGIN
/*******************************************************************************
Copyright (c) 2013-2015 released Microchip Technology Inc.  All rights reserved.

Microchip licenses to you the right to use, modify, copy and distribute
Software only when embedded on a Microchip microcontroller or digital signal
controller that is integrated into your product or third party product
(pursuant to the sublicense terms in the accompanying license agreement).

You should refer to the license agreement accompanying this Software for
additional information regarding your rights and obligations.

SOFTWARE AND DOCUMENTATION ARE PROVIDED AS IS WITHOUT WARRANTY OF ANY KIND,
EITHER EXPRESS OR IMPLIED, INCLUDING WITHOUT LIMITATION, ANY WARRANTY OF
MERCHANTABILITY, TITLE, NON-INFRINGEMENT AND FITNESS FOR A PARTICULAR PURPOSE.
IN NO EVENT SHALL MICROCHIP OR ITS LICENSORS BE LIABLE OR OBLIGATED UNDER
CONTRACT, NEGLIGENCE, STRICT LIABILITY, CONTRIBUTION, BREACH OF WARRANTY, OR
OTHER LEGAL EQUITABLE THEORY ANY DIRECT OR INDIRECT DAMAGES OR EXPENSES
INCLUDING BUT NOT LIMITED TO ANY INCIDENTAL, SPECIAL, INDIRECT, PUNITIVE OR
CONSEQUENTIAL DAMAGES, LOST PROFITS OR LOST DATA, COST OF PROCUREMENT OF
SUBSTITUTE GOODS, TECHNOLOGY, SERVICES, OR ANY CLAIMS BY THIRD PARTIES
(INCLUDING BUT NOT LIMITED TO ANY DEFENSE THEREOF), OR OTHER SIMILAR COSTS.
*******************************************************************************/
// DOM-IGNORE-END

#ifndef _SYSTEM_CONFIG_H
#define _SYSTEM_CONFIG_H

/* This is a temporary workaround for an issue with the peripheral library "Exists"
   functions that causes superfluous warnings.  It "nulls" out the definition of
   The PLIB function attribute that causes the warning.  Once that issue has been
   resolved, this definition should be removed. */
#define _PLIB_UNSUPPORTED


// *****************************************************************************
// *****************************************************************************
// Section: Included Files
// *****************************************************************************
// *****************************************************************************
/*  This section Includes other configuration headers necessary to completely
    define this configuration.
*/


// *****************************************************************************
// *****************************************************************************
// Section: System Service Configuration
// *****************************************************************************
// *****************************************************************************

// *****************************************************************************
/* Common System Service Configuration Options
*/
#define SYS_VERSION_STR           "1.06"
#define SYS_VERSION               10600

// *****************************************************************************
/* Clock System Service Configuration Options
*/
#define SYS_CLK_FREQ                        80000000ul
#define SYS_CLK_BUS_PERIPHERAL_1            80000000ul
#define SYS_CLK_UPLL_BEFORE_DIV2_FREQ       48000000ul
#define SYS_CLK_CONFIG_PRIMARY_XTAL         8000000ul
#define SYS_CLK_CONFIG_SECONDARY_XTAL       32768ul
#define SYS_CLK_CONFIG_FREQ_ERROR_LIMIT     10
#define SYS_CLK_WAIT_FOR_SWITCH             true
#define SYS_CLK_ON_WAIT                     OSC_ON_WAIT_IDLE
   
/*** Interrupt System Service Configuration ***/
#define SYS_INT                     true

/*** Ports System Service Configuration ***/
#define SYS_PORT_AD1PCFG        ~0x7df
#define SYS_PORT_CNPUE          0x0
#define SYS_PORT_CNEN           0x0
/*** Timer System Service Configuration ***/
#define SYS_TMR_POWER_STATE             SYS_MODULE_POWER_RUN_FULL
#define SYS_TMR_DRIVER_INDEX            DRV_TMR_INDEX_0
#define SYS_TMR_MAX_CLIENT_OBJECTS      5
#define SYS_TMR_FREQUENCY               1000
#define SYS_TMR_FREQUENCY_TOLERANCE     10
#define SYS_TMR_UNIT_RESOLUTION         10000
#define SYS_TMR_CLIENT_TOLERANCE        10
#define SYS_TMR_INTERRUPT_NOTIFICATION  false

/*** Message System Service Configuration ***/

#define SYS_MSG_MAX_MAILBOXES        2
#define SYS_MSG_MAX_TYPES            2


/*** File System Service Configuration ***/

#define SYS_FS_MEDIA_NUMBER         	1

#define SYS_FS_VOLUME_NUMBER		1

#define SYS_FS_AUTOMOUNT_ENABLE		false
#define SYS_FS_MAX_FILES	    	1
#define SYS_FS_MAX_FILE_SYSTEM_TYPE 	1
#define SYS_FS_MEDIA_MAX_BLOCK_SIZE  	512
#define SYS_FS_MEDIA_MANAGER_BUFFER_SIZE 512


#define SYS_FS_MEDIA_TYPE_IDX0 				
#define SYS_FS_TYPE_IDX0 					








// *****************************************************************************
/* Random System Service Configuration Options
*/

#define SYS_RANDOM_CRYPTO_SEED_SIZE  32


// *****************************************************************************
// *****************************************************************************
// Section: Driver Configuration
// *****************************************************************************
// *****************************************************************************




// *****************************************************************************
// *****************************************************************************
// Section: Middleware & Other Library Configuration
// *****************************************************************************
// *****************************************************************************


#define HAVE_MCAPI
#define NO_MD5
#define NO_SHA
#define NO_SHA256
#define NO_AES
#define NO_RSA
#define NO_HMAC

/*** USB Driver Configuration ***/


/* Disable Device Support */
#define DRV_USBFS_DEVICE_SUPPORT      false

/* Enables Device Support */
#define DRV_USBFS_HOST_SUPPORT      true

#define DRV_USBFS_PERIPHERAL_ID       USB_ID_1
#define DRV_USBFS_INTERRUPT_SOURCE    INT_SOURCE_USB_1
#define DRV_USBFS_INDEX               0


/* Interrupt mode enabled */
#define DRV_USBFS_INTERRUPT_MODE      true


/* Number of Endpoints used */
#define DRV_USBFS_ENDPOINTS_NUMBER    1






#define DRV_USBFS_HOST_NAK_LIMIT      2000
/* Provides Host pipes number */
#define DRV_USBFS_HOST_PIPES_NUMBER    10
#define DRV_USBFS_HOST_ATTACH_DEBOUNCE_DURATION 500
#define DRV_USBFS_HOST_RESET_DURATION 100
// *****************************************************************************
// *****************************************************************************
// Section: USB Device Layer Configuration
// *****************************************************************************
// *****************************************************************************
/* Provides Host pipes number */
#define USB_HOST_PIPES_NUMBER    10
/* NAK Limit for Control transfer data stage and Status Stage */
#define DRV_USB_HOST_NAK_LIMIT		200

// *****************************************************************************
// *****************************************************************************
// Section: USB Host Layer Configuration
// *****************************************************************************
// **************************************************************************
 
/* Total number of devices to be supported */
#define USB_HOST_DEVICES_NUMBER         1

/* Target peripheral list entries */
#define  USB_HOST_TPL_ENTRIES           1 

/* Maximum number of configurations supported per device */
#define USB_HOST_DEVICE_INTERFACES_NUMBER     5    

#define USB_HOST_CONTROLLERS_NUMBER           1

#define USB_HOST_TRANSFERS_NUMBER             10

/* Number of Host Layer Clients */
#define USB_HOST_CLIENTS_NUMBER               1   







// *****************************************************************************
// *****************************************************************************
// Section: TCPIP Stack Configuration
// *****************************************************************************
// *****************************************************************************
#define TCPIP_STACK_USE_IPV4
#define TCPIP_STACK_USE_TCP
#define TCPIP_STACK_USE_UDP
#define TCPIP_STACK_USE_ICMP_CLIENT
#define TCPIP_STACK_DRAM_SIZE		        		39250
#define TCPIP_STACK_DRAM_RUN_LIMIT		    		2048
#define TCPIP_STACK_TICK_RATE		        		5

#define TCPIP_STACK_MALLOC_FUNC		    	malloc

#define TCPIP_STACK_CALLOC_FUNC		    	calloc

#define TCPIP_STACK_FREE_FUNC		    	free

/* TCP/IP stack event notification */
#define TCPIP_STACK_USE_EVENT_NOTIFICATION

/*** ARP Configuration ***/
#define TCPIP_ARP_CACHE_ENTRIES                 		5
#define TCPIP_ARP_CACHE_DELETE_OLD		        	true
#define TCPIP_ARP_CACHE_SOLVED_ENTRY_TMO			1200
#define TCPIP_ARP_CACHE_PENDING_ENTRY_TMO			60
#define TCPIP_ARP_CACHE_PENDING_RETRY_TMO			2
#define TCPIP_ARP_CACHE_PERMANENT_QUOTA		    		50
#define TCPIP_ARP_CACHE_PURGE_THRESHOLD		    		75
#define TCPIP_ARP_CACHE_PURGE_QUANTA		    		1
#define TCPIP_ARP_CACHE_ENTRY_RETRIES		    		3
#define TCPIP_ARP_GRATUITOUS_PROBE_COUNT			1
#define TCPIP_ARP_TASK_PROCESS_RATE		        	2

/*** DHCP Configuration ***/
#define TCPIP_STACK_USE_DHCP_CLIENT
#define TCPIP_DHCP_TIMEOUT		        		10
#define TCPIP_DHCP_TASK_TICK_RATE	    			5
#define TCPIP_DHCP_HOST_NAME_SIZE	    			20
#define TCPIP_DHCP_CLIENT_CONNECT_PORT  			68
#define TCPIP_DHCP_SERVER_LISTEN_PORT				67
#define TCPIP_DHCP_CLIENT_ENABLED             			true










/*** NBNS Configuration ***/
#define TCPIP_STACK_USE_NBNS
#define TCPIP_NBNS_TASK_TICK_RATE   110






/*** TCP Configuration ***/
#define TCPIP_TCP_MAX_SEG_SIZE_TX		        	1460
#define TCPIP_TCP_MAX_SEG_SIZE_RX_LOCAL		    		1460
#define TCPIP_TCP_MAX_SEG_SIZE_RX_NON_LOCAL			536
#define TCPIP_TCP_SOCKET_DEFAULT_TX_SIZE			512
#define TCPIP_TCP_SOCKET_DEFAULT_RX_SIZE			512
#define TCPIP_TCP_START_TIMEOUT_VAL		        	1000
#define TCPIP_TCP_DELAYED_ACK_TIMEOUT		    		100
#define TCPIP_TCP_FIN_WAIT_2_TIMEOUT		    		5000
#define TCPIP_TCP_KEEP_ALIVE_TIMEOUT		    		10000
#define TCPIP_TCP_CLOSE_WAIT_TIMEOUT		    		200
#define TCPIP_TCP_MAX_RETRIES		            		5
#define TCPIP_TCP_MAX_UNACKED_KEEP_ALIVES			6
#define TCPIP_TCP_MAX_SYN_RETRIES		        	3
#define TCPIP_TCP_AUTO_TRANSMIT_TIMEOUT_VAL			40
#define TCPIP_TCP_WINDOW_UPDATE_TIMEOUT_VAL			200
#define TCPIP_TCP_MAX_SOCKETS		            		10
#define TCPIP_TCP_TASK_TICK_RATE		        	5

/*** announce Configuration ***/
#define TCPIP_STACK_USE_ANNOUNCE
#define TCPIP_ANNOUNCE_MAX_PAYLOAD 	512
#define TCPIP_ANNOUNCE_TASK_RATE    333

/*** TCPIP MAC Configuration ***/
#define TCPIP_EMAC_TX_DESCRIPTORS				8
#define TCPIP_EMAC_RX_DESCRIPTORS				10
#define TCPIP_EMAC_RX_DEDICATED_BUFFERS				4
#define TCPIP_EMAC_RX_INIT_BUFFERS				    0
#define TCPIP_EMAC_RX_LOW_THRESHOLD				    1
#define TCPIP_EMAC_RX_LOW_FILL				        2
#define TCPIP_EMAC_RX_BUFF_SIZE		    			1536
#define TCPIP_EMAC_RX_MAX_FRAME		    			1536
#define TCPIP_EMAC_RX_FRAGMENTS		    			1
#define TCPIP_EMAC_ETH_OPEN_FLAGS       			\
                                                    TCPIP_ETH_OPEN_AUTO |\
                                                    TCPIP_ETH_OPEN_FDUPLEX |\
                                                    TCPIP_ETH_OPEN_HDUPLEX |\
                                                    TCPIP_ETH_OPEN_100 |\
                                                    TCPIP_ETH_OPEN_10 |\
                                                    TCPIP_ETH_OPEN_MDIX_AUTO |\
                                                    0
#define TCPIP_EMAC_PHY_CONFIG_FLAGS     			\
                                                    DRV_ETHPHY_CFG_AUTO | \
                                                    0                                                    
#define TCPIP_EMAC_PHY_LINK_INIT_DELAY  			500
#define TCPIP_EMAC_PHY_ADDRESS		    			1
#define TCPIP_EMAC_INTERRUPT_MODE        			true
#define DRV_ETHPHY_INSTANCES_NUMBER				1
#define DRV_ETHPHY_CLIENTS_NUMBER				1
#define DRV_ETHPHY_INDEX		        		1
#define DRV_ETHPHY_PERIPHERAL_ID				1
#define DRV_ETHPHY_NEG_INIT_TMO		    			1
#define DRV_ETHPHY_NEG_DONE_TMO		    			2000
#define DRV_ETHPHY_RESET_CLR_TMO				500
#define DRV_ETHMAC_INSTANCES_NUMBER				1
#define DRV_ETHMAC_CLIENTS_NUMBER				1
#define DRV_ETHMAC_INDEX	    	    			1
#define DRV_ETHMAC_PERIPHERAL_ID				1
#define DRV_ETHMAC_INTERRUPT_VECTOR				INT_VECTOR_ETHERNET
#define DRV_ETHMAC_INTERRUPT_SOURCE				INT_SOURCE_ETH_1
#define DRV_ETHMAC_POWER_STATE		    			SYS_MODULE_POWER_RUN_FULL

#define DRV_ETHMAC_INTERRUPT_MODE        			true



/*** UDP Configuration ***/
#define TCPIP_UDP_MAX_SOCKETS		                	10
#define TCPIP_UDP_SOCKET_DEFAULT_TX_SIZE		    	512
#define TCPIP_UDP_SOCKET_DEFAULT_TX_QUEUE_LIMIT    	 	3
#define TCPIP_UDP_SOCKET_DEFAULT_RX_QUEUE_LIMIT			3
#define TCPIP_UDP_SOCKET_POOL_BUFFERS		        	4
#define TCPIP_UDP_SOCKET_POOL_BUFFER_SIZE		    	512

#define TCPIP_UDP_USE_TX_CHECKSUM             			true

#define TCPIP_UDP_USE_RX_CHECKSUM             			true

#define TCPIP_STACK_USE_ZEROCONF_LINK_LOCAL
#define TCPIP_ZC_LL_PROBE_WAIT 1
#define TCPIP_ZC_LL_PROBE_MIN 1
#define TCPIP_ZC_LL_PROBE_MAX 2
#define TCPIP_ZC_LL_PROBE_NUM 3
#define TCPIP_ZC_LL_ANNOUNCE_WAIT 2
#define TCPIP_ZC_LL_ANNOUNCE_NUM 2
#define TCPIP_ZC_LL_ANNOUNCE_INTERVAL 2
#define TCPIP_ZC_LL_MAX_CONFLICTS 10
#define TCPIP_ZC_LL_RATE_LIMIT_INTERVAL 60
#define TCPIP_ZC_LL_DEFEND_INTERVAL 10
#define TCPIP_ZC_LL_IPV4_LLBASE 0xa9fe0100
#define TCPIP_ZC_LL_IPV4_LLBASE_MASK 0x0000FFFF
#define TCPIP_ZC_LL_TASK_TICK_RATE 333

/*** Network Configuration Index 0 ***/
#define TCPIP_NETWORK_DEFAULT_INTERFACE_NAME 			"PIC32INT"
#define TCPIP_IF_PIC32INT
#define TCPIP_NETWORK_DEFAULT_HOST_NAME 			"MCHPBOARD_E"
#define TCPIP_NETWORK_DEFAULT_MAC_ADDR	 			0
#define TCPIP_NETWORK_DEFAULT_IP_ADDRESS 			"192.168.100.115"
#define TCPIP_NETWORK_DEFAULT_IP_MASK 				"255.255.255.0"
#define TCPIP_NETWORK_DEFAULT_GATEWAY	 			"192.168.100.1"
#define TCPIP_NETWORK_DEFAULT_DNS 				"192.168.100.1"
#define TCPIP_NETWORK_DEFAULT_SECOND_DNS 			"0.0.0.0"
#define TCPIP_NETWORK_DEFAULT_POWER_MODE 			"full"
#define TCPIP_NETWORK_DEFAULT_INTERFACE_FLAGS   		TCPIP_NETWORK_CONFIG_DHCP_CLIENT_ON
#define TCPIP_NETWORK_DEFAULT_MAC_DRIVER 		    DRV_ETHMAC_PIC32MACObject
#define TCPIP_NETWORK_DEFAULT_IPV6_ADDRESS 			0
#define TCPIP_NETWORK_DEFAULT_IPV6_PREFIX_LENGTH 		0
#define TCPIP_NETWORK_DEFAULT_IPV6_GATEWAY 		        0



/*** OSAL Configuration ***/
#define OSAL_USE_RTOS          1






#endif // _SYSTEM_CONFIG_H
/*******************************************************************************
 End of File
*/
