McuMirror/CERES/SW/MainBoard.X/textes.h

/* 
 * File:   textes.h
 * Author: RA
 *
 * Created on 21 janvier 2014, 10:50
 */

#ifndef TEXTES_H
#define	TEXTES_H
//#define UPPERCASE

#ifdef UPPERCASE
char *byTexte[] = {
                   "SELECTION MACHINE:", //SELECTION_MACHINE, 0
                   "PIECE:", //COIN, 1
                   "BILLET:", //BILL, 2
                   "(#)CONTINUER", //CONTINUE, 3
                   "(*)SORTIR", //EXIT, 4
                   "(1)CONFIGURATION", //CONFIGURATION, 5
                   "(2)AUDIT", //AUDIT, 6
                   "(3)HISTORIQUE", //HISTORIQUE, 7
                   "(1)RENDEUR", //CHANGEGIVER, 8
                   "(2)LECTEUR BILLETS", //BILLVALIDATOR, 9
                   "(3)CASHLESS", //CASHLESS, 10
                   "(0)NON", //DISABLE, 11
                   "(1)OUI", //ENABLE, 12
                   "SUIVANT", //NEXT, 13
                   "PRIX:", //PRICE, 14
                   "(*)CORRECTION", //CORRECT, 15
                   "(*)POUR ANNULER", //CANCEL, 16
                   "DISPO CLEF:", //INKEY, 17
                   "DISPO.:", //DISPO, 18
                   "RENDU:", //RETURNED, 19
                   "FAITES L'APPOINT", //EXACTCHANGE, 20
                   "CLE ID:", //MEDIA_ID, 21
                   "MAXIMUM ATTEINT!", //MAXI, 22
                   "ADRESSE: 0X", //ADDRESSMDB, 23
                   "ECHEC DE VENTE.", //SALEFAILURE, 24
                   "MONTANT:", //AMOUNT, 25
                   "MACHINE", //NUMMACHINE, 26
                   "INTRODUIT:", //INTRODUCED, 27
                   "(4)DATE HEURE", //DATETIME, 28
                   "HEURE", //HEURE, 29
                   "DATE", //DATE, 30
                   "(3)MACHINES", //SATELLITE, 31
                   "(1)RETRAIT AUTO", //RETRAITAUTO, 32
                   "(2)NOUVELLE MACH.", //NEWMACHINEMANUAL, 33
                   "(3)MODIFICATION", //MODIFICATIONMACHINE, 34
                   "(4)SUPPRESION", //REMOVEMACHINE, 35
                   "RECHERCHE...", //SEARCH, 36
                   "NUMERO MACHINE:", //NUMERO,37
                   "MACHINE REFERENTE:", //REFERENCE, 38
                   "(#)PASSER", //PASS, 39
                   "MACHINE EXISTANTE!", //MACHINEEXIST, 40
                   "TROP DE MACHINES!", //TOOMANYMACHINE, 41
                   "INDISPONIBLE", //MACHINEMISSING, 42
                   "PRIX BASE EN ESPECES:", //PRICECASH, 43
                   "PRIX AVEC CLEF:", //PRICECASHLESS, 44
                   "PRIX EN HEURES CREUSES:", //PRICECASH_HH, 45
                   "PRIX CLEF HEURES CREUSES:", //PRICECASHLESS_HH, 46
                   "MACHINE %U EN ROUTE...", //INPROGRESS, 47
                   "IMPULSION COMMANDE EN MS:", //PULSEDELAY, 48
                   "AFFICHE TEMPS RESTANT:", //DSPTIMEREMAINING, 49
                   "DELAI SUROCCUPATION EN MS:", //OVERBUSY, 50
                   "HEURE MISE EN ROUTE:", //TIMESTART, 51
                   "HEURE FIN:", //TIMEEND, 52
                   "HEURE DEBUT HEURES CREUSES:", //HHSTART, 53
                   "HEURE FIN HEURES CREUSES:", //HHEND, 54
                   "CUMUL AUTORISE:", //CUMUL,55
                   "SATELLITE %U EFFACE!", //MACHINEREMOVED,56
                   "PARAMETRES MACHINE %U ENREGISTRES!", //MACHINEREGISTERED, 57
                   "ENREGISTRER", //SAVE, 58
                   "PRECEDENT", //BACK, 59
                   "(1)PARAMETRES", //PARAMETERS,60
                   "PAS DE NOUVEAU MODULE", //NOMODULE, 61
                   "TERMINE", //COMPLETED, 62
                   "HORS PLAGE HORAIRE", //OVERTIME, 63
                   "TEMPS RESTANT:", //REMAININGTIME, 64
                   "OCCUPEE", //OCCUPIED, 65
                   "ETES-VOUS SUR?", //CONFIRM, 66
                   "(*)NON", //NO, 67
                   "(#)OUI", //YES, 68
                   "PARAMETRES MACHINE %U EFFACES!", //REMOVED, 69
                   "ENREGISTRE!", //REGISTRED, 70
                   "SATELLITE", //SATELLITE2, 71
                   "RENDU EN COURS...", //RETURN, 72
                   "(2) PERIPHERIQUES", //DEVICES, 73
                   "BUZZER:", //SOUND, 74
                   "ESCROW BILLETS:", //ESCROWBILL, 75
                   "MONTANT EXACT CHANGE:", //EXACTCHANGEAMOUNT, 76
                   "DELAI CLAVIER", //KBDTO, 77
                   "DELAI CUMUL", //CUMULTO, 78
                   "DELAI TROP PERCU", //OVERPAYTO, 79
                   "EN SECONDES:", //INSECONDES, 80
                   "DELAI MESSAGES EN MS:", //MESSAGETO, 81
                   "(0)TEMPORAIRE", //TEMPORARYTEXT, 82
                   "(1)PERMANENT", //PERMANENTTEXT, 83
                   "VENTES EN ESPECES", //CASHTEXT, 84
                   "VENTE CASHLESS", //CASHLESSTEXT, 85
                   "RECHARGE CASHLESS", //REVALUECASHLESSTEXT,86
                   "TROP PERCU", //OVERPAYTEXTE,87
                   "NBR. UTILISATIONS MACHINE", //SERVICE,88
                   "PIECES %.*F\7 INTRODUITES: %U", //COININ, 89
                   "PIECES %.*F\7 RENDUES: %U", //COINOUT, 90
                   "BILLETS %.*F\7 INTRODUITS: %U", //BILLIN, 91
                   "RAZ AUDITS? ", //RAZAUDIT,,92
                   "RAZ EFFECTUE!", //RAZOK, 93
                   "ECHEC RAZ AUDITS", //RAZNOK, 94
                   "VERIFICATION", //CHECK, 95
                   "INCONNUE", //UNKNOW_OP,96
                   "MISE EN ROUTE", //INITIALISATION_OP,97
                   "MAINTENANCE", //TEST_START_OP,98
                   "START", //SELECTION_OP,99
                   "IN:", //INCG_OP,100
                   "RET.:", //OUCG_OP,101
                   "IN:", //INBV_OP,102
                   "OUT:", //OUTBV_OP,103
                   "P. CLEF", //PAYCASHLESS_OP,104
                   "R. CLEF", //REVALUECASHLESSL_OP,105
                   "CLEF", //KEYPRESENT_OP,106
                   "ANN. OVERPAY", //CANCELOVERPAY, 107
                   "REMPLISSAGE", //FILLING, 108
                   "USB INS.", //USBPRESENT, 109
                   "P. USB", //PAYUSB_OP,110
                   "SAVE AUDIT", //SAVEAUDIT_OP,111
                   "INIT USB", //INITCODE_OP,112
                   "RAZ AUDITS", //RAZAUDIT_OP, 113
                   "SAVE HISTO", //SAVEHISTO_OP, 114
                   "MACHINE SELECT. ", //SELECTED, 115
                   "REJETEE", //REJECTED, 116
                   "SORTIE TEST", //TEST_EXIT,117
                   "RETRAIT USB", //TAKE_USB, 118
                   "FIN PAIEMENT", //ENDPULSE, 119
                   "SAISIE PASSWORD", //PASSWORDENTER, 120
                   "TOTAL:", //TOTAL, 121
                   "INSEREZ PIECE OU ", //INSERTCOIN, 122
                   "TEMPS A AFFICHER", //TIMEINFOTO, 123
                   "POUR", //FOR, 124
                   "SUP.", //ADDITIONAL, 125
                   "RESTE:", //CASHREMAINING, 126
                   "ECHEC ENREGISTREMENT MACHINE:", //FAILEDRECORD, 127
                   "REPRENEZ LE BILLET", //TAKEBILL, 128
                   "CLEF USB INVALIDE", //ERRORUSBKEY, 129
                   "DISPO USB:", //CREDITINUSB, 130
                   "VENTE USB", //VENDUSBTEXT, 131
                   "CODES USB REINITIALISES.", //USB_INITIALIZED, 132
                   "AUDIT_", //SAVEAUDITFILENAME, 133
                   "HISTO_", //SAVEHISTOFILENAME, 134
                   "AUDIT", //HEADERAUDIT, 135
                   "NOMBRE", //HEADERNUMBER, 136
                   "VALEUR", //HEADERVALUE, 137
                   "MONTANT", //HEADERAMOUNT, 138
                   "CANAL", //AUDITCHANNEL, 139
                   "AUDIT ENREGISTRE!", //AUDITSAVED, 140
                   "HISTORIQUE ENREGISTRE!", //HISTOSAVED, 141
                   "REUSSI", //SUCCESSFUL_OP, 142
                   "ECHEC", //FAIL_OP, 143
                   "OPERATION", //OP, 144
                   "RESULTAT", //RESULTOP, 145
                   "TEMPS A AFFICHER EN SECONDES:", //TIMETODISPLAY, 146
                   "RETIREZ CLEF.", //KTOBERETIRED, 147
                   "POUR AJOUT.", //TOADD, 148
                   "CENTRALE", //CENTRALE, 149
                   "M.D.I. - VERSION", //MDIVERSION, 150
                   "INEXISTANTE", //NONEXISTENT, 151
                   "VIDE", //TEXTEMPTY, 152
                   "SECTEUR PRESENT : ", //MAINPOWER, 153
                   "SENSIBILITE CONSOMMATION : ", //BUSYSENSIBILITY, 154
                   "PASSWORD LOCAL TECHNICIEN : ", //PWLOCALTECH, 155
                   "PASSWORD LOCAL SUPERVISOR : ", //PWLOCALCOMPTA, 156
                   "PASSWORD HTTP TECHNICIEN : ", //PWHTTPTECH, 157
                   "PASSWORD HTTP SUPERVISOR : ", //PWHTPPCOMPTA, 158
                   "CODE D'ACCES : ", //REQUESTPW, 159
                   "BILLETS ACCEPTES : ", //BILLACCEPTED, 160
                   "MACHINE %U NON ACTIVEE!", //UNACTIVED, 161
                   "INFO SUP.", //INFOSUP
                   "SECTEUR INDISPO.", MAINMISSING
};
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
