McuMirror/CERES/SW/MainBoard_v_1_3_4.X/mdb_cl.h

/** ****************************************************************************
 * \file            mdb_cl.h                                                 
 * \brief			Header de la gestion du cashless
 * \date            2013.11.30                                                 
 * \author          Rachid AKKOUCHE                                            
 *******************************************************************************/
#ifndef MDB_CL_H
#define	MDB_CL_H

#include "MDB.h"

/**
 * \defgroup CL Gestion du cashless
 * \ingroup MDB
 * @{
 */

/*Macros***********************************************************************/

//Adresses périphériques
#define CASHLESS1 0X10 /*!< Adresse cashless 1. */
#define CASHLESS2 0X60 /*!< Adresse cashless 2. */

/**
 * \ingroup MDB_ANSWER
 * @{
 */
/**
 * \brief JUST RESET
 * \details Indique que le lecteur de moyens de paiement a été réinitialisé.
 */
#define RSP_JUST_RESET              0x00    

/**
 * \brief CONFIGURATION DATA.
 * \details Indique que le cashless répond à une demande de données de configuration de la VMC
 */
#define RSP_READER_CONFIG_DATA      0x01

/**
 * \brief DISPLAY REQUEST
 * \details Le lecteur de moyens de paiement demande un message à afficher sur l'écran de la VMC.
 */
#define RSP_DISPLAY_REQUEST         0x02

/**
 * \brief BEGIN SESSION
 * \details Permettre à un client de faire une sélection, mais ne distribue le produit avant que le paiement soit approuvé.
 */
#define RSP_BEGIN_SESSION           0x03

/**
 * \brief SESSION CANCEL REQUEST
 * \details La VMC demande au cashless d'annuler la session. Le VMC devrait amorcer une SESSION COMPLETE. Cette réponse est envoyée à la VMC chaque fois que le media de paiement est retiré ou qu'une demande s'annulation est effectuée par l'utilisateur (par exemple, si le bouton de retour rdy utilisé).
est appuyé).
 */
#define RSP_SESSION_CANCEL_REQUEST  0x04

/**
 * \brief VEND REQUEST
 * \details Le client a fait une sélection. La VMC demande l'approbation de la vente avant de distribuer le produit.
 */
#define RSP_VEND_APPROVED           0x05

/**
 * \brief VEND DENIED
 * \details La vente est refusée pour la sélection du client. Le produit n'est pas distibrué.
 */
#define RSP_VEND_DENIED             0x06

/**
 * \brief END SESSION
 * \details Cette commande est émise en réponse à une demande de SESSION COMPLETE. La réponse END SESSION  indique que le lecteur est retourné à l'état activé. Si la "END SESSION" n'est pas reçue par la VMC dans le délai maximal de non-réponse, le VMC doit émettre une commande "RESET".
du lecteur.
 */
#define RSP_END_SESSION             0x07

/**
 * \brief READER CANCEL
 * \details Cette commande est émise pour interrompre les activités de lecture du cashless qui se produisent dans l'état activé. C'est la première partie d'une séquence commande/réponse qui nécessite une réponse CANCELLED de la part du lecteur
 */
#define RSP_CANCELLED               0x08

/**
 * \brief PERIPHERAL ID
 * \details Le lecteur envoie les informations d'identification périphérique.
 */
#define RSP_PERIPHERAL_ID           0x09

/**
 * \brief MALFUNCTION/ERROR
 * \details Le lecteur cashless signale un dysfonctionnement ou une erreur.
 */
#define RSP_MALFUNCTION_ERROR       0x0A
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
